joyhpc/misc-tasks/a5ed052a_min_system_pin_assign/sources/official_pinouts/a5ed052a/a5ed052A.xlsx

Sheet: IO Resource Count
Pin Information for Agilex™ 5 A5ED052A Device
TYPE | BANK | B23A Package | B32A Package
Transceiver I/O | 1A | - | 20
Transceiver I/O | 1B | 20 | 20
Transceiver I/O | 1C | 22 | 22
HSIO | 2A_B | - | 48
HSIO | 2A_T | - | 48
HSIO | 2B_B | - | 48
HSIO | 2B_T | - | 48
HPS shared HSIO | 3A_B | 48 | 48
HPS and SDM shared HSIO | 3A_T | 48 | 48
HPS shared HSIO | 3B_B | - | 48
HPS shared HSIO | 3B_T | - | 48
Transceiver I/O | 4A | - | 20
Transceiver I/O | 4B | - | 22
Transceiver I/O | 4C | 22 | 20
HVIO | 5A | 20 | 20
HVIO | 5B | 20 | 20
HVIO | 6A | 20 | 20
HVIO | 6B | 20 | 20
HVIO | 6C | 20 | 20
HVIO | 6D | 20 | 20
HPS I/O | HPS | 48 | 48
SDM I/O | SDM | 33 | 33
i. Total LVDS channels per bank supporting LVDS SERDES Non-DPA and DPA mode is equivalent to (LVDS I/O per bank)/2, inclusive of clock pair. Please refer to Dedicated Tx/Rx Channel column in the pin-out table for the channel availability.
ii. Total LVDS channels supporting LVDS SERDES Soft-CDR mode is 12 pairs per bank. Please refer to Soft CDR column in the pin out table for the channel availability.

Sheet: Pin List B23A
Pin Information for Agilex™ 5 A5ED052A Device Version: 2025-06-06 B23A Status: Final
Bank Number | Index within I/O Bank | Pin Name/Function | Optional Function(s) | Configuration Function | HPS Function | Dedicated Tx/Rx Channel SERDES | Soft CDR Support | B23A | DQS for X4 | DQS for X8/X9 | DQS for X16/X18
SDM |  | TDO |  |  |  |  |  | BN55
SDM |  | TMS |  |  |  |  |  | BJ56
SDM |  | TCK |  |  |  |  |  | BJ58
SDM |  | TDI |  |  |  |  |  | BJ53
SDM |  | OSC_CLK_1 |  |  |  |  |  | BJ48
SDM |  | SDM_IO1 | AVSTx8_DATA2,AS_DATA1 |  |  |  |  | BV29
SDM |  | SDM_IO5 | AS_nCSO0,MSEL0 |  |  |  |  | BJ30
SDM |  | SDM_IO3 | AVSTx8_DATA3,AS_DATA2 |  |  |  |  | BR36
SDM |  | nCONFIG |  |  |  |  |  | BU32
SDM |  | SDM_IO4 | AVSTx8_DATA1,AS_DATA0 |  |  |  |  | BN43
SDM |  | SDM_IO2 | AVSTx8_DATA0,AS_CLK |  |  |  |  | BV26
SDM |  | SDM_IO7 | AS_nCSO2,MSEL1 |  |  |  |  | BN31
SDM |  | SDM_IO11 | AVSTx8_VALID,PWRMGT_SDA |  |  |  |  | BN36
SDM |  | nSTATUS |  |  |  |  |  | BV32
SDM |  | SDM_IO16 | PWRMGT_SDA |  |  |  |  | BN46
SDM |  | SDM_IO0 | PWRMGT_SCL,PWRMGT_ALERT |  |  |  |  | BU34
SDM |  | SDM_IO13 | AVSTx8_DATA5 |  |  |  |  | BJ45
SDM |  | SDM_IO9 | AS_nCSO1,MSEL2,PWRMGT_ALERT |  |  |  |  | BU29
SDM |  | SDM_IO6 | AVSTx8_DATA4,AS_DATA3 |  |  |  |  | BN38
SDM |  | SDM_IO10 | AVSTx8_DATA7 |  |  |  |  | BN28
SDM |  | SDM_IO8 | AVSTx8_READY,AS_nCSO3 |  |  |  |  | BJ39
SDM |  | SDM_IO12 | PWRMGT_SDA,PWRMGT_ALERT |  |  |  |  | BJ33
SDM |  | SDM_IO15 | AVSTx8_DATA6,AS_nRST |  |  |  |  | BJ41
SDM |  | SDM_IO14 | AVSTx8_CLK,PWRMGT_SCL |  |  |  |  | BR28
SDM |  | RREF_SDM |  |  |  |  |  | BV51
SDM |  |  | TEMPDIODE0An |  |  |  |  | BR52
SDM |  |  | TEMPDIODE0Ap |  |  |  |  | BN52
SDM |  |  | VREFP_ADC |  |  |  |  | BU42
SDM |  |  | VREFN_ADC |  |  |  |  | BU44
SDM |  | VSIGP_0 |  |  |  |  |  | BU47
SDM |  | VSIGN_0 |  |  |  |  |  | BV47
SDM |  | VSIGP_1 |  |  |  |  |  | BV42
SDM |  | VSIGN_1 |  |  |  |  |  | BV40
HPS |  | HPS_IOA_1 | GPIO0_IO0,SPIM0_SS1_N,SPIS0_CLK,UART0_CTS_N,NAND_ADQ0,SDMMC_DATA0,USB0_CLK,EMAC0_PPS0,TRACE_D10 |  | HPS_IOA_1 |  |  | B80
HPS |  | HPS_IOA_2 | GPIO0_IO1,SPIM1_SS1_N,SPIS0_MOSI,UART0_RTS_N,NAND_ADQ1,SDMMC_DATA1,USB0_STP,EMAC0_PPSTRIG0,TRACE_D9 |  | HPS_IOA_2 |  |  | C80
HPS |  | HPS_IOA_3 | GPIO0_IO2,SPIS0_SS0_N,UART0_TX,I2C1_SDA,NAND_WE_N,SDMMC_CLK,USB0_DIR,EMAC1_PPS1,TRACE_D8 |  | HPS_IOA_3 |  |  | E81
HPS |  | HPS_IOA_4 | GPIO0_IO3,SPIS0_MISO,UART0_RX,I2C1_SCL,NAND_RE_N,USB0_DATA0,EMAC1_PPSTRIG1,TRACE_D7 |  | HPS_IOA_4 |  |  | V64
HPS |  | HPS_IOA_5 | GPIO0_IO4,SPIM0_CLK,UART1_CTS_N,I2C0_SDA,NAND_WP_N,SDMMC_WRITE_PROTECT,USB0_DATA1,EMAC2_PPS2,TRACE_D6 |  | HPS_IOA_5 |  |  | G81
HPS |  | HPS_IOA_6 | GPIO0_IO5,SPIM0_MOSI,UART1_RTS_N,I2C0_SCL,NAND_ADQ2,SDMMC_DATA2,USB0_NXT,EMAC2_PPSTRIG2,TRACE_D5 |  | HPS_IOA_6 |  |  | P64
HPS |  | HPS_IOA_7 | GPIO0_IO6,SPIM0_MISO,MDIO2_MDIO,UART1_TX,I2C_EMAC2_SDA,NAND_ADQ3,SDMMC_DATA3,USB0_DATA2,TRACE_D4 |  | HPS_IOA_7 |  |  | G80
HPS |  | HPS_IOA_8 | GPIO0_IO7,SPIM0_SS0_N,MDIO2_MDC,UART1_RX,I2C_EMAC2_SCL,NAND_CLE,SDMMC_CMD,USB0_DATA3,TRACE_D15 |  | HPS_IOA_8 |  |  | K74
HPS |  | HPS_IOA_9 | GPIO0_IO8,SPIM1_CLK,SPIS1_CLK,MDIO1_MDIO,I2C_EMAC1_SDA,NAND_ADQ4,SDMMC_DATA4,USB0_DATA4,I3C1_SDA,TRACE_D14 |  | HPS_IOA_9 |  |  | E80
HPS |  | HPS_IOA_10 | GPIO0_IO9,SPIM1_MOSI,SPIS1_MOSI,MDIO1_MDC,I2C_EMAC1_SCL,NAND_ADQ5,SDMMC_DATA5,USB0_DATA5,I3C1_SCL,TRACE_D13 |  | HPS_IOA_10 |  |  | F74
HPS |  | HPS_IOA_11 | GPIO0_IO10,SPIM1_MISO,SPIS1_SS0_N,MDIO0_MDIO,I2C_EMAC0_SDA,NAND_ADQ6,SDMMC_DATA6,USB0_DATA6,I3C0_SDA,TRACE_D12 |  | HPS_IOA_11 |  |  | H78
HPS |  | HPS_IOA_12 | GPIO0_IO11,SPIM1_SS0_N,SPIS1_MISO,MDIO0_MDC,I2C_EMAC0_SCL,NAND_ADQ7,SDMMC_DATA7,USB0_DATA7,I3C0_SCL,TRACE_D11 |  | HPS_IOA_12 |  |  | F78
HPS |  | HPS_IOA_13 | GPIO0_IO12,NAND_ALE,SDMMC_PU_PD_DATA2,USB1_CLK,EMAC0_TX_CLK,TRACE_D10 |  | HPS_IOA_13 |  |  | D74
HPS |  | HPS_IOA_14 | GPIO0_IO13,NAND_RB_N,SDMMC_PWR_ENA,USB1_STP,EMAC0_TX_CTL,TRACE_D9 |  | HPS_IOA_14 |  |  | B78
HPS |  | HPS_IOA_15 | GPIO0_IO14,NAND_CE_N,USB1_DIR,EMAC0_RX_CLK,TRACE_D8 |  | HPS_IOA_15 |  |  | B76
HPS |  | HPS_IOA_16 | GPIO0_IO15,NAND_DQS,SDMMC_DATA_STROBE,USB1_DATA0,EMAC0_RX_CTL,TRACE_D7 |  | HPS_IOA_16 |  |  | K70
HPS |  | HPS_IOA_17 | GPIO0_IO16,I3C1_SDA,NAND_ADQ8,USB1_DATA1,EMAC0_TXD0,TRACE_D6 |  | HPS_IOA_17 |  |  | A76
HPS |  | HPS_IOA_18 | GPIO0_IO17,I3C1_SCL,NAND_ADQ9,USB1_NXT,EMAC0_TXD1,TRACE_D5 |  | HPS_IOA_18 |  |  | H70
HPS |  | HPS_IOA_19 | GPIO0_IO18,I3C0_SDA,NAND_ADQ10,USB1_DATA2,EMAC0_RXD0,TRACE_D4 |  | HPS_IOA_19 |  |  | B73
HPS |  | HPS_IOA_20 | GPIO0_IO19,SPIM1_SS1_N,I3C0_SCL,NAND_ADQ11,USB1_DATA3,EMAC0_RXD1,TRACE_CLK |  | HPS_IOA_20 |  |  | K60
HPS |  | HPS_IOA_21 | GPIO0_IO20,SPIM1_CLK,SPIS0_CLK,UART0_CTS_N,I2C1_SDA,NAND_ADQ12,USB1_DATA4,EMAC0_TXD2,TRACE_D0 |  | HPS_IOA_21 |  |  | A73
HPS |  | HPS_IOA_22 | GPIO0_IO21,SPIM1_MOSI,SPIS0_MOSI,UART0_RTS_N,I2C1_SCL,NAND_ADQ13,USB1_DATA5,EMAC0_TXD3,TRACE_D1 |  | HPS_IOA_22 |  |  | F62
HPS |  | HPS_IOA_23 | GPIO0_IO22,SPIM1_MISO,SPIS0_SS0_N,UART0_TX,I2C0_SDA,NAND_ADQ14,USB1_DATA6,EMAC0_RXD2,TRACE_D2 |  | HPS_IOA_23 |  |  | B71
HPS |  | HPS_IOA_24 | GPIO0_IO23,SPIM1_SS0_N,SPIS0_MISO,UART0_RX,I2C0_SCL,NAND_ADQ15,USB1_DATA7,EMAC0_RXD3,TRACE_D3 |  | HPS_IOA_24 |  |  | A71
HPS |  | HPS_IOB_1 | GPIO1_IO0,SPIM1_CLK,UART0_CTS_N,EMAC0_PPS0,NAND_ADQ0,SDMMC_DATA0,I3C0_SDA_PULLUP_EN,EMAC1_TX_CLK,TRACE_D10 |  | HPS_IOB_1 |  |  | B68
HPS |  | HPS_IOB_2 | GPIO1_IO1,SPIM1_MOSI,UART0_RTS_N,EMAC0_PPSTRIG0,NAND_ADQ1,SDMMC_DATA1,I3C1_SDA_PULLUP_EN,EMAC1_TX_CTL,TRACE_D9 |  | HPS_IOB_2 |  |  | A63
HPS |  | HPS_IOB_3 | GPIO1_IO2,SPIM1_MISO,UART0_TX,I2C0_SDA,NAND_WE_N,SDMMC_CLK,EMAC1_RX_CLK,TRACE_D8 |  | HPS_IOB_3 |  |  | A51
HPS |  | HPS_IOB_4 | GPIO1_IO3,SPIM1_SS0_N,UART0_RX,I2C0_SCL,NAND_RE_N,EMAC1_RX_CTL,TRACE_D7 |  | HPS_IOB_4 |  |  | K67
HPS |  | HPS_IOB_5 | GPIO1_IO4,SPIM1_SS1_N,SPIS1_CLK,UART1_CTS_N,EMAC2_PPS2,NAND_WP_N,SDMMC_WRITE_PROTECT,I3C1_SDA,EMAC1_TXD0,TRACE_D6 |  | HPS_IOB_5 |  |  | B57
HPS |  | HPS_IOB_6 | GPIO1_IO5,SPIS1_MOSI,UART1_RTS_N,EMAC2_PPSTRIG2,NAND_ADQ2,SDMMC_DATA2,I3C1_SCL,EMAC1_TXD1,TRACE_D5 |  | HPS_IOB_6 |  |  | F70
HPS |  | HPS_IOB_7 | GPIO1_IO6,SPIS1_SS0_N,UART1_TX,I2C1_SDA,NAND_ADQ3,SDMMC_DATA3,I3C0_SDA,EMAC1_RXD0,TRACE_D4 |  | HPS_IOB_7 |  |  | B65
HPS |  | HPS_IOB_8 | GPIO1_IO7,SPIS1_MISO,UART1_RX,I2C1_SCL,NAND_CLE,SDMMC_CMD,I3C0_SCL,EMAC1_RXD1,TRACE_D15 |  | HPS_IOB_8 |  |  | K62
HPS |  | HPS_IOB_9 | GPIO1_IO8,JTAG_TCK,SPIS0_CLK,MDIO2_MDIO,I2C_EMAC2_SDA,NAND_ADQ4,SDMMC_DATA4,EMAC1_TXD2,TRACE_D14 |  | HPS_IOB_9 |  |  | A65
HPS |  | HPS_IOB_10 | GPIO1_IO9,JTAG_TMS,SPIS0_MOSI,MDIO2_MDC,I2C_EMAC2_SCL,NAND_ADQ5,SDMMC_DATA5,EMAC1_TXD3,TRACE_D13 |  | HPS_IOB_10 |  |  | H62
HPS |  | HPS_IOB_11 | GPIO1_IO10,JTAG_TDO,SPIS0_SS0_N,MDIO0_MDIO,I2C_EMAC0_SDA,NAND_ADQ6,SDMMC_DATA6,EMAC1_RXD2,TRACE_D12 |  | HPS_IOB_11 |  |  | B61
HPS |  | HPS_IOB_12 | GPIO1_IO11,JTAG_TDI,SPIS0_MISO,MDIO0_MDC,I2C_EMAC0_SCL,NAND_ADQ7,SDMMC_DATA7,EMAC1_RXD3,TRACE_D11 |  | HPS_IOB_12 |  |  | A61
HPS |  | HPS_IOB_13 | GPIO1_IO12,I2C1_SDA,NAND_ALE,SDMMC_PU_PD_DATA2,EMAC2_TX_CLK,TRACE_D10 |  | HPS_IOB_13 |  |  | B59
HPS |  | HPS_IOB_14 | GPIO1_IO13,I2C1_SCL,NAND_RB_N,SDMMC_PWR_ENA,EMAC2_TX_CTL,TRACE_D9 |  | HPS_IOB_14 |  |  | A59
HPS |  | HPS_IOB_15 | GPIO1_IO14,UART1_TX,NAND_CE_N,I3C1_SDA,EMAC2_RX_CLK,TRACE_D8 |  | HPS_IOB_15 |  |  | A54
HPS |  | HPS_IOB_16 | GPIO1_IO15,UART1_RX,NAND_DQS,SDMMC_DATA_STROBE,I3C1_SCL,EMAC2_RX_CTL,TRACE_D7 |  | HPS_IOB_16 |  |  | F60
HPS |  | HPS_IOB_17 | GPIO1_IO16,UART1_CTS_N,NAND_ADQ8,I3C0_SDA,EMAC2_TXD0,TRACE_D6 |  | HPS_IOB_17 |  |  | B54
HPS |  | HPS_IOB_18 | GPIO1_IO17,SPIM0_SS1_N,UART1_RTS_N,NAND_ADQ9,I3C0_SCL,EMAC2_TXD1,TRACE_D5 |  | HPS_IOB_18 |  |  | D60
HPS |  | HPS_IOB_19 | GPIO1_IO18,SPIM0_MISO,MDIO1_MDIO,I2C_EMAC1_SDA,NAND_ADQ10,EMAC2_RXD0,TRACE_D4 |  | HPS_IOB_19 |  |  | A49
HPS |  | HPS_IOB_20 | GPIO1_IO19,SPIM0_SS0_N,MDIO1_MDC,I2C_EMAC1_SCL,NAND_ADQ11,EMAC2_RXD1,TRACE_CLK |  | HPS_IOB_20 |  |  | F67
HPS |  | HPS_IOB_21 | GPIO1_IO20,SPIM0_CLK,SPIS1_CLK,I2C_EMAC2_SDA,NAND_ADQ12,I3C0_SDA_PULLUP_EN,EMAC2_TXD2,TRACE_D0 |  | HPS_IOB_21 |  |  | B49
HPS |  | HPS_IOB_22 | GPIO1_IO21,SPIM0_MOSI,SPIS1_MOSI,I2C_EMAC2_SCL,NAND_ADQ13,I3C1_SDA_PULLUP_EN,EMAC2_TXD3,TRACE_D1 |  | HPS_IOB_22 |  |  | D67
HPS |  | HPS_IOB_23 | GPIO1_IO22,SPIM0_MISO,SPIS1_SS0_N,MDIO0_MDIO,I2C_EMAC0_SDA,NAND_ADQ14,EMAC2_RXD2,TRACE_D2 |  | HPS_IOB_23 |  |  | A47
HPS |  | HPS_IOB_24 | GPIO1_IO23,SPIM0_SS0_N,SPIS1_MISO,MDIO0_MDC,I2C_EMAC0_SCL,NAND_ADQ15,EMAC2_RXD3,TRACE_D3 |  | HPS_IOB_24 |  |  | B47
3A_T | 95 | IO | IOB |  | HPS_DDR | DIFF_IO_3A_T1n | No | W2 | DQ32 | DQ16 | DQ8
3A_T | 94 | IO | IOB |  | HPS_DDR | DIFF_IO_3A_T1p | No | W1 | DQ32 | DQ16 | DQ8
3A_T | 93 | IO | IOB |  | HPS_DDR | DIFF_IO_3A_T2n | No | T2 | DQ32 | DQ16 | DQ8
3A_T | 92 | IO | IOB |  | HPS_DDR | DIFF_IO_3A_T2p | No | N1 | DQ32 | DQ16 | DQ8
3A_T | 91 | IO | IOB |  | HPS_DDR | DIFF_IO_3A_T3n | No | N2 | DQSn32 | DQ16 | DQ8
3A_T | 90 | IO | IOB | AVST_READY | HPS_DDR | DIFF_IO_3A_T3p | No | M1 | DQS32 | DQ16 | DQ8
3A_T | 89 | IO | IOB |  | HPS_DDR | DIFF_IO_3A_T4n | No | J1 | DQSn33 | DQSn16/CQn16 | DQ8
3A_T | 88 | IO | IOB |  | HPS_DDR | DIFF_IO_3A_T4p | No | J2 | DQS33 | DQS16/CQ16 | DQ8
3A_T | 87 | IO | IOB |  | HPS_DDR | DIFF_IO_3A_T5n | Yes | C2 | DQ33 | DQ16 | DQ8
3A_T | 86 | IO | IOB |  | HPS_DDR | DIFF_IO_3A_T5p | Yes | E2 | DQ33 | DQ16 | DQ8
3A_T | 85 | IO | IOB |  | HPS_DDR | DIFF_IO_3A_T6n | No | G1 | DQ33 | DQ16 | DQ8
3A_T | 84 | IO | IOB |  | HPS_DDR | DIFF_IO_3A_T6p | No | G2 | DQ33 | DQ16 | DQ8
3A_T | 83 | IO | IOB | AVST_DATA10 | HPS_DDR | DIFF_IO_3A_T7n | No | B4 | DQ34 | DQ17 | DQ8
3A_T | 82 | IO | IOB | AVST_DATA9 | HPS_DDR | DIFF_IO_3A_T7p | No | B8 | DQ34 | DQ17 | DQ8
3A_T | 81 | IO | IOB | AVST_DATA8 | HPS_DDR | DIFF_IO_3A_T8n | No | A16 | DQ34 | DQ17 | DQ8
3A_T | 80 | IO | IOB | AVST_VALID | HPS_DDR | DIFF_IO_3A_T8p | No | B18 | DQ34 | DQ17 | DQ8
3A_T | 79 | IO | IOB | AVST_DATA7 | HPS_DDR | DIFF_IO_3A_T9n | No | B12 | DQSn34 | DQ17 | DQ8
3A_T | 78 | IO | IOB | AVST_DATA6 | HPS_DDR | DIFF_IO_3A_T9p | No | A12 | DQS34 | DQ17 | DQ8
3A_T | 77 | IO | IOB | AVST_DATA5 | HPS_DDR | DIFF_IO_3A_T10n | No | A18 | DQSn35 | DQSn17/CQn17 | DQSn8/CQn8
3A_T | 76 | IO | IOB | AVST_DATA4 | HPS_DDR | DIFF_IO_3A_T10p | No | B20 | DQS35 | DQS17/CQ17 | DQS8/CQ8
3A_T | 75 | IO | IOB | AVST_DATA3 | HPS_DDR | DIFF_IO_3A_T11n | Yes | A25 | DQ35 | DQ17 | DQ8
3A_T | 74 | IO | IOB | AVST_DATA2 | HPS_DDR | DIFF_IO_3A_T11p | Yes | B25 | DQ35 | DQ17 | DQ8
3A_T | 73 | IO | IOB | AVST_DATA1 | HPS_DDR | DIFF_IO_3A_T12n | No | A23 | DQ35 | DQ17 | DQ8
3A_T | 72 | IO | IOB | AVST_DATA0 | HPS_DDR | DIFF_IO_3A_T12p | No | B23 | DQ35 | DQ17 | DQ8
3A_T | 71 | IO | IOB |  | HPS_DDR | DIFF_IO_3A_T13n | No | F11 | DQ36 | DQ18 | DQ9
3A_T | 70 | IO | IOB |  | HPS_DDR | DIFF_IO_3A_T13p | No | D11 | DQ36 | DQ18 | DQ9
3A_T | 69 | IO | IOB |  | HPS_DDR | DIFF_IO_3A_T14n | No | H15 | DQ36 | DQ18 | DQ9
3A_T | 68 | IO | IOB |  | HPS_DDR | DIFF_IO_3A_T14p | No | F15 | DQ36 | DQ18 | DQ9
3A_T | 67 | IO | IOB |  | HPS_DDR | DIFF_IO_3A_T15n | No | K15 | DQSn36 | DQ18 | DQ9
3A_T | 66 | IO | IOB |  | HPS_DDR | DIFF_IO_3A_T15p | No | K11 | DQS36 | DQ18 | DQ9
3A_T | 65 | IO | IOB,PLL_3A_T_CLKOUT1n |  | HPS_DDR | DIFF_IO_3A_T16n | No | D21 | DQSn37 | DQSn18/CQn18 | DQ9
3A_T | 64 | IO | IOB,PLL_3A_T_CLKOUT1p,PLL_3A_T_CLKOUT1,PLL_3A_T_FB1 |  | HPS_DDR | DIFF_IO_3A_T16p | No | F21 | DQS37 | DQS18/CQ18 | DQ9
3A_T | 63 | IO | IOB |  | HPS_DDR | DIFF_IO_3A_T17n | Yes | H24 | DQ37 | DQ18 | DQ9
3A_T | 62 | IO | IOB,RZQ_T_3A |  | HPS_DDR | DIFF_IO_3A_T17p | Yes | F24 | DQ37 | DQ18 | DQ9
3A_T | 61 | IO | IOB,CLK_T_3A_1n |  | HPS_DDR | DIFF_IO_3A_T18n | No | K24 | DQ37 | DQ18 | DQ9
3A_T | 60 | IO | IOB,CLK_T_3A_1p |  | HPS_DDR | DIFF_IO_3A_T18p | No | K21 | DQ37 | DQ18 | DQ9
3A_T | 59 | IO | IOB,CLK_T_3A_0n |  | HPS_DDR | DIFF_IO_3A_T19n | No | V22 | DQ38 | DQ19 | DQ9
3A_T | 58 | IO | IOB,CLK_T_3A_0p |  | HPS_DDR | DIFF_IO_3A_T19p | No | P22 | DQ38 | DQ19 | DQ9
3A_T | 57 | IO | IOB |  | HPS_DDR | DIFF_IO_3A_T20n | No | P25 | DQ38 | DQ19 | DQ9
3A_T | 56 | IO | IOB |  | HPS_DDR | DIFF_IO_3A_T20p | No | P27 | DQ38 | DQ19 | DQ9
3A_T | 55 | IO | IOB,PLL_3A_T_CLKOUT0n |  | HPS_DDR | DIFF_IO_3A_T21n | No | V27 | DQSn38 | DQ19 | DQ9
3A_T | 54 | IO | IOB,PLL_3A_T_CLKOUT0p,PLL_3A_T_CLKOUT0,PLL_3A_T_FB0 |  | HPS_DDR | DIFF_IO_3A_T21p | No | V30 | DQS38 | DQ19 | DQ9
3A_T | 53 | IO | IOB | AVST_CLK | HPS_DDR | DIFF_IO_3A_T22n | No | V33 | DQSn39 | DQSn19/CQn19 | DQSn9/CQn9
3A_T | 52 | IO | IOB | AVST_DATA15 | HPS_DDR | DIFF_IO_3A_T22p | No | P33 | DQS39 | DQS19/CQ19 | DQS9/CQ9
3A_T | 51 | IO | IOB | AVST_DATA14 | HPS_DDR | DIFF_IO_3A_T23n | Yes | P35 | DQ39 | DQ19 | DQ9
3A_T | 50 | IO | IOB | AVST_DATA13 | HPS_DDR | DIFF_IO_3A_T23p | Yes | V35 | DQ39 | DQ19 | DQ9
3A_T | 49 | IO | IOB | AVST_DATA12 | HPS_DDR | DIFF_IO_3A_T24n | No | P39 | DQ39 | DQ19 | DQ9
3A_T | 48 | IO | IOB | AVST_DATA11 | HPS_DDR | DIFF_IO_3A_T24p | No | V41 | DQ39 | DQ19 | DQ9
3A_B | 47 | IO | IOB |  | HPS_DDR | DIFF_IO_3A_B1n | No | D28 | DQ40 | DQ20 | DQ10
3A_B | 46 | IO | IOB |  | HPS_DDR | DIFF_IO_3A_B1p | No | F28 | DQ40 | DQ20 | DQ10
3A_B | 45 | IO | IOB |  | HPS_DDR | DIFF_IO_3A_B2n | No | F31 | DQ40 | DQ20 | DQ10
3A_B | 44 | IO | IOB |  | HPS_DDR | DIFF_IO_3A_B2p | No | H31 | DQ40 | DQ20 | DQ10
3A_B | 43 | IO | IOB |  | HPS_DDR | DIFF_IO_3A_B3n | No | K28 | DQSn40 | DQ20 | DQ10
3A_B | 42 | IO | IOB |  | HPS_DDR | DIFF_IO_3A_B3p | No | K31 | DQS40 | DQ20 | DQ10
3A_B | 41 | IO | IOB,PLL_3A_B_CLKOUT1n |  | HPS_DDR | DIFF_IO_3A_B4n | No | D36 | DQSn41 | DQSn20/CQn20 | DQ10
3A_B | 40 | IO | IOB,PLL_3A_B_CLKOUT1p,PLL_3A_B_CLKOUT1,PLL_3A_B_FB1 |  | HPS_DDR | DIFF_IO_3A_B4p | No | F36 | DQS41 | DQS20/CQ20 | DQ10
3A_B | 39 | IO | IOB |  | HPS_DDR | DIFF_IO_3A_B5n | Yes | K36 | DQ41 | DQ20 | DQ10
3A_B | 38 | IO | IOB,RZQ_B_3A |  | HPS_DDR | DIFF_IO_3A_B5p | Yes | K38 | DQ41 | DQ20 | DQ10
3A_B | 37 | IO | IOB,CLK_B_3A_1n |  | HPS_DDR | DIFF_IO_3A_B6n | Yes | H38 | DQ41 | DQ20 | DQ10
3A_B | 36 | IO | IOB,CLK_B_3A_1p |  | HPS_DDR | DIFF_IO_3A_B6p | Yes | F38 | DQ41 | DQ20 | DQ10
3A_B | 35 | IO | IOB,CLK_B_3A_0n |  | HPS_DDR | DIFF_IO_3A_B7n | No | B29 | DQ42 | DQ21 | DQ10
3A_B | 34 | IO | IOB,CLK_B_3A_0p |  | HPS_DDR | DIFF_IO_3A_B7p | No | A26 | DQ42 | DQ21 | DQ10
3A_B | 33 | IO | IOB |  | HPS_DDR | DIFF_IO_3A_B8n | No | A29 | DQ42 | DQ21 | DQ10
3A_B | 32 | IO | IOB |  | HPS_DDR | DIFF_IO_3A_B8p | No | B32 | DQ42 | DQ21 | DQ10
3A_B | 31 | IO | IOB,PLL_3A_B_CLKOUT0n |  | HPS_DDR | DIFF_IO_3A_B9n | No | A34 | DQSn42 | DQ21 | DQ10
3A_B | 30 | IO | IOB,PLL_3A_B_CLKOUT0p,PLL_3A_B_CLKOUT0,PLL_3A_B_FB0 |  | HPS_DDR | DIFF_IO_3A_B9p | No | B34 | DQS42 | DQ21 | DQ10
3A_B | 29 | IO | IOB |  | HPS_DDR | DIFF_IO_3A_B10n | No | B37 | DQSn43 | DQSn21/CQn21 | DQSn10/CQn10
3A_B | 28 | IO | IOB |  | HPS_DDR | DIFF_IO_3A_B10p | No | A37 | DQS43 | DQS21/CQ21 | DQS10/CQ10
3A_B | 27 | IO | IOB |  | HPS_DDR | DIFF_IO_3A_B11n | Yes | A42 | DQ43 | DQ21 | DQ10
3A_B | 26 | IO | IOB |  | HPS_DDR | DIFF_IO_3A_B11p | Yes | B44 | DQ43 | DQ21 | DQ10
3A_B | 25 | IO | IOB |  | HPS_DDR | DIFF_IO_3A_B12n | Yes | A40 | DQ43 | DQ21 | DQ10
3A_B | 24 | IO | IOB |  | HPS_DDR | DIFF_IO_3A_B12p | Yes | B42 | DQ43 | DQ21 | DQ10
3A_B | 23 | IO | IOB |  | HPS_DDR | DIFF_IO_3A_B13n | No | D43 | DQ44 | DQ22 | DQ11
3A_B | 22 | IO | IOB |  | HPS_DDR | DIFF_IO_3A_B13p | No | F43 | DQ44 | DQ22 | DQ11
3A_B | 21 | IO | IOB |  | HPS_DDR | DIFF_IO_3A_B14n | No | F46 | DQ44 | DQ22 | DQ11
3A_B | 20 | IO | IOB |  | HPS_DDR | DIFF_IO_3A_B14p | No | H46 | DQ44 | DQ22 | DQ11
3A_B | 19 | IO | IOB |  | HPS_DDR | DIFF_IO_3A_B15n | No | K43 | DQSn44 | DQ22 | DQ11
3A_B | 18 | IO | IOB |  | HPS_DDR | DIFF_IO_3A_B15p | No | K46 | DQS44 | DQ22 | DQ11
3A_B | 17 | IO | IOB |  | HPS_DDR | DIFF_IO_3A_B16n | No | D52 | DQSn45 | DQSn22/CQn22 | DQ11
3A_B | 16 | IO | IOB |  | HPS_DDR | DIFF_IO_3A_B16p | No | F52 | DQS45 | DQS22/CQ22 | DQ11
3A_B | 15 | IO | IOB |  | HPS_DDR | DIFF_IO_3A_B17n | Yes | K52 | DQ45 | DQ22 | DQ11
3A_B | 14 | IO | IOB |  | HPS_DDR | DIFF_IO_3A_B17p | Yes | K55 | DQ45 | DQ22 | DQ11
3A_B | 13 | IO | IOB |  | HPS_DDR | DIFF_IO_3A_B18n | Yes | F55 | DQ45 | DQ22 | DQ11
3A_B | 12 | IO | IOB |  | HPS_DDR | DIFF_IO_3A_B18p | Yes | H55 | DQ45 | DQ22 | DQ11
3A_B | 11 | IO | IOB |  | HPS_DDR | DIFF_IO_3A_B19n | No | V45 | DQ46 | DQ23 | DQ11
3A_B | 10 | IO | IOB |  | HPS_DDR | DIFF_IO_3A_B19p | No | P41 | DQ46 | DQ23 | DQ11
3A_B | 9 | IO | IOB |  | HPS_DDR | DIFF_IO_3A_B20n | No | P48 | DQ46 | DQ23 | DQ11
3A_B | 8 | IO | IOB |  | HPS_DDR | DIFF_IO_3A_B20p | No | V48 | DQ46 | DQ23 | DQ11
3A_B | 7 | IO | IOB |  | HPS_DDR | DIFF_IO_3A_B21n | No | P50 | DQSn46 | DQ23 | DQ11
3A_B | 6 | IO | IOB |  | HPS_DDR | DIFF_IO_3A_B21p | No | V50 | DQS46 | DQ23 | DQ11
3A_B | 5 | IO | IOB |  | HPS_DDR | DIFF_IO_3A_B22n | No | P53 | DQSn47 | DQSn23/CQn23 | DQSn11/CQn11
3A_B | 4 | IO | IOB |  | HPS_DDR | DIFF_IO_3A_B22p | No | P56 | DQS47 | DQS23/CQ23 | DQS11/CQ11
3A_B | 3 | IO | IOB |  | HPS_DDR | DIFF_IO_3A_B23n | Yes | V56 | DQ47 | DQ23 | DQ11
3A_B | 2 | IO | IOB |  | HPS_DDR | DIFF_IO_3A_B23p | Yes | V58 | DQ47 | DQ23 | DQ11
3A_B | 1 | IO | IOB |  | HPS_DDR | DIFF_IO_3A_B24n | Yes | P61 | DQ47 | DQ23 | DQ11
3A_B | 0 | IO | IOB |  | HPS_DDR | DIFF_IO_3A_B24p | Yes | V61 | DQ47 | DQ23 | DQ11
5A |  | IO | HVIO_5A_1,TXCLK1,Data_Ctrl1 |  |  |  |  | BG81
5A |  | IO | HVIO_5A_2,TXCLK2,Data_Ctrl2 |  |  |  |  | BD81
5A |  | IO | HVIO_5A_3,TXCLK3,Data_Ctrl3 |  |  |  |  | BG80
5A |  | IO | HVIO_5A_4,TXCLK4,Data_Ctrl4 |  |  |  |  | BF78
5A |  | IO | HVIO_5A_5,TXCLK5,Data_Ctrl5 |  |  |  |  | BK80
5A |  | IO | HVIO_5A_6,PIN_PERST_N_CVP_L1B_0,TXCLK6,Data_Ctrl6 |  |  |  |  | BK81
5A |  | IO | HVIO_5A_7,PIN_PERST_N_CVP_L1C_0,TXCLK7,Data_Ctrl7 |  |  |  |  | BH74
5A |  | IO | HVIO_5A_8,TXCLK8,Data_Ctrl8 |  |  |  |  | BF74
5A |  | IO | HVIO_5A_9,PLLREFCLK1,TXCLK9,RXCLK1,Data_Ctrl9 |  |  |  |  | BL78
5A |  | IO | HVIO_5A_10,PLLREFCLK2,TXCLK10,RXCLK2,Data_Ctrl10 |  |  |  |  | BM80
5A |  | IO | HVIO_5A_11,SOURCE_SYNC_CLK1,TXCLK11,RXCLK3,Data_Ctrl11 |  |  |  |  | BP81
5A |  | IO | HVIO_5A_12,SOURCE_SYNC_CLK2,TXCLK12,RXCLK4,Data_Ctrl12 |  |  |  |  | BP80
5A |  | IO | HVIO_5A_13,TXCLK13,Data_Ctrl13 |  |  |  |  | BR78
5A |  | IO | HVIO_5A_14,TXCLK14,Data_Ctrl14 |  |  |  |  | BN78
5A |  | IO | HVIO_5A_15,TXCLK15,Data_Ctrl15 |  |  |  |  | BU78
5A |  | IO | HVIO_5A_16,TXCLK16,Data_Ctrl16 |  |  |  |  | BU80
5A |  | IO | HVIO_5A_17,TXCLK17,Data_Ctrl17 |  |  |  |  | BR74
5A |  | IO | HVIO_5A_18,TXCLK18,Data_Ctrl18 |  |  |  |  | BN74
5A |  | IO | HVIO_5A_19,TXCLK19,Data_Ctrl19 |  |  |  |  | BJ69
5A |  | IO | HVIO_5A_20,TXCLK20,Data_Ctrl20 |  |  |  |  | BE69
5B |  | IO | HVIO_5B_1,SYSPLLREFCLK_L1A_0,TXCLK1,Data_Ctrl1 |  |  |  |  | BU57
5B |  | IO | HVIO_5B_2,SYSPLLREFCLK_L1A_1,TXCLK2,Data_Ctrl2 |  |  |  |  | BN62
5B |  | IO | HVIO_5B_3,SYSPLLREFCLK_L1B_0,TXCLK3,Data_Ctrl3 |  |  |  |  | BN60
5B |  | IO | HVIO_5B_4,SYSPLLREFCLK_L1B_1,TXCLK4,Data_Ctrl4 |  |  |  |  | BR60
5B |  | IO | HVIO_5B_5,TXCLK5,Data_Ctrl5 |  |  |  |  | BV59
5B |  | IO | HVIO_5B_6,PIN_PERST_N_CVP_L1B_1,TXCLK6,Data_Ctrl6 |  |  |  |  | BU61
5B |  | IO | HVIO_5B_7,PIN_PERST_N_CVP_L1C_1,TXCLK7,Data_Ctrl7 |  |  |  |  | BU59
5B |  | IO | HVIO_5B_8,TXCLK8,Data_Ctrl8 |  |  |  |  | BV61
5B |  | IO | HVIO_5B_9,PLLREFCLK1,TXCLK9,RXCLK1,Data_Ctrl9 |  |  |  |  | BV63
5B |  | IO | HVIO_5B_10,PLLREFCLK2,TXCLK10,RXCLK2,Data_Ctrl10 |  |  |  |  | BU65
5B |  | IO | HVIO_5B_11,SOURCE_SYNC_CLK1,TXCLK11,RXCLK3,Data_Ctrl11 |  |  |  |  | BN67
5B |  | IO | HVIO_5B_12,SOURCE_SYNC_CLK2,TXCLK12,RXCLK4,Data_Ctrl12 |  |  |  |  | BR67
5B |  | IO | HVIO_5B_13,TXCLK13,Data_Ctrl13 |  |  |  |  | BU68
5B |  | IO | HVIO_5B_14,TXCLK14,Data_Ctrl14 |  |  |  |  | BV65
5B |  | IO | HVIO_5B_15,TXCLK15,Data_Ctrl15 |  |  |  |  | BN70
5B |  | IO | HVIO_5B_16,TXCLK16,Data_Ctrl16 |  |  |  |  | BU71
5B |  | IO | HVIO_5B_17,TXCLK17,Data_Ctrl17 |  |  |  |  | BV71
5B |  | IO | HVIO_5B_18,TXCLK18,Data_Ctrl18 |  |  |  |  | BV73
5B |  | IO | HVIO_5B_19,SYSPLLREFCLK_L1C_0,TXCLK19,Data_Ctrl19 |  |  |  |  | BV76
5B |  | IO | HVIO_5B_20,TXCLK20,Data_Ctrl20 |  |  |  |  | BU73
6A |  | IO | HVIO_6A_1,SYSPLLREFCLK_R4A_0,TXCLK1,Data_Ctrl1 |  |  |  |  | BN24
6A |  | IO | HVIO_6A_2,SYSPLLREFCLK_R4A_1,TXCLK2,Data_Ctrl2 |  |  |  |  | BN21
6A |  | IO | HVIO_6A_3,SYSPLLREFCLK_R4B_0,TXCLK3,Data_Ctrl3 |  |  |  |  | BU25
6A |  | IO | HVIO_6A_4,SYSPLLREFCLK_R4B_1,TXCLK4,Data_Ctrl4 |  |  |  |  | BV25
6A |  | IO | HVIO_6A_5,TXCLK5,Data_Ctrl5 |  |  |  |  | BJ19
6A |  | IO | HVIO_6A_6,TXCLK6,Data_Ctrl6 |  |  |  |  | BN15
6A |  | IO | HVIO_6A_7,PIN_PERST_N_R4C_0,TXCLK7,Data_Ctrl7 |  |  |  |  | BR21
6A |  | IO | HVIO_6A_8,TXCLK8,Data_Ctrl8 |  |  |  |  | BL15
6A |  | IO | HVIO_6A_9,PLLREFCLK1,TXCLK9,RXCLK1,Data_Ctrl9 |  |  |  |  | BH15
6A |  | IO | HVIO_6A_10,PLLREFCLK2,TXCLK10,RXCLK2,Data_Ctrl10 |  |  |  |  | BF11
6A |  | IO | HVIO_6A_11,SOURCE_SYNC_CLK1,TXCLK11,RXCLK3,Data_Ctrl11 |  |  |  |  | BF15
6A |  | IO | HVIO_6A_12,SOURCE_SYNC_CLK2,TXCLK12,RXCLK4,Data_Ctrl12 |  |  |  |  | BH11
6A |  | IO | HVIO_6A_13,TXCLK13,Data_Ctrl13 |  |  |  |  | BN4
6A |  | IO | HVIO_6A_14,TXCLK14,Data_Ctrl14 |  |  |  |  | BN11
6A |  | IO | HVIO_6A_15,TXCLK15,Data_Ctrl15 |  |  |  |  | BR11
6A |  | IO | HVIO_6A_16,TXCLK16,Data_Ctrl16 |  |  |  |  | BL4
6A |  | IO | HVIO_6A_17,TXCLK17,Data_Ctrl17 |  |  |  |  | BH4
6A |  | IO | HVIO_6A_18,TXCLK18,Data_Ctrl18 |  |  |  |  | BF4
6A |  | IO | HVIO_6A_19,SYSPLLREFCLK_R4C_0,TXCLK19,Data_Ctrl19 |  |  |  |  | BC9
6A |  | IO | HVIO_6A_20,TXCLK20,Data_Ctrl20 |  |  |  |  | BC13
6B |  | IO | HVIO_6B_1,TXCLK1,Data_Ctrl1 |  |  |  |  | BK1
6B |  | IO | HVIO_6B_2,TXCLK2,Data_Ctrl2 |  |  |  |  | BG1
6B |  | IO | HVIO_6B_3,TXCLK3,Data_Ctrl3 |  |  |  |  | BK2
6B |  | IO | HVIO_6B_4,TXCLK4,Data_Ctrl4 |  |  |  |  | BM1
6B |  | IO | HVIO_6B_5,TXCLK5,Data_Ctrl5 |  |  |  |  | BP1
6B |  | IO | HVIO_6B_6,TXCLK6,Data_Ctrl6 |  |  |  |  | BM2
6B |  | IO | HVIO_6B_7,PIN_PERST_N_R4C_1,TXCLK7,Data_Ctrl7 |  |  |  |  | BT2
6B |  | IO | HVIO_6B_8,TXCLK8,Data_Ctrl8 |  |  |  |  | BP2
6B |  | IO | HVIO_6B_9,PLLREFCLK1,TXCLK9,RXCLK1,Data_Ctrl9 |  |  |  |  | BU4
6B |  | IO | HVIO_6B_10,PLLREFCLK2,TXCLK10,RXCLK2,Data_Ctrl10 |  |  |  |  | BU2
6B |  | IO | HVIO_6B_11,SOURCE_SYNC_CLK1,TXCLK11,RXCLK3,Data_Ctrl11 |  |  |  |  | BU8
6B |  | IO | HVIO_6B_12,SOURCE_SYNC_CLK2,TXCLK12,RXCLK4,Data_Ctrl12 |  |  |  |  | BV8
6B |  | IO | HVIO_6B_13,TXCLK13,Data_Ctrl13 |  |  |  |  | BV12
6B |  | IO | HVIO_6B_14,TXCLK14,Data_Ctrl14 |  |  |  |  | BU12
6B |  | IO | HVIO_6B_15,TXCLK15,Data_Ctrl15 |  |  |  |  | BV18
6B |  | IO | HVIO_6B_16,TXCLK16,Data_Ctrl16 |  |  |  |  | BV16
6B |  | IO | HVIO_6B_17,TXCLK17,Data_Ctrl17 |  |  |  |  | BV20
6B |  | IO | HVIO_6B_18,TXCLK18,Data_Ctrl18 |  |  |  |  | BU18
6B |  | IO | HVIO_6B_19,TXCLK19,Data_Ctrl19 |  |  |  |  | BU23
6B |  | IO | HVIO_6B_20,TXCLK20,Data_Ctrl20 |  |  |  |  | BU20
6C |  | IO | HVIO_6C_1,TXCLK1,Data_Ctrl1 |  |  |  |  | P19
6C |  | IO | HVIO_6C_2,TXCLK2,Data_Ctrl2 |  |  |  |  | Y22
6C |  | IO | HVIO_6C_3,TXCLK3,Data_Ctrl3 |  |  |  |  | V19
6C |  | IO | HVIO_6C_4,TXCLK4,Data_Ctrl4 |  |  |  |  | AC22
6C |  | IO | HVIO_6C_5,TXCLK5,Data_Ctrl5 |  |  |  |  | AB14
6C |  | IO | HVIO_6C_6,TXCLK6,Data_Ctrl6 |  |  |  |  | AF22
6C |  | IO | HVIO_6C_7,TXCLK7,Data_Ctrl7 |  |  |  |  | AF19
6C |  | IO | HVIO_6C_8,TXCLK8,Data_Ctrl8 |  |  |  |  | AC19
6C |  | IO | HVIO_6C_9,PLLREFCLK1,TXCLK9,RXCLK1,Data_Ctrl9 |  |  |  |  | AE14
6C |  | IO | HVIO_6C_10,PLLREFCLK2,TXCLK10,RXCLK2,Data_Ctrl10 |  |  |  |  | AB7
6C |  | IO | HVIO_6C_11,SOURCE_SYNC_CLK1,TXCLK11,RXCLK3,Data_Ctrl11 |  |  |  |  | AE5
6C |  | IO | HVIO_6C_12,SOURCE_SYNC_CLK2,TXCLK12,RXCLK4,Data_Ctrl12 |  |  |  |  | AE7
6C |  | IO | HVIO_6C_13,TXCLK13,Data_Ctrl13 |  |  |  |  | AK14
6C |  | IO | HVIO_6C_14,TXCLK14,Data_Ctrl14 |  |  |  |  | AB10
6C |  | IO | HVIO_6C_15,TXCLK15,Data_Ctrl15 |  |  |  |  | AK7
6C |  | IO | HVIO_6C_16,TXCLK16,Data_Ctrl16 |  |  |  |  | AM22
6C |  | IO | HVIO_6C_17,TXCLK17,Data_Ctrl17 |  |  |  |  | AJ22
6C |  | IO | HVIO_6C_18,TXCLK18,Data_Ctrl18 |  |  |  |  | AK10
6C |  | IO | HVIO_6C_19,TXCLK19,Data_Ctrl19 |  |  |  |  | AP19
6C |  | IO | HVIO_6C_20,TXCLK20,Data_Ctrl20 |  |  |  |  | AM19
6D |  | IO | HVIO_6D_1,TXCLK1,Data_Ctrl1 |  |  |  |  | AN1
6D |  | IO | HVIO_6D_2,TXCLK2,Data_Ctrl2 |  |  |  |  | AN2
6D |  | IO | HVIO_6D_3,TXCLK3,Data_Ctrl3 |  |  |  |  | AG1
6D |  | IO | HVIO_6D_4,TXCLK4,Data_Ctrl4 |  |  |  |  | AG2
6D |  | IO | HVIO_6D_5,TXCLK5,Data_Ctrl5 |  |  |  |  | AL1
6D |  | IO | HVIO_6D_6,TXCLK6,Data_Ctrl6 |  |  |  |  | AL2
6D |  | IO | HVIO_6D_7,TXCLK7,Data_Ctrl7 |  |  |  |  | AD2
6D |  | IO | HVIO_6D_8,TXCLK8,Data_Ctrl8 |  |  |  |  | AH2
6D |  | IO | HVIO_6D_9,PLLREFCLK1,TXCLK9,RXCLK1,Data_Ctrl9 |  |  |  |  | AA1
6D |  | IO | HVIO_6D_10,PLLREFCLK2,TXCLK10,RXCLK2,Data_Ctrl10 |  |  |  |  | AD1
6D |  | IO | HVIO_6D_11,SOURCE_SYNC_CLK1,TXCLK11,RXCLK3,Data_Ctrl11 |  |  |  |  | AA2
6D |  | IO | HVIO_6D_12,SOURCE_SYNC_CLK2,TXCLK12,RXCLK4,Data_Ctrl12 |  |  |  |  | D4
6D |  | IO | HVIO_6D_13,TXCLK13,Data_Ctrl13 |  |  |  |  | U7
6D |  | IO | HVIO_6D_14,TXCLK14,Data_Ctrl14 |  |  |  |  | U5
6D |  | IO | HVIO_6D_15,TXCLK15,Data_Ctrl15 |  |  |  |  | R7
6D |  | IO | HVIO_6D_16,TXCLK16,Data_Ctrl16 |  |  |  |  | F4
6D |  | IO | HVIO_6D_17,TXCLK17,Data_Ctrl17 |  |  |  |  | R10
6D |  | IO | HVIO_6D_18,TXCLK18,Data_Ctrl18 |  |  |  |  | K4
6D |  | IO | HVIO_6D_19,TXCLK19,Data_Ctrl19 |  |  |  |  | R14
6D |  | IO | HVIO_6D_20,TXCLK20,Data_Ctrl20 |  |  |  |  | U14
1B |  | GTSL1B_RX_CH0p |  |  |  |  |  | BA81
1B |  | GTSL1B_RX_CH0n |  |  |  |  |  | BA79
1B |  | GTSL1B_RX_CH1p |  |  |  |  |  | AW81
1B |  | GTSL1B_RX_CH1n |  |  |  |  |  | AW79
1B |  | GTSL1B_RX_CH2p |  |  |  |  |  | AU81
1B |  | GTSL1B_RX_CH2n |  |  |  |  |  | AU79
1B |  | GTSL1B_RX_CH3p |  |  |  |  |  | AR81
1B |  | GTSL1B_RX_CH3n |  |  |  |  |  | AR79
1B |  | GTSL1B_TX_CH0p |  |  |  |  |  | BB75
1B |  | GTSL1B_TX_CH0n |  |  |  |  |  | BB72
1B |  | GTSL1B_TX_CH1p |  |  |  |  |  | AY75
1B |  | GTSL1B_TX_CH1n |  |  |  |  |  | AY72
1B |  | GTSL1B_TX_CH2p |  |  |  |  |  | AV75
1B |  | GTSL1B_TX_CH2n |  |  |  |  |  | AV72
1B |  | GTSL1B_TX_CH3p |  |  |  |  |  | AT75
1B |  | GTSL1B_TX_CH3n |  |  |  |  |  | AT72
1B |  | REFCLK_GTSL1B_CH1p |  |  |  |  |  | AW69
1B |  | REFCLK_GTSL1B_CH1n |  |  |  |  |  | AW66
1B |  | REFCLK_GTSL1B_RX_P |  |  |  |  |  | BA66
1B |  | REFCLK_GTSL1B_RX_N |  |  |  |  |  | BA69
1C |  | GTSL1C_RX_CH0p |  |  |  |  |  | AM81
1C |  | GTSL1C_RX_CH0n |  |  |  |  |  | AM79
1C |  | GTSL1C_RX_CH1p |  |  |  |  |  | AF81
1C |  | GTSL1C_RX_CH1n |  |  |  |  |  | AF79
1C |  | GTSL1C_RX_CH2p |  |  |  |  |  | Y81
1C |  | GTSL1C_RX_CH2n |  |  |  |  |  | Y79
1C |  | GTSL1C_RX_CH3p |  |  |  |  |  | P81
1C |  | GTSL1C_RX_CH3n |  |  |  |  |  | P79
1C |  | GTSL1C_TX_CH0p |  |  |  |  |  | AP75
1C |  | GTSL1C_TX_CH0n |  |  |  |  |  | AP72
1C |  | GTSL1C_TX_CH1p |  |  |  |  |  | AJ75
1C |  | GTSL1C_TX_CH1n |  |  |  |  |  | AJ72
1C |  | GTSL1C_TX_CH2p |  |  |  |  |  | AC75
1C |  | GTSL1C_TX_CH2n |  |  |  |  |  | AC72
1C |  | GTSL1C_TX_CH3p |  |  |  |  |  | V75
1C |  | GTSL1C_TX_CH3n |  |  |  |  |  | V72
1C |  | REFCLK_GTSL1C_CH1p |  |  |  |  |  | AR69
1C |  | REFCLK_GTSL1C_CH1n |  |  |  |  |  | AR66
1C |  | CDRCLKOUT_GTSL1C_CH2p |  |  |  |  |  | AM66
1C |  | CDRCLKOUT_GTSL1C_CH2n |  |  |  |  |  | AM69
1C |  | REFCLK_GTSL1C_RX_P |  |  |  |  |  | AU69
1C |  | REFCLK_GTSL1C_RX_N |  |  |  |  |  | AU66
4C |  | GTSR4C_RX_CH0p |  |  |  |  |  | BB1
4C |  | GTSR4C_RX_CH0n |  |  |  |  |  | BB3
4C |  | GTSR4C_RX_CH1p |  |  |  |  |  | AY1
4C |  | GTSR4C_RX_CH1n |  |  |  |  |  | AY3
4C |  | GTSR4C_RX_CH2p |  |  |  |  |  | AV1
4C |  | GTSR4C_RX_CH2n |  |  |  |  |  | AV3
4C |  | GTSR4C_RX_CH3p |  |  |  |  |  | AT1
4C |  | GTSR4C_RX_CH3n |  |  |  |  |  | AT3
4C |  | GTSR4C_TX_CH0p |  |  |  |  |  | BA9
4C |  | GTSR4C_TX_CH0n |  |  |  |  |  | BA13
4C |  | GTSR4C_TX_CH1p |  |  |  |  |  | AW9
4C |  | GTSR4C_TX_CH1n |  |  |  |  |  | AW13
4C |  | GTSR4C_TX_CH2p |  |  |  |  |  | AU9
4C |  | GTSR4C_TX_CH2n |  |  |  |  |  | AU13
4C |  | GTSR4C_TX_CH3p |  |  |  |  |  | AR9
4C |  | GTSR4C_TX_CH3n |  |  |  |  |  | AR13
4C |  | REFCLK_GTSR4C_CH1p |  |  |  |  |  | AV19
4C |  | REFCLK_GTSR4C_CH1n |  |  |  |  |  | AV17
4C |  | CDRCLKOUT_GTSR4C_CH2p |  |  |  |  |  | AT19
4C |  | CDRCLKOUT_GTSR4C_CH2n |  |  |  |  |  | AT17
4C |  | REFCLK_GTSR4C_RX_P |  |  |  |  |  | AY17
4C |  | REFCLK_GTSR4C_RX_N |  |  |  |  |  | AY19
 |  | GND |  |  |  |  |  | BV54
 |  | GND |  |  |  |  |  | BV49
 |  | GND |  |  |  |  |  | BU49
 |  | GND |  |  |  |  |  | BC33
 |  | GND |  |  |  |  |  | BE33
 |  | GND |  |  |  |  |  | AJ39
 |  | GND |  |  |  |  |  | Y77
 |  | GND |  |  |  |  |  | Y75
 |  | GND |  |  |  |  |  | Y72
 |  | GND |  |  |  |  |  | Y69
 |  | GND |  |  |  |  |  | Y66
 |  | GND |  |  |  |  |  | Y64
 |  | GND |  |  |  |  |  | Y61
 |  | GND |  |  |  |  |  | Y58
 |  | GND |  |  |  |  |  | Y53
 |  | GND |  |  |  |  |  | Y45
 |  | GND |  |  |  |  |  | Y33
 |  | GND |  |  |  |  |  | Y27
 |  | GND |  |  |  |  |  | Y19
 |  | GND |  |  |  |  |  | V81
 |  | GND |  |  |  |  |  | V79
 |  | GND |  |  |  |  |  | V77
 |  | GND |  |  |  |  |  | V69
 |  | GND |  |  |  |  |  | V53
 |  | GND |  |  |  |  |  | V39
 |  | GND |  |  |  |  |  | V25
 |  | GND |  |  |  |  |  | U10
 |  | GND |  |  |  |  |  | T1
 |  | GND |  |  |  |  |  | R5
 |  | GND |  |  |  |  |  | P77
 |  | GND |  |  |  |  |  | P75
 |  | GND |  |  |  |  |  | P72
 |  | GND |  |  |  |  |  | P69
 |  | GND |  |  |  |  |  | P58
 |  | GND |  |  |  |  |  | P45
 |  | GND |  |  |  |  |  | P30
 |  | GND |  |  |  |  |  | M2
 |  | GND |  |  |  |  |  | L81
 |  | GND |  |  |  |  |  | L79
 |  | GND |  |  |  |  |  | L77
 |  | GND |  |  |  |  |  | H74
 |  | GND |  |  |  |  |  | H67
 |  | GND |  |  |  |  |  | H60
 |  | GND |  |  |  |  |  | H52
 |  | GND |  |  |  |  |  | H43
 |  | GND |  |  |  |  |  | H4
 |  | GND |  |  |  |  |  | H36
 |  | GND |  |  |  |  |  | H28
 |  | GND |  |  |  |  |  | H21
 |  | GND |  |  |  |  |  | H11
 |  | GND |  |  |  |  |  | E1
 |  | GND |  |  |  |  |  | D78
 |  | GND |  |  |  |  |  | D70
 |  | GND |  |  |  |  |  | D62
 |  | GND |  |  |  |  |  | D55
 |  | GND |  |  |  |  |  | D46
 |  | GND |  |  |  |  |  | D38
 |  | GND |  |  |  |  |  | D31
 |  | GND |  |  |  |  |  | D24
 |  | GND |  |  |  |  |  | D15
 |  | GND |  |  |  |  |  | C81
 |  | GND |  |  |  |  |  | C1
 |  | GND |  |  |  |  |  | BV80
 |  | GND |  |  |  |  |  | BV78
 |  | GND |  |  |  |  |  | BV68
 |  | GND |  |  |  |  |  | BV57
 |  | GND |  |  |  |  |  | BV44
 |  | GND |  |  |  |  |  | BV4
 |  | GND |  |  |  |  |  | BV34
 |  | GND |  |  |  |  |  | BV23
 |  | GND |  |  |  |  |  | BV2
 |  | GND |  |  |  |  |  | BU81
 |  | GND |  |  |  |  |  | BU76
 |  | GND |  |  |  |  |  | BU63
 |  | GND |  |  |  |  |  | BU51
 |  | GND |  |  |  |  |  | BU40
 |  | GND |  |  |  |  |  | BU26
 |  | GND |  |  |  |  |  | BU16
 |  | GND |  |  |  |  |  | BU1
 |  | GND |  |  |  |  |  | BT81
 |  | GND |  |  |  |  |  | BT80
 |  | GND |  |  |  |  |  | BT1
 |  | GND |  |  |  |  |  | BR70
 |  | GND |  |  |  |  |  | BR62
 |  | GND |  |  |  |  |  | BR55
 |  | GND |  |  |  |  |  | BR46
 |  | GND |  |  |  |  |  | BR4
 |  | GND |  |  |  |  |  | BR38
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
 |  | VCC |  |  |  |  |  | AW45
 |  | VCC |  |  |  |  |  | AW39
 |  | VCC |  |  |  |  |  | AW35
 |  | VCC |  |  |  |  |  | AW30
 |  | VCC |  |  |  |  |  | AV50
 |  | VCC |  |  |  |  |  | AV48
 |  | VCC |  |  |  |  |  | AV41
 |  | VCC |  |  |  |  |  | AV39
 |  | VCC |  |  |  |  |  | AV33
 |  | VCC |  |  |  |  |  | AV30
 |  | VCC |  |  |  |  |  | AU53
 |  | VCC |  |  |  |  |  | AU50
 |  | VCC |  |  |  |  |  | AU45
 |  | VCC |  |  |  |  |  | AU41
 |  | VCC |  |  |  |  |  | AU35
 |  | VCC |  |  |  |  |  | AU33
 |  | VCC |  |  |  |  |  | AT53
 |  | VCC |  |  |  |  |  | AT48
 |  | VCC |  |  |  |  |  | AT39
 |  | VCC |  |  |  |  |  | AT35
 |  | VCC |  |  |  |  |  | AR50
 |  | VCC |  |  |  |  |  | AR48
 |  | VCC |  |  |  |  |  | AR41
 |  | VCC |  |  |  |  |  | AR39
 |  | VCC |  |  |  |  |  | AR33
 |  | VCC |  |  |  |  |  | AP53
 |  | VCC |  |  |  |  |  | AP50
 |  | VCC |  |  |  |  |  | AP45
 |  | VCC |  |  |  |  |  | AP41
 |  | VCC |  |  |  |  |  | AP35
 |  | VCC |  |  |  |  |  | AP33
 |  | VCC |  |  |  |  |  | AM48
 |  | VCC |  |  |  |  |  | AM45
 |  | VCCPT |  |  |  |  |  | BA50
 |  | VCCPT |  |  |  |  |  | BA48
 |  | VCCPT |  |  |  |  |  | BA41
 |  | VCCPT |  |  |  |  |  | AM35
 |  | VCCPT |  |  |  |  |  | AJ33
 |  | VCCPT_HVIO |  |  |  |  |  | BC61
 |  | VCCPT_HVIO |  |  |  |  |  | BC58
 |  | VCCPT_HVIO |  |  |  |  |  | BC30
 |  | VCCPT_HVIO |  |  |  |  |  | BB30
 |  | VCCPT_HVIO |  |  |  |  |  | AJ25
 |  | VCCPT_HVIO |  |  |  |  |  | AF27
 |  | DNU |  |  |  |  |  | BR43
 |  | DNU |  |  |  |  |  | BU54
 |  | DNU |  |  |  |  |  | BU37
 |  | DNU |  |  |  |  |  | BV37
 |  | DNU |  |  |  |  |  | P66
 |  | DNU |  |  |  |  |  | V66
 |  | DNU |  |  |  |  |  | BB35
 |  | DNU |  |  |  |  |  | BA39
 |  | DNU |  |  |  |  |  | AC39
 |  | DNU |  |  |  |  |  | AM39
 |  | DNU |  |  |  |  |  | BE64
 |  | DNU |  |  |  |  |  | BJ22
 |  | DNU |  |  |  |  |  | AM27
 |  | DNU |  |  |  |  |  | AC61
 |  | DNU |  |  |  |  |  | AU25
 |  | DNU |  |  |  |  |  | BE66
 |  | DNU |  |  |  |  |  | BE19
 |  | DNU |  |  |  |  |  | AP25
 |  | DNU |  |  |  |  |  | BC66
 |  | DNU |  |  |  |  |  | BE22
 |  | DNU |  |  |  |  |  | AP27
 |  | VCCBAT |  |  |  |  |  | BE48
 |  | VCCIO_HPS |  |  |  |  |  | AJ50
 |  | VCCIO_HPS |  |  |  |  |  | AF50
 |  | VCCIO_HVIO_5A |  |  |  |  |  | BJ64
 |  | VCCIO_HVIO_5A |  |  |  |  |  | BJ61
 |  | VCCIO_HVIO_5B |  |  |  |  |  | BE58
 |  | VCCIO_HVIO_5B |  |  |  |  |  | BE56
 |  | VCCIO_HVIO_6A |  |  |  |  |  | BJ27
 |  | VCCIO_HVIO_6A |  |  |  |  |  | BE30
 |  | VCCIO_HVIO_6B |  |  |  |  |  | BE27
 |  | VCCIO_HVIO_6B |  |  |  |  |  | BE25
 |  | VCCIO_HVIO_6C |  |  |  |  |  | Y30
 |  | VCCIO_HVIO_6C |  |  |  |  |  | AC27
 |  | VCCIO_HVIO_6D |  |  |  |  |  | Y25
 |  | VCCIO_HVIO_6D |  |  |  |  |  | AC25
 |  | VCCIO_PIO_3A_B |  |  |  |  |  | Y41
 |  | VCCIO_PIO_3A_B |  |  |  |  |  | Y39
 |  | VCCIO_PIO_3A_T |  |  |  |  |  | Y35
 |  | VCCIO_PIO_3A_T |  |  |  |  |  | AC33
 |  | VCCIO_PIO_SDM |  |  |  |  |  | BB39
 |  | VCCIO_SDM |  |  |  |  |  | BE39
 |  | NC |  |  |  |  |  | AP22
 |  | NC |  |  |  |  |  | AM30
 |  | NC |  |  |  |  |  | AT30
 |  | NC |  |  |  |  |  | AJ30
 |  | NC |  |  |  |  |  | AR30
 |  | VCCRCORE |  |  |  |  |  | AV56
 |  | VCCRCORE |  |  |  |  |  | AT56
 |  | VCCRCORE |  |  |  |  |  | AR56
 |  | VCCADC |  |  |  |  |  | BC53
 |  | VCCEHT_GTSL1B |  |  |  |  |  | AT64
 |  | VCCEHT_GTSL1B |  |  |  |  |  | AR61
 |  | VCCEHT_GTSL1C |  |  |  |  |  | AJ64
 |  | VCCEHT_GTSL1C |  |  |  |  |  | AF61
 |  | VCCEHT_GTSR4C |  |  |  |  |  | AT25
 |  | VCCEHT_GTSR4C |  |  |  |  |  | AT22
 |  | VCCERT_GTSL1B |  |  |  |  |  | AV64
 |  | VCCERT_GTSL1B |  |  |  |  |  | AV61
 |  | VCCERT_GTSL1B |  |  |  |  |  | AU61
 |  | VCCERT_GTSL1C |  |  |  |  |  | AP64
 |  | VCCERT_GTSL1C |  |  |  |  |  | AP61
 |  | VCCERT_GTSL1C |  |  |  |  |  | AM64
 |  | VCCERT_GTSR4C |  |  |  |  |  | AW22
 |  | VCCERT_GTSR4C |  |  |  |  |  | AV22
 |  | VCCERT_GTSR4C |  |  |  |  |  | AU22
 |  | VCCFUSEWR_SDM |  |  |  |  |  | BE50
 |  | VCCH_SDM |  |  |  |  |  | BC56
 |  | VCCLSENSE |  |  |  |  |  | AT45
 |  | VCCL_ADC_SDM |  |  |  |  |  | BC35
 |  | VCCL_HPS |  |  |  |  |  | AJ56
 |  | VCCL_HPS |  |  |  |  |  | AJ53
 |  | VCCL_HPS |  |  |  |  |  | AF53
 |  | VCCL_HPS |  |  |  |  |  | AC53
 |  | VCCL_HPS_CORE0_CORE1 |  |  |  |  |  | AC48
 |  | VCCL_HPS_CORE0_CORE1 |  |  |  |  |  | AC45
 |  | VCCL_HPS_CORE2 |  |  |  |  |  | Y56
 |  | VCCL_HPS_CORE2 |  |  |  |  |  | AC56
 |  | VCCL_HPS_CORE3 |  |  |  |  |  | Y50
 |  | VCCL_HPS_CORE3 |  |  |  |  |  | Y48
 |  | VCCL_SDM |  |  |  |  |  | BC45
 |  | VCCL_SDM |  |  |  |  |  | BC41
 |  | VCCL_SDM |  |  |  |  |  | BB48
 |  | VCCL_SDM |  |  |  |  |  | BB45
 |  | VCCP |  |  |  |  |  | BA33
 |  | VCCP |  |  |  |  |  | BA30
 |  | VCCP |  |  |  |  |  | AF41
 |  | VCCP |  |  |  |  |  | AF35
 |  | VCCP |  |  |  |  |  | AF33
 |  | VCCP |  |  |  |  |  | AC30
 |  | VCCPLL1_HPS |  |  |  |  |  | AJ41
 |  | VCCPLL2_HPS |  |  |  |  |  | AF45
 |  | VCCPLLDIG1_HPS |  |  |  |  |  | AM56
 |  | VCCPLLDIG2_HPS |  |  |  |  |  | AJ48
 |  | VCCPLLDIG_SDM |  |  |  |  |  | BC50
 |  | VCCPLL_SDM |  |  |  |  |  | BB53
 |  | VCC_HSSI_L1 |  |  |  |  |  | AW58
 |  | VCC_HSSI_L1 |  |  |  |  |  | AV58
 |  | VCC_HSSI_L1 |  |  |  |  |  | AU58
 |  | VCC_HSSI_L1 |  |  |  |  |  | AT58
 |  | VCC_HSSI_L1 |  |  |  |  |  | AP58
 |  | VCC_HSSI_L1 |  |  |  |  |  | AM58
 |  | VCC_HSSI_L1 |  |  |  |  |  | AJ58
 |  | VCC_HSSI_L1 |  |  |  |  |  | AF58
 |  | VCC_HSSI_R4 |  |  |  |  |  | AW27
 |  | VCC_HSSI_R4 |  |  |  |  |  | AV27
 |  | VCC_HSSI_R4 |  |  |  |  |  | AU27
 |  | VCC_HSSI_R4 |  |  |  |  |  | AT27
 |  | VCC_IO_SDM |  |  |  |  |  | BE41
 |  | APROBE2_GTSL1C |  |  |  |  |  | AC66
 |  | APROBE2_GTSR4C |  |  |  |  |  | BB22
 |  | APROBE_GTSL1B_CH3 |  |  |  |  |  | AM61
 |  | APROBE_GTSL1C_CH2 |  |  |  |  |  | AF66
 |  | APROBE_GTSL1C_CH3 |  |  |  |  |  | AC64
 |  | APROBE_GTSR4C_CH2 |  |  |  |  |  | BB19
 |  | APROBE_GTSR4C_CH3 |  |  |  |  |  | AY25
 |  | RCOMP_GTSL1C_N |  |  |  |  |  | BA61
 |  | RCOMP_GTSL1C_P |  |  |  |  |  | BA58
 |  | RCOMP_GTSR4C_N |  |  |  |  |  | BB25
 |  | RCOMP_GTSR4C_P |  |  |  |  |  | BA25

Sheet: Pin List B32A
Pin Information for Agilex™ 5 A5ED052A Device Version: 2025-06-06 B32A Status: Final
Bank Number | Index within I/O Bank | Pin Name/Function | Optional Function(s) | Configuration Function | HPS Function | Dedicated Tx/Rx Channel SERDES | Soft CDR Support | B32A | DQS for X4 | DQS for X8/X9 | DQS for X16/X18
SDM |  | TDO |  |  |  |  |  | BW109
SDM |  | TMS |  |  |  |  |  | CA112
SDM |  | TCK |  |  |  |  |  | CA109
SDM |  | TDI |  |  |  |  |  | BW112
SDM |  | OSC_CLK_1 |  |  |  |  |  | BR102
SDM |  | SDM_IO1 | AVSTx8_DATA2,AS_DATA1 |  |  |  |  | BK102
SDM |  | SDM_IO5 | AS_nCSO0,MSEL0 |  |  |  |  | CF112
SDM |  | SDM_IO3 | AVSTx8_DATA3,AS_DATA2 |  |  |  |  | CH99
SDM |  | nCONFIG |  |  |  |  |  | BU99
SDM |  | SDM_IO4 | AVSTx8_DATA1,AS_DATA0 |  |  |  |  | BH99
SDM |  | SDM_IO2 | AVSTx8_DATA0,AS_CLK |  |  |  |  | BK99
SDM |  | SDM_IO7 | AS_nCSO2,MSEL1 |  |  |  |  | BM99
SDM |  | SDM_IO11 | AVSTx8_VALID,PWRMGT_SDA |  |  |  |  | CF99
SDM |  | nSTATUS |  |  |  |  |  | BW99
SDM |  | SDM_IO16 | PWRMGT_SDA |  |  |  |  | BP102
SDM |  | SDM_IO0 | PWRMGT_SCL,PWRMGT_ALERT |  |  |  |  | CA99
SDM |  | SDM_IO13 | AVSTx8_DATA5 |  |  |  |  | BW102
SDM |  | SDM_IO9 | AS_nCSO1,MSEL2,PWRMGT_ALERT |  |  |  |  | BM102
SDM |  | SDM_IO6 | AVSTx8_DATA4,AS_DATA3 |  |  |  |  | CF102
SDM |  | SDM_IO10 | AVSTx8_DATA7 |  |  |  |  | CH109
SDM |  | SDM_IO8 | AVSTx8_READY,AS_nCSO3 |  |  |  |  | CC102
SDM |  | SDM_IO12 | PWRMGT_SDA,PWRMGT_ALERT |  |  |  |  | BR99
SDM |  | SDM_IO15 | AVSTx8_DATA6,AS_nRST |  |  |  |  | CA102
SDM |  | SDM_IO14 | AVSTx8_CLK,PWRMGT_SCL |  |  |  |  | CF109
SDM |  | RREF_SDM |  |  |  |  |  | CL103
SDM |  |  | TEMPDIODE0An |  |  |  |  | BF100
SDM |  |  | TEMPDIODE0Ap |  |  |  |  | BE100
SDM |  |  | VREFP_ADC |  |  |  |  | CL116
SDM |  |  | VREFN_ADC |  |  |  |  | CK116
SDM |  | VSIGP_0 |  |  |  |  |  | CK119
SDM |  | VSIGN_0 |  |  |  |  |  | CL119
SDM |  | VSIGP_1 |  |  |  |  |  | CK113
SDM |  | VSIGN_1 |  |  |  |  |  | CL113
HPS |  | HPS_IOA_1 | GPIO0_IO0,SPIM0_SS1_N,SPIS0_CLK,UART0_CTS_N,NAND_ADQ0,SDMMC_DATA0,USB0_CLK,EMAC0_PPS0,TRACE_D10 |  | HPS_IOA_1 |  |  | W135
HPS |  | HPS_IOA_2 | GPIO0_IO1,SPIM1_SS1_N,SPIS0_MOSI,UART0_RTS_N,NAND_ADQ1,SDMMC_DATA1,USB0_STP,EMAC0_PPSTRIG0,TRACE_D9 |  | HPS_IOA_2 |  |  | U135
HPS |  | HPS_IOA_3 | GPIO0_IO2,SPIS0_SS0_N,UART0_TX,I2C1_SDA,NAND_WE_N,SDMMC_CLK,USB0_DIR,EMAC1_PPS1,TRACE_D8 |  | HPS_IOA_3 |  |  | W134
HPS |  | HPS_IOA_4 | GPIO0_IO3,SPIS0_MISO,UART0_RX,I2C1_SCL,NAND_RE_N,USB0_DATA0,EMAC1_PPSTRIG1,TRACE_D7 |  | HPS_IOA_4 |  |  | AK115
HPS |  | HPS_IOA_5 | GPIO0_IO4,SPIM0_CLK,UART1_CTS_N,I2C0_SDA,NAND_WP_N,SDMMC_WRITE_PROTECT,USB0_DATA1,EMAC2_PPS2,TRACE_D6 |  | HPS_IOA_5 |  |  | U134
HPS |  | HPS_IOA_6 | GPIO0_IO5,SPIM0_MOSI,UART1_RTS_N,I2C0_SCL,NAND_ADQ2,SDMMC_DATA2,USB0_NXT,EMAC2_PPSTRIG2,TRACE_D5 |  | HPS_IOA_6 |  |  | AL120
HPS |  | HPS_IOA_7 | GPIO0_IO6,SPIM0_MISO,MDIO2_MDIO,UART1_TX,I2C_EMAC2_SDA,NAND_ADQ3,SDMMC_DATA3,USB0_DATA2,TRACE_D4 |  | HPS_IOA_7 |  |  | R134
HPS |  | HPS_IOA_8 | GPIO0_IO7,SPIM0_SS0_N,MDIO2_MDC,UART1_RX,I2C_EMAC2_SCL,NAND_CLE,SDMMC_CMD,USB0_DATA3,TRACE_D15 |  | HPS_IOA_8 |  |  | AG115
HPS |  | HPS_IOA_9 | GPIO0_IO8,SPIM1_CLK,SPIS1_CLK,MDIO1_MDIO,I2C_EMAC1_SDA,NAND_ADQ4,SDMMC_DATA4,USB0_DATA4,I3C1_SDA,TRACE_D14 |  | HPS_IOA_9 |  |  | N135
HPS |  | HPS_IOA_10 | GPIO0_IO9,SPIM1_MOSI,SPIS1_MOSI,MDIO1_MDC,I2C_EMAC1_SCL,NAND_ADQ5,SDMMC_DATA5,USB0_DATA5,I3C1_SCL,TRACE_D13 |  | HPS_IOA_10 |  |  | AK120
HPS |  | HPS_IOA_11 | GPIO0_IO10,SPIM1_MISO,SPIS1_SS0_N,MDIO0_MDIO,I2C_EMAC0_SDA,NAND_ADQ6,SDMMC_DATA6,USB0_DATA6,I3C0_SDA,TRACE_D12 |  | HPS_IOA_11 |  |  | N134
HPS |  | HPS_IOA_12 | GPIO0_IO11,SPIM1_SS0_N,SPIS1_MISO,MDIO0_MDC,I2C_EMAC0_SCL,NAND_ADQ7,SDMMC_DATA7,USB0_DATA7,I3C0_SCL,TRACE_D11 |  | HPS_IOA_12 |  |  | T132
HPS |  | HPS_IOA_13 | GPIO0_IO12,NAND_ALE,SDMMC_PU_PD_DATA2,USB1_CLK,EMAC0_TX_CLK,TRACE_D10 |  | HPS_IOA_13 |  |  | P132
HPS |  | HPS_IOA_14 | GPIO0_IO13,NAND_RB_N,SDMMC_PWR_ENA,USB1_STP,EMAC0_TX_CTL,TRACE_D9 |  | HPS_IOA_14 |  |  | L135
HPS |  | HPS_IOA_15 | GPIO0_IO14,NAND_CE_N,USB1_DIR,EMAC0_RX_CLK,TRACE_D8 |  | HPS_IOA_15 |  |  | J135
HPS |  | HPS_IOA_16 | GPIO0_IO15,NAND_DQS,SDMMC_DATA_STROBE,USB1_DATA0,EMAC0_RX_CTL,TRACE_D7 |  | HPS_IOA_16 |  |  | AD135
HPS |  | HPS_IOA_17 | GPIO0_IO16,I3C1_SDA,NAND_ADQ8,USB1_DATA1,EMAC0_TXD0,TRACE_D6 |  | HPS_IOA_17 |  |  | M132
HPS |  | HPS_IOA_18 | GPIO0_IO17,I3C1_SCL,NAND_ADQ9,USB1_NXT,EMAC0_TXD1,TRACE_D5 |  | HPS_IOA_18 |  |  | AD134
HPS |  | HPS_IOA_19 | GPIO0_IO18,I3C0_SDA,NAND_ADQ10,USB1_DATA2,EMAC0_RXD0,TRACE_D4 |  | HPS_IOA_19 |  |  | K132
HPS |  | HPS_IOA_20 | GPIO0_IO19,SPIM1_SS1_N,I3C0_SCL,NAND_ADQ11,USB1_DATA3,EMAC0_RXD1,TRACE_CLK |  | HPS_IOA_20 |  |  | AG129
HPS |  | HPS_IOA_21 | GPIO0_IO20,SPIM1_CLK,SPIS0_CLK,UART0_CTS_N,I2C1_SDA,NAND_ADQ12,USB1_DATA4,EMAC0_TXD2,TRACE_D0 |  | HPS_IOA_21 |  |  | J134
HPS |  | HPS_IOA_22 | GPIO0_IO21,SPIM1_MOSI,SPIS0_MOSI,UART0_RTS_N,I2C1_SCL,NAND_ADQ13,USB1_DATA5,EMAC0_TXD3,TRACE_D1 |  | HPS_IOA_22 |  |  | AG120
HPS |  | HPS_IOA_23 | GPIO0_IO22,SPIM1_MISO,SPIS0_SS0_N,UART0_TX,I2C0_SDA,NAND_ADQ14,USB1_DATA6,EMAC0_RXD2,TRACE_D2 |  | HPS_IOA_23 |  |  | G134
HPS |  | HPS_IOA_24 | GPIO0_IO23,SPIM1_SS0_N,SPIS0_MISO,UART0_RX,I2C0_SCL,NAND_ADQ15,USB1_DATA7,EMAC0_RXD3,TRACE_D3 |  | HPS_IOA_24 |  |  | G135
HPS |  | HPS_IOB_1 | GPIO1_IO0,SPIM1_CLK,UART0_CTS_N,EMAC0_PPS0,NAND_ADQ0,SDMMC_DATA0,I3C0_SDA_PULLUP_EN,EMAC1_TX_CLK,TRACE_D10 |  | HPS_IOB_1 |  |  | E135
HPS |  | HPS_IOB_2 | GPIO1_IO1,SPIM1_MOSI,UART0_RTS_N,EMAC0_PPSTRIG0,NAND_ADQ1,SDMMC_DATA1,I3C1_SDA_PULLUP_EN,EMAC1_TX_CTL,TRACE_D9 |  | HPS_IOB_2 |  |  | F132
HPS |  | HPS_IOB_3 | GPIO1_IO2,SPIM1_MISO,UART0_TX,I2C0_SDA,NAND_WE_N,SDMMC_CLK,EMAC1_RX_CLK,TRACE_D8 |  | HPS_IOB_3 |  |  | D132
HPS |  | HPS_IOB_4 | GPIO1_IO3,SPIM1_SS0_N,UART0_RX,I2C0_SCL,NAND_RE_N,EMAC1_RX_CTL,TRACE_D7 |  | HPS_IOB_4 |  |  | AG123
HPS |  | HPS_IOB_5 | GPIO1_IO4,SPIM1_SS1_N,SPIS1_CLK,UART1_CTS_N,EMAC2_PPS2,NAND_WP_N,SDMMC_WRITE_PROTECT,I3C1_SDA,EMAC1_TXD0,TRACE_D6 |  | HPS_IOB_5 |  |  | B134
HPS |  | HPS_IOB_6 | GPIO1_IO5,SPIS1_MOSI,UART1_RTS_N,EMAC2_PPSTRIG2,NAND_ADQ2,SDMMC_DATA2,I3C1_SCL,EMAC1_TXD1,TRACE_D5 |  | HPS_IOB_6 |  |  | AA135
HPS |  | HPS_IOB_7 | GPIO1_IO6,SPIS1_SS0_N,UART1_TX,I2C1_SDA,NAND_ADQ3,SDMMC_DATA3,I3C0_SDA,EMAC1_RXD0,TRACE_D4 |  | HPS_IOB_7 |  |  | V127
HPS |  | HPS_IOB_8 | GPIO1_IO7,SPIS1_MISO,UART1_RX,I2C1_SCL,NAND_CLE,SDMMC_CMD,I3C0_SCL,EMAC1_RXD1,TRACE_D15 |  | HPS_IOB_8 |  |  | AB132
HPS |  | HPS_IOB_9 | GPIO1_IO8,JTAG_TCK,SPIS0_CLK,MDIO2_MDIO,I2C_EMAC2_SDA,NAND_ADQ4,SDMMC_DATA4,EMAC1_TXD2,TRACE_D14 |  | HPS_IOB_9 |  |  | T127
HPS |  | HPS_IOB_10 | GPIO1_IO9,JTAG_TMS,SPIS0_MOSI,MDIO2_MDC,I2C_EMAC2_SCL,NAND_ADQ5,SDMMC_DATA5,EMAC1_TXD3,TRACE_D13 |  | HPS_IOB_10 |  |  | Y132
HPS |  | HPS_IOB_11 | GPIO1_IO10,JTAG_TDO,SPIS0_SS0_N,MDIO0_MDIO,I2C_EMAC0_SDA,NAND_ADQ6,SDMMC_DATA6,EMAC1_RXD2,TRACE_D12 |  | HPS_IOB_11 |  |  | T124
HPS |  | HPS_IOB_12 | GPIO1_IO11,JTAG_TDI,SPIS0_MISO,MDIO0_MDC,I2C_EMAC0_SCL,NAND_ADQ7,SDMMC_DATA7,EMAC1_RXD3,TRACE_D11 |  | HPS_IOB_12 |  |  | P124
HPS |  | HPS_IOB_13 | GPIO1_IO12,I2C1_SDA,NAND_ALE,SDMMC_PU_PD_DATA2,EMAC2_TX_CLK,TRACE_D10 |  | HPS_IOB_13 |  |  | M127
HPS |  | HPS_IOB_14 | GPIO1_IO13,I2C1_SCL,NAND_RB_N,SDMMC_PWR_ENA,EMAC2_TX_CTL,TRACE_D9 |  | HPS_IOB_14 |  |  | K127
HPS |  | HPS_IOB_15 | GPIO1_IO14,UART1_TX,NAND_CE_N,I3C1_SDA,EMAC2_RX_CLK,TRACE_D8 |  | HPS_IOB_15 |  |  | M124
HPS |  | HPS_IOB_16 | GPIO1_IO15,UART1_RX,NAND_DQS,SDMMC_DATA_STROBE,I3C1_SCL,EMAC2_RX_CTL,TRACE_D7 |  | HPS_IOB_16 |  |  | AB127
HPS |  | HPS_IOB_17 | GPIO1_IO16,UART1_CTS_N,NAND_ADQ8,I3C0_SDA,EMAC2_TXD0,TRACE_D6 |  | HPS_IOB_17 |  |  | K124
HPS |  | HPS_IOB_18 | GPIO1_IO17,SPIM0_SS1_N,UART1_RTS_N,NAND_ADQ9,I3C0_SCL,EMAC2_TXD1,TRACE_D5 |  | HPS_IOB_18 |  |  | Y127
HPS |  | HPS_IOB_19 | GPIO1_IO18,SPIM0_MISO,MDIO1_MDIO,I2C_EMAC1_SDA,NAND_ADQ10,EMAC2_RXD0,TRACE_D4 |  | HPS_IOB_19 |  |  | H127
HPS |  | HPS_IOB_20 | GPIO1_IO19,SPIM0_SS0_N,MDIO1_MDC,I2C_EMAC1_SCL,NAND_ADQ11,EMAC2_RXD1,TRACE_CLK |  | HPS_IOB_20 |  |  | AB124
HPS |  | HPS_IOB_21 | GPIO1_IO20,SPIM0_CLK,SPIS1_CLK,I2C_EMAC2_SDA,NAND_ADQ12,I3C0_SDA_PULLUP_EN,EMAC2_TXD2,TRACE_D0 |  | HPS_IOB_21 |  |  | F127
HPS |  | HPS_IOB_22 | GPIO1_IO21,SPIM0_MOSI,SPIS1_MOSI,I2C_EMAC2_SCL,NAND_ADQ13,I3C1_SDA_PULLUP_EN,EMAC2_TXD3,TRACE_D1 |  | HPS_IOB_22 |  |  | Y124
HPS |  | HPS_IOB_23 | GPIO1_IO22,SPIM0_MISO,SPIS1_SS0_N,MDIO0_MDIO,I2C_EMAC0_SDA,NAND_ADQ14,EMAC2_RXD2,TRACE_D2 |  | HPS_IOB_23 |  |  | F124
HPS |  | HPS_IOB_24 | GPIO1_IO23,SPIM0_SS0_N,SPIS1_MISO,MDIO0_MDC,I2C_EMAC0_SCL,NAND_ADQ15,EMAC2_RXD3,TRACE_D3 |  | HPS_IOB_24 |  |  | D124
2A_T | 95 | IO | IOB |  |  | DIFF_IO_2A_T1n | No | CH59 | DQ0 | DQ0 | DQ0
2A_T | 94 | IO | IOB |  |  | DIFF_IO_2A_T1p | No | CF59 | DQ0 | DQ0 | DQ0
2A_T | 93 | IO | IOB |  |  | DIFF_IO_2A_T2n | No | CH62 | DQ0 | DQ0 | DQ0
2A_T | 92 | IO | IOB |  |  | DIFF_IO_2A_T2p | No | CF62 | DQ0 | DQ0 | DQ0
2A_T | 91 | IO | IOB |  |  | DIFF_IO_2A_T3n | No | CC62 | DQSn0 | DQ0 | DQ0
2A_T | 90 | IO | IOB |  |  | DIFF_IO_2A_T3p | No | CA62 | DQS0 | DQ0 | DQ0
2A_T | 89 | IO | IOB |  |  | DIFF_IO_2A_T4n | No | CF69 | DQSn1 | DQSn0/CQn0 | DQ0
2A_T | 88 | IO | IOB |  |  | DIFF_IO_2A_T4p | No | CH69 | DQS1 | DQS0/CQ0 | DQ0
2A_T | 87 | IO | IOB |  |  | DIFF_IO_2A_T5n | Yes | CA71 | DQ1 | DQ0 | DQ0
2A_T | 86 | IO | IOB |  |  | DIFF_IO_2A_T5p | Yes | CC71 | DQ1 | DQ0 | DQ0
2A_T | 85 | IO | IOB |  |  | DIFF_IO_2A_T6n | No | CH71 | DQ1 | DQ0 | DQ0
2A_T | 84 | IO | IOB |  |  | DIFF_IO_2A_T6p | No | CF71 | DQ1 | DQ0 | DQ0
2A_T | 83 | IO | IOB |  |  | DIFF_IO_2A_T7n | No | CA59 | DQ2 | DQ1 | DQ0
2A_T | 82 | IO | IOB |  |  | DIFF_IO_2A_T7p | No | BW59 | DQ2 | DQ1 | DQ0
2A_T | 81 | IO | IOB |  |  | DIFF_IO_2A_T8n | No | BR59 | DQ2 | DQ1 | DQ0
2A_T | 80 | IO | IOB |  |  | DIFF_IO_2A_T8p | No | BU59 | DQ2 | DQ1 | DQ0
2A_T | 79 | IO | IOB |  |  | DIFF_IO_2A_T9n | No | BR62 | DQSn2 | DQ1 | DQ0
2A_T | 78 | IO | IOB |  |  | DIFF_IO_2A_T9p | No | BU62 | DQS2 | DQ1 | DQ0
2A_T | 77 | IO | IOB |  |  | DIFF_IO_2A_T10n | No | CA69 | DQSn3 | DQSn1/CQn1 | DQSn0/CQn0
2A_T | 76 | IO | IOB |  |  | DIFF_IO_2A_T10p | No | BW69 | DQS3 | DQS1/CQ1 | DQS0/CQ0
2A_T | 75 | IO | IOB |  |  | DIFF_IO_2A_T11n | Yes | BU71 | DQ3 | DQ1 | DQ0
2A_T | 74 | IO | IOB |  |  | DIFF_IO_2A_T11p | Yes | BR71 | DQ3 | DQ1 | DQ0
2A_T | 73 | IO | IOB |  |  | DIFF_IO_2A_T12n | No | BU69 | DQ3 | DQ1 | DQ0
2A_T | 72 | IO | IOB |  |  | DIFF_IO_2A_T12p | No | BR69 | DQ3 | DQ1 | DQ0
2A_T | 71 | IO | IOB |  |  | DIFF_IO_2A_T13n | No | BK59 | DQ4 | DQ2 | DQ1
2A_T | 70 | IO | IOB |  |  | DIFF_IO_2A_T13p | No | BM59 | DQ4 | DQ2 | DQ1
2A_T | 69 | IO | IOB |  |  | DIFF_IO_2A_T14n | No | BH59 | DQ4 | DQ2 | DQ1
2A_T | 68 | IO | IOB |  |  | DIFF_IO_2A_T14p | No | BH62 | DQ4 | DQ2 | DQ1
2A_T | 67 | IO | IOB |  |  | DIFF_IO_2A_T15n | No | BP62 | DQSn4 | DQ2 | DQ1
2A_T | 66 | IO | IOB |  |  | DIFF_IO_2A_T15p | No | BM62 | DQS4 | DQ2 | DQ1
2A_T | 65 | IO | IOB,PLL_2A_T_CLKOUT1n |  |  | DIFF_IO_2A_T16n | No | BK69 | DQSn5 | DQSn2/CQn2 | DQ1
2A_T | 64 | IO | IOB,PLL_2A_T_CLKOUT1p,PLL_2A_T_CLKOUT1,PLL_2A_T_FB1 |  |  | DIFF_IO_2A_T16p | No | BM69 | DQS5 | DQS2/CQ2 | DQ1
2A_T | 63 | IO | IOB |  |  | DIFF_IO_2A_T17n | Yes | BH71 | DQ5 | DQ2 | DQ1
2A_T | 62 | IO | IOB,RZQ_T_2A |  |  | DIFF_IO_2A_T17p | Yes | BH69 | DQ5 | DQ2 | DQ1
2A_T | 61 | IO | IOB,CLK_T_2A_1n |  |  | DIFF_IO_2A_T18n | No | BP71 | DQ5 | DQ2 | DQ1
2A_T | 60 | IO | IOB,CLK_T_2A_1p |  |  | DIFF_IO_2A_T18p | No | BM71 | DQ5 | DQ2 | DQ1
2A_T | 59 | IO | IOB,CLK_T_2A_0n |  |  | DIFF_IO_2A_T19n | No | BF72 | DQ6 | DQ3 | DQ1
2A_T | 58 | IO | IOB,CLK_T_2A_0p |  |  | DIFF_IO_2A_T19p | No | BF75 | DQ6 | DQ3 | DQ1
2A_T | 57 | IO | IOB |  |  | DIFF_IO_2A_T20n | No | BE75 | DQ6 | DQ3 | DQ1
2A_T | 56 | IO | IOB |  |  | DIFF_IO_2A_T20p | No | BE79 | DQ6 | DQ3 | DQ1
2A_T | 55 | IO | IOB,PLL_2A_T_CLKOUT0n |  |  | DIFF_IO_2A_T21n | No | BF83 | DQSn6 | DQ3 | DQ1
2A_T | 54 | IO | IOB,PLL_2A_T_CLKOUT0p,PLL_2A_T_CLKOUT0,PLL_2A_T_FB0 |  |  | DIFF_IO_2A_T21p | No | BE83 | DQS6 | DQ3 | DQ1
2A_T | 53 | IO | IOB |  |  | DIFF_IO_2A_T22n | No | BE86 | DQSn7 | DQSn3/CQn3 | DQSn1/CQn1
2A_T | 52 | IO | IOB |  |  | DIFF_IO_2A_T22p | No | BF86 | DQS7 | DQS3/CQ3 | DQS1/CQ1
2A_T | 51 | IO | IOB |  |  | DIFF_IO_2A_T23n | Yes | BF90 | DQ7 | DQ3 | DQ1
2A_T | 50 | IO | IOB |  |  | DIFF_IO_2A_T23p | Yes | BF93 | DQ7 | DQ3 | DQ1
2A_T | 49 | IO | IOB |  |  | DIFF_IO_2A_T24n | No | BE93 | DQ7 | DQ3 | DQ1
2A_T | 48 | IO | IOB |  |  | DIFF_IO_2A_T24p | No | BE96 | DQ7 | DQ3 | DQ1
2A_B | 47 | IO | IOB |  |  | DIFF_IO_2A_B1n | No | BK78 | DQ8 | DQ4 | DQ2
2A_B | 46 | IO | IOB |  |  | DIFF_IO_2A_B1p | No | BM78 | DQ8 | DQ4 | DQ2
2A_B | 45 | IO | IOB |  |  | DIFF_IO_2A_B2n | No | BH78 | DQ8 | DQ4 | DQ2
2A_B | 44 | IO | IOB |  |  | DIFF_IO_2A_B2p | No | BH81 | DQ8 | DQ4 | DQ2
2A_B | 43 | IO | IOB |  |  | DIFF_IO_2A_B3n | No | BP81 | DQSn8 | DQ4 | DQ2
2A_B | 42 | IO | IOB |  |  | DIFF_IO_2A_B3p | No | BM81 | DQS8 | DQ4 | DQ2
2A_B | 41 | IO | IOB,PLL_2A_B_CLKOUT1n |  |  | DIFF_IO_2A_B4n | No | BM89 | DQSn9 | DQSn4/CQn4 | DQ2
2A_B | 40 | IO | IOB,PLL_2A_B_CLKOUT1p,PLL_2A_B_CLKOUT1,PLL_2A_B_FB1 |  |  | DIFF_IO_2A_B4p | No | BK89 | DQS9 | DQS4/CQ4 | DQ2
2A_B | 39 | IO | IOB |  |  | DIFF_IO_2A_B5n | Yes | BH92 | DQ9 | DQ4 | DQ2
2A_B | 38 | IO | IOB,RZQ_B_2A |  |  | DIFF_IO_2A_B5p | Yes | BH89 | DQ9 | DQ4 | DQ2
2A_B | 37 | IO | IOB,CLK_B_2A_1n |  |  | DIFF_IO_2A_B6n | Yes | BM92 | DQ9 | DQ4 | DQ2
2A_B | 36 | IO | IOB,CLK_B_2A_1p |  |  | DIFF_IO_2A_B6p | Yes | BP92 | DQ9 | DQ4 | DQ2
2A_B | 35 | IO | IOB,CLK_B_2A_0n |  |  | DIFF_IO_2A_B7n | No | CA78 | DQ10 | DQ5 | DQ2
2A_B | 34 | IO | IOB,CLK_B_2A_0p |  |  | DIFF_IO_2A_B7p | No | BW78 | DQ10 | DQ5 | DQ2
2A_B | 33 | IO | IOB |  |  | DIFF_IO_2A_B8n | No | BU78 | DQ10 | DQ5 | DQ2
2A_B | 32 | IO | IOB |  |  | DIFF_IO_2A_B8p | No | BR78 | DQ10 | DQ5 | DQ2
2A_B | 31 | IO | IOB,PLL_2A_B_CLKOUT0n |  |  | DIFF_IO_2A_B9n | No | BU81 | DQSn10 | DQ5 | DQ2
2A_B | 30 | IO | IOB,PLL_2A_B_CLKOUT0p,PLL_2A_B_CLKOUT0,PLL_2A_B_FB0 |  |  | DIFF_IO_2A_B9p | No | BR81 | DQS10 | DQ5 | DQ2
2A_B | 29 | IO | IOB |  |  | DIFF_IO_2A_B10n | No | CA89 | DQSn11 | DQSn5/CQn5 | DQSn2/CQn2
2A_B | 28 | IO | IOB |  |  | DIFF_IO_2A_B10p | No | BW89 | DQS11 | DQS5/CQ5 | DQS2/CQ2
2A_B | 27 | IO | IOB |  |  | DIFF_IO_2A_B11n | Yes | BU92 | DQ11 | DQ5 | DQ2
2A_B | 26 | IO | IOB |  |  | DIFF_IO_2A_B11p | Yes | BR92 | DQ11 | DQ5 | DQ2
2A_B | 25 | IO | IOB |  |  | DIFF_IO_2A_B12n | Yes | BU89 | DQ11 | DQ5 | DQ2
2A_B | 24 | IO | IOB |  |  | DIFF_IO_2A_B12p | Yes | BR89 | DQ11 | DQ5 | DQ2
2A_B | 23 | IO | IOB |  |  | DIFF_IO_2A_B13n | No | CF78 | DQ12 | DQ6 | DQ3
2A_B | 22 | IO | IOB |  |  | DIFF_IO_2A_B13p | No | CH78 | DQ12 | DQ6 | DQ3
2A_B | 21 | IO | IOB |  |  | DIFF_IO_2A_B14n | No | CC81 | DQ12 | DQ6 | DQ3
2A_B | 20 | IO | IOB |  |  | DIFF_IO_2A_B14p | No | CA81 | DQ12 | DQ6 | DQ3
2A_B | 19 | IO | IOB |  |  | DIFF_IO_2A_B15n | No | CH81 | DQSn12 | DQ6 | DQ3
2A_B | 18 | IO | IOB |  |  | DIFF_IO_2A_B15p | No | CF81 | DQS12 | DQ6 | DQ3
2A_B | 17 | IO | IOB |  |  | DIFF_IO_2A_B16n | No | CF89 | DQSn13 | DQSn6/CQn6 | DQ3
2A_B | 16 | IO | IOB |  |  | DIFF_IO_2A_B16p | No | CH89 | DQS13 | DQS6/CQ6 | DQ3
2A_B | 15 | IO | IOB |  |  | DIFF_IO_2A_B17n | Yes | CH92 | DQ13 | DQ6 | DQ3
2A_B | 14 | IO | IOB |  |  | DIFF_IO_2A_B17p | Yes | CF92 | DQ13 | DQ6 | DQ3
2A_B | 13 | IO | IOB |  |  | DIFF_IO_2A_B18n | Yes | CA92 | DQ13 | DQ6 | DQ3
2A_B | 12 | IO | IOB |  |  | DIFF_IO_2A_B18p | Yes | CC92 | DQ13 | DQ6 | DQ3
2A_B | 11 | IO | IOB |  |  | DIFF_IO_2A_B19n | No | CL76 | DQ14 | DQ7 | DQ3
2A_B | 10 | IO | IOB |  |  | DIFF_IO_2A_B19p | No | CK76 | DQ14 | DQ7 | DQ3
2A_B | 9 | IO | IOB |  |  | DIFF_IO_2A_B20n | No | CL82 | DQ14 | DQ7 | DQ3
2A_B | 8 | IO | IOB |  |  | DIFF_IO_2A_B20p | No | CK80 | DQ14 | DQ7 | DQ3
2A_B | 7 | IO | IOB |  |  | DIFF_IO_2A_B21n | No | CL85 | DQSn14 | DQ7 | DQ3
2A_B | 6 | IO | IOB |  |  | DIFF_IO_2A_B21p | No | CK85 | DQS14 | DQ7 | DQ3
2A_B | 5 | IO | IOB |  |  | DIFF_IO_2A_B22n | No | CK88 | DQSn15 | DQSn7/CQn7 | DQSn3/CQn3
2A_B | 4 | IO | IOB |  |  | DIFF_IO_2A_B22p | No | CL88 | DQS15 | DQS7/CQ7 | DQS3/CQ3
2A_B | 3 | IO | IOB |  |  | DIFF_IO_2A_B23n | Yes | CL97 | DQ15 | DQ7 | DQ3
2A_B | 2 | IO | IOB |  |  | DIFF_IO_2A_B23p | Yes | CK97 | DQ15 | DQ7 | DQ3
2A_B | 1 | IO | IOB |  |  | DIFF_IO_2A_B24n | Yes | CK94 | DQ15 | DQ7 | DQ3
2A_B | 0 | IO | IOB |  |  | DIFF_IO_2A_B24p | Yes | CL91 | DQ15 | DQ7 | DQ3
2B_T | 95 | IO | IOB |  |  | DIFF_IO_2B_T1n | No | CC19 | DQ16 | DQ8 | DQ4
2B_T | 94 | IO | IOB |  |  | DIFF_IO_2B_T1p | No | CF19 | DQ16 | DQ8 | DQ4
2B_T | 93 | IO | IOB |  |  | DIFF_IO_2B_T2n | No | CH22 | DQ16 | DQ8 | DQ4
2B_T | 92 | IO | IOB |  |  | DIFF_IO_2B_T2p | No | CF22 | DQ16 | DQ8 | DQ4
2B_T | 91 | IO | IOB |  |  | DIFF_IO_2B_T3n | No | CA22 | DQSn16 | DQ8 | DQ4
2B_T | 90 | IO | IOB |  |  | DIFF_IO_2B_T3p | No | CC22 | DQS16 | DQ8 | DQ4
2B_T | 89 | IO | IOB |  |  | DIFF_IO_2B_T4n | No | CC28 | DQSn17 | DQSn8/CQn8 | DQ4
2B_T | 88 | IO | IOB |  |  | DIFF_IO_2B_T4p | No | CF28 | DQS17 | DQS8/CQ8 | DQ4
2B_T | 87 | IO | IOB |  |  | DIFF_IO_2B_T5n | Yes | CC31 | DQ17 | DQ8 | DQ4
2B_T | 86 | IO | IOB |  |  | DIFF_IO_2B_T5p | Yes | CA31 | DQ17 | DQ8 | DQ4
2B_T | 85 | IO | IOB |  |  | DIFF_IO_2B_T6n | No | CF31 | DQ17 | DQ8 | DQ4
2B_T | 84 | IO | IOB |  |  | DIFF_IO_2B_T6p | No | CH31 | DQ17 | DQ8 | DQ4
2B_T | 83 | IO | IOB |  |  | DIFF_IO_2B_T7n | No | CL6 | DQ18 | DQ9 | DQ4
2B_T | 82 | IO | IOB |  |  | DIFF_IO_2B_T7p | No | CK8 | DQ18 | DQ9 | DQ4
2B_T | 81 | IO | IOB |  |  | DIFF_IO_2B_T8n | No | CL8 | DQ18 | DQ9 | DQ4
2B_T | 80 | IO | IOB |  |  | DIFF_IO_2B_T8p | No | CK11 | DQ18 | DQ9 | DQ4
2B_T | 79 | IO | IOB |  |  | DIFF_IO_2B_T9n | No | CL11 | DQSn18 | DQ9 | DQ4
2B_T | 78 | IO | IOB |  |  | DIFF_IO_2B_T9p | No | CL14 | DQS18 | DQ9 | DQ4
2B_T | 77 | IO | IOB |  |  | DIFF_IO_2B_T10n | No | CL17 | DQSn19 | DQSn9/CQn9 | DQSn4/CQn4
2B_T | 76 | IO | IOB |  |  | DIFF_IO_2B_T10p | No | CK17 | DQS19 | DQS9/CQ9 | DQS4/CQ4
2B_T | 75 | IO | IOB |  |  | DIFF_IO_2B_T11n | Yes | CK20 | DQ19 | DQ9 | DQ4
2B_T | 74 | IO | IOB |  |  | DIFF_IO_2B_T11p | Yes | CL20 | DQ19 | DQ9 | DQ4
2B_T | 73 | IO | IOB |  |  | DIFF_IO_2B_T12n | No | CK26 | DQ19 | DQ9 | DQ4
2B_T | 72 | IO | IOB |  |  | DIFF_IO_2B_T12p | No | CL23 | DQ19 | DQ9 | DQ4
2B_T | 71 | IO | IOB |  |  | DIFF_IO_2B_T13n | No | BF46 | DQ20 | DQ10 | DQ5
2B_T | 70 | IO | IOB |  |  | DIFF_IO_2B_T13p | No | BE46 | DQ20 | DQ10 | DQ5
2B_T | 69 | IO | IOB |  |  | DIFF_IO_2B_T14n | No | BE50 | DQ20 | DQ10 | DQ5
2B_T | 68 | IO | IOB |  |  | DIFF_IO_2B_T14p | No | BF50 | DQ20 | DQ10 | DQ5
2B_T | 67 | IO | IOB |  |  | DIFF_IO_2B_T15n | No | BF53 | DQSn20 | DQ10 | DQ5
2B_T | 66 | IO | IOB |  |  | DIFF_IO_2B_T15p | No | BF57 | DQS20 | DQ10 | DQ5
2B_T | 65 | IO | IOB,PLL_2B_T_CLKOUT1n |  |  | DIFF_IO_2B_T16n | No | BE57 | DQSn21 | DQSn10/CQn10 | DQ5
2B_T | 64 | IO | IOB,PLL_2B_T_CLKOUT1p,PLL_2B_T_CLKOUT1,PLL_2B_T_FB1 |  |  | DIFF_IO_2B_T16p | No | BE61 | DQS21 | DQS10/CQ10 | DQ5
2B_T | 63 | IO | IOB |  |  | DIFF_IO_2B_T17n | Yes | BF64 | DQ21 | DQ10 | DQ5
2B_T | 62 | IO | IOB,RZQ_T_2B |  |  | DIFF_IO_2B_T17p | Yes | BE64 | DQ21 | DQ10 | DQ5
2B_T | 61 | IO | IOB,CLK_T_2B_1n |  |  | DIFF_IO_2B_T18n | No | BE68 | DQ21 | DQ10 | DQ5
2B_T | 60 | IO | IOB,CLK_T_2B_1p |  |  | DIFF_IO_2B_T18p | No | BF68 | DQ21 | DQ10 | DQ5
2B_T | 59 | IO | IOB,CLK_T_2B_0n |  |  | DIFF_IO_2B_T19n | No | BM38 | DQ22 | DQ11 | DQ5
2B_T | 58 | IO | IOB,CLK_T_2B_0p |  |  | DIFF_IO_2B_T19p | No | BK38 | DQ22 | DQ11 | DQ5
2B_T | 57 | IO | IOB |  |  | DIFF_IO_2B_T20n | No | BH41 | DQ22 | DQ11 | DQ5
2B_T | 56 | IO | IOB |  |  | DIFF_IO_2B_T20p | No | BH38 | DQ22 | DQ11 | DQ5
2B_T | 55 | IO | IOB,PLL_2B_T_CLKOUT0n |  |  | DIFF_IO_2B_T21n | No | BM41 | DQSn22 | DQ11 | DQ5
2B_T | 54 | IO | IOB,PLL_2B_T_CLKOUT0p,PLL_2B_T_CLKOUT0,PLL_2B_T_FB0 |  |  | DIFF_IO_2B_T21p | No | BP41 | DQS22 | DQ11 | DQ5
2B_T | 53 | IO | IOB |  |  | DIFF_IO_2B_T22n | No | BM49 | DQSn23 | DQSn11/CQn11 | DQSn5/CQn5
2B_T | 52 | IO | IOB |  |  | DIFF_IO_2B_T22p | No | BK49 | DQS23 | DQS11/CQ11 | DQS5/CQ5
2B_T | 51 | IO | IOB |  |  | DIFF_IO_2B_T23n | Yes | BH52 | DQ23 | DQ11 | DQ5
2B_T | 50 | IO | IOB |  |  | DIFF_IO_2B_T23p | Yes | BH49 | DQ23 | DQ11 | DQ5
2B_T | 49 | IO | IOB |  |  | DIFF_IO_2B_T24n | No | BP52 | DQ23 | DQ11 | DQ5
2B_T | 48 | IO | IOB |  |  | DIFF_IO_2B_T24p | No | BM52 | DQ23 | DQ11 | DQ5
2B_B | 47 | IO | IOB |  |  | DIFF_IO_2B_B1n | No | BW38 | DQ24 | DQ12 | DQ6
2B_B | 46 | IO | IOB |  |  | DIFF_IO_2B_B1p | No | CA38 | DQ24 | DQ12 | DQ6
2B_B | 45 | IO | IOB |  |  | DIFF_IO_2B_B2n | No | BU38 | DQ24 | DQ12 | DQ6
2B_B | 44 | IO | IOB |  |  | DIFF_IO_2B_B2p | No | BR38 | DQ24 | DQ12 | DQ6
2B_B | 43 | IO | IOB |  |  | DIFF_IO_2B_B3n | No | BU41 | DQSn24 | DQ12 | DQ6
2B_B | 42 | IO | IOB |  |  | DIFF_IO_2B_B3p | No | BR41 | DQS24 | DQ12 | DQ6
2B_B | 41 | IO | IOB,PLL_2B_B_CLKOUT1n |  |  | DIFF_IO_2B_B4n | No | CA49 | DQSn25 | DQSn12/CQn12 | DQ6
2B_B | 40 | IO | IOB,PLL_2B_B_CLKOUT1p,PLL_2B_B_CLKOUT1,PLL_2B_B_FB1 |  |  | DIFF_IO_2B_B4p | No | BW49 | DQS25 | DQS12/CQ12 | DQ6
2B_B | 39 | IO | IOB |  |  | DIFF_IO_2B_B5n | Yes | BU52 | DQ25 | DQ12 | DQ6
2B_B | 38 | IO | IOB,RZQ_B_2B |  |  | DIFF_IO_2B_B5p | Yes | BR52 | DQ25 | DQ12 | DQ6
2B_B | 37 | IO | IOB,CLK_B_2B_1n |  |  | DIFF_IO_2B_B6n | Yes | BU49 | DQ25 | DQ12 | DQ6
2B_B | 36 | IO | IOB,CLK_B_2B_1p |  |  | DIFF_IO_2B_B6p | Yes | BR49 | DQ25 | DQ12 | DQ6
2B_B | 35 | IO | IOB,CLK_B_2B_0n |  |  | DIFF_IO_2B_B7n | No | CF38 | DQ26 | DQ13 | DQ6
2B_B | 34 | IO | IOB,CLK_B_2B_0p |  |  | DIFF_IO_2B_B7p | No | CH38 | DQ26 | DQ13 | DQ6
2B_B | 33 | IO | IOB |  |  | DIFF_IO_2B_B8n | No | CA41 | DQ26 | DQ13 | DQ6
2B_B | 32 | IO | IOB |  |  | DIFF_IO_2B_B8p | No | CC41 | DQ26 | DQ13 | DQ6
2B_B | 31 | IO | IOB,PLL_2B_B_CLKOUT0n |  |  | DIFF_IO_2B_B9n | No | CF41 | DQSn26 | DQ13 | DQ6
2B_B | 30 | IO | IOB,PLL_2B_B_CLKOUT0p,PLL_2B_B_CLKOUT0,PLL_2B_B_FB0 |  |  | DIFF_IO_2B_B9p | No | CH41 | DQS26 | DQ13 | DQ6
2B_B | 29 | IO | IOB |  |  | DIFF_IO_2B_B10n | No | CH49 | DQSn27 | DQSn13/CQn13 | DQSn6/CQn6
2B_B | 28 | IO | IOB |  |  | DIFF_IO_2B_B10p | No | CF49 | DQS27 | DQS13/CQ13 | DQS6/CQ6
2B_B | 27 | IO | IOB |  |  | DIFF_IO_2B_B11n | Yes | CA52 | DQ27 | DQ13 | DQ6
2B_B | 26 | IO | IOB |  |  | DIFF_IO_2B_B11p | Yes | CC52 | DQ27 | DQ13 | DQ6
2B_B | 25 | IO | IOB |  |  | DIFF_IO_2B_B12n | Yes | CH52 | DQ27 | DQ13 | DQ6
2B_B | 24 | IO | IOB |  |  | DIFF_IO_2B_B12p | Yes | CF52 | DQ27 | DQ13 | DQ6
2B_B | 23 | IO | IOB |  |  | DIFF_IO_2B_B13n | No | CL26 | DQ28 | DQ14 | DQ7
2B_B | 22 | IO | IOB |  |  | DIFF_IO_2B_B13p | No | CK30 | DQ28 | DQ14 | DQ7
2B_B | 21 | IO | IOB |  |  | DIFF_IO_2B_B14n | No | CL30 | DQ28 | DQ14 | DQ7
2B_B | 20 | IO | IOB |  |  | DIFF_IO_2B_B14p | No | CK33 | DQ28 | DQ14 | DQ7
2B_B | 19 | IO | IOB |  |  | DIFF_IO_2B_B15n | No | CL35 | DQSn28 | DQ14 | DQ7
2B_B | 18 | IO | IOB |  |  | DIFF_IO_2B_B15p | No | CK35 | DQS28 | DQ14 | DQ7
2B_B | 17 | IO | IOB |  |  | DIFF_IO_2B_B16n | No | CL39 | DQSn29 | DQSn14/CQn14 | DQ7
2B_B | 16 | IO | IOB |  |  | DIFF_IO_2B_B16p | No | CK39 | DQS29 | DQS14/CQ14 | DQ7
2B_B | 15 | IO | IOB |  |  | DIFF_IO_2B_B17n | Yes | CL45 | DQ29 | DQ14 | DQ7
2B_B | 14 | IO | IOB |  |  | DIFF_IO_2B_B17p | Yes | CK48 | DQ29 | DQ14 | DQ7
2B_B | 13 | IO | IOB |  |  | DIFF_IO_2B_B18n | Yes | CK45 | DQ29 | DQ14 | DQ7
2B_B | 12 | IO | IOB |  |  | DIFF_IO_2B_B18p | Yes | CL42 | DQ29 | DQ14 | DQ7
2B_B | 11 | IO | IOB |  |  | DIFF_IO_2B_B19n | No | CK54 | DQ30 | DQ15 | DQ7
2B_B | 10 | IO | IOB |  |  | DIFF_IO_2B_B19p | No | CL51 | DQ30 | DQ15 | DQ7
2B_B | 9 | IO | IOB |  |  | DIFF_IO_2B_B20n | No | CL54 | DQ30 | DQ15 | DQ7
2B_B | 8 | IO | IOB |  |  | DIFF_IO_2B_B20p | No | CK56 | DQ30 | DQ15 | DQ7
2B_B | 7 | IO | IOB |  |  | DIFF_IO_2B_B21n | No | CL60 | DQSn30 | DQ15 | DQ7
2B_B | 6 | IO | IOB |  |  | DIFF_IO_2B_B21p | No | CL56 | DQS30 | DQ15 | DQ7
2B_B | 5 | IO | IOB |  |  | DIFF_IO_2B_B22n | No | CL66 | DQSn31 | DQSn15/CQn15 | DQSn7/CQn7
2B_B | 4 | IO | IOB |  |  | DIFF_IO_2B_B22p | No | CK63 | DQS31 | DQS15/CQ15 | DQS7/CQ7
2B_B | 3 | IO | IOB |  |  | DIFF_IO_2B_B23n | Yes | CL73 | DQ31 | DQ15 | DQ7
2B_B | 2 | IO | IOB |  |  | DIFF_IO_2B_B23p | Yes | CK73 | DQ31 | DQ15 | DQ7
2B_B | 1 | IO | IOB |  |  | DIFF_IO_2B_B24n | Yes | CL70 | DQ31 | DQ15 | DQ7
2B_B | 0 | IO | IOB |  |  | DIFF_IO_2B_B24p | Yes | CK66 | DQ31 | DQ15 | DQ7
3A_T | 95 | IO | IOB |  | HPS_DDR | DIFF_IO_3A_T1n | No | A91 | DQ32 | DQ16 | DQ8
3A_T | 94 | IO | IOB |  | HPS_DDR | DIFF_IO_3A_T1p | No | B88 | DQ32 | DQ16 | DQ8
3A_T | 93 | IO | IOB |  | HPS_DDR | DIFF_IO_3A_T2n | No | A94 | DQ32 | DQ16 | DQ8
3A_T | 92 | IO | IOB |  | HPS_DDR | DIFF_IO_3A_T2p | No | B91 | DQ32 | DQ16 | DQ8
3A_T | 91 | IO | IOB |  | HPS_DDR | DIFF_IO_3A_T3n | No | A97 | DQSn32 | DQ16 | DQ8
3A_T | 90 | IO | IOB | AVST_READY | HPS_DDR | DIFF_IO_3A_T3p | No | B97 | DQS32 | DQ16 | DQ8
3A_T | 89 | IO | IOB |  | HPS_DDR | DIFF_IO_3A_T4n | No | B101 | DQSn33 | DQSn16/CQn16 | DQ8
3A_T | 88 | IO | IOB |  | HPS_DDR | DIFF_IO_3A_T4p | No | A101 | DQS33 | DQS16/CQ16 | DQ8
3A_T | 87 | IO | IOB |  | HPS_DDR | DIFF_IO_3A_T5n | Yes | A110 | DQ33 | DQ16 | DQ8
3A_T | 86 | IO | IOB |  | HPS_DDR | DIFF_IO_3A_T5p | Yes | B106 | DQ33 | DQ16 | DQ8
3A_T | 85 | IO | IOB |  | HPS_DDR | DIFF_IO_3A_T6n | No | B103 | DQ33 | DQ16 | DQ8
3A_T | 84 | IO | IOB |  | HPS_DDR | DIFF_IO_3A_T6p | No | A106 | DQ33 | DQ16 | DQ8
3A_T | 83 | IO | IOB | AVST_DATA10 | HPS_DDR | DIFF_IO_3A_T7n | No | D84 | DQ34 | DQ17 | DQ8
3A_T | 82 | IO | IOB | AVST_DATA9 | HPS_DDR | DIFF_IO_3A_T7p | No | F84 | DQ34 | DQ17 | DQ8
3A_T | 81 | IO | IOB | AVST_DATA8 | HPS_DDR | DIFF_IO_3A_T8n | No | M87 | DQ34 | DQ17 | DQ8
3A_T | 80 | IO | IOB | AVST_VALID | HPS_DDR | DIFF_IO_3A_T8p | No | K87 | DQ34 | DQ17 | DQ8
3A_T | 79 | IO | IOB | AVST_DATA7 | HPS_DDR | DIFF_IO_3A_T9n | No | F87 | DQSn34 | DQ17 | DQ8
3A_T | 78 | IO | IOB | AVST_DATA6 | HPS_DDR | DIFF_IO_3A_T9p | No | H87 | DQS34 | DQ17 | DQ8
3A_T | 77 | IO | IOB | AVST_DATA5 | HPS_DDR | DIFF_IO_3A_T10n | No | D95 | DQSn35 | DQSn17/CQn17 | DQSn8/CQn8
3A_T | 76 | IO | IOB | AVST_DATA4 | HPS_DDR | DIFF_IO_3A_T10p | No | F95 | DQS35 | DQS17/CQ17 | DQS8/CQ8
3A_T | 75 | IO | IOB | AVST_DATA3 | HPS_DDR | DIFF_IO_3A_T11n | Yes | K98 | DQ35 | DQ17 | DQ8
3A_T | 74 | IO | IOB | AVST_DATA2 | HPS_DDR | DIFF_IO_3A_T11p | Yes | M98 | DQ35 | DQ17 | DQ8
3A_T | 73 | IO | IOB | AVST_DATA1 | HPS_DDR | DIFF_IO_3A_T12n | No | F98 | DQ35 | DQ17 | DQ8
3A_T | 72 | IO | IOB | AVST_DATA0 | HPS_DDR | DIFF_IO_3A_T12p | No | H98 | DQ35 | DQ17 | DQ8
3A_T | 71 | IO | IOB |  | HPS_DDR | DIFF_IO_3A_T13n | No | P84 | DQ36 | DQ18 | DQ9
3A_T | 70 | IO | IOB |  | HPS_DDR | DIFF_IO_3A_T13p | No | T84 | DQ36 | DQ18 | DQ9
3A_T | 69 | IO | IOB |  | HPS_DDR | DIFF_IO_3A_T14n | No | M84 | DQ36 | DQ18 | DQ9
3A_T | 68 | IO | IOB |  | HPS_DDR | DIFF_IO_3A_T14p | No | K84 | DQ36 | DQ18 | DQ9
3A_T | 67 | IO | IOB |  | HPS_DDR | DIFF_IO_3A_T15n | No | T87 | DQSn36 | DQ18 | DQ9
3A_T | 66 | IO | IOB |  | HPS_DDR | DIFF_IO_3A_T15p | No | V87 | DQS36 | DQ18 | DQ9
3A_T | 65 | IO | IOB,PLL_3A_T_CLKOUT1n |  | HPS_DDR | DIFF_IO_3A_T16n | No | M95 | DQSn37 | DQSn18/CQn18 | DQ9
3A_T | 64 | IO | IOB,PLL_3A_T_CLKOUT1p,PLL_3A_T_CLKOUT1,PLL_3A_T_FB1 |  | HPS_DDR | DIFF_IO_3A_T16p | No | K95 | DQS37 | DQS18/CQ18 | DQ9
3A_T | 63 | IO | IOB |  | HPS_DDR | DIFF_IO_3A_T17n | Yes | T95 | DQ37 | DQ18 | DQ9
3A_T | 62 | IO | IOB,RZQ_T_3A |  | HPS_DDR | DIFF_IO_3A_T17p | Yes | P95 | DQ37 | DQ18 | DQ9
3A_T | 61 | IO | IOB,CLK_T_3A_1n |  | HPS_DDR | DIFF_IO_3A_T18n | No | T98 | DQ37 | DQ18 | DQ9
3A_T | 60 | IO | IOB,CLK_T_3A_1p |  | HPS_DDR | DIFF_IO_3A_T18p | No | V98 | DQ37 | DQ18 | DQ9
3A_T | 59 | IO | IOB,CLK_T_3A_0n |  | HPS_DDR | DIFF_IO_3A_T19n | No | Y84 | DQ38 | DQ19 | DQ9
3A_T | 58 | IO | IOB,CLK_T_3A_0p |  | HPS_DDR | DIFF_IO_3A_T19p | No | Y87 | DQ38 | DQ19 | DQ9
3A_T | 57 | IO | IOB |  | HPS_DDR | DIFF_IO_3A_T20n | No | Y95 | DQ38 | DQ19 | DQ9
3A_T | 56 | IO | IOB |  | HPS_DDR | DIFF_IO_3A_T20p | No | Y98 | DQ38 | DQ19 | DQ9
3A_T | 55 | IO | IOB,PLL_3A_T_CLKOUT0n |  | HPS_DDR | DIFF_IO_3A_T21n | No | AC86 | DQSn38 | DQ19 | DQ9
3A_T | 54 | IO | IOB,PLL_3A_T_CLKOUT0p,PLL_3A_T_CLKOUT0,PLL_3A_T_FB0 |  | HPS_DDR | DIFF_IO_3A_T21p | No | AC90 | DQS38 | DQ19 | DQ9
3A_T | 53 | IO | IOB | AVST_CLK | HPS_DDR | DIFF_IO_3A_T22n | No | AG93 | DQSn39 | DQSn19/CQn19 | DQSn9/CQn9
3A_T | 52 | IO | IOB | AVST_DATA15 | HPS_DDR | DIFF_IO_3A_T22p | No | AG90 | DQS39 | DQS19/CQ19 | DQS9/CQ9
3A_T | 51 | IO | IOB | AVST_DATA14 | HPS_DDR | DIFF_IO_3A_T23n | Yes | AC96 | DQ39 | DQ19 | DQ9
3A_T | 50 | IO | IOB | AVST_DATA13 | HPS_DDR | DIFF_IO_3A_T23p | Yes | AC100 | DQ39 | DQ19 | DQ9
3A_T | 49 | IO | IOB | AVST_DATA12 | HPS_DDR | DIFF_IO_3A_T24n | No | AG104 | DQ39 | DQ19 | DQ9
3A_T | 48 | IO | IOB | AVST_DATA11 | HPS_DDR | DIFF_IO_3A_T24p | No | AG100 | DQ39 | DQ19 | DQ9
3A_B | 47 | IO | IOB |  | HPS_DDR | DIFF_IO_3A_B1n | No | AB105 | DQ40 | DQ20 | DQ10
3A_B | 46 | IO | IOB |  | HPS_DDR | DIFF_IO_3A_B1p | No | Y105 | DQ40 | DQ20 | DQ10
3A_B | 45 | IO | IOB |  | HPS_DDR | DIFF_IO_3A_B2n | No | AB108 | DQ40 | DQ20 | DQ10
3A_B | 44 | IO | IOB |  | HPS_DDR | DIFF_IO_3A_B2p | No | Y108 | DQ40 | DQ20 | DQ10
3A_B | 43 | IO | IOB |  | HPS_DDR | DIFF_IO_3A_B3n | No | AK104 | DQSn40 | DQ20 | DQ10
3A_B | 42 | IO | IOB |  | HPS_DDR | DIFF_IO_3A_B3p | No | AK107 | DQS40 | DQ20 | DQ10
3A_B | 41 | IO | IOB,PLL_3A_B_CLKOUT1n |  | HPS_DDR | DIFF_IO_3A_B4n | No | AB114 | DQSn41 | DQSn20/CQn20 | DQ10
3A_B | 40 | IO | IOB,PLL_3A_B_CLKOUT1p,PLL_3A_B_CLKOUT1,PLL_3A_B_FB1 |  | HPS_DDR | DIFF_IO_3A_B4p | No | Y114 | DQS41 | DQS20/CQ20 | DQ10
3A_B | 39 | IO | IOB |  | HPS_DDR | DIFF_IO_3A_B5n | Yes | AG111 | DQ41 | DQ20 | DQ10
3A_B | 38 | IO | IOB,RZQ_B_3A |  | HPS_DDR | DIFF_IO_3A_B5p | Yes | AK111 | DQ41 | DQ20 | DQ10
3A_B | 37 | IO | IOB,CLK_B_3A_1n |  | HPS_DDR | DIFF_IO_3A_B6n | Yes | Y117 | DQ41 | DQ20 | DQ10
3A_B | 36 | IO | IOB,CLK_B_3A_1p |  | HPS_DDR | DIFF_IO_3A_B6p | Yes | AB117 | DQ41 | DQ20 | DQ10
3A_B | 35 | IO | IOB,CLK_B_3A_0n |  | HPS_DDR | DIFF_IO_3A_B7n | No | K105 | DQ42 | DQ21 | DQ10
3A_B | 34 | IO | IOB,CLK_B_3A_0p |  | HPS_DDR | DIFF_IO_3A_B7p | No | M105 | DQ42 | DQ21 | DQ10
3A_B | 33 | IO | IOB |  | HPS_DDR | DIFF_IO_3A_B8n | No | P105 | DQ42 | DQ21 | DQ10
3A_B | 32 | IO | IOB |  | HPS_DDR | DIFF_IO_3A_B8p | No | T105 | DQ42 | DQ21 | DQ10
3A_B | 31 | IO | IOB,PLL_3A_B_CLKOUT0n |  | HPS_DDR | DIFF_IO_3A_B9n | No | T108 | DQSn42 | DQ21 | DQ10
3A_B | 30 | IO | IOB,PLL_3A_B_CLKOUT0p,PLL_3A_B_CLKOUT0,PLL_3A_B_FB0 |  | HPS_DDR | DIFF_IO_3A_B9p | No | V108 | DQS42 | DQ21 | DQ10
3A_B | 29 | IO | IOB |  | HPS_DDR | DIFF_IO_3A_B10n | No | K114 | DQSn43 | DQSn21/CQn21 | DQSn10/CQn10
3A_B | 28 | IO | IOB |  | HPS_DDR | DIFF_IO_3A_B10p | No | M114 | DQS43 | DQS21/CQ21 | DQS10/CQ10
3A_B | 27 | IO | IOB |  | HPS_DDR | DIFF_IO_3A_B11n | Yes | T117 | DQ43 | DQ21 | DQ10
3A_B | 26 | IO | IOB |  | HPS_DDR | DIFF_IO_3A_B11p | Yes | V117 | DQ43 | DQ21 | DQ10
3A_B | 25 | IO | IOB |  | HPS_DDR | DIFF_IO_3A_B12n | Yes | P114 | DQ43 | DQ21 | DQ10
3A_B | 24 | IO | IOB |  | HPS_DDR | DIFF_IO_3A_B12p | Yes | T114 | DQ43 | DQ21 | DQ10
3A_B | 23 | IO | IOB |  | HPS_DDR | DIFF_IO_3A_B13n | No | K108 | DQ44 | DQ22 | DQ11
3A_B | 22 | IO | IOB |  | HPS_DDR | DIFF_IO_3A_B13p | No | M108 | DQ44 | DQ22 | DQ11
3A_B | 21 | IO | IOB |  | HPS_DDR | DIFF_IO_3A_B14n | No | F108 | DQ44 | DQ22 | DQ11
3A_B | 20 | IO | IOB |  | HPS_DDR | DIFF_IO_3A_B14p | No | H108 | DQ44 | DQ22 | DQ11
3A_B | 19 | IO | IOB |  | HPS_DDR | DIFF_IO_3A_B15n | No | D105 | DQSn44 | DQ22 | DQ11
3A_B | 18 | IO | IOB |  | HPS_DDR | DIFF_IO_3A_B15p | No | F105 | DQS44 | DQ22 | DQ11
3A_B | 17 | IO | IOB |  | HPS_DDR | DIFF_IO_3A_B16n | No | D114 | DQSn45 | DQSn22/CQn22 | DQ11
3A_B | 16 | IO | IOB |  | HPS_DDR | DIFF_IO_3A_B16p | No | F114 | DQS45 | DQS22/CQ22 | DQ11
3A_B | 15 | IO | IOB |  | HPS_DDR | DIFF_IO_3A_B17n | Yes | M117 | DQ45 | DQ22 | DQ11
3A_B | 14 | IO | IOB |  | HPS_DDR | DIFF_IO_3A_B17p | Yes | K117 | DQ45 | DQ22 | DQ11
3A_B | 13 | IO | IOB |  | HPS_DDR | DIFF_IO_3A_B18n | Yes | H117 | DQ45 | DQ22 | DQ11
3A_B | 12 | IO | IOB |  | HPS_DDR | DIFF_IO_3A_B18p | Yes | F117 | DQ45 | DQ22 | DQ11
3A_B | 11 | IO | IOB |  | HPS_DDR | DIFF_IO_3A_B19n | No | A113 | DQ46 | DQ23 | DQ11
3A_B | 10 | IO | IOB |  | HPS_DDR | DIFF_IO_3A_B19p | No | B113 | DQ46 | DQ23 | DQ11
3A_B | 9 | IO | IOB |  | HPS_DDR | DIFF_IO_3A_B20n | No | A116 | DQ46 | DQ23 | DQ11
3A_B | 8 | IO | IOB |  | HPS_DDR | DIFF_IO_3A_B20p | No | B116 | DQ46 | DQ23 | DQ11
3A_B | 7 | IO | IOB |  | HPS_DDR | DIFF_IO_3A_B21n | No | A122 | DQSn46 | DQ23 | DQ11
3A_B | 6 | IO | IOB |  | HPS_DDR | DIFF_IO_3A_B21p | No | B119 | DQS46 | DQ23 | DQ11
3A_B | 5 | IO | IOB |  | HPS_DDR | DIFF_IO_3A_B22n | No | A125 | DQSn47 | DQSn23/CQn23 | DQSn11/CQn11
3A_B | 4 | IO | IOB |  | HPS_DDR | DIFF_IO_3A_B22p | No | B122 | DQS47 | DQS23/CQ23 | DQS11/CQ11
3A_B | 3 | IO | IOB |  | HPS_DDR | DIFF_IO_3A_B23n | Yes | A130 | DQ47 | DQ23 | DQ11
3A_B | 2 | IO | IOB |  | HPS_DDR | DIFF_IO_3A_B23p | Yes | B130 | DQ47 | DQ23 | DQ11
3A_B | 1 | IO | IOB |  | HPS_DDR | DIFF_IO_3A_B24n | Yes | A128 | DQ47 | DQ23 | DQ11
3A_B | 0 | IO | IOB |  | HPS_DDR | DIFF_IO_3A_B24p | Yes | B128 | DQ47 | DQ23 | DQ11
3B_T | 95 | IO | IOB |  | HPS_DDR | DIFF_IO_3B_T1n | No | B42 | DQ48 | DQ24 | DQ12
3B_T | 94 | IO | IOB |  | HPS_DDR | DIFF_IO_3B_T1p | No | A45 | DQ48 | DQ24 | DQ12
3B_T | 93 | IO | IOB |  | HPS_DDR | DIFF_IO_3B_T2n | No | A48 | DQ48 | DQ24 | DQ12
3B_T | 92 | IO | IOB |  | HPS_DDR | DIFF_IO_3B_T2p | No | B45 | DQ48 | DQ24 | DQ12
3B_T | 91 | IO | IOB |  | HPS_DDR | DIFF_IO_3B_T3n | No | A51 | DQSn48 | DQ24 | DQ12
3B_T | 90 | IO | IOB |  | HPS_DDR | DIFF_IO_3B_T3p | No | B51 | DQS48 | DQ24 | DQ12
3B_T | 89 | IO | IOB |  | HPS_DDR | DIFF_IO_3B_T4n | No | B54 | DQSn49 | DQSn24/CQn24 | DQ12
3B_T | 88 | IO | IOB |  | HPS_DDR | DIFF_IO_3B_T4p | No | A54 | DQS49 | DQS24/CQ24 | DQ12
3B_T | 87 | IO | IOB |  | HPS_DDR | DIFF_IO_3B_T5n | Yes | B60 | DQ49 | DQ24 | DQ12
3B_T | 86 | IO | IOB |  | HPS_DDR | DIFF_IO_3B_T5p | Yes | A63 | DQ49 | DQ24 | DQ12
3B_T | 85 | IO | IOB |  | HPS_DDR | DIFF_IO_3B_T6n | No | A60 | DQ49 | DQ24 | DQ12
3B_T | 84 | IO | IOB |  | HPS_DDR | DIFF_IO_3B_T6p | No | B56 | DQ49 | DQ24 | DQ12
3B_T | 83 | IO | IOB |  | HPS_DDR | DIFF_IO_3B_T7n | No | F44 | DQ50 | DQ25 | DQ12
3B_T | 82 | IO | IOB |  | HPS_DDR | DIFF_IO_3B_T7p | No | D44 | DQ50 | DQ25 | DQ12
3B_T | 81 | IO | IOB |  | HPS_DDR | DIFF_IO_3B_T8n | No | H47 | DQ50 | DQ25 | DQ12
3B_T | 80 | IO | IOB |  | HPS_DDR | DIFF_IO_3B_T8p | No | F47 | DQ50 | DQ25 | DQ12
3B_T | 79 | IO | IOB |  | HPS_DDR | DIFF_IO_3B_T9n | No | K47 | DQSn50 | DQ25 | DQ12
3B_T | 78 | IO | IOB |  | HPS_DDR | DIFF_IO_3B_T9p | No | M47 | DQS50 | DQ25 | DQ12
3B_T | 77 | IO | IOB |  | HPS_DDR | DIFF_IO_3B_T10n | No | D55 | DQSn51 | DQSn25/CQn25 | DQSn12/CQn12
3B_T | 76 | IO | IOB |  | HPS_DDR | DIFF_IO_3B_T10p | No | F55 | DQS51 | DQS25/CQ25 | DQS12/CQ12
3B_T | 75 | IO | IOB |  | HPS_DDR | DIFF_IO_3B_T11n | Yes | K58 | DQ51 | DQ25 | DQ12
3B_T | 74 | IO | IOB |  | HPS_DDR | DIFF_IO_3B_T11p | Yes | M58 | DQ51 | DQ25 | DQ12
3B_T | 73 | IO | IOB |  | HPS_DDR | DIFF_IO_3B_T12n | No | F58 | DQ51 | DQ25 | DQ12
3B_T | 72 | IO | IOB |  | HPS_DDR | DIFF_IO_3B_T12p | No | H58 | DQ51 | DQ25 | DQ12
3B_T | 71 | IO | IOB |  | HPS_DDR | DIFF_IO_3B_T13n | No | M44 | DQ52 | DQ26 | DQ13
3B_T | 70 | IO | IOB |  | HPS_DDR | DIFF_IO_3B_T13p | No | K44 | DQ52 | DQ26 | DQ13
3B_T | 69 | IO | IOB |  | HPS_DDR | DIFF_IO_3B_T14n | No | T44 | DQ52 | DQ26 | DQ13
3B_T | 68 | IO | IOB |  | HPS_DDR | DIFF_IO_3B_T14p | No | P44 | DQ52 | DQ26 | DQ13
3B_T | 67 | IO | IOB |  | HPS_DDR | DIFF_IO_3B_T15n | No | T47 | DQSn52 | DQ26 | DQ13
3B_T | 66 | IO | IOB |  | HPS_DDR | DIFF_IO_3B_T15p | No | V47 | DQS52 | DQ26 | DQ13
3B_T | 65 | IO | IOB,PLL_3B_T_CLKOUT1n |  | HPS_DDR | DIFF_IO_3B_T16n | No | M55 | DQSn53 | DQSn26/CQn26 | DQ13
3B_T | 64 | IO | IOB,PLL_3B_T_CLKOUT1p,PLL_3B_T_CLKOUT1,PLL_3B_T_FB1 |  | HPS_DDR | DIFF_IO_3B_T16p | No | K55 | DQS53 | DQS26/CQ26 | DQ13
3B_T | 63 | IO | IOB |  | HPS_DDR | DIFF_IO_3B_T17n | Yes | T58 | DQ53 | DQ26 | DQ13
3B_T | 62 | IO | IOB,RZQ_T_3B |  | HPS_DDR | DIFF_IO_3B_T17p | Yes | V58 | DQ53 | DQ26 | DQ13
3B_T | 61 | IO | IOB,CLK_T_3B_1n |  | HPS_DDR | DIFF_IO_3B_T18n | No | T55 | DQ53 | DQ26 | DQ13
3B_T | 60 | IO | IOB,CLK_T_3B_1p |  | HPS_DDR | DIFF_IO_3B_T18p | No | P55 | DQ53 | DQ26 | DQ13
3B_T | 59 | IO | IOB,CLK_T_3B_0n |  | HPS_DDR | DIFF_IO_3B_T19n | No | Y47 | DQ54 | DQ27 | DQ13
3B_T | 58 | IO | IOB,CLK_T_3B_0p |  | HPS_DDR | DIFF_IO_3B_T19p | No | Y44 | DQ54 | DQ27 | DQ13
3B_T | 57 | IO | IOB |  | HPS_DDR | DIFF_IO_3B_T20n | No | Y55 | DQ54 | DQ27 | DQ13
3B_T | 56 | IO | IOB |  | HPS_DDR | DIFF_IO_3B_T20p | No | Y58 | DQ54 | DQ27 | DQ13
3B_T | 55 | IO | IOB,PLL_3B_T_CLKOUT0n |  | HPS_DDR | DIFF_IO_3B_T21n | No | AC50 | DQSn54 | DQ27 | DQ13
3B_T | 54 | IO | IOB,PLL_3B_T_CLKOUT0p,PLL_3B_T_CLKOUT0,PLL_3B_T_FB0 |  | HPS_DDR | DIFF_IO_3B_T21p | No | AC53 | DQS54 | DQ27 | DQ13
3B_T | 53 | IO | IOB |  | HPS_DDR | DIFF_IO_3B_T22n | No | AG53 | DQSn55 | DQSn27/CQn27 | DQSn13/CQn13
3B_T | 52 | IO | IOB |  | HPS_DDR | DIFF_IO_3B_T22p | No | AG57 | DQS55 | DQS27/CQ27 | DQS13/CQ13
3B_T | 51 | IO | IOB |  | HPS_DDR | DIFF_IO_3B_T23n | Yes | AC61 | DQ55 | DQ27 | DQ13
3B_T | 50 | IO | IOB |  | HPS_DDR | DIFF_IO_3B_T23p | Yes | AG61 | DQ55 | DQ27 | DQ13
3B_T | 49 | IO | IOB |  | HPS_DDR | DIFF_IO_3B_T24n | No | AG64 | DQ55 | DQ27 | DQ13
3B_T | 48 | IO | IOB |  | HPS_DDR | DIFF_IO_3B_T24p | No | AC64 | DQ55 | DQ27 | DQ13
3B_B | 47 | IO | IOB |  | HPS_DDR | DIFF_IO_3B_B1n | No | Y65 | DQ56 | DQ28 | DQ14
3B_B | 46 | IO | IOB |  | HPS_DDR | DIFF_IO_3B_B1p | No | Y67 | DQ56 | DQ28 | DQ14
3B_B | 45 | IO | IOB |  | HPS_DDR | DIFF_IO_3B_B2n | No | Y74 | DQ56 | DQ28 | DQ14
3B_B | 44 | IO | IOB |  | HPS_DDR | DIFF_IO_3B_B2p | No | Y77 | DQ56 | DQ28 | DQ14
3B_B | 43 | IO | IOB |  | HPS_DDR | DIFF_IO_3B_B3n | No | AC83 | DQSn56 | DQ28 | DQ14
3B_B | 42 | IO | IOB |  | HPS_DDR | DIFF_IO_3B_B3p | No | AG83 | DQS56 | DQ28 | DQ14
3B_B | 41 | IO | IOB,PLL_3B_B_CLKOUT1n |  | HPS_DDR | DIFF_IO_3B_B4n | No | AG75 | DQSn57 | DQSn28/CQn28 | DQ14
3B_B | 40 | IO | IOB,PLL_3B_B_CLKOUT1p,PLL_3B_B_CLKOUT1,PLL_3B_B_FB1 |  | HPS_DDR | DIFF_IO_3B_B4p | No | AG72 | DQS57 | DQS28/CQ28 | DQ14
3B_B | 39 | IO | IOB |  | HPS_DDR | DIFF_IO_3B_B5n | Yes | AG79 | DQ57 | DQ28 | DQ14
3B_B | 38 | IO | IOB,RZQ_B_3B |  | HPS_DDR | DIFF_IO_3B_B5p | Yes | AC79 | DQ57 | DQ28 | DQ14
3B_B | 37 | IO | IOB,CLK_B_3B_1n |  | HPS_DDR | DIFF_IO_3B_B6n | Yes | AC72 | DQ57 | DQ28 | DQ14
3B_B | 36 | IO | IOB,CLK_B_3B_1p |  | HPS_DDR | DIFF_IO_3B_B6p | Yes | AC68 | DQ57 | DQ28 | DQ14
3B_B | 35 | IO | IOB,CLK_B_3B_0n |  | HPS_DDR | DIFF_IO_3B_B7n | No | P65 | DQ58 | DQ29 | DQ14
3B_B | 34 | IO | IOB,CLK_B_3B_0p |  | HPS_DDR | DIFF_IO_3B_B7p | No | T65 | DQ58 | DQ29 | DQ14
3B_B | 33 | IO | IOB |  | HPS_DDR | DIFF_IO_3B_B8n | No | K65 | DQ58 | DQ29 | DQ14
3B_B | 32 | IO | IOB |  | HPS_DDR | DIFF_IO_3B_B8p | No | M65 | DQ58 | DQ29 | DQ14
3B_B | 31 | IO | IOB,PLL_3B_B_CLKOUT0n |  | HPS_DDR | DIFF_IO_3B_B9n | No | T67 | DQSn58 | DQ29 | DQ14
3B_B | 30 | IO | IOB,PLL_3B_B_CLKOUT0p,PLL_3B_B_CLKOUT0,PLL_3B_B_FB0 |  | HPS_DDR | DIFF_IO_3B_B9p | No | V67 | DQS58 | DQ29 | DQ14
3B_B | 29 | IO | IOB |  | HPS_DDR | DIFF_IO_3B_B10n | No | K74 | DQSn59 | DQSn29/CQn29 | DQSn14/CQn14
3B_B | 28 | IO | IOB |  | HPS_DDR | DIFF_IO_3B_B10p | No | M74 | DQS59 | DQS29/CQ29 | DQS14/CQ14
3B_B | 27 | IO | IOB |  | HPS_DDR | DIFF_IO_3B_B11n | Yes | T77 | DQ59 | DQ29 | DQ14
3B_B | 26 | IO | IOB |  | HPS_DDR | DIFF_IO_3B_B11p | Yes | V77 | DQ59 | DQ29 | DQ14
3B_B | 25 | IO | IOB |  | HPS_DDR | DIFF_IO_3B_B12n | Yes | T74 | DQ59 | DQ29 | DQ14
3B_B | 24 | IO | IOB |  | HPS_DDR | DIFF_IO_3B_B12p | Yes | P74 | DQ59 | DQ29 | DQ14
3B_B | 23 | IO | IOB |  | HPS_DDR | DIFF_IO_3B_B13n | No | D65 | DQ60 | DQ30 | DQ15
3B_B | 22 | IO | IOB |  | HPS_DDR | DIFF_IO_3B_B13p | No | F65 | DQ60 | DQ30 | DQ15
3B_B | 21 | IO | IOB |  | HPS_DDR | DIFF_IO_3B_B14n | No | F67 | DQ60 | DQ30 | DQ15
3B_B | 20 | IO | IOB |  | HPS_DDR | DIFF_IO_3B_B14p | No | H67 | DQ60 | DQ30 | DQ15
3B_B | 19 | IO | IOB |  | HPS_DDR | DIFF_IO_3B_B15n | No | K67 | DQSn60 | DQ30 | DQ15
3B_B | 18 | IO | IOB |  | HPS_DDR | DIFF_IO_3B_B15p | No | M67 | DQS60 | DQ30 | DQ15
3B_B | 17 | IO | IOB |  | HPS_DDR | DIFF_IO_3B_B16n | No | F74 | DQSn61 | DQSn30/CQn30 | DQ15
3B_B | 16 | IO | IOB |  | HPS_DDR | DIFF_IO_3B_B16p | No | D74 | DQS61 | DQS30/CQ30 | DQ15
3B_B | 15 | IO | IOB |  | HPS_DDR | DIFF_IO_3B_B17n | Yes | H77 | DQ61 | DQ30 | DQ15
3B_B | 14 | IO | IOB |  | HPS_DDR | DIFF_IO_3B_B17p | Yes | F77 | DQ61 | DQ30 | DQ15
3B_B | 13 | IO | IOB |  | HPS_DDR | DIFF_IO_3B_B18n | Yes | M77 | DQ61 | DQ30 | DQ15
3B_B | 12 | IO | IOB |  | HPS_DDR | DIFF_IO_3B_B18p | Yes | K77 | DQ61 | DQ30 | DQ15
3B_B | 11 | IO | IOB |  | HPS_DDR | DIFF_IO_3B_B19n | No | A66 | DQ62 | DQ31 | DQ15
3B_B | 10 | IO | IOB |  | HPS_DDR | DIFF_IO_3B_B19p | No | B66 | DQ62 | DQ31 | DQ15
3B_B | 9 | IO | IOB |  | HPS_DDR | DIFF_IO_3B_B20n | No | A70 | DQ62 | DQ31 | DQ15
3B_B | 8 | IO | IOB |  | HPS_DDR | DIFF_IO_3B_B20p | No | B70 | DQ62 | DQ31 | DQ15
3B_B | 7 | IO | IOB |  | HPS_DDR | DIFF_IO_3B_B21n | No | A76 | DQSn62 | DQ31 | DQ15
3B_B | 6 | IO | IOB |  | HPS_DDR | DIFF_IO_3B_B21p | No | B73 | DQS62 | DQ31 | DQ15
3B_B | 5 | IO | IOB |  | HPS_DDR | DIFF_IO_3B_B22n | No | B76 | DQSn63 | DQSn31/CQn31 | DQSn15/CQn15
3B_B | 4 | IO | IOB |  | HPS_DDR | DIFF_IO_3B_B22p | No | A80 | DQS63 | DQS31/CQ31 | DQS15/CQ15
3B_B | 3 | IO | IOB |  | HPS_DDR | DIFF_IO_3B_B23n | Yes | A85 | DQ63 | DQ31 | DQ15
3B_B | 2 | IO | IOB |  | HPS_DDR | DIFF_IO_3B_B23p | Yes | B85 | DQ63 | DQ31 | DQ15
3B_B | 1 | IO | IOB |  | HPS_DDR | DIFF_IO_3B_B24n | Yes | B82 | DQ63 | DQ31 | DQ15
3B_B | 0 | IO | IOB |  | HPS_DDR | DIFF_IO_3B_B24p | Yes | A82 | DQ63 | DQ31 | DQ15
5A |  | IO | HVIO_5A_1,TXCLK1,Data_Ctrl1 |  |  |  |  | CD134
5A |  | IO | HVIO_5A_2,TXCLK2,Data_Ctrl2 |  |  |  |  | CD135
5A |  | IO | HVIO_5A_3,TXCLK3,Data_Ctrl3 |  |  |  |  | CG134
5A |  | IO | HVIO_5A_4,TXCLK4,Data_Ctrl4 |  |  |  |  | CG135
5A |  | IO | HVIO_5A_5,PIN_PERST_N_CVP_L1A_0,TXCLK5,Data_Ctrl5 |  |  |  |  | CH132
5A |  | IO | HVIO_5A_6,PIN_PERST_N_CVP_L1B_0,TXCLK6,Data_Ctrl6 |  |  |  |  | CF132
5A |  | IO | HVIO_5A_7,PIN_PERST_N_CVP_L1C_0,TXCLK7,Data_Ctrl7 |  |  |  |  | CF128
5A |  | IO | HVIO_5A_8,TXCLK8,Data_Ctrl8 |  |  |  |  | CK134
5A |  | IO | HVIO_5A_9,PLLREFCLK1,TXCLK9,RXCLK1,Data_Ctrl9 |  |  |  |  | CH128
5A |  | IO | HVIO_5A_10,PLLREFCLK2,TXCLK10,RXCLK2,Data_Ctrl10 |  |  |  |  | CL125
5A |  | IO | HVIO_5A_11,SOURCE_SYNC_CLK1,TXCLK11,RXCLK3,Data_Ctrl11 |  |  |  |  | CF121
5A |  | IO | HVIO_5A_12,SOURCE_SYNC_CLK2,TXCLK12,RXCLK4,Data_Ctrl12 |  |  |  |  | CF118
5A |  | IO | HVIO_5A_13,TXCLK13,Data_Ctrl13 |  |  |  |  | BU118
5A |  | IO | HVIO_5A_14,TXCLK14,Data_Ctrl14 |  |  |  |  | BR118
5A |  | IO | HVIO_5A_15,TXCLK15,Data_Ctrl15 |  |  |  |  | CA118
5A |  | IO | HVIO_5A_16,TXCLK16,Data_Ctrl16 |  |  |  |  | BW118
5A |  | IO | HVIO_5A_17,TXCLK17,Data_Ctrl17 |  |  |  |  | CL128
5A |  | IO | HVIO_5A_18,TXCLK18,Data_Ctrl18 |  |  |  |  | CL130
5A |  | IO | HVIO_5A_19,TXCLK19,Data_Ctrl19 |  |  |  |  | CK125
5A |  | IO | HVIO_5A_20,TXCLK20,Data_Ctrl20 |  |  |  |  | CK128
5B |  | IO | HVIO_5B_1,SYSPLLREFCLK_L1A_0,TXCLK1,Data_Ctrl1 |  |  |  |  | BF111
5B |  | IO | HVIO_5B_2,SYSPLLREFCLK_L1A_1,TXCLK2,Data_Ctrl2 |  |  |  |  | BH109
5B |  | IO | HVIO_5B_3,SYSPLLREFCLK_L1B_0,TXCLK3,Data_Ctrl3 |  |  |  |  | BE115
5B |  | IO | HVIO_5B_4,SYSPLLREFCLK_L1B_1,TXCLK4,Data_Ctrl4 |  |  |  |  | BF115
5B |  | IO | HVIO_5B_5,PIN_PERST_N_CVP_L1A_1,TXCLK5,Data_Ctrl5 |  |  |  |  | BF107
5B |  | IO | HVIO_5B_6,PIN_PERST_N_CVP_L1B_1,TXCLK6,Data_Ctrl6 |  |  |  |  | BU109
5B |  | IO | HVIO_5B_7,PIN_PERST_N_CVP_L1C_1,TXCLK7,Data_Ctrl7 |  |  |  |  | BF104
5B |  | IO | HVIO_5B_8,TXCLK8,Data_Ctrl8 |  |  |  |  | BR109
5B |  | IO | HVIO_5B_9,PLLREFCLK1,TXCLK9,RXCLK1,Data_Ctrl9 |  |  |  |  | BE107
5B |  | IO | HVIO_5B_10,PLLREFCLK2,TXCLK10,RXCLK2,Data_Ctrl10 |  |  |  |  | BK109
5B |  | IO | HVIO_5B_11,SOURCE_SYNC_CLK1,TXCLK11,RXCLK3,Data_Ctrl11 |  |  |  |  | BE111
5B |  | IO | HVIO_5B_12,SOURCE_SYNC_CLK2,TXCLK12,RXCLK4,Data_Ctrl12 |  |  |  |  | BM109
5B |  | IO | HVIO_5B_13,TXCLK13,Data_Ctrl13 |  |  |  |  | BR112
5B |  | IO | HVIO_5B_14,TXCLK14,Data_Ctrl14 |  |  |  |  | BK118
5B |  | IO | HVIO_5B_15,TXCLK15,Data_Ctrl15 |  |  |  |  | BM118
5B |  | IO | HVIO_5B_16,TXCLK16,Data_Ctrl16 |  |  |  |  | BP112
5B |  | IO | HVIO_5B_17,TXCLK17,Data_Ctrl17 |  |  |  |  | BM112
5B |  | IO | HVIO_5B_18,TXCLK18,Data_Ctrl18 |  |  |  |  | BK112
5B |  | IO | HVIO_5B_19,SYSPLLREFCLK_L1C_0,TXCLK19,Data_Ctrl19 |  |  |  |  | BH118
5B |  | IO | HVIO_5B_20,TXCLK20,Data_Ctrl20 |  |  |  |  | BF120
6A |  | IO | HVIO_6A_1,SYSPLLREFCLK_R4A_0,TXCLK1,Data_Ctrl1 |  |  |  |  | BU28
6A |  | IO | HVIO_6A_2,SYSPLLREFCLK_R4A_1,TXCLK2,Data_Ctrl2 |  |  |  |  | BP31
6A |  | IO | HVIO_6A_3,SYSPLLREFCLK_R4B_0,TXCLK3,Data_Ctrl3 |  |  |  |  | BR28
6A |  | IO | HVIO_6A_4,SYSPLLREFCLK_R4B_1,TXCLK4,Data_Ctrl4 |  |  |  |  | BR31
6A |  | IO | HVIO_6A_5,PIN_PERST_N_R4A_0,TXCLK5,Data_Ctrl5 |  |  |  |  | BU31
6A |  | IO | HVIO_6A_6,PIN_PERST_N_R4B_0,TXCLK6,Data_Ctrl6 |  |  |  |  | BM28
6A |  | IO | HVIO_6A_7,PIN_PERST_N_R4C_0,TXCLK7,Data_Ctrl7 |  |  |  |  | BW28
6A |  | IO | HVIO_6A_8,TXCLK8,Data_Ctrl8 |  |  |  |  | BM31
6A |  | IO | HVIO_6A_9,PLLREFCLK1,TXCLK9,RXCLK1,Data_Ctrl9 |  |  |  |  | BK31
6A |  | IO | HVIO_6A_10,PLLREFCLK2,TXCLK10,RXCLK2,Data_Ctrl10 |  |  |  |  | BP22
6A |  | IO | HVIO_6A_11,SOURCE_SYNC_CLK1,TXCLK11,RXCLK3,Data_Ctrl11 |  |  |  |  | BK28
6A |  | IO | HVIO_6A_12,SOURCE_SYNC_CLK2,TXCLK12,RXCLK4,Data_Ctrl12 |  |  |  |  | BR22
6A |  | IO | HVIO_6A_13,TXCLK13,Data_Ctrl13 |  |  |  |  | CH12
6A |  | IO | HVIO_6A_14,TXCLK14,Data_Ctrl14 |  |  |  |  | BU22
6A |  | IO | HVIO_6A_15,TXCLK15,Data_Ctrl15 |  |  |  |  | BW19
6A |  | IO | HVIO_6A_16,TXCLK16,Data_Ctrl16 |  |  |  |  | BH28
6A |  | IO | HVIO_6A_17,TXCLK17,Data_Ctrl17 |  |  |  |  | BM22
6A |  | IO | HVIO_6A_18,TXCLK18,Data_Ctrl18 |  |  |  |  | CF12
6A |  | IO | HVIO_6A_19,SYSPLLREFCLK_R4C_0,TXCLK19,Data_Ctrl19 |  |  |  |  | BK19
6A |  | IO | HVIO_6A_20,TXCLK20,Data_Ctrl20 |  |  |  |  | CF9
6B |  | IO | HVIO_6B_1,TXCLK1,Data_Ctrl1 |  |  |  |  | BF21
6B |  | IO | HVIO_6B_2,TXCLK2,Data_Ctrl2 |  |  |  |  | BE21
6B |  | IO | HVIO_6B_3,TXCLK3,Data_Ctrl3 |  |  |  |  | BE43
6B |  | IO | HVIO_6B_4,TXCLK4,Data_Ctrl4 |  |  |  |  | BF40
6B |  | IO | HVIO_6B_5,PIN_PERST_N_R4A_1,TXCLK5,Data_Ctrl5 |  |  |  |  | BE29
6B |  | IO | HVIO_6B_6,PIN_PERST_N_R4B_1,TXCLK6,Data_Ctrl6 |  |  |  |  | BE25
6B |  | IO | HVIO_6B_7,PIN_PERST_N_R4C_1,TXCLK7,Data_Ctrl7 |  |  |  |  | BF32
6B |  | IO | HVIO_6B_8,TXCLK8,Data_Ctrl8 |  |  |  |  | BF36
6B |  | IO | HVIO_6B_9,PLLREFCLK1,TXCLK9,RXCLK1,Data_Ctrl9 |  |  |  |  | BF29
6B |  | IO | HVIO_6B_10,PLLREFCLK2,TXCLK10,RXCLK2,Data_Ctrl10 |  |  |  |  | BF25
6B |  | IO | HVIO_6B_11,SOURCE_SYNC_CLK1,TXCLK11,RXCLK3,Data_Ctrl11 |  |  |  |  | BF16
6B |  | IO | HVIO_6B_12,SOURCE_SYNC_CLK2,TXCLK12,RXCLK4,Data_Ctrl12 |  |  |  |  | BH19
6B |  | IO | HVIO_6B_13,TXCLK13,Data_Ctrl13 |  |  |  |  | BK22
6B |  | IO | HVIO_6B_14,TXCLK14,Data_Ctrl14 |  |  |  |  | BM19
6B |  | IO | HVIO_6B_15,TXCLK15,Data_Ctrl15 |  |  |  |  | BU19
6B |  | IO | HVIO_6B_16,TXCLK16,Data_Ctrl16 |  |  |  |  | BR19
6B |  | IO | HVIO_6B_17,TXCLK17,Data_Ctrl17 |  |  |  |  | CK2
6B |  | IO | HVIO_6B_18,TXCLK18,Data_Ctrl18 |  |  |  |  | CJ2
6B |  | IO | HVIO_6B_19,TXCLK19,Data_Ctrl19 |  |  |  |  | CK4
6B |  | IO | HVIO_6B_20,TXCLK20,Data_Ctrl20 |  |  |  |  | CH4
6C |  | IO | HVIO_6C_1,TXCLK1,Data_Ctrl1 |  |  |  |  | F27
6C |  | IO | HVIO_6C_2,TXCLK2,Data_Ctrl2 |  |  |  |  | F24
6C |  | IO | HVIO_6C_3,TXCLK3,Data_Ctrl3 |  |  |  |  | H27
6C |  | IO | HVIO_6C_4,TXCLK4,Data_Ctrl4 |  |  |  |  | D24
6C |  | IO | HVIO_6C_5,TXCLK5,Data_Ctrl5 |  |  |  |  | H18
6C |  | IO | HVIO_6C_6,TXCLK6,Data_Ctrl6 |  |  |  |  | D15
6C |  | IO | HVIO_6C_7,TXCLK7,Data_Ctrl7 |  |  |  |  | F18
6C |  | IO | HVIO_6C_8,TXCLK8,Data_Ctrl8 |  |  |  |  | F15
6C |  | IO | HVIO_6C_9,PLLREFCLK1,TXCLK9,RXCLK1,Data_Ctrl9 |  |  |  |  | D8
6C |  | IO | HVIO_6C_10,PLLREFCLK2,TXCLK10,RXCLK2,Data_Ctrl10 |  |  |  |  | K8
6C |  | IO | HVIO_6C_11,SOURCE_SYNC_CLK1,TXCLK11,RXCLK3,Data_Ctrl11 |  |  |  |  | F8
6C |  | IO | HVIO_6C_12,SOURCE_SYNC_CLK2,TXCLK12,RXCLK4,Data_Ctrl12 |  |  |  |  | H8
6C |  | IO | HVIO_6C_13,TXCLK13,Data_Ctrl13 |  |  |  |  | C2
6C |  | IO | HVIO_6C_14,TXCLK14,Data_Ctrl14 |  |  |  |  | D4
6C |  | IO | HVIO_6C_15,TXCLK15,Data_Ctrl15 |  |  |  |  | F4
6C |  | IO | HVIO_6C_16,TXCLK16,Data_Ctrl16 |  |  |  |  | K4
6C |  | IO | HVIO_6C_17,TXCLK17,Data_Ctrl17 |  |  |  |  | G2
6C |  | IO | HVIO_6C_18,TXCLK18,Data_Ctrl18 |  |  |  |  | J2
6C |  | IO | HVIO_6C_19,TXCLK19,Data_Ctrl19 |  |  |  |  | J1
6C |  | IO | HVIO_6C_20,TXCLK20,Data_Ctrl20 |  |  |  |  | G1
6D |  | IO | HVIO_6D_1,TXCLK1,Data_Ctrl1 |  |  |  |  | A8
6D |  | IO | HVIO_6D_2,TXCLK2,Data_Ctrl2 |  |  |  |  | B4
6D |  | IO | HVIO_6D_3,TXCLK3,Data_Ctrl3 |  |  |  |  | A11
6D |  | IO | HVIO_6D_4,TXCLK4,Data_Ctrl4 |  |  |  |  | B11
6D |  | IO | HVIO_6D_5,TXCLK5,Data_Ctrl5 |  |  |  |  | B14
6D |  | IO | HVIO_6D_6,TXCLK6,Data_Ctrl6 |  |  |  |  | A14
6D |  | IO | HVIO_6D_7,TXCLK7,Data_Ctrl7 |  |  |  |  | A20
6D |  | IO | HVIO_6D_8,TXCLK8,Data_Ctrl8 |  |  |  |  | A17
6D |  | IO | HVIO_6D_9,PLLREFCLK1,TXCLK9,RXCLK1,Data_Ctrl9 |  |  |  |  | A23
6D |  | IO | HVIO_6D_10,PLLREFCLK2,TXCLK10,RXCLK2,Data_Ctrl10 |  |  |  |  | B20
6D |  | IO | HVIO_6D_11,SOURCE_SYNC_CLK1,TXCLK11,RXCLK3,Data_Ctrl11 |  |  |  |  | B23
6D |  | IO | HVIO_6D_12,SOURCE_SYNC_CLK2,TXCLK12,RXCLK4,Data_Ctrl12 |  |  |  |  | B26
6D |  | IO | HVIO_6D_13,TXCLK13,Data_Ctrl13 |  |  |  |  | B30
6D |  | IO | HVIO_6D_14,TXCLK14,Data_Ctrl14 |  |  |  |  | A30
6D |  | IO | HVIO_6D_15,TXCLK15,Data_Ctrl15 |  |  |  |  | A35
6D |  | IO | HVIO_6D_16,TXCLK16,Data_Ctrl16 |  |  |  |  | A33
6D |  | IO | HVIO_6D_17,TXCLK17,Data_Ctrl17 |  |  |  |  | A39
6D |  | IO | HVIO_6D_18,TXCLK18,Data_Ctrl18 |  |  |  |  | B35
6D |  | IO | HVIO_6D_19,TXCLK19,Data_Ctrl19 |  |  |  |  | D34
6D |  | IO | HVIO_6D_20,TXCLK20,Data_Ctrl20 |  |  |  |  | B39
1A |  | GTSL1A_RX_CH0p |  |  |  |  |  | BV135
1A |  | GTSL1A_RX_CH0n |  |  |  |  |  | BV133
1A |  | GTSL1A_RX_CH1p |  |  |  |  |  | BN135
1A |  | GTSL1A_RX_CH1n |  |  |  |  |  | BN133
1A |  | GTSL1A_RX_CH2p |  |  |  |  |  | BJ135
1A |  | GTSL1A_RX_CH2n |  |  |  |  |  | BJ133
1A |  | GTSL1A_RX_CH3p |  |  |  |  |  | BF135
1A |  | GTSL1A_RX_CH3n |  |  |  |  |  | BF133
1A |  | GTSL1A_TX_CH0p |  |  |  |  |  | BY129
1A |  | GTSL1A_TX_CH0n |  |  |  |  |  | BY126
1A |  | GTSL1A_TX_CH1p |  |  |  |  |  | BT129
1A |  | GTSL1A_TX_CH1n |  |  |  |  |  | BT126
1A |  | GTSL1A_TX_CH2p |  |  |  |  |  | BL129
1A |  | GTSL1A_TX_CH2n |  |  |  |  |  | BL126
1A |  | GTSL1A_TX_CH3p |  |  |  |  |  | BG129
1A |  | GTSL1A_TX_CH3n |  |  |  |  |  | BG126
1A |  | REFCLK_GTSL1A_CH1p |  |  |  |  |  | BB120
1A |  | REFCLK_GTSL1A_CH1n |  |  |  |  |  | BB115
1A |  | REFCLK_GTSL1A_RX_P |  |  |  |  |  | BC111
1A |  | REFCLK_GTSL1A_RX_N |  |  |  |  |  | BC107
1B |  | GTSL1B_RX_CH0p |  |  |  |  |  | BD135
1B |  | GTSL1B_RX_CH0n |  |  |  |  |  | BD133
1B |  | GTSL1B_RX_CH1p |  |  |  |  |  | BB135
1B |  | GTSL1B_RX_CH1n |  |  |  |  |  | BB133
1B |  | GTSL1B_RX_CH2p |  |  |  |  |  | AY135
1B |  | GTSL1B_RX_CH2n |  |  |  |  |  | AY133
1B |  | GTSL1B_RX_CH3p |  |  |  |  |  | AV135
1B |  | GTSL1B_RX_CH3n |  |  |  |  |  | AV133
1B |  | GTSL1B_TX_CH0p |  |  |  |  |  | BE129
1B |  | GTSL1B_TX_CH0n |  |  |  |  |  | BE126
1B |  | GTSL1B_TX_CH1p |  |  |  |  |  | BC129
1B |  | GTSL1B_TX_CH1n |  |  |  |  |  | BC126
1B |  | GTSL1B_TX_CH2p |  |  |  |  |  | BA129
1B |  | GTSL1B_TX_CH2n |  |  |  |  |  | BA126
1B |  | GTSL1B_TX_CH3p |  |  |  |  |  | AW129
1B |  | GTSL1B_TX_CH3n |  |  |  |  |  | AW126
1B |  | REFCLK_GTSL1B_CH1p |  |  |  |  |  | AV120
1B |  | REFCLK_GTSL1B_CH1n |  |  |  |  |  | AV115
1B |  | REFCLK_GTSL1B_RX_P |  |  |  |  |  | AY120
1B |  | REFCLK_GTSL1B_RX_N |  |  |  |  |  | AY115
1C |  | GTSL1C_RX_CH0p |  |  |  |  |  | AT135
1C |  | GTSL1C_RX_CH0n |  |  |  |  |  | AT133
1C |  | GTSL1C_RX_CH1p |  |  |  |  |  | AP135
1C |  | GTSL1C_RX_CH1n |  |  |  |  |  | AP133
1C |  | GTSL1C_RX_CH2p |  |  |  |  |  | AM135
1C |  | GTSL1C_RX_CH2n |  |  |  |  |  | AM133
1C |  | GTSL1C_RX_CH3p |  |  |  |  |  | AK135
1C |  | GTSL1C_RX_CH3n |  |  |  |  |  | AK133
1C |  | GTSL1C_TX_CH0p |  |  |  |  |  | AU129
1C |  | GTSL1C_TX_CH0n |  |  |  |  |  | AU126
1C |  | GTSL1C_TX_CH1p |  |  |  |  |  | AR129
1C |  | GTSL1C_TX_CH1n |  |  |  |  |  | AR126
1C |  | GTSL1C_TX_CH2p |  |  |  |  |  | AN129
1C |  | GTSL1C_TX_CH2n |  |  |  |  |  | AN126
1C |  | GTSL1C_TX_CH3p |  |  |  |  |  | AL129
1C |  | GTSL1C_TX_CH3n |  |  |  |  |  | AL126
1C |  | REFCLK_GTSL1C_CH1p |  |  |  |  |  | AP120
1C |  | REFCLK_GTSL1C_CH1n |  |  |  |  |  | AP115
1C |  | CDRCLKOUT_GTSL1C_CH2p |  |  |  |  |  | AN111
1C |  | CDRCLKOUT_GTSL1C_CH2n |  |  |  |  |  | AN107
1C |  | REFCLK_GTSL1C_RX_P |  |  |  |  |  | AT120
1C |  | REFCLK_GTSL1C_RX_N |  |  |  |  |  | AT115
4A |  | GTSR4A_RX_CH0p |  |  |  |  |  | CB1
4A |  | GTSR4A_RX_CH0n |  |  |  |  |  | CB3
4A |  | GTSR4A_RX_CH1p |  |  |  |  |  | BV1
4A |  | GTSR4A_RX_CH1n |  |  |  |  |  | BV3
4A |  | GTSR4A_RX_CH2p |  |  |  |  |  | BN1
4A |  | GTSR4A_RX_CH2n |  |  |  |  |  | BN3
4A |  | GTSR4A_RX_CH3p |  |  |  |  |  | BJ1
4A |  | GTSR4A_RX_CH3n |  |  |  |  |  | BJ3
4A |  | GTSR4A_TX_CH0p |  |  |  |  |  | BY7
4A |  | GTSR4A_TX_CH0n |  |  |  |  |  | BY10
4A |  | GTSR4A_TX_CH1p |  |  |  |  |  | BT7
4A |  | GTSR4A_TX_CH1n |  |  |  |  |  | BT10
4A |  | GTSR4A_TX_CH2p |  |  |  |  |  | BL7
4A |  | GTSR4A_TX_CH2n |  |  |  |  |  | BL10
4A |  | GTSR4A_TX_CH3p |  |  |  |  |  | BG7
4A |  | GTSR4A_TX_CH3n |  |  |  |  |  | BG10
4A |  | REFCLK_GTSR4A_CH1p |  |  |  |  |  | BB16
4A |  | REFCLK_GTSR4A_CH1n |  |  |  |  |  | BB21
4A |  | REFCLK_GTSR4A_RX_P |  |  |  |  |  | BC29
4A |  | REFCLK_GTSR4A_RX_N |  |  |  |  |  | BC25
4B |  | GTSR4B_RX_CH0p |  |  |  |  |  | BF1
4B |  | GTSR4B_RX_CH0n |  |  |  |  |  | BF3
4B |  | GTSR4B_RX_CH1p |  |  |  |  |  | BD1
4B |  | GTSR4B_RX_CH1n |  |  |  |  |  | BD3
4B |  | GTSR4B_RX_CH2p |  |  |  |  |  | BB1
4B |  | GTSR4B_RX_CH2n |  |  |  |  |  | BB3
4B |  | GTSR4B_RX_CH3p |  |  |  |  |  | AY1
4B |  | GTSR4B_RX_CH3n |  |  |  |  |  | AY3
4B |  | GTSR4B_TX_CH0p |  |  |  |  |  | BE7
4B |  | GTSR4B_TX_CH0n |  |  |  |  |  | BE10
4B |  | GTSR4B_TX_CH1p |  |  |  |  |  | BC7
4B |  | GTSR4B_TX_CH1n |  |  |  |  |  | BC10
4B |  | GTSR4B_TX_CH2p |  |  |  |  |  | BA7
4B |  | GTSR4B_TX_CH2n |  |  |  |  |  | BA10
4B |  | GTSR4B_TX_CH3p |  |  |  |  |  | AW7
4B |  | GTSR4B_TX_CH3n |  |  |  |  |  | AW10
4B |  | REFCLK_GTSR4B_CH1p |  |  |  |  |  | AV16
4B |  | REFCLK_GTSR4B_CH1n |  |  |  |  |  | AV21
4B |  | CDRCLKOUT_GTSR4B_CH2p |  |  |  |  |  | AN25
4B |  | CDRCLKOUT_GTSR4B_CH2n |  |  |  |  |  | AN29
4B |  | REFCLK_GTSR4B_RX_P |  |  |  |  |  | AY16
4B |  | REFCLK_GTSR4B_RX_N |  |  |  |  |  | AY21
4C |  | GTSR4C_RX_CH0p |  |  |  |  |  | AV1
4C |  | GTSR4C_RX_CH0n |  |  |  |  |  | AV3
4C |  | GTSR4C_RX_CH1p |  |  |  |  |  | AT1
4C |  | GTSR4C_RX_CH1n |  |  |  |  |  | AT3
4C |  | GTSR4C_RX_CH2p |  |  |  |  |  | AP1
4C |  | GTSR4C_RX_CH2n |  |  |  |  |  | AP3
4C |  | GTSR4C_RX_CH3p |  |  |  |  |  | AM1
4C |  | GTSR4C_RX_CH3n |  |  |  |  |  | AM3
4C |  | GTSR4C_TX_CH0p |  |  |  |  |  | AU7
4C |  | GTSR4C_TX_CH0n |  |  |  |  |  | AU10
4C |  | GTSR4C_TX_CH1p |  |  |  |  |  | AR7
4C |  | GTSR4C_TX_CH1n |  |  |  |  |  | AR10
4C |  | GTSR4C_TX_CH2p |  |  |  |  |  | AN7
4C |  | GTSR4C_TX_CH2n |  |  |  |  |  | AN10
4C |  | GTSR4C_TX_CH3p |  |  |  |  |  | AL7
4C |  | GTSR4C_TX_CH3n |  |  |  |  |  | AL10
4C |  | REFCLK_GTSR4C_CH1p |  |  |  |  |  | AP16
4C |  | REFCLK_GTSR4C_CH1n |  |  |  |  |  | AP21
4C |  | REFCLK_GTSR4C_RX_P |  |  |  |  |  | AT16
4C |  | REFCLK_GTSR4C_RX_N |  |  |  |  |  | AT21
 |  | GND |  |  |  |  |  | CK110
 |  | GND |  |  |  |  |  | CH121
 |  | GND |  |  |  |  |  | CH118
 |  | GND |  |  |  |  |  | V95
 |  | GND |  |  |  |  |  | V84
 |  | GND |  |  |  |  |  | V74
 |  | GND |  |  |  |  |  | V65
 |  | GND |  |  |  |  |  | V55
 |  | GND |  |  |  |  |  | V44
 |  | GND |  |  |  |  |  | V4
 |  | GND |  |  |  |  |  | V34
 |  | GND |  |  |  |  |  | V24
 |  | GND |  |  |  |  |  | V15
 |  | GND |  |  |  |  |  | V132
 |  | GND |  |  |  |  |  | V124
 |  | GND |  |  |  |  |  | V114
 |  | GND |  |  |  |  |  | V105
 |  | GND |  |  |  |  |  | R135
 |  | GND |  |  |  |  |  | R1
 |  | GND |  |  |  |  |  | P98
 |  | GND |  |  |  |  |  | P87
 |  | GND |  |  |  |  |  | P8
 |  | GND |  |  |  |  |  | P77
 |  | GND |  |  |  |  |  | P67
 |  | GND |  |  |  |  |  | P58
 |  | GND |  |  |  |  |  | P47
 |  | GND |  |  |  |  |  | P37
 |  | GND |  |  |  |  |  | P27
 |  | GND |  |  |  |  |  | P18
 |  | GND |  |  |  |  |  | P127
 |  | GND |  |  |  |  |  | P117
 |  | GND |  |  |  |  |  | P108
 |  | GND |  |  |  |  |  | L2
 |  | GND |  |  |  |  |  | L134
 |  | GND |  |  |  |  |  | H95
 |  | GND |  |  |  |  |  | H84
 |  | GND |  |  |  |  |  | H74
 |  | GND |  |  |  |  |  | H65
 |  | GND |  |  |  |  |  | H55
 |  | GND |  |  |  |  |  | H44
 |  | GND |  |  |  |  |  | H4
 |  | GND |  |  |  |  |  | H34
 |  | GND |  |  |  |  |  | H24
 |  | GND |  |  |  |  |  | H15
 |  | GND |  |  |  |  |  | H132
 |  | GND |  |  |  |  |  | H124
 |  | GND |  |  |  |  |  | H114
 |  | GND |  |  |  |  |  | H105
 |  | GND |  |  |  |  |  | E2
 |  | GND |  |  |  |  |  | E134
 |  | GND |  |  |  |  |  | E1
 |  | GND |  |  |  |  |  | D98
 |  | GND |  |  |  |  |  | D87
 |  | GND |  |  |  |  |  | D77
 |  | GND |  |  |  |  |  | D67
 |  | GND |  |  |  |  |  | D58
 |  | GND |  |  |  |  |  | D47
 |  | GND |  |  |  |  |  | D37
 |  | GND |  |  |  |  |  | D27
 |  | GND |  |  |  |  |  | D18
 |  | GND |  |  |  |  |  | D127
 |  | GND |  |  |  |  |  | D117
 |  | GND |  |  |  |  |  | D108
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
 |  | GND |  |  |  |  |  | A4
 |  | GND |  |  |  |  |  | A26
 |  | GND |  |  |  |  |  | A134
 |  | GND |  |  |  |  |  | A132
 |  | GND |  |  |  |  |  | A119
 |  | GND |  |  |  |  |  | A103
 |  | GNDSENSE |  |  |  |  |  | AU72
 |  | VCC |  |  |  |  |  | BA61
 |  | VCC |  |  |  |  |  | AY75
 |  | VCC |  |  |  |  |  | AY68
 |  | VCC |  |  |  |  |  | AY64
 |  | VCC |  |  |  |  |  | AY57
 |  | VCC |  |  |  |  |  | AY53
 |  | VCC |  |  |  |  |  | AW79
 |  | VCC |  |  |  |  |  | AW72
 |  | VCC |  |  |  |  |  | AW68
 |  | VCC |  |  |  |  |  | AW61
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
