joyhpc/misc-tasks/a5ed052a_min_system_pin_assign/sources/vendor_reference/keim-a5esom_bom_rev1.00.xlsx

KEIm-A5ESoM Revised: Friday, April 19, 2024
KEIM-A5ESOM(ES) Revision: 1.00
Bill Of Materials April 19,2024 13:19:53 | Page1
No. | Part Name | Manufacturer | Manufacturer Part Num | Quantity | Reference | Value | PCB Footprint | Temperature | MSL | No Mount
1 | Connector(BtoB) | Samtec | ADF6-100-03.5-L-4-2-A-TR | 2 | CN1,CN2 | ADF6-100-03.5-L-4-2-A-TR | 400pin | -55to125C | 1
2 | Connector(MicroSD) | GCT | MEM2052-00-195-00-A | 1 | CN3 | MEM2052-00-195-00-A |  | -40to85C | 1
3 | Ceramic Capacitor | Murata | GRM155R61A106M# | 64 | C1,C2,C3,C4,C5,C6,C9,C10,C25,C26,C27,C28,C29,C30,C36,C39,C51,C54,C58,C59,C60,C61,C62,C63,C70,C71,C72,C73,C76,C79,C83,C84,C85,C86,C89,C92,C100,C101,C103,C104,C112,C117,C118,C120,C121,C133,C134,C135,C137,C138,C140,C141,C143,C144,C147,C148,C159,C170,C181,C220,C226,C232,C238,C277 | 10uF/10V | 1005 | -55to85C | 1
4 | Ceramic Capacitor | Murata | GRM188R61E106K# | 8 | C7,C8,C347,C348,C349,C433,C436,C437 | 10uF/25V | 1608 | -55to85C | 1
5 | Ceramic Capacitor | Murata | GRM155R61A475M# | 25 | C11,C34,C35,C37,C38,C49,C50,C52,C53,C74,C75,C77,C78,C87,C88,C90,C91,C130,C131,C132,C319,C331,C333,C335,C455 | 4.7uF/10V | 1005 | -55to85C | 1
6 | Ceramic Capacitor | Murata | GRM155R71H104K# | 47 | C12,C13,C14,C15,C16,C24,C320,C321,C322,C328,C329,C330,C332,C334,C353,C354,C359,C361,C362,C369,C373,C375,C377,C378,C387,C391,C392,C397,C399,C400,C407,C411,C413,C415,C416,C427,C435,C443,C454,C465,C467,C468,C469,C470,C473,C474,C476 | 0.1uF/50V | 1005 | -55to125C | 1
7 | Ceramic Capacitor | Murata | GRM033R61A105M# | 46 | C23,C42,C57,C65,C69,C82,C93,C94,C95,C96,C99,C106,C107,C108,C109,C110,C111,C113,C114,C115,C116,C123,C124,C125,C126,C127,C128,C129,C146,C336,C337,C338,C339,C340,C341,C342,C343,C344,C345,C346,C356,C394,C464,C466,C472,C475 | 1uF/10V | 0603 | -55to85C | 1
8 | Ceramic Capacitor | Murata | GRM188C80G476M# | 27 | C31,C32,C33,C40,C41,C43,C44,C45,C46,C47,C48,C55,C56,C67,C68,C80,C81,C97,C98,C102,C105,C119,C122,C136,C139,C142,C145 | 47uF/4V | 1608 | -55to105C | 1
9 | Ceramic Capacitor | Murata | GRM188R61A226M# | 10 | C64,C66,C430,C431,C440,C441,C442,C446,C447,C448 | 22uF/10V | 1608 | -55to85C | 1
10 | Ceramic Capacitor | Murata | GRM033R61C104K# | 159 | C149,C150,C151,C152,C153,C154,C155,C156,C157,C158,C160,C161,C162,C163,C164,C165,C166,C167,C168,C169,C171,C172,C173,C174,C175,C176,C177,C178,C179,C180,C182,C183,C184,C185,C186,C187,C188,C189,C190,C191,C192,C193,C194,C195,C196,C197,C198,C199,C200,C201,C202,C203,C204,C205,C206,C207,C208,C209,C210,C211,C212,C213,C214,C215,C216,C217,C218,C219,C221,C222,C223,C224,C225,C227,C228,C229,C230,C231,C233,C234,C235,C236,C237,C239,C240,C241,C242,C243,C244,C245,C246,C247,C248,C249,C250,C251,C252,C253,C254,C255,C256,C257,C258,C259,C260,C261,C262,C263,C264,C265,C266,C267,C268,C269,C270,C271,C272,C273,C274,C275,C276,C278,C279,C280,C281,C282,C283,C284,C285,C286,C287,C288,C289,C290,C291,C292,C293,C294,C295,C296,C297,C298,C299,C300,C301,C302,C303,C304,C305,C306,C307,C308,C309,C310,C311,C312,C313,C314,C315 | 0.1uF | 0603 | -55to85C | 1
11 | Ceramic Capacitor | TDK | C3225X7S3D222K250# | 1 | C324 | 2200pF/2kV | 3225 | -55to125C | 1
12 | Ceramic Capacitor | Murata | GRM31CR61C476M# | 12 | C350,C351,C352,C370,C371,C372,C388,C389,C390,C408,C409,C410 | 47uF/16V | 3216 | -55to85C | 1
13 | Ceramic Capacitor | Murata | GRM155R61E105K# | 6 | C355,C393,C434,C444,C453,C460 | 1uF/25V | 1005 | -55to85C | 1
14 | Ceramic Capacitor | Murata | GRM155R61C225K# | 12 | C357,C358,C360,C374,C376,C395,C396,C398,C412,C414,C438,C449 | 2.2uF/16V | 1005 | -55to85C | 1
15 | Ceramic Capacitor | Murata | GRM31CR60J107M# | 12 | C363,C364,C380,C381,C401,C402,C417,C418,C456,C457,C458,C459 | 100uF/6.3V | 3216 | -55to85C | 1
16 | Ceramic Capacitor | Murata | GRM32ER60G337M# | 14 | C365,C366,C367,C382,C383,C384,C403,C404,C405,C406,C419,C420,C421,C422 | 330uF/4V | 3225 | -55to85C | 1
17 | Ceramic Capacitor | TDK | C1005C0G1H101J050# | 1 | C368 | 100pF | 1005 | -55to125C | 1
18 | Ceramic Capacitor | Murata | GRM1555C1E201J# | 1 | C379 | 200pF | 1005 | -55to125C | 1
19 | Ceramic Capacitor | Murata | GRM1555C1H1R0B# | 1 | C385 | 1pF | 1005 | -55to125C | 1
20 | Ceramic Capacitor | Murata | GRM1555C1E750G# | 1 | C386 | 75pF | 1005 | -55to125C | 1
21 | Ceramic Capacitor | Murata | GRM1555C1H241J# | 2 | C423,C424 | 240pF | 1005 | -55to125C | 1
22 | Ceramic Capacitor | Murata | GRM1555C1H1R6C# | 2 | C425,C426 | 1.6pF | 1005 | -55to125C | 1
23 | Ceramic Capacitor | Murata | GRM1555C1H111J# | 2 | C428,C429 | 110pF | 1005 | -55to125C | 1
24 | Ceramic Capacitor | Murata | GRM188R61A226M# | 3 | C432,C439,C445 | 22uF/10V | 1608 | -55to85C | 1 | NoMount
25 | Ceramic Capacitor | Murata | GRM155R71A474M# | 1 | C450 | 0.47uF | 1005 | -55to125C | 1
26 | Ceramic Capacitor | Murata | GRM21BR61C226M# | 2 | C451,C452 | 22uF/16V | 2012 | -55to85C | 1
27 | IC(ESD Diode) | TI | TPD1E10B06DPY# | 1 | D118 | TPD1E10B06DPY# | X1SON | -40to125C | 1
28 | Inductor(Ferrite Bead) | Murata | BLM15PX221SN1# | 6 | FB1,FB9,FB10,FB11,FB12,FB13 | 1.4A/220Ohm | 1005 | -55to125C | 1
29 | Inductor(Ferrite Bead) | Murata | BLM18SN220TN1# | 7 | FB2,FB3,FB4,FB5,FB6,FB7,FB8 | 8A/22Ohm | 1608 | -55to125C | 1
30 | Inductor(Ferrite Bead) | Murata | BLM21SP111SN1# | 2 | FB14,FB20 | 5A/110Ohm | 2012 | -55to125C | 1
31 | Inductor(Ferrite Bead) | Murata | BLM15PX330SN1# | 9 | FB15,FB16,FB17,FB21,FB22,FB23,FB24,FB25,FB26 | 3A/33Ohm | 1005 | -55to125C | 1
32 | Inductor(Ferrite Bead) | Murata | BLM21SP700SN1# | 2 | FB18,FB19 | 6A/70Ohm | 2012 | -55to125C | 1
33 | IC(Agilex 5E SoC FPGA) | Intel | A5ED065BB32AE5SR0 | 1 | IC1 | A5ED065BB32A | BGA1591 | -40to100C | 3
34 | IC(Flash) | Micron | MT25QU02GCBB8E12-0SIT | 1 | IC2 | MT25QU02GCBB8E12-0SIT | TBGA24 | -40to85C | 3
35 | IC(Level Shifter) | On Semi | FXMA2102UMX | 1 | IC3 | FXMA2102UMX | UMLP8 | -40to85C | 1
36 | IC(Buffer) | TI | SN74AUP1G17DCK# | 1 | IC4 | SN74AUP1G17DCK# | SC70 | -40to85C | 1
37 | IC(LPDDR4) | Micron | MT53E1G32D2FW-046WT:B | 3 | IC7,IC8,IC9 | MT53E1G32D2FW-046WT:B | TFBGA200 | -25to85C | 3
38 | IC(CMOS SW) | TI | TMUX1574RSV | 3 | IC11,IC13,IC14 | TMUX1574RSV | UQFN16 | -40to125C | 1
39 | IC(eMMC) | Micron | MTFC32GAZAQHD-IT | 1 | IC15 | MTFC32GAZAQHD-IT | VFBGA153 | -40to95C | 3
40 | IC(Clock Generator) | SKYWORKS | Si5340B-D-GM | 1 | IC16 | Si5340B-D-GM | QFN44 | -40to85C | 2
41 | IC(Power Sequencer) | Analog Devices | ADM1168ASTZ | 1 | IC17 | ADM1168ASTZ | LQFP32 | -40to85C | 3
42 | IC(DCDC) | Analog Devices | LTC7883AY#PBF | 1 | IC18 | LTC7883AY#PBF | BGA99 | -40to125C | 3
43 | IC(Half Bridge Driver) | On Semi | NCP302035MNTWG | 4 | IC19,IC20,IC21,IC22 | NCP302035MNTWG | PQFN31 | -40to125C | 1
44 | IC(DCDC) | Analog Devices | LTC3304ARUCM#TRPBF | 1 | IC23 | LTC3304ARUCM#TRPBF | FCQFN12 | -40to125C | 1
45 | IC(DCDC) | Analog Devices | MAX77540AAFG+T | 1 | IC24 | MAX77540AAFG+T | FC2QFN24 | -40to125C | 1
46 | IC(DCDC) | Analog Devices | MAX16710AWA+T | 1 | IC25 | MAX16710AWA+T | WLP25 | -40to125C | 1
47 | IC(SD Power Selection) | Rohm | BD2204GUL | 1 | IC26 | BD2204GUL | VCSP50L1 | -40to85C | 1
48 | IC(Level shifter) | NXP | NVT4858HKZ | 1 | IC27 | NVT4858HKZ | XQFN16 | -40to85C | 1
49 | IC(Load Switch) | Analog Devices | MAX40200ANS+T | 1 | IC28 | MAX40200ANS+T | 4WLP | -40to125C | 1
50 | LED(Green) | Rohm | SML-P13FTT86R | 2 | LED1,LED2 | SML-P13FTT86R | 1006 | -40to85C | 3
51 | LED(Orenge) | Rohm | SML-P12DTT86R | 1 | LED3 | SML-P12DTT86R | 1006 | -40to85C | 3
52 | Inductor | Bourns | SRP6030CA-R18M | 2 | L1,L2 | 0.18uH | 6664 | -55to155C | 1
53 | Inductor | Bourns | SRP4020FA-R47M | 1 | L3 | 0.47uH | 4141 | -55to155C | 1
54 | Inductor | Bourns | SRP4020FA-R68M | 1 | L4 | 0.68uH | 4141 | -55to155C | 1
55 | Inductor | WE | 744383360033 | 1 | L5 | 0.33uH | 3030 | -40to125C | 1
56 | Inductor | WE | 74438323010 | 1 | L6 | 1uH | 2520 | -40to125C | 1
57 | Inductor | WE | 744383430068 | 1 | L7 | 0.68uH | 2016 | -40to125C | 1
58 | Inductor | TDK | SPM6530T-R47M# | 1 | L8 | 0.47uH | 7165 | -40to125C | 1
59 | Resistor | KOA | RK73H1ETTP1002F | 38 | R1,R2,R3,R6,R7,R8,R23,R24,R25,R29,R40,R43,R44,R54,R55,R129,R208,R215,R216,R217,R218,R219,R220,R221,R222,R241,R242,R252,R253,R256,R267,R268,R277,R278,R322,R323,R332,R336 | 10K | 1005 | -55to155C | 1
60 | Resistor | KOA | RK73H1ETTP1002F | 49 | R4,R5,R67,R68,R69,R70,R73,R74,R75,R76,R78,R79,R80,R81,R84,R85,R86,R87,R89,R90,R92,R93,R95,R96,R98,R99,R101,R102,R104,R105,R144,R145,R146,R207,R209,R223,R237,R238,R239,R240,R274,R276,R308,R309,R328,R330,R361,R362,R410 | 10K | 1005 | -55to155C | 1 | NoMount
61 | Resistor | KOA | RK73H1ETTP1001F | 16 | R9,R26,R27,R28,R132,R133,R134,R135,R136,R137,R147,R148,R149,R371,R416,R426 | 1K | 1005 | -55to155C | 1
62 | Resistor | KOA | RK73Z1ETTP | 140 | R10,R12,R13,R15,R16,R17,R22,R31,R32,R33,R34,R35,R36,R45,R46,R47,R48,R49,R50,R53,R56,R57,R58,R59,R61,R62,R63,R65,R107,R127,R128,R130,R131,R172,R173,R175,R176,R177,R186,R192,R193,R194,R195,R196,R197,R198,R199,R200,R201,R206,R210,R211,R212,R213,R214,R224,R225,R228,R229,R230,R231,R232,R233,R234,R235,R246,R247,R248,R249,R250,R251,R254,R257,R258,R259,R263,R269,R270,R271,R272,R273,R280,R281,R282,R283,R284,R285,R286,R287,R288,R289,R290,R291,R292,R293,R307,R311,R314,R324,R325,R326,R327,R329,R334,R335,R337,R338,R339,R340,R341,R342,R343,R344,R345,R346,R360,R364,R367,R368,R377,R378,R381,R383,R385,R387,R388,R389,R396,R397,R414,R418,R419,R421,R422,R425,R428,R811,R813,R816,R819 | 0 | 1005 | -55to155C | 1
63 | Resistor | KOA | RK73H1ETTP3300F | 2 | R11,R60 | 330 | 1005 | -55to155C | 1
64 | Resistor | KOA | RK73H1ETTP1003F | 2 | R14,R379 | 100K | 1005 | -55to155C | 1
65 | Resistor | KOA | RK73H1ETTP4701F | 15 | R18,R19,R20,R41,R42,R108,R243,R244,R245,R261,R262,R812,R815,R818,R821 | 4.7K | 1005 | -55to155C | 1
66 | Resistor | KOA | RK73H1ETTP4701F | 9 | R21,R38,R39,R51,R52,R66,R317,R318,R427 | 4.7K | 1005 | -55to155C | 1 | NoMount
67 | Resistor | KOA | RK73H1ETTP2001F | 3 | R30,R275,R331 | 2K | 1005 | -55to155C | 1
68 | Resistor | KOA | RK73H1ETTP22R0F | 2 | R37,R236 | 22 | 1005 | -55to155C | 1
69 | Resistor | KOA | RK73Z1ETTP | 12 | R64,R260,R264,R316,R319,R380,R382,R384,R398,R399,R424,R771 | 0 | 1005 | -55to155C | 1 | NoMount
70 | Resistor | KOA | RK73H1ETTP1000F | 19 | R71,R72,R82,R83,R91,R97,R103,R113,R114,R115,R116,R117,R118,R119,R121,R123,R124,R125,R126 | 100 | 1005 | -55to155C | 1 | NoMount
71 | Resistor | KOA | RK73H1ETTP2400F | 10 | R77,R94,R100,R106,R138,R139,R140,R141,R142,R143 | 240 | 1005 | -55to155C | 1
72 | Resistor | KOA | RK73H1ETTP2400F | 1 | R88 | 240 | 1005 | -55to155C | 1 | NoMount
73 | Resistor | Panasonic | ERA2AEB4990X | 2 | R120,R122 | 499/0.1% | 1005 | -55to155C | 1
74 | Resistor | KOA | RK73H1ETTP2201F | 6 | R150,R151,R152,R156,R157,R158 | 2.2K | 1005 | -55to155C | 1
75 | Resistor | KOA | RK73H1ETTP1001F | 8 | R153,R154,R155,R159,R160,R161,R226,R227 | 1K | 1005 | -55to155C | 1 | NoMount
76 | Resistor | Panasonic | ERJP08F1004V | 1 | R174 | 1M/0.66W | 3216 | -55to155C | 1
77 | Resistor | KOA | RK73H1ETTP10R0F | 5 | R255,R306,R315,R359,R374 | 10 | 1005 | -55to155C | 1
78 | Resistor | KOA | RK73H1ETTP2741F | 4 | R265,R266,R320,R321 | 2.74K | 1005 | -55to155C | 1
79 | Resistor | KOA | RK73H1ETTP1131F | 2 | R279,R310 | 1.13K | 1005 | -55to155C | 1
80 | Resistor | KOA | RK73H1ETTP2492F | 10 | R294,R295,R296,R298,R299,R347,R348,R349,R350,R351 | 24.9K | 1005 | -55to155C | 1
81 | Resistor | KOA | RK73H1ETTP2002F | 2 | R297,R352 | 20K | 1005 | -55to155C | 1
82 | Resistor | KOA | RK73H1ETTP4321F | 4 | R300,R301,R303,R354 | 4.32K | 1005 | -55to155C | 1
83 | Resistor | KOA | RK73H1ETTP1132F | 2 | R302,R355 | 11.3K | 1005 | -55to155C | 1
84 | Resistor | KOA | RK73H1ETTP5761F | 2 | R304,R357 | 5.76K | 1005 | -55to155C | 1
85 | Resistor | KOA | RK73H1ETTP1272F | 2 | R305,R358 | 12.7K | 1005 | -55to155C | 1
86 | Resistor | KOA | RK73H1ETTP6651F | 1 | R312 | 6.65K | 1005 | -55to155C | 1
87 | Resistor | KOA | RK73H1ETTP1783F | 1 | R313 | 178K | 1005 | -55to155C | 1
88 | Resistor | KOA | RK73H1ETTP7870F | 1 | R333 | 787 | 1005 | -55to155C | 1
89 | Resistor | KOA | RK73H1ETTP7321F | 1 | R353 | 7.32K | 1005 | -55to155C | 1
90 | Resistor | KOA | RK73H1ETTP9091F | 1 | R356 | 9.09K | 1005 | -55to155C | 1
91 | Resistor | KOA | RK73H1ETTP9310F | 1 | R363 | 931 | 1005 | -55to155C | 1
92 | Resistor | KOA | RK73H1ETTP5491F | 2 | R365,R366 | 5.49K | 1005 | -55to155C | 1
93 | Resistor | KOA | RK73H1ETTP1023F | 2 | R369,R370 | 102K | 1005 | -55to155C | 1
94 | Resistor(Shunt) | KOA | TLR2ATTD10L0F | 2 | R372,R373 | 10m/1W | 2012 | -65to155C | 1
95 | Resistor | KOA | RK73H1ETTP1303F | 2 | R375,R376 | 130K | 1005 | -55to155C | 1
96 | Resistor | KOA | RK73H1ETTP7502F | 1 | R390 | 75K | 1005 | -55to155C | 1
97 | Resistor | KOA | RK73H1ETTP2612F | 1 | R391 | 26.1K | 1005 | -55to155C | 1
98 | Resistor | KOA | RK73H1ETTP4R70F | 4 | R392,R810,R814,R817 | 4.7 | 1005 | -55to155C | 1
99 | Resistor | KOA | RK73H1ETTP3601F | 1 | R393 | 3.6K | 1005 | -55to155C | 1
100 | Resistor | KOA | RK73H1ETTP3001F | 1 | R394 | 3K | 1005 | -55to155C | 1
101 | Resistor | KOA | RK73H1ETTP1871F | 1 | R395 | 1.87K | 1005 | -55to155C | 1
102 | Resistor | KOA | RK73H1ETTP33R0F | 12 | R759,R760,R761,R762,R763,R764,R765,R766,R767,R768,R769,R770 | 33 | 1005 | -55to155C | 1
103 | Resistor | KOA | RK73H1ETTP1R00F | 1 | R773 | 1 | 1005 | -55to155C | 1
104 | SW(DIP) | CTS | 218-4LPSF | 1 | SW1 | 218-4LPSF | SOP8 | -55to85C | 1
105 | Test Pad |  | Test_Pad | 77 | TP1,TP2,TP3,TP4,TP5,TP6,TP7,TP8,TP9,TP10,TP11,TP12,TP13,TP14,TP15,TP16,TP17,TP18,TP19,TP20,TP21,TP22,TP23,TP24,TP25,TP26,TP27,TP28,TP29,TP30,TP31,TP32,TP33,TP34,TP35,TP36,TP37,TP38,TP39,TP40,TP41,TP42,TP43,TP44,TP45,TP46,TP47,TP48,TP49,TP50,TP51,TP52,TP53,TP54,TP55,TP56,TP57,TP58,TP59,TP60,TP61,TP62,TP63,TP64,TP65,TP66,TP67,TP68,TP69,TP70,TP71,TP72,TP73,TP74,TP75,TP76,TP77 | TP | TP |  |  | NoMount
106 | Transister(FET) | Rohm | RUM001L02T2CL | 6 | TR1,TR2,TR32,TR34,TR36,TR38 | RUM001L02T2CL | SOT723 | -55to150C | 1
107 | Transister(FET) | Diode | DMN2058UW-7 | 4 | TR31,TR33,TR35,TR37 | DMN2058UW-7 | SOT323 | -55to150C | 1
108 | OSC | ECS | ECS-2520MV-1000-BN-TR | 1 | X1 | ECS-2520MV-1000-BN-TR | 2520 | -40to85C | 1
109 | Xtal | ECS | ECS-480-8-33B-CWN | 1 | Y1 | ECS-480-8-33B-CWN | 3225 | -40to85C | 1
