joyhpc/misc-tasks/a5ed052a_min_system_pin_assign/deliverables/a5ed052a_b32a_min_system_pin_assign_draft_v2.xlsx

Sheet: Min_System_Pin_Assign
Group | FPGA Ball | FPGA Pin Name | Alt/Config Function | Recommended Net Name | Direction/Use | Schematic Connection | Status | Source IDs | Notes
JTAG | CA109 | TCK |  | A5E_JTAG_TCK | Input to FPGA | JTAG header TCK; 1 k pull-down to GND unless security provisioning requires pull-up case. | DRAFT | S2,S4,S6 | Ref schematic same net name.
JTAG | BW112 | TDI |  | A5E_JTAG_TDI | Input to FPGA | JTAG header TDI; 1 k to 10 k pull-up to VCCIO_SDM. | DRAFT | S2,S4,S6 | Ref schematic same net name.
JTAG | CA112 | TMS |  | A5E_JTAG_TMS | Input to FPGA | JTAG header TMS; 1 k to 10 k pull-up to VCCIO_SDM. | DRAFT | S2,S4,S6 | Ref schematic same net name.
JTAG | BW109 | TDO |  | A5E_JTAG_TDO | Output from FPGA | JTAG header TDO. | DRAFT | S2,S4,S6 | Ref schematic same net name.
Config control | BU99 | nCONFIG |  | A5E_NCONFIG | Input to FPGA | Pull up 10 k to VCCIO_SDM; optionally drive from supervisor/debug header to force reconfiguration. | DRAFT | S2,S3,S4,S6 | Ref net: A5E_NCONFIG_C2M_1V8.
Config status | BW99 | nSTATUS |  | A5E_NSTATUS | Output from FPGA | Pull up 10 k to VCCIO_SDM; monitor by supervisor/test point. | DRAFT | S2,S3,S4,S6 | Ref net: A5E_NSTATUS_M2C_1V8. Do not tie to CONF_DONE/INIT_DONE.
Config done | BP102 | SDM_IO16 | PWRMGT_SDA or CONF_DONE | A5E_CONF_DONE | Output from FPGA | Recommended optional CONF_DONE monitor; enable in Quartus. | DRAFT | S2,S3,S4,S6 | Ref net: A5E_CONF_DONE_M2C_1V8.
Init done | CA99 | SDM_IO0 | PWRMGT_SCL,PWRMGT_ALERT or INIT_DONE | A5E_INIT_DONE | Output from FPGA | Recommended optional INIT_DONE monitor; enable in Quartus. | DRAFT | S2,S3,S4,S6 | Ref net: A5E_INIT_DONE_M2C_1V8.
Config clock | BR102 | OSC_CLK_1 |  | A5E_OSC_CLK_1 | Input to FPGA | 25/100/125 MHz 1.8 V free-running oscillator; enable OSC_CLK_1 in Quartus if used. | DRAFT | S2,S3,S4,S6 | Ref net: CLK_SDM_REFCLK_125M.
Reference | CL103 | RREF_SDM |  | A5E_RREF_SDM | Analog reference | 2.00 k 1% resistor to GND, placed close to FPGA. | DRAFT | S2,S4,S6 | Ref schematic uses 2 k resistor R116.
AS x4 boot | BK99 | SDM_IO2 | AS_CLK | A5E_AS_CLK | Output from FPGA | QSPI flash CLK; optional 0 ohm/series placement as in reference schematic. | DRAFT | S2,S4,S6 | Ref net: A5E_AS_SCLK / A5E_AS_SCLK_R.
AS x4 boot | BH99 | SDM_IO4 | AS_DATA0 | A5E_AS_DATA0 | Bidirectional | QSPI flash IO0/DQ0. | DRAFT | S2,S4,S6 | Ref net same.
AS x4 boot | BK102 | SDM_IO1 | AS_DATA1 | A5E_AS_DATA1 | Bidirectional | QSPI flash IO1/DQ1. | DRAFT | S2,S4,S6 | Ref net same.
AS x4 boot | CH99 | SDM_IO3 | AS_DATA2 | A5E_AS_DATA2 | Bidirectional | QSPI flash IO2/DQ2. | DRAFT | S2,S4,S6 | Ref net same.
AS x4 boot | CF102 | SDM_IO6 | AS_DATA3 | A5E_AS_DATA3 | Bidirectional | QSPI flash IO3/DQ3. | DRAFT | S2,S4,S6 | Ref net same.
AS x4 boot | CF112 | SDM_IO5 | AS_nCSO0,MSEL0 | A5E_AS_NCSO0_MSEL0 | Output after MSEL sample | QSPI flash CS#; 4.7 k pull-up to VCCIO_SDM for AS Normal MSEL0=1. | DRAFT | S2,S3,S4,S6 | Ref net: A5E_AS_NCSO_MSEL0_C2M_1V8.
AS x4 boot | CA102 | SDM_IO15 | AS_nRST | A5E_AS_NRST | Output from FPGA | QSPI flash RESET#; SDM must control flash reset. | DRAFT | S2,S3,S4,S6 | Ref net: A5E_AS_RESET_N.
MSEL strap | BM99 | SDM_IO7 | AS_nCSO2,MSEL1 | A5E_MSEL1_AS_NCSO2 | Input during POR | 4.7 k pull-up to VCCIO_SDM for AS Normal MSEL1=1; no flash connection for single-flash design. | DRAFT | S2,S3,S4,S6 | Ref net: A5E_MSEL1_SW. If cascaded flash is used, also becomes CS2.
MSEL strap | BM102 | SDM_IO9 | AS_nCSO1,MSEL2,PWRMGT_ALERT | A5E_MSEL2_AS_NCSO1 | Input during POR | 4.7 k pull-down to GND for AS Normal MSEL2=0; no flash connection for single-flash design. | DRAFT | S2,S3,S4,S6 | Ref net: A5E_MSEL2_SW. Avoid PWRMGT_ALERT here unless topology requires it.
AS optional CS | CC102 | SDM_IO8 | AS_nCSO3 | A5E_AS_NCSO3_SPARE | Output from FPGA | DNP/TP or pull-up 1 k to VCCIO_SDM if unused per guideline; connect only for cascaded flash. | TBD-source | S2,S4,S6 | Ref net: TP_SDM_IO8. Needs final flash topology.
SmartVID/PMBus option | CF109 | SDM_IO14 | AVSTx8_CLK,PWRMGT_SCL | A5E_PWRMGT_SCL | PMBus clock | PMBus SCL to VCC regulator; 5.1 k to 10 k pull-up to 1.8 V VCCIO_SDM or level-shift as required. | TBD-source | S2,S4,S6 | Ref net: PMBUS_SCL_C2M_1V8. Populate if SmartVID/PMBus required.
SmartVID/PMBus option | CF99 | SDM_IO11 | AVSTx8_VALID,PWRMGT_SDA | A5E_PWRMGT_SDA | PMBus data | PMBus SDA to VCC regulator; 5.1 k to 10 k pull-up to 1.8 V VCCIO_SDM or level-shift as required. | TBD-source | S2,S4,S6 | Ref net: PMBUS_SDA_C2M_1V8. This replaces earlier BR99 SDA draft.
Optional monitor | BR99 | SDM_IO12 | PWRMGT_SDA,PWRMGT_ALERT | A5E_CAT_TRIP_N_OR_PWRMGT_ALERT | Optional status | Use only after deciding over-temperature / PMBus ALERT / optional configuration signal strategy. | TBD-source | S2,S4,S6 | Ref net: CAT_TRIP_N_1V8.
Optional monitor | BW102 | SDM_IO13 | AVSTx8_DATA5 | A5E_SEU_ERROR | Optional status | Optional SEU_ERROR monitor if enabled in Quartus; otherwise leave per unused-pin rule. | TBD-source | S2,S4,S6 | Ref net: SEU_ERROR_M2C_1V8.
HPS option | CH109 | SDM_IO10 | AVSTx8_DATA7 | A5E_HPS_COLD_NRESET | Optional HPS reset | Use only if HPS boot/reset architecture requires HPS_COLD_nRESET. | TBD-source | S2,S4,S6 | Ref net: A5E_HPS_COLD_NRESET_1V8.
AVST alternative only | BW102 | SDM_IO13 | AVSTx8_DATA5 | A5E_SDM_IO13_AVST_ALT | TBD | Do not use concurrently with SEU_ERROR unless Quartus assignment selects it. | TBD-source | S2,S4 | Not used by AS x4 baseline.

Sheet: Sources
Source ID | Source | Reference Detail | Path/URL
S1 | Altera official pinout index | Pin-Out Files for Altera FPGAs; Agilex 5 E-Series A5ED052A/A5ED065B links | https://www.altera.com/design/devices/resources/pinouts
S2 | Altera official A5ED052A pinout | Doc 830449, Pin Information for Agilex 5 A5ED052A Device, version 2025-06-06; local a5ed052A.xlsx, sheet Pin List B32A | https://docs.altera.com/v/u/resources/830449/pin-information-for-the-agilextm-5-a5ed052a-device-xlsx-format-alt.-format-pdf
S3 | Altera configuration user guide | Doc 813773 current/26.1, Device Configuration User Guide: Agilex 5 FPGAs and SoCs | https://docs.altera.com/r/docs/813773/current
S4 | Altera pin connection guidelines | Doc 813266 current, Pin Connection Guidelines: Agilex 5 FPGAs and SoCs | https://docs.altera.com/r/docs/813266/current/pin-connection-guidelines-agilextm-5-fpgas-and-socs
S5 | Local DF108 design evidence | Target part and project open issues. Local evidence only, lower priority than official Altera sources. | /home/ubuntu/hardware-projects/prj/DF108/revisions/rev-20260506-df108-ku040-to-a5ed052ab32ae2v/02_design_evidence/
S6 | Altera official A5ED065B B32A reference schematic | Agilex 5 FPGA E-Series 065B Modular Development Kit SOM schematic, version 2025-07-23; board device A5ED065BB32AE6SR0 | https://docs.altera.com/v/u/docs/836174/agilextm-5-fpga-e-series-065b-modular-fpga-development-kit-board-som-board-schematic
S7 | Altera official A5ED065B pinout | Doc 827729, Pin Information for Agilex 5 A5ED065B Device, version 2025-11-20; local A5ED065B.xlsx, sheet Pin List B32A | https://docs.altera.com/v/u/resources/827729/pin-information-for-the-agilextm-5-a5ed065b-device-xlsx-format-alt.-format-pdf

Sheet: Assumptions
ID | Item | Decision/Assumption | Source IDs | Status
A1 | Device/package | A5ED052A, B32A package; full order code assumed A5ED052AB32AE2V from local DF108 evidence; official order-code suffix still needs procurement confirmation. | S2,S5 | VERIFY
A2 | Reference schematic applicability | The official reference schematic uses A5ED065B B32A, not A5ED052A. For the SDM/JTAG/config pins in this workbook, A5ED052A B32A and A5ED065B B32A official pinout rows match exactly. | S2,S6,S7 | VERIFIED
A3 | Baseline config scheme | Use AS x4 Normal mode for standalone boot. MSEL[2:0]=011, so MSEL2=0, MSEL1=1, MSEL0=1. JTAG remains connected for bring-up/debug. | S3,S4 | DRAFT
A4 | Why not AS fast by default | AS Fast uses MSEL[2:0]=001 but has tighter power ramp requirements; keep AS Normal until the power tree is frozen. | S3 | DRAFT
A5 | OSC_CLK_1 | Populate a 25 MHz, 100 MHz, or 125 MHz free-running 1.8 V clock source. The official 065B reference schematic uses CLK_SDM_REFCLK_125M. | S3,S4,S6 | DRAFT
A6 | SmartVID/PMBus | For a PMBus/SmartVID implementation while keeping CONF_DONE/INIT_DONE, follow the official reference split: CF109=PWRMGT_SCL, CF99=PWRMGT_SDA. | S2,S4,S6 | DRAFT
A7 | HPS | A5ED is an HPS-capable class. HPS boot pins, HPS reset strategy, and HPS peripheral pin mux are not frozen in this minimum FPGA configuration table. | S1,S2,S5 | TBD-source

Sheet: Source_Gap_Review
Gap ID | Missing Decision/Source | What Is Needed | Impact
G1 | Configuration flash part and topology | Need supported QSPI/xSPI flash part, density, one-device vs cascaded flash, RSU requirement. | Blocks final AS_nCSO[3:1] treatment and flash schematic.
G2 | Power tree and SmartVID mode | Need regulator model, PMBus master/slave topology, level translation, rail sequencing. | Blocks final PMBus electrical details and power rail page.
G3 | Quartus device/pin options | Need project .qsf / generated SDM_IO pin report / .pin fitter report. | Required before schematic release.
G4 | HPS usage decision | Need HPS boot order and boot medium: unused, FPGA-first, HPS-first, SDMMC/eMMC/QSPI/NAND. | Blocks HPS minimum system pins.
G5 | OrCAD FPGA symbol order | Need actual schematic symbol pin order if the requested output must be sorted exactly top-to-bottom by symbol side. | This workbook is grouped by function, not symbol-order.

Sheet: Reference_Schematic_Check
Function | A5ED052A Ball | Draft Net | Reference Schematic Ball | Reference Schematic Net | Result | Source IDs
TCK | CA109 | A5E_JTAG_TCK | CA109 | A5E_JTAG_TCK | MATCH | S2,S6,S7
TDI | BW112 | A5E_JTAG_TDI | BW112 | A5E_JTAG_TDI | MATCH | S2,S6,S7
TMS | CA112 | A5E_JTAG_TMS | CA112 | A5E_JTAG_TMS | MATCH | S2,S6,S7
TDO | BW109 | A5E_JTAG_TDO | BW109 | A5E_JTAG_TDO | MATCH | S2,S6,S7
nCONFIG | BU99 | A5E_NCONFIG | BU99 | A5E_NCONFIG_C2M_1V8 | MATCH | S2,S6,S7
nSTATUS | BW99 | A5E_NSTATUS | BW99 | A5E_NSTATUS_M2C_1V8 | MATCH | S2,S6,S7
CONF_DONE/SDM_IO16 | BP102 | A5E_CONF_DONE | BP102 | A5E_CONF_DONE_M2C_1V8 | MATCH | S2,S6,S7
INIT_DONE/SDM_IO0 | CA99 | A5E_INIT_DONE | CA99 | A5E_INIT_DONE_M2C_1V8 | MATCH | S2,S6,S7
OSC_CLK_1 | BR102 | A5E_OSC_CLK_1 | BR102 | CLK_SDM_REFCLK_125M | MATCH | S2,S6,S7
RREF_SDM | CL103 | A5E_RREF_SDM | CL103 | RREF_SDM with 2k resistor | MATCH | S2,S4,S6,S7
AS_CLK/SDM_IO2 | BK99 | A5E_AS_CLK | BK99 | A5E_AS_SCLK | MATCH | S2,S6,S7
AS_DATA0/SDM_IO4 | BH99 | A5E_AS_DATA0 | BH99 | A5E_AS_DATA0 | MATCH | S2,S6,S7
AS_DATA1/SDM_IO1 | BK102 | A5E_AS_DATA1 | BK102 | A5E_AS_DATA1 | MATCH | S2,S6,S7
AS_DATA2/SDM_IO3 | CH99 | A5E_AS_DATA2 | CH99 | A5E_AS_DATA2 | MATCH | S2,S6,S7
AS_DATA3/SDM_IO6 | CF102 | A5E_AS_DATA3 | CF102 | A5E_AS_DATA3 | MATCH | S2,S6,S7
AS_nCSO0/MSEL0/SDM_IO5 | CF112 | A5E_AS_NCSO0_MSEL0 | CF112 | A5E_AS_NCSO_MSEL0_C2M_1V8 | MATCH | S2,S6,S7
AS_nRST/SDM_IO15 | CA102 | A5E_AS_NRST | CA102 | A5E_AS_RESET_N | MATCH | S2,S6,S7
MSEL1/SDM_IO7 | BM99 | A5E_MSEL1_AS_NCSO2 | BM99 | A5E_MSEL1_SW | MATCH | S2,S6,S7
MSEL2/SDM_IO9 | BM102 | A5E_MSEL2_AS_NCSO1 | BM102 | A5E_MSEL2_SW | MATCH | S2,S6,S7
PWRMGT_SCL/SDM_IO14 | CF109 | A5E_PWRMGT_SCL | CF109 | PMBUS_SCL_C2M_1V8 | MATCH | S2,S6,S7
PWRMGT_SDA/SDM_IO11 | CF99 | A5E_PWRMGT_SDA | CF99 | PMBUS_SDA_C2M_1V8 | MATCH | S2,S6,S7

Sheet: 052A_vs_065B_SDM_P2P
SDM Pin Name | 052A Optional Function | 052A B32A Ball | 065B Optional Function | 065B B32A Ball | Result
TDO |  | BW109 |  | BW109 | MATCH
TMS |  | CA112 |  | CA112 | MATCH
TCK |  | CA109 |  | CA109 | MATCH
TDI |  | BW112 |  | BW112 | MATCH
OSC_CLK_1 |  | BR102 |  | BR102 | MATCH
SDM_IO1 | AVSTx8_DATA2,AS_DATA1 | BK102 | AVSTx8_DATA2,AS_DATA1 | BK102 | MATCH
SDM_IO5 | AS_nCSO0,MSEL0 | CF112 | AS_nCSO0,MSEL0 | CF112 | MATCH
SDM_IO3 | AVSTx8_DATA3,AS_DATA2 | CH99 | AVSTx8_DATA3,AS_DATA2 | CH99 | MATCH
nCONFIG |  | BU99 |  | BU99 | MATCH
SDM_IO4 | AVSTx8_DATA1,AS_DATA0 | BH99 | AVSTx8_DATA1,AS_DATA0 | BH99 | MATCH
SDM_IO2 | AVSTx8_DATA0,AS_CLK | BK99 | AVSTx8_DATA0,AS_CLK | BK99 | MATCH
SDM_IO7 | AS_nCSO2,MSEL1 | BM99 | AS_nCSO2,MSEL1 | BM99 | MATCH
SDM_IO11 | AVSTx8_VALID,PWRMGT_SDA | CF99 | AVSTx8_VALID,PWRMGT_SDA | CF99 | MATCH
nSTATUS |  | BW99 |  | BW99 | MATCH
SDM_IO16 | PWRMGT_SDA | BP102 | PWRMGT_SDA | BP102 | MATCH
SDM_IO0 | PWRMGT_SCL,PWRMGT_ALERT | CA99 | PWRMGT_SCL,PWRMGT_ALERT | CA99 | MATCH
SDM_IO13 | AVSTx8_DATA5 | BW102 | AVSTx8_DATA5 | BW102 | MATCH
SDM_IO9 | AS_nCSO1,MSEL2,PWRMGT_ALERT | BM102 | AS_nCSO1,MSEL2,PWRMGT_ALERT | BM102 | MATCH
SDM_IO6 | AVSTx8_DATA4,AS_DATA3 | CF102 | AVSTx8_DATA4,AS_DATA3 | CF102 | MATCH
SDM_IO10 | AVSTx8_DATA7 | CH109 | AVSTx8_DATA7 | CH109 | MATCH
SDM_IO8 | AVSTx8_READY,AS_nCSO3 | CC102 | AVSTx8_READY,AS_nCSO3 | CC102 | MATCH
SDM_IO12 | PWRMGT_SDA,PWRMGT_ALERT | BR99 | PWRMGT_SDA,PWRMGT_ALERT | BR99 | MATCH
SDM_IO15 | AVSTx8_DATA6,AS_nRST | CA102 | AVSTx8_DATA6,AS_nRST | CA102 | MATCH
SDM_IO14 | AVSTx8_CLK,PWRMGT_SCL | CF109 | AVSTx8_CLK,PWRMGT_SCL | CF109 | MATCH
RREF_SDM |  | CL103 |  | CL103 | MATCH
VSIGP_0 |  | CK119 |  | CK119 | MATCH
VSIGN_0 |  | CL119 |  | CL119 | MATCH
VSIGP_1 |  | CK113 |  | CK113 | MATCH
VSIGN_1 |  | CL113 |  | CL113 | MATCH

Sheet: Raw_SDM_From_S2
Bank | Index within I/O Bank | Pin Name/Function | Optional Function(s) | Configuration Function | HPS Function | Dedicated Tx/Rx Channel SERDES | Soft CDR Support | B32A Ball
SDM |  | TDO |  |  |  |  |  | BW109
SDM |  | TMS |  |  |  |  |  | CA112
SDM |  | TCK |  |  |  |  |  | CA109
SDM |  | TDI |  |  |  |  |  | BW112
SDM |  | OSC_CLK_1 |  |  |  |  |  | BR102
SDM |  | SDM_IO1 | AVSTx8_DATA2,AS_DATA1 |  |  |  |  | BK102
SDM |  | SDM_IO5 | AS_nCSO0,MSEL0 |  |  |  |  | CF112
SDM |  | SDM_IO3 | AVSTx8_DATA3,AS_DATA2 |  |  |  |  | CH99
SDM |  | nCONFIG |  |  |  |  |  | BU99
SDM |  | SDM_IO4 | AVSTx8_DATA1,AS_DATA0 |  |  |  |  | BH99
SDM |  | SDM_IO2 | AVSTx8_DATA0,AS_CLK |  |  |  |  | BK99
SDM |  | SDM_IO7 | AS_nCSO2,MSEL1 |  |  |  |  | BM99
SDM |  | SDM_IO11 | AVSTx8_VALID,PWRMGT_SDA |  |  |  |  | CF99
SDM |  | nSTATUS |  |  |  |  |  | BW99
SDM |  | SDM_IO16 | PWRMGT_SDA |  |  |  |  | BP102
SDM |  | SDM_IO0 | PWRMGT_SCL,PWRMGT_ALERT |  |  |  |  | CA99
SDM |  | SDM_IO13 | AVSTx8_DATA5 |  |  |  |  | BW102
SDM |  | SDM_IO9 | AS_nCSO1,MSEL2,PWRMGT_ALERT |  |  |  |  | BM102
SDM |  | SDM_IO6 | AVSTx8_DATA4,AS_DATA3 |  |  |  |  | CF102
SDM |  | SDM_IO10 | AVSTx8_DATA7 |  |  |  |  | CH109
SDM |  | SDM_IO8 | AVSTx8_READY,AS_nCSO3 |  |  |  |  | CC102
SDM |  | SDM_IO12 | PWRMGT_SDA,PWRMGT_ALERT |  |  |  |  | BR99
SDM |  | SDM_IO15 | AVSTx8_DATA6,AS_nRST |  |  |  |  | CA102
SDM |  | SDM_IO14 | AVSTx8_CLK,PWRMGT_SCL |  |  |  |  | CF109
SDM |  | RREF_SDM |  |  |  |  |  | CL103
SDM |  |  | TEMPDIODE0An |  |  |  |  | BF100
SDM |  |  | TEMPDIODE0Ap |  |  |  |  | BE100
SDM |  |  | VREFP_ADC |  |  |  |  | CL116
SDM |  |  | VREFN_ADC |  |  |  |  | CK116
SDM |  | VSIGP_0 |  |  |  |  |  | CK119
SDM |  | VSIGN_0 |  |  |  |  |  | CL119
SDM |  | VSIGP_1 |  |  |  |  |  | CK113
SDM |  | VSIGN_1 |  |  |  |  |  | CL113

Sheet: Power_Pin_Groups_From_S2
Pin Name / Rail | Ball Count | B32A Balls
GND | 571 | CK110, CH121, CH118, V95, V84, V74, V65, V55, V44, V4, V34, V24, V15, V132, V124, V114, V105, R135, R1, P98, P87, P8, P77, P67, P58, P47, P37, P27, P18, P127, P117, P108, L2, L134, H95, H84, H74, H65, H55, H44, H4, H34, H24, H15, H132, H124, H114, H105, E2, E134, E1, D98, D87, D77, D67, D58, D47, D37, D27, D18, D127, D117, D108, CL94, CL80, CL63, CL48, CL4, CL33, CL2, CL134, CL132, CL122, CL110, CK91, CK82, CK70, CK60, CK6, CK51, CK42, CK23, CK14, CK135, CK132, CK130, CK122, CK106, CK1, CJ135, CJ134, CJ1, CH9, CH28, CH19, CH112, CH102, CE5, CE3, CE1, CC99, CC89, CC78, CC69, CC59, CC49, CC38, CC118, CC112, CC109, CB7, CB5, CB131, CB13, CB129, CB126, CB123, CB10, CA28, CA19, C135, C134, C1, BY5, BY3, BY135, BY133, BY131, BY13, BY123, BY1, BW92, BW81, BW71, BW62, BW52, BW41, BW31, BW22, BV7, BV5, BV131, BV13, BV129, BV126, BV123, BV10, BU112, BU102, BT5, BT3, BT135, BT133, BT131, BT13, BT123, BT1, BP99, BP89, BP78, BP69, BP59, BP49, BP38, BP28, BP19, BP118, BP109, BN7, BN5, BN131, BN13, BN129, BN126, BN123, BN10, BL5, BL3, BL135, BL133, BL131, BL13, BL123, BL1, BK92, BK81, BK71, BK62, BK52, BK41, BJ7, BJ5, BJ131, BJ13, BJ129, BJ126, BJ123, BJ10, BH31, BH22, BH112, BH102, BG5, BG3, BG135, BG133, BG131, BG13, BG123, BG1, BF96, BF79, BF7, BF61, BF5, BF43, BF131, BF13, BF129, BF126, BF123, BF10, BE90, BE72, BE53, BE5, BE40, BE36, BE32, BE3, BE16, BE135, BE133, BE131, BE13, BE123, BE120, BE104, BE1, BD93, BD79, BD7, BD68, BD57, BD5, BD46, BD40, BD32, BD29, BD25, BD21, BD131, BD13, 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
GNDSENSE | 1 | AU72
RREF_SDM | 1 | CL103
VCC | 41 | BA61, AY75, AY68, AY64, AY57, AY53, AW79, AW72, AW68, AW61, AW57, AV86, AV83, AV75, AV64, AV61, AV53, AU79, AU75, AU68, AU64, AU57, AU53, AT79, AT72, AT68, AT61, AT57, AR83, AR75, AR72, AR64, AR61, AR53, AP86, AP79, AP75, AP68, AP64, AN79, AN72
VCCADC | 1 | BD83
VCCBAT | 1 | BD86
VCCEHT_GTSL1A | 2 | AY111, AY107
VCCEHT_GTSL1B | 2 | AU111, AT111
VCCEHT_GTSL1C | 2 | AP111, AP107
VCCEHT_GTSR4A | 2 | AY29, AY25
VCCEHT_GTSR4B | 2 | AU25, AT25
VCCEHT_GTSR4C | 2 | AP29, AP25
VCCERT_GTSL1A | 3 | AY96, AY100, AW100
VCCERT_GTSL1B | 3 | AV100, AU96, AU100
VCCERT_GTSL1C | 3 | AR100, AP96, AP100
VCCERT_GTSR4A | 3 | AY40, AY36, AW36
VCCERT_GTSR4B | 3 | AV36, AU40, AU36
VCCERT_GTSR4C | 3 | AR36, AP40, AP36
VCCFUSEWR_SDM | 1 | BC86
VCCH_SDM | 1 | BA86
VCCIO_HPS | 2 | AL90, AK90
VCCIO_HVIO_5A | 2 | BD96, BC96
VCCIO_HVIO_5B | 2 | BB96, BB93
VCCIO_HVIO_6A | 2 | BB43, BB40
VCCIO_HVIO_6B | 2 | BD43, BC43
VCCIO_HVIO_6C | 2 | AL40, AK40
VCCIO_HVIO_6D | 2 | AG46, AG43
VCCIO_PIO_2A_B | 2 | BD72, BC68
VCCIO_PIO_2A_T | 2 | BD61, BC64
VCCIO_PIO_2B_B | 2 | BC57, BC53
VCCIO_PIO_2B_T | 2 | BD50, BC46
VCCIO_PIO_3A_B | 2 | AL75, AK72
VCCIO_PIO_3A_T | 2 | AL64, AK68
VCCIO_PIO_3B_B | 2 | AK61, AK57
VCCIO_PIO_3B_T | 2 | AL53, AK50
VCCIO_PIO_SDM | 1 | AW83
VCCIO_SDM | 1 | BD75
VCCLSENSE | 1 | AV72
VCCL_ADC_SDM | 1 | AY86
VCCL_HPS | 4 | AN83, AM83, AL86, AK83
VCCL_HPS_CORE0_CORE1 | 2 | AL79, AK79
VCCL_HPS_CORE2 | 2 | AL96, AK93
VCCL_HPS_CORE3 | 2 | AM100, AL100
VCCL_SDM | 4 | BB83, BB79, BA83, AY79
VCCP | 14 | BB72, BB68, BB61, BB57, BB50, BA64, BA53, AN68, AN57, AM75, AM72, AM64, AM61, AM53
VCCPLL1_HPS | 1 | AM93
VCCPLL2_HPS | 1 | AN90
VCCPLLDIG1_HPS | 1 | AM96
VCCPLLDIG2_HPS | 1 | AM86
VCCPLLDIG_SDM | 1 | BC75
VCCPLL_SDM | 1 | BC79
VCCPT | 4 | BA75, BA72, AP57, AN61
VCCPT_HVIO | 6 | BC90, BB90, BB46, BA50, AL46, AK46
VCCRCORE | 3 | AU86, AT83, AR86
VCC_HSSI_L1 | 11 | AY93, AY90, AW93, AV93, AV90, AU93, AT93, AT90, AR93, AP93, AP90
VCC_HSSI_R4 | 11 | AY46, AY43, AW43, AV46, AV43, AU43, AT46, AT43, AR43, AP46, AP43
VCC_IO_SDM | 1 | BD90

Sheet: Mechanical_Checks
Check | Sheet | Row | Column | Value | Finding
tbd_source_review | Min_System_Pin_Assign | 21 | Status | TBD-source | Ref net: TP_SDM_IO8. Needs final flash topology.
tbd_source_review | Min_System_Pin_Assign | 22 | Status | TBD-source | Ref net: PMBUS_SCL_C2M_1V8. Populate if SmartVID/PMBus required.
tbd_source_review | Min_System_Pin_Assign | 23 | Status | TBD-source | Ref net: PMBUS_SDA_C2M_1V8. This replaces earlier BR99 SDA draft.
tbd_source_review | Min_System_Pin_Assign | 24 | Status | TBD-source | Ref net: CAT_TRIP_N_1V8.
tbd_source_review | Min_System_Pin_Assign | 25 | Status | TBD-source | Ref net: SEU_ERROR_M2C_1V8.
tbd_source_review | Min_System_Pin_Assign | 26 | Status | TBD-source | Ref net: A5E_HPS_COLD_NRESET_1V8.
tbd_source_review | Min_System_Pin_Assign | 27 | Status | TBD-source | Not used by AS x4 baseline.
