joyhpc/misc-tasks/a5ed065b_b32a_lpddr5/sourcing/lpddr5_reply_drafts.md

# LPDDR5 邮件回复草稿

## 发给采购 Alina 的内部处理意见

Alina，

我看了这几封供应商回复，结论如下：

1. 南亚目前没有 LPDDR5，可以关闭这条路线。
2. 三星目前没有匹配我们需求的可推荐产品。对方提到的 `K3KL8L80DM-TGCT` 是 LPDDR5X 32Gb / x32 / 245FBGA，消费类，样品预计 5 月底或 6 月中，生命周期通常 2-3 年，不满足我们要求的 5-8 年。
3. 美光是目前唯一有明确可推进料号的路线，但不是 2GB，而是 4GB 起步。推荐料号是 `MT62F1G32D2DS-020 WT:D`，LPDDR5X，4GB / 32Gb，x32，9600 Mb/s，可考虑按主控 3733 MT/s 降频使用。
4. 美光旧的 2GB x32 相关料号存在 EOL/停产风险，不适合作为长期供货方案。

建议采购继续向美光代理确认以下信息：

- `MT62F1G32D2DS-020 WT:D` 是否可以按商业级供货，温度等级如何定义；
- 当前 sample / 小批量 / 量产 lead time；
- 价格阶梯；
- 官方生命周期承诺，是否能覆盖未来 5-8 年；
- 如果我们必须坚持 2GB / 16Gb x32，是否还有非 EOL、可长期供货的替代料号；
- 是否有推荐的 5500/6400 MT/s 长生命周期料号，而不是只能上 9600 MT/s 料号降频。

硬件侧我建议同步评估：是否接受单颗容量从 2GB 上浮到 4GB；如果接受，则先用美光 `MT62F1G32D2DS-020 WT:D` 做封装、pinout、供电和 Agilex 5 EMIF/Quartus 可行性验证。

## 回复美光/WT Microelectronics 的信息收集模板

Hi Kun / Brandon，

感谢推荐。我们这边初步可以评估 `MT62F1G32D2DS-020 WT:D`，但需要先确认几个问题：

1. 该料号是否为长期主推料号？是否可以支持未来 5-8 年供货周期？
2. `WT:D` 对应的温度等级和供货等级请帮忙确认一下。
3. 当前样品、小批量和量产 lead time 分别是多少？
4. 请提供价格阶梯和 MOQ / MPQ。
5. 如果我们原需求坚持 2GB / 16Gb、x32、LPDDR5/LPDDR5X、商业级、5-8 年无 EOL，是否还有其他可推荐料号？
6. 该 9600 MT/s 料号是否适合在 3733 MT/s 主控下长期降频使用？是否有需要注意的初始化、ODT、training 或 SI 要点？

项目信息如下，供原厂评估：

- 终端客户：待确认
- 项目名称：A38 / DF108 Agilex 5
- 应用：工业相机 / FPGA 图像处理板卡
- 试产时间：待确认
- 量产时间：待确认
- 主芯片：Intel Agilex 5，当前按 A5ED052A B32A 方向评估
- 年用量：待采购/项目确认
- 每片用量：暂按 2 颗 x32 LPDDR5/LPDDR5X 规划，最终以原理图和 Quartus EMIF 验证为准

谢谢。

## 回复三星渠道的建议

Hi Link，

收到，谢谢确认。由于我们这个项目要求未来 5-8 年生命周期，目前消费类 2-3 年生命周期的 LP5X 245ball 产品暂时不适合作为主推方案。

这边先不按该料号推进。如果后续三星有 x32、长期供货、商业级或工业级、生命周期可覆盖 5-8 年的 LPDDR5/LPDDR5X 料号，请再帮忙推荐。

谢谢。

## 催 Henry 的简短版本

Hi Henry，

麻烦帮忙确认一下是否有符合以下条件的 LPDDR5/LPDDR5X 颗粒：

- 单颗 2GB / 16Gb
- x32
- Standard BGA
- 商业级即可
- 主控最高 3733 MT/s，可接受 5500/6400/更高速率料号降频使用
- 要求未来 5-8 年无 EOL 风险

如果 2GB x32 已经无长期供货方案，也请直接帮忙反馈可替代的 x32 4GB 长生命周期料号。

谢谢。
