joyhpc/misc-tasks/a5ed065b_b32a_lpddr5/pin_assign/pin_characteristics_summary.xlsx

Sheet: README
field | value
Workbook purpose | LPDDR5 pin characteristics, net matching, and expandable review fields
Output | pin_characteristics_summary.xlsx
FPGA input | fpga_side/fpga_pin_assign_orcad_format_hsio2b_3a_lpddr5.xlsx
Memory U0 input | memory_side/lpddr5_315_DR_DS_U0_Bank2B_pin_net.tsv
Memory U1 input | memory_side/lpddr5_315_DR_DS_U1_Bank3A_pin_net.tsv
Important rule | Compare unique FPGA-connected nets, not memory-side physical pin rows
Why memory rows are larger | LPDDR5 CA/CK/WCK/CS shared x32 nets appear on both channel A and channel B balls
FPGA-only expected nets | FPGA_RZQ, REFCLK_N, REFCLK_P
Memory-local expected net | ZQ_A_240R_TO_VDDQ, local 240 ohm to VDDQ

Sheet: overview
unit | fpga_bank | memory_physical_pin_rows | memory_unique_all_nets | memory_unique_fpga_connected_nets | fpga_net_entries | fpga_unique_nets | missing_in_fpga_count | missing_in_fpga | fpga_only_count | fpga_only_expected | match_status
U0 | Bank2B | 76 | 61 | 60 | 63 | 63 | 0 |  | 3 | LP5_U0_FPGA_RZQ, LP5_U0_REFCLK_N, LP5_U0_REFCLK_P | PASS
U1 | Bank3A | 76 | 61 | 60 | 63 | 63 | 0 |  | 3 | LP5_U1_FPGA_RZQ, LP5_U1_REFCLK_N, LP5_U1_REFCLK_P | PASS

Sheet: net_summary
unit | net_name | signal_class | signal_index | diff_role | byte_lane_or_group | route_class | memory_channel_scope | shared_on_memory_side | memory_pin_count | memory_balls | memory_pins | fpga_pin_count | fpga_pins | fpga_pin_indices | fpga_signals | expected_memory_pin_count | net_match_status | count_status | impedance_rule | length_match_group | layout_status | review_owner | review_status
U0 | LP5_U0_CA0 | CA | 0 |  |  | command_address_control | A/B | yes | 2 | G4, R12 | CA0_A, CA0_B | 1 | CF52 | 24 | CA0 | 2 | MATCH | OK
U0 | LP5_U0_CA1 | CA | 1 |  |  | command_address_control | A/B | yes | 2 | H5, P11 | CA1_A, CA1_B | 1 | CH52 | 25 | CA1 | 2 | MATCH | OK
U0 | LP5_U0_CA2 | CA | 2 |  |  | command_address_control | A/B | yes | 2 | G8, R8 | CA2_A, CA2_B | 1 | CC52 | 26 | CA2 | 2 | MATCH | OK
U0 | LP5_U0_CA3 | CA | 3 |  |  | command_address_control | A/B | yes | 2 | H11, P5 | CA3_A, CA3_B | 1 | CA52 | 27 | CA3 | 2 | MATCH | OK
U0 | LP5_U0_CA4 | CA | 4 |  |  | command_address_control | A/B | yes | 2 | G10, R6 | CA4_A, CA4_B | 1 | CC41 | 32 | CA4 | 2 | MATCH | OK
U0 | LP5_U0_CA5 | CA | 5 |  |  | command_address_control | A/B | yes | 2 | H13, P3 | CA5_A, CA5_B | 1 | CA41 | 33 | CA5 | 2 | MATCH | OK
U0 | LP5_U0_CA6 | CA | 6 |  |  | command_address_control | A/B | yes | 2 | G12, R4 | CA6_A, CA6_B | 1 | BW49 | 40 | CA6 | 2 | MATCH | OK
U0 | LP5_U0_CK_C | CK |  | C |  | differential_clock | A/B | yes | 2 | J9, N7 | CK_c_A, CK_c_B | 1 | BU41 | 43 | CK_C | 2 | MATCH | OK
U0 | LP5_U0_CK_T | CK |  | T |  | differential_clock | A/B | yes | 2 | H9, P7 | CK_t_A, CK_t_B | 1 | BR41 | 42 | CK_T | 2 | MATCH | OK
U0 | LP5_U0_CS0 | CS | 0 |  |  | command_address_control | A/B | yes | 2 | H7, P9 | CS0_A, CS0_B | 1 | CA49 | 41 | CS0 | 2 | MATCH | OK
U0 | LP5_U0_CS1 | CS | 1 |  |  | command_address_control | A/B | yes | 2 | G6, R10 | CS1_A, CS1_B | 1 | BR38 | 44 | CS1 | 2 | MATCH | OK
U0 | LP5_U0_DMI0 | DMI | 0 |  | byte0 | byte_lane_data | A | no | 1 | A4 | DMI0_A | 1 | CL56 | 6 | DMI0 | 1 | MATCH | OK
U0 | LP5_U0_DMI1 | DMI | 1 |  | byte1 | byte_lane_data | A | no | 1 | A12 | DMI1_A | 1 | CK35 | 18 | DMI1 | 1 | MATCH | OK
U0 | LP5_U0_DMI2 | DMI | 2 |  | byte2 | byte_lane_data | B | no | 1 | AA12 | DMI0_B | 1 | CL14 | 78 | DMI2 | 1 | MATCH | OK
U0 | LP5_U0_DMI3 | DMI | 3 |  | byte3 | byte_lane_data | B | no | 1 | AA4 | DMI1_B | 1 | CC22 | 90 | DMI3 | 1 | MATCH | OK
U0 | LP5_U0_DQ0 | DQ | 0 |  | byte0 | byte_lane_data | A | no | 1 | D1 | DQ0_A | 1 | CK66 | 0 | DQ0 | 1 | MATCH | OK
U0 | LP5_U0_DQ1 | DQ | 1 |  | byte0 | byte_lane_data | A | no | 1 | C2 | DQ1_A | 1 | CL70 | 1 | DQ1 | 1 | MATCH | OK
U0 | LP5_U0_DQ10 | DQ | 10 |  | byte1 | byte_lane_data | A | no | 1 | E14 | DQ10_A | 1 | CK48 | 14 | DQ10 | 1 | MATCH | OK
U0 | LP5_U0_DQ11 | DQ | 11 |  | byte1 | byte_lane_data | A | no | 1 | D13 | DQ11_A | 1 | CL45 | 15 | DQ11 | 1 | MATCH | OK
U0 | LP5_U0_DQ12 | DQ | 12 |  | byte1 | byte_lane_data | A | no | 1 | B11 | DQ12_A | 1 | CK33 | 20 | DQ12 | 1 | MATCH | OK
U0 | LP5_U0_DQ13 | DQ | 13 |  | byte1 | byte_lane_data | A | no | 1 | C10 | DQ13_A | 1 | CL30 | 21 | DQ13 | 1 | MATCH | OK
U0 | LP5_U0_DQ14 | DQ | 14 |  | byte1 | byte_lane_data | A | no | 1 | E10 | DQ14_A | 1 | CK30 | 22 | DQ14 | 1 | MATCH | OK
U0 | LP5_U0_DQ15 | DQ | 15 |  | byte1 | byte_lane_data | A | no | 1 | F11 | DQ15_A | 1 | CL26 | 23 | DQ15 | 1 | MATCH | OK
U0 | LP5_U0_DQ16 | DQ | 16 |  | byte2 | byte_lane_data | B | no | 1 | V15 | DQ0_B | 1 | CL23 | 72 | DQ16 | 1 | MATCH | OK
U0 | LP5_U0_DQ17 | DQ | 17 |  | byte2 | byte_lane_data | B | no | 1 | W14 | DQ1_B | 1 | CK26 | 73 | DQ17 | 1 | MATCH | OK
U0 | LP5_U0_DQ18 | DQ | 18 |  | byte2 | byte_lane_data | B | no | 1 | U14 | DQ2_B | 1 | CL20 | 74 | DQ18 | 1 | MATCH | OK
U0 | LP5_U0_DQ19 | DQ | 19 |  | byte2 | byte_lane_data | B | no | 1 | V13 | DQ3_B | 1 | CK20 | 75 | DQ19 | 1 | MATCH | OK
U0 | LP5_U0_DQ2 | DQ | 2 |  | byte0 | byte_lane_data | A | no | 1 | E2 | DQ2_A | 1 | CK73 | 2 | DQ2 | 1 | MATCH | OK
U0 | LP5_U0_DQ20 | DQ | 20 |  | byte2 | byte_lane_data | B | no | 1 | Y11 | DQ4_B | 1 | CK11 | 80 | DQ20 | 1 | MATCH | OK
U0 | LP5_U0_DQ21 | DQ | 21 |  | byte2 | byte_lane_data | B | no | 1 | W10 | DQ5_B | 1 | CL8 | 81 | DQ21 | 1 | MATCH | OK
U0 | LP5_U0_DQ22 | DQ | 22 |  | byte2 | byte_lane_data | B | no | 1 | U10 | DQ6_B | 1 | CK8 | 82 | DQ22 | 1 | MATCH | OK
U0 | LP5_U0_DQ23 | DQ | 23 |  | byte2 | byte_lane_data | B | no | 1 | T11 | DQ7_B | 1 | CL6 | 83 | DQ23 | 1 | MATCH | OK
U0 | LP5_U0_DQ24 | DQ | 24 |  | byte3 | byte_lane_data | B | no | 1 | V1 | DQ8_B | 1 | CH31 | 84 | DQ24 | 1 | MATCH | OK
U0 | LP5_U0_DQ25 | DQ | 25 |  | byte3 | byte_lane_data | B | no | 1 | W2 | DQ9_B | 1 | CF31 | 85 | DQ25 | 1 | MATCH | OK
U0 | LP5_U0_DQ26 | DQ | 26 |  | byte3 | byte_lane_data | B | no | 1 | U2 | DQ10_B | 1 | CA31 | 86 | DQ26 | 1 | MATCH | OK
U0 | LP5_U0_DQ27 | DQ | 27 |  | byte3 | byte_lane_data | B | no | 1 | V3 | DQ11_B | 1 | CC31 | 87 | DQ27 | 1 | MATCH | OK
U0 | LP5_U0_DQ28 | DQ | 28 |  | byte3 | byte_lane_data | B | no | 1 | Y5 | DQ12_B | 1 | CF22 | 92 | DQ28 | 1 | MATCH | OK
U0 | LP5_U0_DQ29 | DQ | 29 |  | byte3 | byte_lane_data | B | no | 1 | W6 | DQ13_B | 1 | CH22 | 93 | DQ29 | 1 | MATCH | OK
U0 | LP5_U0_DQ3 | DQ | 3 |  | byte0 | byte_lane_data | A | no | 1 | D3 | DQ3_A | 1 | CL73 | 3 | DQ3 | 1 | MATCH | OK
U0 | LP5_U0_DQ30 | DQ | 30 |  | byte3 | byte_lane_data | B | no | 1 | U6 | DQ14_B | 1 | CF19 | 94 | DQ30 | 1 | MATCH | OK
U0 | LP5_U0_DQ31 | DQ | 31 |  | byte3 | byte_lane_data | B | no | 1 | T5 | DQ15_B | 1 | CC19 | 95 | DQ31 | 1 | MATCH | OK
U0 | LP5_U0_DQ4 | DQ | 4 |  | byte0 | byte_lane_data | A | no | 1 | B5 | DQ4_A | 1 | CK56 | 8 | DQ4 | 1 | MATCH | OK
U0 | LP5_U0_DQ5 | DQ | 5 |  | byte0 | byte_lane_data | A | no | 1 | C6 | DQ5_A | 1 | CL54 | 9 | DQ5 | 1 | MATCH | OK
U0 | LP5_U0_DQ6 | DQ | 6 |  | byte0 | byte_lane_data | A | no | 1 | E6 | DQ6_A | 1 | CL51 | 10 | DQ6 | 1 | MATCH | OK
U0 | LP5_U0_DQ7 | DQ | 7 |  | byte0 | byte_lane_data | A | no | 1 | F5 | DQ7_A | 1 | CK54 | 11 | DQ7 | 1 | MATCH | OK
U0 | LP5_U0_DQ8 | DQ | 8 |  | byte1 | byte_lane_data | A | no | 1 | D15 | DQ8_A | 1 | CL42 | 12 | DQ8 | 1 | MATCH | OK
U0 | LP5_U0_DQ9 | DQ | 9 |  | byte1 | byte_lane_data | A | no | 1 | C14 | DQ9_A | 1 | CK45 | 13 | DQ9 | 1 | MATCH | OK
U0 | LP5_U0_FPGA_RZQ | FPGA_RZQ |  |  |  | reference_resistor |  | no | 0 |  |  | 1 | BR52 | 38 | FPGA_RZQ | 0 | FPGA_ONLY_EXPECTED | OK_FPGA_ONLY
U0 | LP5_U0_RDQS0_C | RDQS | 0 | C | byte0 | byte_lane_data | A | no | 1 | C4 | RDQS0_c_A | 1 | CL66 | 5 | RDQS0_C | 1 | MATCH | OK
U0 | LP5_U0_RDQS0_T | RDQS | 0 | T | byte0 | byte_lane_data | A | no | 1 | B3 | RDQS0_t_A | 1 | CK63 | 4 | RDQS0_T | 1 | MATCH | OK
U0 | LP5_U0_RDQS1_C | RDQS | 1 | C | byte1 | byte_lane_data | A | no | 1 | C12 | RDQS1_c_A | 1 | CL39 | 17 | RDQS1_C | 1 | MATCH | OK
U0 | LP5_U0_RDQS1_T | RDQS | 1 | T | byte1 | byte_lane_data | A | no | 1 | B13 | RDQS1_t_A | 1 | CK39 | 16 | RDQS1_T | 1 | MATCH | OK
U0 | LP5_U0_RDQS2_C | RDQS | 2 | C | byte2 | byte_lane_data | B | no | 1 | W12 | RDQS0_c_B | 1 | CL17 | 77 | RDQS2_C | 1 | MATCH | OK
U0 | LP5_U0_RDQS2_T | RDQS | 2 | T | byte2 | byte_lane_data | B | no | 1 | Y13 | RDQS0_t_B | 1 | CK17 | 76 | RDQS2_T | 1 | MATCH | OK
U0 | LP5_U0_RDQS3_C | RDQS | 3 | C | byte3 | byte_lane_data | B | no | 1 | W4 | RDQS1_c_B | 1 | CC28 | 89 | RDQS3_C | 1 | MATCH | OK
U0 | LP5_U0_RDQS3_T | RDQS | 3 | T | byte3 | byte_lane_data | B | no | 1 | Y3 | RDQS1_t_B | 1 | CF28 | 88 | RDQS3_T | 1 | MATCH | OK
U0 | LP5_U0_REFCLK_N | REFCLK |  | N |  | fpga_reference_clock |  | no | 0 |  |  | 1 | CF38 | 35 | REFCLK_N | 0 | FPGA_ONLY_EXPECTED | OK_FPGA_ONLY
U0 | LP5_U0_REFCLK_P | REFCLK |  | P |  | fpga_reference_clock |  | no | 0 |  |  | 1 | CH38 | 34 | REFCLK_P | 0 | FPGA_ONLY_EXPECTED | OK_FPGA_ONLY
U0 | LP5_U0_RESET_N | RESET_N |  | N |  | command_address_control | common | no | 1 | H1 | RESET_N | 1 | BU52 | 39 | RESET_N | 1 | MATCH | OK
U0 | LP5_U0_WCK0_C | WCK | 0 | C | wck0 | differential_clock | A/B | yes | 2 | D5, V11 | WCK0_c_A, WCK0_c_B | 1 | CH49 | 29 | WCK0_C | 2 | MATCH | OK
U0 | LP5_U0_WCK0_T | WCK | 0 | T | wck0 | differential_clock | A/B | yes | 2 | E4, U12 | WCK0_t_A, WCK0_t_B | 1 | CF49 | 28 | WCK0_T | 2 | MATCH | OK
U0 | LP5_U0_WCK1_C | WCK | 1 | C | wck1 | differential_clock | A/B | yes | 2 | D11, V5 | WCK1_c_A, WCK1_c_B | 1 | CF41 | 31 | WCK1_C | 2 | MATCH | OK
U0 | LP5_U0_WCK1_T | WCK | 1 | T | wck1 | differential_clock | A/B | yes | 2 | E12, U4 | WCK1_t_A, WCK1_t_B | 1 | CH41 | 30 | WCK1_T | 2 | MATCH | OK
U0 | LP5_U0_ZQ_A_240R_TO_VDDQ | MEMORY_LOCAL_ZQ |  |  |  | reference_resistor | A | no | 1 | H15 | ZQ_A | 0 |  |  |  | 1 | MEMORY_LOCAL | OK
U1 | LP5_U1_CA0 | CA | 0 |  |  | command_address_control | A/B | yes | 2 | G4, R12 | CA0_A, CA0_B | 1 | T114 | 24 | CA0 | 2 | MATCH | OK
U1 | LP5_U1_CA1 | CA | 1 |  |  | command_address_control | A/B | yes | 2 | H5, P11 | CA1_A, CA1_B | 1 | P114 | 25 | CA1 | 2 | MATCH | OK
U1 | LP5_U1_CA2 | CA | 2 |  |  | command_address_control | A/B | yes | 2 | G8, R8 | CA2_A, CA2_B | 1 | V117 | 26 | CA2 | 2 | MATCH | OK
U1 | LP5_U1_CA3 | CA | 3 |  |  | command_address_control | A/B | yes | 2 | H11, P5 | CA3_A, CA3_B | 1 | T117 | 27 | CA3 | 2 | MATCH | OK
U1 | LP5_U1_CA4 | CA | 4 |  |  | command_address_control | A/B | yes | 2 | G10, R6 | CA4_A, CA4_B | 1 | T105 | 32 | CA4 | 2 | MATCH | OK
U1 | LP5_U1_CA5 | CA | 5 |  |  | command_address_control | A/B | yes | 2 | H13, P3 | CA5_A, CA5_B | 1 | P105 | 33 | CA5 | 2 | MATCH | OK
U1 | LP5_U1_CA6 | CA | 6 |  |  | command_address_control | A/B | yes | 2 | G12, R4 | CA6_A, CA6_B | 1 | Y114 | 40 | CA6 | 2 | MATCH | OK
U1 | LP5_U1_CK_C | CK |  | C |  | differential_clock | A/B | yes | 2 | J9, N7 | CK_c_A, CK_c_B | 1 | AK104 | 43 | CK_C | 2 | MATCH | OK
U1 | LP5_U1_CK_T | CK |  | T |  | differential_clock | A/B | yes | 2 | H9, P7 | CK_t_A, CK_t_B | 1 | AK107 | 42 | CK_T | 2 | MATCH | OK
U1 | LP5_U1_CS0 | CS | 0 |  |  | command_address_control | A/B | yes | 2 | H7, P9 | CS0_A, CS0_B | 1 | AB114 | 41 | CS0 | 2 | MATCH | OK
U1 | LP5_U1_CS1 | CS | 1 |  |  | command_address_control | A/B | yes | 2 | G6, R10 | CS1_A, CS1_B | 1 | Y108 | 44 | CS1 | 2 | MATCH | OK
U1 | LP5_U1_DMI0 | DMI | 0 |  | byte0 | byte_lane_data | A | no | 1 | A4 | DMI0_A | 1 | B119 | 6 | DMI0 | 1 | MATCH | OK
U1 | LP5_U1_DMI1 | DMI | 1 |  | byte1 | byte_lane_data | A | no | 1 | A12 | DMI1_A | 1 | F105 | 18 | DMI1 | 1 | MATCH | OK
U1 | LP5_U1_DMI2 | DMI | 2 |  | byte2 | byte_lane_data | B | no | 1 | AA12 | DMI0_B | 1 | H87 | 78 | DMI2 | 1 | MATCH | OK
U1 | LP5_U1_DMI3 | DMI | 3 |  | byte3 | byte_lane_data | B | no | 1 | AA4 | DMI1_B | 1 | B97 | 90 | DMI3 | 1 | MATCH | OK
U1 | LP5_U1_DQ0 | DQ | 0 |  | byte0 | byte_lane_data | A | no | 1 | D1 | DQ0_A | 1 | B128 | 0 | DQ0 | 1 | MATCH | OK
U1 | LP5_U1_DQ1 | DQ | 1 |  | byte0 | byte_lane_data | A | no | 1 | C2 | DQ1_A | 1 | A128 | 1 | DQ1 | 1 | MATCH | OK
U1 | LP5_U1_DQ10 | DQ | 10 |  | byte1 | byte_lane_data | A | no | 1 | E14 | DQ10_A | 1 | K117 | 14 | DQ10 | 1 | MATCH | OK
U1 | LP5_U1_DQ11 | DQ | 11 |  | byte1 | byte_lane_data | A | no | 1 | D13 | DQ11_A | 1 | M117 | 15 | DQ11 | 1 | MATCH | OK
U1 | LP5_U1_DQ12 | DQ | 12 |  | byte1 | byte_lane_data | A | no | 1 | B11 | DQ12_A | 1 | H108 | 20 | DQ12 | 1 | MATCH | OK
U1 | LP5_U1_DQ13 | DQ | 13 |  | byte1 | byte_lane_data | A | no | 1 | C10 | DQ13_A | 1 | F108 | 21 | DQ13 | 1 | MATCH | OK
U1 | LP5_U1_DQ14 | DQ | 14 |  | byte1 | byte_lane_data | A | no | 1 | E10 | DQ14_A | 1 | M108 | 22 | DQ14 | 1 | MATCH | OK
U1 | LP5_U1_DQ15 | DQ | 15 |  | byte1 | byte_lane_data | A | no | 1 | F11 | DQ15_A | 1 | K108 | 23 | DQ15 | 1 | MATCH | OK
U1 | LP5_U1_DQ16 | DQ | 16 |  | byte2 | byte_lane_data | B | no | 1 | V15 | DQ0_B | 1 | H98 | 72 | DQ16 | 1 | MATCH | OK
U1 | LP5_U1_DQ17 | DQ | 17 |  | byte2 | byte_lane_data | B | no | 1 | W14 | DQ1_B | 1 | F98 | 73 | DQ17 | 1 | MATCH | OK
U1 | LP5_U1_DQ18 | DQ | 18 |  | byte2 | byte_lane_data | B | no | 1 | U14 | DQ2_B | 1 | M98 | 74 | DQ18 | 1 | MATCH | OK
U1 | LP5_U1_DQ19 | DQ | 19 |  | byte2 | byte_lane_data | B | no | 1 | V13 | DQ3_B | 1 | K98 | 75 | DQ19 | 1 | MATCH | OK
U1 | LP5_U1_DQ2 | DQ | 2 |  | byte0 | byte_lane_data | A | no | 1 | E2 | DQ2_A | 1 | B130 | 2 | DQ2 | 1 | MATCH | OK
U1 | LP5_U1_DQ20 | DQ | 20 |  | byte2 | byte_lane_data | B | no | 1 | Y11 | DQ4_B | 1 | K87 | 80 | DQ20 | 1 | MATCH | OK
U1 | LP5_U1_DQ21 | DQ | 21 |  | byte2 | byte_lane_data | B | no | 1 | W10 | DQ5_B | 1 | M87 | 81 | DQ21 | 1 | MATCH | OK
U1 | LP5_U1_DQ22 | DQ | 22 |  | byte2 | byte_lane_data | B | no | 1 | U10 | DQ6_B | 1 | F84 | 82 | DQ22 | 1 | MATCH | OK
U1 | LP5_U1_DQ23 | DQ | 23 |  | byte2 | byte_lane_data | B | no | 1 | T11 | DQ7_B | 1 | D84 | 83 | DQ23 | 1 | MATCH | OK
U1 | LP5_U1_DQ24 | DQ | 24 |  | byte3 | byte_lane_data | B | no | 1 | V1 | DQ8_B | 1 | A106 | 84 | DQ24 | 1 | MATCH | OK
U1 | LP5_U1_DQ25 | DQ | 25 |  | byte3 | byte_lane_data | B | no | 1 | W2 | DQ9_B | 1 | B103 | 85 | DQ25 | 1 | MATCH | OK
U1 | LP5_U1_DQ26 | DQ | 26 |  | byte3 | byte_lane_data | B | no | 1 | U2 | DQ10_B | 1 | B106 | 86 | DQ26 | 1 | MATCH | OK
U1 | LP5_U1_DQ27 | DQ | 27 |  | byte3 | byte_lane_data | B | no | 1 | V3 | DQ11_B | 1 | A110 | 87 | DQ27 | 1 | MATCH | OK
U1 | LP5_U1_DQ28 | DQ | 28 |  | byte3 | byte_lane_data | B | no | 1 | Y5 | DQ12_B | 1 | B91 | 92 | DQ28 | 1 | MATCH | OK
U1 | LP5_U1_DQ29 | DQ | 29 |  | byte3 | byte_lane_data | B | no | 1 | W6 | DQ13_B | 1 | A94 | 93 | DQ29 | 1 | MATCH | OK
U1 | LP5_U1_DQ3 | DQ | 3 |  | byte0 | byte_lane_data | A | no | 1 | D3 | DQ3_A | 1 | A130 | 3 | DQ3 | 1 | MATCH | OK
U1 | LP5_U1_DQ30 | DQ | 30 |  | byte3 | byte_lane_data | B | no | 1 | U6 | DQ14_B | 1 | B88 | 94 | DQ30 | 1 | MATCH | OK
U1 | LP5_U1_DQ31 | DQ | 31 |  | byte3 | byte_lane_data | B | no | 1 | T5 | DQ15_B | 1 | A91 | 95 | DQ31 | 1 | MATCH | OK
U1 | LP5_U1_DQ4 | DQ | 4 |  | byte0 | byte_lane_data | A | no | 1 | B5 | DQ4_A | 1 | B116 | 8 | DQ4 | 1 | MATCH | OK
U1 | LP5_U1_DQ5 | DQ | 5 |  | byte0 | byte_lane_data | A | no | 1 | C6 | DQ5_A | 1 | A116 | 9 | DQ5 | 1 | MATCH | OK
U1 | LP5_U1_DQ6 | DQ | 6 |  | byte0 | byte_lane_data | A | no | 1 | E6 | DQ6_A | 1 | B113 | 10 | DQ6 | 1 | MATCH | OK
U1 | LP5_U1_DQ7 | DQ | 7 |  | byte0 | byte_lane_data | A | no | 1 | F5 | DQ7_A | 1 | A113 | 11 | DQ7 | 1 | MATCH | OK
U1 | LP5_U1_DQ8 | DQ | 8 |  | byte1 | byte_lane_data | A | no | 1 | D15 | DQ8_A | 1 | F117 | 12 | DQ8 | 1 | MATCH | OK
U1 | LP5_U1_DQ9 | DQ | 9 |  | byte1 | byte_lane_data | A | no | 1 | C14 | DQ9_A | 1 | H117 | 13 | DQ9 | 1 | MATCH | OK
U1 | LP5_U1_FPGA_RZQ | FPGA_RZQ |  |  |  | reference_resistor |  | no | 0 |  |  | 1 | AK111 | 38 | FPGA_RZQ | 0 | FPGA_ONLY_EXPECTED | OK_FPGA_ONLY
U1 | LP5_U1_RDQS0_C | RDQS | 0 | C | byte0 | byte_lane_data | A | no | 1 | C4 | RDQS0_c_A | 1 | A125 | 5 | RDQS0_C | 1 | MATCH | OK
U1 | LP5_U1_RDQS0_T | RDQS | 0 | T | byte0 | byte_lane_data | A | no | 1 | B3 | RDQS0_t_A | 1 | B122 | 4 | RDQS0_T | 1 | MATCH | OK
U1 | LP5_U1_RDQS1_C | RDQS | 1 | C | byte1 | byte_lane_data | A | no | 1 | C12 | RDQS1_c_A | 1 | D114 | 17 | RDQS1_C | 1 | MATCH | OK
U1 | LP5_U1_RDQS1_T | RDQS | 1 | T | byte1 | byte_lane_data | A | no | 1 | B13 | RDQS1_t_A | 1 | F114 | 16 | RDQS1_T | 1 | MATCH | OK
U1 | LP5_U1_RDQS2_C | RDQS | 2 | C | byte2 | byte_lane_data | B | no | 1 | W12 | RDQS0_c_B | 1 | D95 | 77 | RDQS2_C | 1 | MATCH | OK
U1 | LP5_U1_RDQS2_T | RDQS | 2 | T | byte2 | byte_lane_data | B | no | 1 | Y13 | RDQS0_t_B | 1 | F95 | 76 | RDQS2_T | 1 | MATCH | OK
U1 | LP5_U1_RDQS3_C | RDQS | 3 | C | byte3 | byte_lane_data | B | no | 1 | W4 | RDQS1_c_B | 1 | B101 | 89 | RDQS3_C | 1 | MATCH | OK
U1 | LP5_U1_RDQS3_T | RDQS | 3 | T | byte3 | byte_lane_data | B | no | 1 | Y3 | RDQS1_t_B | 1 | A101 | 88 | RDQS3_T | 1 | MATCH | OK
U1 | LP5_U1_REFCLK_N | REFCLK |  | N |  | fpga_reference_clock |  | no | 0 |  |  | 1 | K105 | 35 | REFCLK_N | 0 | FPGA_ONLY_EXPECTED | OK_FPGA_ONLY
U1 | LP5_U1_REFCLK_P | REFCLK |  | P |  | fpga_reference_clock |  | no | 0 |  |  | 1 | M105 | 34 | REFCLK_P | 0 | FPGA_ONLY_EXPECTED | OK_FPGA_ONLY
U1 | LP5_U1_RESET_N | RESET_N |  | N |  | command_address_control | common | no | 1 | H1 | RESET_N | 1 | AG111 | 39 | RESET_N | 1 | MATCH | OK
U1 | LP5_U1_WCK0_C | WCK | 0 | C | wck0 | differential_clock | A/B | yes | 2 | D5, V11 | WCK0_c_A, WCK0_c_B | 1 | K114 | 29 | WCK0_C | 2 | MATCH | OK
U1 | LP5_U1_WCK0_T | WCK | 0 | T | wck0 | differential_clock | A/B | yes | 2 | E4, U12 | WCK0_t_A, WCK0_t_B | 1 | M114 | 28 | WCK0_T | 2 | MATCH | OK
U1 | LP5_U1_WCK1_C | WCK | 1 | C | wck1 | differential_clock | A/B | yes | 2 | D11, V5 | WCK1_c_A, WCK1_c_B | 1 | T108 | 31 | WCK1_C | 2 | MATCH | OK
U1 | LP5_U1_WCK1_T | WCK | 1 | T | wck1 | differential_clock | A/B | yes | 2 | E12, U4 | WCK1_t_A, WCK1_t_B | 1 | V108 | 30 | WCK1_T | 2 | MATCH | OK
U1 | LP5_U1_ZQ_A_240R_TO_VDDQ | MEMORY_LOCAL_ZQ |  |  |  | reference_resistor | A | no | 1 | H15 | ZQ_A | 0 |  |  |  | 1 | MEMORY_LOCAL | OK

Sheet: memory_pin_features
unit | fpga_bank | memory_group | memory_ball | memory_pin | net_name | signal_class | signal_index | diff_role | memory_channel | byte_lane_or_group | route_class | connects_to_fpga | shared_on_memory_side | source_note | package_family | layout_note | review_status
U0 | Bank2B | DQ Byte0 / CH-A lower | D1 | DQ0_A | LP5_U0_DQ0 | DQ | 0 |  | A | byte0 | byte_lane_data | yes | no | offpage
U0 | Bank2B | DQ Byte0 / CH-A lower | C2 | DQ1_A | LP5_U0_DQ1 | DQ | 1 |  | A | byte0 | byte_lane_data | yes | no | offpage
U0 | Bank2B | DQ Byte0 / CH-A lower | E2 | DQ2_A | LP5_U0_DQ2 | DQ | 2 |  | A | byte0 | byte_lane_data | yes | no | offpage
U0 | Bank2B | DQ Byte0 / CH-A lower | D3 | DQ3_A | LP5_U0_DQ3 | DQ | 3 |  | A | byte0 | byte_lane_data | yes | no | offpage
U0 | Bank2B | DQ Byte0 / CH-A lower | B5 | DQ4_A | LP5_U0_DQ4 | DQ | 4 |  | A | byte0 | byte_lane_data | yes | no | offpage
U0 | Bank2B | DQ Byte0 / CH-A lower | C6 | DQ5_A | LP5_U0_DQ5 | DQ | 5 |  | A | byte0 | byte_lane_data | yes | no | offpage
U0 | Bank2B | DQ Byte0 / CH-A lower | E6 | DQ6_A | LP5_U0_DQ6 | DQ | 6 |  | A | byte0 | byte_lane_data | yes | no | offpage
U0 | Bank2B | DQ Byte0 / CH-A lower | F5 | DQ7_A | LP5_U0_DQ7 | DQ | 7 |  | A | byte0 | byte_lane_data | yes | no | offpage
U0 | Bank2B | DQ Byte0 / CH-A lower | A4 | DMI0_A | LP5_U0_DMI0 | DMI | 0 |  | A | byte0 | byte_lane_data | yes | no | offpage
U0 | Bank2B | DQ Byte0 / CH-A lower | B3 | RDQS0_t_A | LP5_U0_RDQS0_T | RDQS | 0 | T | A | byte0 | byte_lane_data | yes | no | offpage
U0 | Bank2B | DQ Byte0 / CH-A lower | C4 | RDQS0_c_A | LP5_U0_RDQS0_C | RDQS | 0 | C | A | byte0 | byte_lane_data | yes | no | offpage
U0 | Bank2B | DQ Byte1 / CH-A upper | D15 | DQ8_A | LP5_U0_DQ8 | DQ | 8 |  | A | byte1 | byte_lane_data | yes | no | offpage
U0 | Bank2B | DQ Byte1 / CH-A upper | C14 | DQ9_A | LP5_U0_DQ9 | DQ | 9 |  | A | byte1 | byte_lane_data | yes | no | offpage
U0 | Bank2B | DQ Byte1 / CH-A upper | E14 | DQ10_A | LP5_U0_DQ10 | DQ | 10 |  | A | byte1 | byte_lane_data | yes | no | offpage
U0 | Bank2B | DQ Byte1 / CH-A upper | D13 | DQ11_A | LP5_U0_DQ11 | DQ | 11 |  | A | byte1 | byte_lane_data | yes | no | offpage
U0 | Bank2B | DQ Byte1 / CH-A upper | B11 | DQ12_A | LP5_U0_DQ12 | DQ | 12 |  | A | byte1 | byte_lane_data | yes | no | offpage
U0 | Bank2B | DQ Byte1 / CH-A upper | C10 | DQ13_A | LP5_U0_DQ13 | DQ | 13 |  | A | byte1 | byte_lane_data | yes | no | offpage
U0 | Bank2B | DQ Byte1 / CH-A upper | E10 | DQ14_A | LP5_U0_DQ14 | DQ | 14 |  | A | byte1 | byte_lane_data | yes | no | offpage
U0 | Bank2B | DQ Byte1 / CH-A upper | F11 | DQ15_A | LP5_U0_DQ15 | DQ | 15 |  | A | byte1 | byte_lane_data | yes | no | offpage
U0 | Bank2B | DQ Byte1 / CH-A upper | A12 | DMI1_A | LP5_U0_DMI1 | DMI | 1 |  | A | byte1 | byte_lane_data | yes | no | offpage
U0 | Bank2B | DQ Byte1 / CH-A upper | B13 | RDQS1_t_A | LP5_U0_RDQS1_T | RDQS | 1 | T | A | byte1 | byte_lane_data | yes | no | offpage
U0 | Bank2B | DQ Byte1 / CH-A upper | C12 | RDQS1_c_A | LP5_U0_RDQS1_C | RDQS | 1 | C | A | byte1 | byte_lane_data | yes | no | offpage
U0 | Bank2B | DQ Byte2 / CH-B lower | V15 | DQ0_B | LP5_U0_DQ16 | DQ | 16 |  | B | byte2 | byte_lane_data | yes | no | offpage
U0 | Bank2B | DQ Byte2 / CH-B lower | W14 | DQ1_B | LP5_U0_DQ17 | DQ | 17 |  | B | byte2 | byte_lane_data | yes | no | offpage
U0 | Bank2B | DQ Byte2 / CH-B lower | U14 | DQ2_B | LP5_U0_DQ18 | DQ | 18 |  | B | byte2 | byte_lane_data | yes | no | offpage
U0 | Bank2B | DQ Byte2 / CH-B lower | V13 | DQ3_B | LP5_U0_DQ19 | DQ | 19 |  | B | byte2 | byte_lane_data | yes | no | offpage
U0 | Bank2B | DQ Byte2 / CH-B lower | Y11 | DQ4_B | LP5_U0_DQ20 | DQ | 20 |  | B | byte2 | byte_lane_data | yes | no | offpage
U0 | Bank2B | DQ Byte2 / CH-B lower | W10 | DQ5_B | LP5_U0_DQ21 | DQ | 21 |  | B | byte2 | byte_lane_data | yes | no | offpage
U0 | Bank2B | DQ Byte2 / CH-B lower | U10 | DQ6_B | LP5_U0_DQ22 | DQ | 22 |  | B | byte2 | byte_lane_data | yes | no | offpage
U0 | Bank2B | DQ Byte2 / CH-B lower | T11 | DQ7_B | LP5_U0_DQ23 | DQ | 23 |  | B | byte2 | byte_lane_data | yes | no | offpage
U0 | Bank2B | DQ Byte2 / CH-B lower | AA12 | DMI0_B | LP5_U0_DMI2 | DMI | 2 |  | B | byte2 | byte_lane_data | yes | no | offpage
U0 | Bank2B | DQ Byte2 / CH-B lower | Y13 | RDQS0_t_B | LP5_U0_RDQS2_T | RDQS | 2 | T | B | byte2 | byte_lane_data | yes | no | offpage
U0 | Bank2B | DQ Byte2 / CH-B lower | W12 | RDQS0_c_B | LP5_U0_RDQS2_C | RDQS | 2 | C | B | byte2 | byte_lane_data | yes | no | offpage
U0 | Bank2B | DQ Byte3 / CH-B upper | V1 | DQ8_B | LP5_U0_DQ24 | DQ | 24 |  | B | byte3 | byte_lane_data | yes | no | offpage
U0 | Bank2B | DQ Byte3 / CH-B upper | W2 | DQ9_B | LP5_U0_DQ25 | DQ | 25 |  | B | byte3 | byte_lane_data | yes | no | offpage
U0 | Bank2B | DQ Byte3 / CH-B upper | U2 | DQ10_B | LP5_U0_DQ26 | DQ | 26 |  | B | byte3 | byte_lane_data | yes | no | offpage
U0 | Bank2B | DQ Byte3 / CH-B upper | V3 | DQ11_B | LP5_U0_DQ27 | DQ | 27 |  | B | byte3 | byte_lane_data | yes | no | offpage
U0 | Bank2B | DQ Byte3 / CH-B upper | Y5 | DQ12_B | LP5_U0_DQ28 | DQ | 28 |  | B | byte3 | byte_lane_data | yes | no | offpage
U0 | Bank2B | DQ Byte3 / CH-B upper | W6 | DQ13_B | LP5_U0_DQ29 | DQ | 29 |  | B | byte3 | byte_lane_data | yes | no | offpage
U0 | Bank2B | DQ Byte3 / CH-B upper | U6 | DQ14_B | LP5_U0_DQ30 | DQ | 30 |  | B | byte3 | byte_lane_data | yes | no | offpage
U0 | Bank2B | DQ Byte3 / CH-B upper | T5 | DQ15_B | LP5_U0_DQ31 | DQ | 31 |  | B | byte3 | byte_lane_data | yes | no | offpage
U0 | Bank2B | DQ Byte3 / CH-B upper | AA4 | DMI1_B | LP5_U0_DMI3 | DMI | 3 |  | B | byte3 | byte_lane_data | yes | no | offpage
U0 | Bank2B | DQ Byte3 / CH-B upper | Y3 | RDQS1_t_B | LP5_U0_RDQS3_T | RDQS | 3 | T | B | byte3 | byte_lane_data | yes | no | offpage
U0 | Bank2B | DQ Byte3 / CH-B upper | W4 | RDQS1_c_B | LP5_U0_RDQS3_C | RDQS | 3 | C | B | byte3 | byte_lane_data | yes | no | offpage
U0 | Bank2B | CA/CK/WCK/CS/RESET shared x32 | G4 | CA0_A | LP5_U0_CA0 | CA | 0 |  | A | channel_A | command_address_control | yes | yes | offpage shared A/B
U0 | Bank2B | CA/CK/WCK/CS/RESET shared x32 | R12 | CA0_B | LP5_U0_CA0 | CA | 0 |  | B | channel_B | command_address_control | yes | yes | offpage shared A/B
U0 | Bank2B | CA/CK/WCK/CS/RESET shared x32 | H5 | CA1_A | LP5_U0_CA1 | CA | 1 |  | A | channel_A | command_address_control | yes | yes | offpage shared A/B
U0 | Bank2B | CA/CK/WCK/CS/RESET shared x32 | P11 | CA1_B | LP5_U0_CA1 | CA | 1 |  | B | channel_B | command_address_control | yes | yes | offpage shared A/B
U0 | Bank2B | CA/CK/WCK/CS/RESET shared x32 | G8 | CA2_A | LP5_U0_CA2 | CA | 2 |  | A | channel_A | command_address_control | yes | yes | offpage shared A/B
U0 | Bank2B | CA/CK/WCK/CS/RESET shared x32 | R8 | CA2_B | LP5_U0_CA2 | CA | 2 |  | B | channel_B | command_address_control | yes | yes | offpage shared A/B
U0 | Bank2B | CA/CK/WCK/CS/RESET shared x32 | H11 | CA3_A | LP5_U0_CA3 | CA | 3 |  | A | channel_A | command_address_control | yes | yes | offpage shared A/B
U0 | Bank2B | CA/CK/WCK/CS/RESET shared x32 | P5 | CA3_B | LP5_U0_CA3 | CA | 3 |  | B | channel_B | command_address_control | yes | yes | offpage shared A/B
U0 | Bank2B | CA/CK/WCK/CS/RESET shared x32 | G10 | CA4_A | LP5_U0_CA4 | CA | 4 |  | A | channel_A | command_address_control | yes | yes | offpage shared A/B
U0 | Bank2B | CA/CK/WCK/CS/RESET shared x32 | R6 | CA4_B | LP5_U0_CA4 | CA | 4 |  | B | channel_B | command_address_control | yes | yes | offpage shared A/B
U0 | Bank2B | CA/CK/WCK/CS/RESET shared x32 | H13 | CA5_A | LP5_U0_CA5 | CA | 5 |  | A | channel_A | command_address_control | yes | yes | offpage shared A/B
U0 | Bank2B | CA/CK/WCK/CS/RESET shared x32 | P3 | CA5_B | LP5_U0_CA5 | CA | 5 |  | B | channel_B | command_address_control | yes | yes | offpage shared A/B
U0 | Bank2B | CA/CK/WCK/CS/RESET shared x32 | G12 | CA6_A | LP5_U0_CA6 | CA | 6 |  | A | channel_A | command_address_control | yes | yes | offpage shared A/B
U0 | Bank2B | CA/CK/WCK/CS/RESET shared x32 | R4 | CA6_B | LP5_U0_CA6 | CA | 6 |  | B | channel_B | command_address_control | yes | yes | offpage shared A/B
U0 | Bank2B | CA/CK/WCK/CS/RESET shared x32 | H9 | CK_t_A | LP5_U0_CK_T | CK |  | T | A | channel_A | differential_clock | yes | yes | offpage shared A/B
U0 | Bank2B | CA/CK/WCK/CS/RESET shared x32 | P7 | CK_t_B | LP5_U0_CK_T | CK |  | T | B | channel_B | differential_clock | yes | yes | offpage shared A/B
U0 | Bank2B | CA/CK/WCK/CS/RESET shared x32 | J9 | CK_c_A | LP5_U0_CK_C | CK |  | C | A | channel_A | differential_clock | yes | yes | offpage shared A/B
U0 | Bank2B | CA/CK/WCK/CS/RESET shared x32 | N7 | CK_c_B | LP5_U0_CK_C | CK |  | C | B | channel_B | differential_clock | yes | yes | offpage shared A/B
U0 | Bank2B | CA/CK/WCK/CS/RESET shared x32 | E4 | WCK0_t_A | LP5_U0_WCK0_T | WCK | 0 | T | A | wck0 | differential_clock | yes | yes | offpage shared A/B
U0 | Bank2B | CA/CK/WCK/CS/RESET shared x32 | U12 | WCK0_t_B | LP5_U0_WCK0_T | WCK | 0 | T | B | wck0 | differential_clock | yes | yes | offpage shared A/B
U0 | Bank2B | CA/CK/WCK/CS/RESET shared x32 | D5 | WCK0_c_A | LP5_U0_WCK0_C | WCK | 0 | C | A | wck0 | differential_clock | yes | yes | offpage shared A/B
U0 | Bank2B | CA/CK/WCK/CS/RESET shared x32 | V11 | WCK0_c_B | LP5_U0_WCK0_C | WCK | 0 | C | B | wck0 | differential_clock | yes | yes | offpage shared A/B
U0 | Bank2B | CA/CK/WCK/CS/RESET shared x32 | E12 | WCK1_t_A | LP5_U0_WCK1_T | WCK | 1 | T | A | wck1 | differential_clock | yes | yes | offpage shared A/B
U0 | Bank2B | CA/CK/WCK/CS/RESET shared x32 | U4 | WCK1_t_B | LP5_U0_WCK1_T | WCK | 1 | T | B | wck1 | differential_clock | yes | yes | offpage shared A/B
U0 | Bank2B | CA/CK/WCK/CS/RESET shared x32 | D11 | WCK1_c_A | LP5_U0_WCK1_C | WCK | 1 | C | A | wck1 | differential_clock | yes | yes | offpage shared A/B
U0 | Bank2B | CA/CK/WCK/CS/RESET shared x32 | V5 | WCK1_c_B | LP5_U0_WCK1_C | WCK | 1 | C | B | wck1 | differential_clock | yes | yes | offpage shared A/B
U0 | Bank2B | CA/CK/WCK/CS/RESET shared x32 | H7 | CS0_A | LP5_U0_CS0 | CS | 0 |  | A | channel_A | command_address_control | yes | yes | offpage shared A/B
U0 | Bank2B | CA/CK/WCK/CS/RESET shared x32 | P9 | CS0_B | LP5_U0_CS0 | CS | 0 |  | B | channel_B | command_address_control | yes | yes | offpage shared A/B
U0 | Bank2B | CA/CK/WCK/CS/RESET shared x32 | G6 | CS1_A | LP5_U0_CS1 | CS | 1 |  | A | channel_A | command_address_control | yes | yes | offpage shared A/B
U0 | Bank2B | CA/CK/WCK/CS/RESET shared x32 | R10 | CS1_B | LP5_U0_CS1 | CS | 1 |  | B | channel_B | command_address_control | yes | yes | offpage shared A/B
U0 | Bank2B | CA/CK/WCK/CS/RESET shared x32 | H1 | RESET_N | LP5_U0_RESET_N | RESET_N |  | N | common |  | command_address_control | yes | no | offpage
U0 | Bank2B | ZQ local resistor | H15 | ZQ_A | LP5_U0_ZQ_A_240R_TO_VDDQ | MEMORY_LOCAL_ZQ |  |  | A | channel_A | reference_resistor | no | no | local, not FPGA offpage
U1 | Bank3A | DQ Byte0 / CH-A lower | D1 | DQ0_A | LP5_U1_DQ0 | DQ | 0 |  | A | byte0 | byte_lane_data | yes | no | offpage
U1 | Bank3A | DQ Byte0 / CH-A lower | C2 | DQ1_A | LP5_U1_DQ1 | DQ | 1 |  | A | byte0 | byte_lane_data | yes | no | offpage
U1 | Bank3A | DQ Byte0 / CH-A lower | E2 | DQ2_A | LP5_U1_DQ2 | DQ | 2 |  | A | byte0 | byte_lane_data | yes | no | offpage
U1 | Bank3A | DQ Byte0 / CH-A lower | D3 | DQ3_A | LP5_U1_DQ3 | DQ | 3 |  | A | byte0 | byte_lane_data | yes | no | offpage
U1 | Bank3A | DQ Byte0 / CH-A lower | B5 | DQ4_A | LP5_U1_DQ4 | DQ | 4 |  | A | byte0 | byte_lane_data | yes | no | offpage
U1 | Bank3A | DQ Byte0 / CH-A lower | C6 | DQ5_A | LP5_U1_DQ5 | DQ | 5 |  | A | byte0 | byte_lane_data | yes | no | offpage
U1 | Bank3A | DQ Byte0 / CH-A lower | E6 | DQ6_A | LP5_U1_DQ6 | DQ | 6 |  | A | byte0 | byte_lane_data | yes | no | offpage
U1 | Bank3A | DQ Byte0 / CH-A lower | F5 | DQ7_A | LP5_U1_DQ7 | DQ | 7 |  | A | byte0 | byte_lane_data | yes | no | offpage
U1 | Bank3A | DQ Byte0 / CH-A lower | A4 | DMI0_A | LP5_U1_DMI0 | DMI | 0 |  | A | byte0 | byte_lane_data | yes | no | offpage
U1 | Bank3A | DQ Byte0 / CH-A lower | B3 | RDQS0_t_A | LP5_U1_RDQS0_T | RDQS | 0 | T | A | byte0 | byte_lane_data | yes | no | offpage
U1 | Bank3A | DQ Byte0 / CH-A lower | C4 | RDQS0_c_A | LP5_U1_RDQS0_C | RDQS | 0 | C | A | byte0 | byte_lane_data | yes | no | offpage
U1 | Bank3A | DQ Byte1 / CH-A upper | D15 | DQ8_A | LP5_U1_DQ8 | DQ | 8 |  | A | byte1 | byte_lane_data | yes | no | offpage
U1 | Bank3A | DQ Byte1 / CH-A upper | C14 | DQ9_A | LP5_U1_DQ9 | DQ | 9 |  | A | byte1 | byte_lane_data | yes | no | offpage
U1 | Bank3A | DQ Byte1 / CH-A upper | E14 | DQ10_A | LP5_U1_DQ10 | DQ | 10 |  | A | byte1 | byte_lane_data | yes | no | offpage
U1 | Bank3A | DQ Byte1 / CH-A upper | D13 | DQ11_A | LP5_U1_DQ11 | DQ | 11 |  | A | byte1 | byte_lane_data | yes | no | offpage
U1 | Bank3A | DQ Byte1 / CH-A upper | B11 | DQ12_A | LP5_U1_DQ12 | DQ | 12 |  | A | byte1 | byte_lane_data | yes | no | offpage
U1 | Bank3A | DQ Byte1 / CH-A upper | C10 | DQ13_A | LP5_U1_DQ13 | DQ | 13 |  | A | byte1 | byte_lane_data | yes | no | offpage
U1 | Bank3A | DQ Byte1 / CH-A upper | E10 | DQ14_A | LP5_U1_DQ14 | DQ | 14 |  | A | byte1 | byte_lane_data | yes | no | offpage
U1 | Bank3A | DQ Byte1 / CH-A upper | F11 | DQ15_A | LP5_U1_DQ15 | DQ | 15 |  | A | byte1 | byte_lane_data | yes | no | offpage
U1 | Bank3A | DQ Byte1 / CH-A upper | A12 | DMI1_A | LP5_U1_DMI1 | DMI | 1 |  | A | byte1 | byte_lane_data | yes | no | offpage
U1 | Bank3A | DQ Byte1 / CH-A upper | B13 | RDQS1_t_A | LP5_U1_RDQS1_T | RDQS | 1 | T | A | byte1 | byte_lane_data | yes | no | offpage
U1 | Bank3A | DQ Byte1 / CH-A upper | C12 | RDQS1_c_A | LP5_U1_RDQS1_C | RDQS | 1 | C | A | byte1 | byte_lane_data | yes | no | offpage
U1 | Bank3A | DQ Byte2 / CH-B lower | V15 | DQ0_B | LP5_U1_DQ16 | DQ | 16 |  | B | byte2 | byte_lane_data | yes | no | offpage
U1 | Bank3A | DQ Byte2 / CH-B lower | W14 | DQ1_B | LP5_U1_DQ17 | DQ | 17 |  | B | byte2 | byte_lane_data | yes | no | offpage
U1 | Bank3A | DQ Byte2 / CH-B lower | U14 | DQ2_B | LP5_U1_DQ18 | DQ | 18 |  | B | byte2 | byte_lane_data | yes | no | offpage
U1 | Bank3A | DQ Byte2 / CH-B lower | V13 | DQ3_B | LP5_U1_DQ19 | DQ | 19 |  | B | byte2 | byte_lane_data | yes | no | offpage
U1 | Bank3A | DQ Byte2 / CH-B lower | Y11 | DQ4_B | LP5_U1_DQ20 | DQ | 20 |  | B | byte2 | byte_lane_data | yes | no | offpage
U1 | Bank3A | DQ Byte2 / CH-B lower | W10 | DQ5_B | LP5_U1_DQ21 | DQ | 21 |  | B | byte2 | byte_lane_data | yes | no | offpage
U1 | Bank3A | DQ Byte2 / CH-B lower | U10 | DQ6_B | LP5_U1_DQ22 | DQ | 22 |  | B | byte2 | byte_lane_data | yes | no | offpage
U1 | Bank3A | DQ Byte2 / CH-B lower | T11 | DQ7_B | LP5_U1_DQ23 | DQ | 23 |  | B | byte2 | byte_lane_data | yes | no | offpage
U1 | Bank3A | DQ Byte2 / CH-B lower | AA12 | DMI0_B | LP5_U1_DMI2 | DMI | 2 |  | B | byte2 | byte_lane_data | yes | no | offpage
U1 | Bank3A | DQ Byte2 / CH-B lower | Y13 | RDQS0_t_B | LP5_U1_RDQS2_T | RDQS | 2 | T | B | byte2 | byte_lane_data | yes | no | offpage
U1 | Bank3A | DQ Byte2 / CH-B lower | W12 | RDQS0_c_B | LP5_U1_RDQS2_C | RDQS | 2 | C | B | byte2 | byte_lane_data | yes | no | offpage
U1 | Bank3A | DQ Byte3 / CH-B upper | V1 | DQ8_B | LP5_U1_DQ24 | DQ | 24 |  | B | byte3 | byte_lane_data | yes | no | offpage
U1 | Bank3A | DQ Byte3 / CH-B upper | W2 | DQ9_B | LP5_U1_DQ25 | DQ | 25 |  | B | byte3 | byte_lane_data | yes | no | offpage
U1 | Bank3A | DQ Byte3 / CH-B upper | U2 | DQ10_B | LP5_U1_DQ26 | DQ | 26 |  | B | byte3 | byte_lane_data | yes | no | offpage
U1 | Bank3A | DQ Byte3 / CH-B upper | V3 | DQ11_B | LP5_U1_DQ27 | DQ | 27 |  | B | byte3 | byte_lane_data | yes | no | offpage
U1 | Bank3A | DQ Byte3 / CH-B upper | Y5 | DQ12_B | LP5_U1_DQ28 | DQ | 28 |  | B | byte3 | byte_lane_data | yes | no | offpage
U1 | Bank3A | DQ Byte3 / CH-B upper | W6 | DQ13_B | LP5_U1_DQ29 | DQ | 29 |  | B | byte3 | byte_lane_data | yes | no | offpage
U1 | Bank3A | DQ Byte3 / CH-B upper | U6 | DQ14_B | LP5_U1_DQ30 | DQ | 30 |  | B | byte3 | byte_lane_data | yes | no | offpage
U1 | Bank3A | DQ Byte3 / CH-B upper | T5 | DQ15_B | LP5_U1_DQ31 | DQ | 31 |  | B | byte3 | byte_lane_data | yes | no | offpage
U1 | Bank3A | DQ Byte3 / CH-B upper | AA4 | DMI1_B | LP5_U1_DMI3 | DMI | 3 |  | B | byte3 | byte_lane_data | yes | no | offpage
U1 | Bank3A | DQ Byte3 / CH-B upper | Y3 | RDQS1_t_B | LP5_U1_RDQS3_T | RDQS | 3 | T | B | byte3 | byte_lane_data | yes | no | offpage
U1 | Bank3A | DQ Byte3 / CH-B upper | W4 | RDQS1_c_B | LP5_U1_RDQS3_C | RDQS | 3 | C | B | byte3 | byte_lane_data | yes | no | offpage
U1 | Bank3A | CA/CK/WCK/CS/RESET shared x32 | G4 | CA0_A | LP5_U1_CA0 | CA | 0 |  | A | channel_A | command_address_control | yes | yes | offpage shared A/B
U1 | Bank3A | CA/CK/WCK/CS/RESET shared x32 | R12 | CA0_B | LP5_U1_CA0 | CA | 0 |  | B | channel_B | command_address_control | yes | yes | offpage shared A/B
U1 | Bank3A | CA/CK/WCK/CS/RESET shared x32 | H5 | CA1_A | LP5_U1_CA1 | CA | 1 |  | A | channel_A | command_address_control | yes | yes | offpage shared A/B
U1 | Bank3A | CA/CK/WCK/CS/RESET shared x32 | P11 | CA1_B | LP5_U1_CA1 | CA | 1 |  | B | channel_B | command_address_control | yes | yes | offpage shared A/B
U1 | Bank3A | CA/CK/WCK/CS/RESET shared x32 | G8 | CA2_A | LP5_U1_CA2 | CA | 2 |  | A | channel_A | command_address_control | yes | yes | offpage shared A/B
U1 | Bank3A | CA/CK/WCK/CS/RESET shared x32 | R8 | CA2_B | LP5_U1_CA2 | CA | 2 |  | B | channel_B | command_address_control | yes | yes | offpage shared A/B
U1 | Bank3A | CA/CK/WCK/CS/RESET shared x32 | H11 | CA3_A | LP5_U1_CA3 | CA | 3 |  | A | channel_A | command_address_control | yes | yes | offpage shared A/B
U1 | Bank3A | CA/CK/WCK/CS/RESET shared x32 | P5 | CA3_B | LP5_U1_CA3 | CA | 3 |  | B | channel_B | command_address_control | yes | yes | offpage shared A/B
U1 | Bank3A | CA/CK/WCK/CS/RESET shared x32 | G10 | CA4_A | LP5_U1_CA4 | CA | 4 |  | A | channel_A | command_address_control | yes | yes | offpage shared A/B
U1 | Bank3A | CA/CK/WCK/CS/RESET shared x32 | R6 | CA4_B | LP5_U1_CA4 | CA | 4 |  | B | channel_B | command_address_control | yes | yes | offpage shared A/B
U1 | Bank3A | CA/CK/WCK/CS/RESET shared x32 | H13 | CA5_A | LP5_U1_CA5 | CA | 5 |  | A | channel_A | command_address_control | yes | yes | offpage shared A/B
U1 | Bank3A | CA/CK/WCK/CS/RESET shared x32 | P3 | CA5_B | LP5_U1_CA5 | CA | 5 |  | B | channel_B | command_address_control | yes | yes | offpage shared A/B
U1 | Bank3A | CA/CK/WCK/CS/RESET shared x32 | G12 | CA6_A | LP5_U1_CA6 | CA | 6 |  | A | channel_A | command_address_control | yes | yes | offpage shared A/B
U1 | Bank3A | CA/CK/WCK/CS/RESET shared x32 | R4 | CA6_B | LP5_U1_CA6 | CA | 6 |  | B | channel_B | command_address_control | yes | yes | offpage shared A/B
U1 | Bank3A | CA/CK/WCK/CS/RESET shared x32 | H9 | CK_t_A | LP5_U1_CK_T | CK |  | T | A | channel_A | differential_clock | yes | yes | offpage shared A/B
U1 | Bank3A | CA/CK/WCK/CS/RESET shared x32 | P7 | CK_t_B | LP5_U1_CK_T | CK |  | T | B | channel_B | differential_clock | yes | yes | offpage shared A/B
U1 | Bank3A | CA/CK/WCK/CS/RESET shared x32 | J9 | CK_c_A | LP5_U1_CK_C | CK |  | C | A | channel_A | differential_clock | yes | yes | offpage shared A/B
U1 | Bank3A | CA/CK/WCK/CS/RESET shared x32 | N7 | CK_c_B | LP5_U1_CK_C | CK |  | C | B | channel_B | differential_clock | yes | yes | offpage shared A/B
U1 | Bank3A | CA/CK/WCK/CS/RESET shared x32 | E4 | WCK0_t_A | LP5_U1_WCK0_T | WCK | 0 | T | A | wck0 | differential_clock | yes | yes | offpage shared A/B
U1 | Bank3A | CA/CK/WCK/CS/RESET shared x32 | U12 | WCK0_t_B | LP5_U1_WCK0_T | WCK | 0 | T | B | wck0 | differential_clock | yes | yes | offpage shared A/B
U1 | Bank3A | CA/CK/WCK/CS/RESET shared x32 | D5 | WCK0_c_A | LP5_U1_WCK0_C | WCK | 0 | C | A | wck0 | differential_clock | yes | yes | offpage shared A/B
U1 | Bank3A | CA/CK/WCK/CS/RESET shared x32 | V11 | WCK0_c_B | LP5_U1_WCK0_C | WCK | 0 | C | B | wck0 | differential_clock | yes | yes | offpage shared A/B
U1 | Bank3A | CA/CK/WCK/CS/RESET shared x32 | E12 | WCK1_t_A | LP5_U1_WCK1_T | WCK | 1 | T | A | wck1 | differential_clock | yes | yes | offpage shared A/B
U1 | Bank3A | CA/CK/WCK/CS/RESET shared x32 | U4 | WCK1_t_B | LP5_U1_WCK1_T | WCK | 1 | T | B | wck1 | differential_clock | yes | yes | offpage shared A/B
U1 | Bank3A | CA/CK/WCK/CS/RESET shared x32 | D11 | WCK1_c_A | LP5_U1_WCK1_C | WCK | 1 | C | A | wck1 | differential_clock | yes | yes | offpage shared A/B
U1 | Bank3A | CA/CK/WCK/CS/RESET shared x32 | V5 | WCK1_c_B | LP5_U1_WCK1_C | WCK | 1 | C | B | wck1 | differential_clock | yes | yes | offpage shared A/B
U1 | Bank3A | CA/CK/WCK/CS/RESET shared x32 | H7 | CS0_A | LP5_U1_CS0 | CS | 0 |  | A | channel_A | command_address_control | yes | yes | offpage shared A/B
U1 | Bank3A | CA/CK/WCK/CS/RESET shared x32 | P9 | CS0_B | LP5_U1_CS0 | CS | 0 |  | B | channel_B | command_address_control | yes | yes | offpage shared A/B
U1 | Bank3A | CA/CK/WCK/CS/RESET shared x32 | G6 | CS1_A | LP5_U1_CS1 | CS | 1 |  | A | channel_A | command_address_control | yes | yes | offpage shared A/B
U1 | Bank3A | CA/CK/WCK/CS/RESET shared x32 | R10 | CS1_B | LP5_U1_CS1 | CS | 1 |  | B | channel_B | command_address_control | yes | yes | offpage shared A/B
U1 | Bank3A | CA/CK/WCK/CS/RESET shared x32 | H1 | RESET_N | LP5_U1_RESET_N | RESET_N |  | N | common |  | command_address_control | yes | no | offpage
U1 | Bank3A | ZQ local resistor | H15 | ZQ_A | LP5_U1_ZQ_A_240R_TO_VDDQ | MEMORY_LOCAL_ZQ |  |  | A | channel_A | reference_resistor | no | no | local, not FPGA offpage

Sheet: fpga_pin_features
unit | bank | side | orcad_row | fpga_pin | pin_index | fpga_signal | net_name | signal_class | signal_index | diff_role | byte_lane_or_group | route_class | assigned_lpddr5_net | has_memory_side_pin | fpga_only_expected | bank_io_rule | layout_note | review_status
U0 | 2B | left | 1 | CC19 | 95 | DQ31 | LP5_U0_DQ31 | DQ | 31 |  | byte3 | byte_lane_data | yes | yes | no
U0 | 2B | right | 1 | BW38 | 47 |  |  | UNASSIGNED |  |  |  | unused_or_non_lpddr5 | no | no | no
U1 | 3A | left | 1 | A91 | 95 | DQ31 | LP5_U1_DQ31 | DQ | 31 |  | byte3 | byte_lane_data | yes | yes | no
U1 | 3A | right | 1 | AB105 | 47 |  |  | UNASSIGNED |  |  |  | unused_or_non_lpddr5 | no | no | no
U0 | 2B | left | 2 | CF19 | 94 | DQ30 | LP5_U0_DQ30 | DQ | 30 |  | byte3 | byte_lane_data | yes | yes | no
U0 | 2B | right | 2 | CA38 | 46 |  |  | UNASSIGNED |  |  |  | unused_or_non_lpddr5 | no | no | no
U1 | 3A | left | 2 | B88 | 94 | DQ30 | LP5_U1_DQ30 | DQ | 30 |  | byte3 | byte_lane_data | yes | yes | no
U1 | 3A | right | 2 | Y105 | 46 |  |  | UNASSIGNED |  |  |  | unused_or_non_lpddr5 | no | no | no
U0 | 2B | left | 3 | CH22 | 93 | DQ29 | LP5_U0_DQ29 | DQ | 29 |  | byte3 | byte_lane_data | yes | yes | no
U0 | 2B | right | 3 | BU38 | 45 |  |  | UNASSIGNED |  |  |  | unused_or_non_lpddr5 | no | no | no
U1 | 3A | left | 3 | A94 | 93 | DQ29 | LP5_U1_DQ29 | DQ | 29 |  | byte3 | byte_lane_data | yes | yes | no
U1 | 3A | right | 3 | AB108 | 45 |  |  | UNASSIGNED |  |  |  | unused_or_non_lpddr5 | no | no | no
U0 | 2B | left | 4 | CF22 | 92 | DQ28 | LP5_U0_DQ28 | DQ | 28 |  | byte3 | byte_lane_data | yes | yes | no
U0 | 2B | right | 4 | BR38 | 44 | CS1 | LP5_U0_CS1 | CS | 1 |  |  | command_address_control | yes | yes | no
U1 | 3A | left | 4 | B91 | 92 | DQ28 | LP5_U1_DQ28 | DQ | 28 |  | byte3 | byte_lane_data | yes | yes | no
U1 | 3A | right | 4 | Y108 | 44 | CS1 | LP5_U1_CS1 | CS | 1 |  |  | command_address_control | yes | yes | no
U0 | 2B | left | 5 | CA22 | 91 |  |  | UNASSIGNED |  |  |  | unused_or_non_lpddr5 | no | no | no
U0 | 2B | right | 5 | BU41 | 43 | CK_C | LP5_U0_CK_C | CK |  | C |  | differential_clock | yes | yes | no
U1 | 3A | left | 5 | A97 | 91 |  |  | UNASSIGNED |  |  |  | unused_or_non_lpddr5 | no | no | no
U1 | 3A | right | 5 | AK104 | 43 | CK_C | LP5_U1_CK_C | CK |  | C |  | differential_clock | yes | yes | no
U0 | 2B | left | 6 | CC22 | 90 | DMI3 | LP5_U0_DMI3 | DMI | 3 |  | byte3 | byte_lane_data | yes | yes | no
U0 | 2B | right | 6 | BR41 | 42 | CK_T | LP5_U0_CK_T | CK |  | T |  | differential_clock | yes | yes | no
U1 | 3A | left | 6 | B97 | 90 | DMI3 | LP5_U1_DMI3 | DMI | 3 |  | byte3 | byte_lane_data | yes | yes | no
U1 | 3A | right | 6 | AK107 | 42 | CK_T | LP5_U1_CK_T | CK |  | T |  | differential_clock | yes | yes | no
U0 | 2B | left | 7 | CC28 | 89 | RDQS3_C | LP5_U0_RDQS3_C | RDQS | 3 | C | byte3 | byte_lane_data | yes | yes | no
U0 | 2B | right | 7 | CA49 | 41 | CS0 | LP5_U0_CS0 | CS | 0 |  |  | command_address_control | yes | yes | no
U1 | 3A | left | 7 | B101 | 89 | RDQS3_C | LP5_U1_RDQS3_C | RDQS | 3 | C | byte3 | byte_lane_data | yes | yes | no
U1 | 3A | right | 7 | AB114 | 41 | CS0 | LP5_U1_CS0 | CS | 0 |  |  | command_address_control | yes | yes | no
U0 | 2B | left | 8 | CF28 | 88 | RDQS3_T | LP5_U0_RDQS3_T | RDQS | 3 | T | byte3 | byte_lane_data | yes | yes | no
U0 | 2B | right | 8 | BW49 | 40 | CA6 | LP5_U0_CA6 | CA | 6 |  |  | command_address_control | yes | yes | no
U1 | 3A | left | 8 | A101 | 88 | RDQS3_T | LP5_U1_RDQS3_T | RDQS | 3 | T | byte3 | byte_lane_data | yes | yes | no
U1 | 3A | right | 8 | Y114 | 40 | CA6 | LP5_U1_CA6 | CA | 6 |  |  | command_address_control | yes | yes | no
U0 | 2B | left | 9 | CC31 | 87 | DQ27 | LP5_U0_DQ27 | DQ | 27 |  | byte3 | byte_lane_data | yes | yes | no
U0 | 2B | right | 9 | BU52 | 39 | RESET_N | LP5_U0_RESET_N | RESET_N |  | N |  | command_address_control | yes | yes | no
U1 | 3A | left | 9 | A110 | 87 | DQ27 | LP5_U1_DQ27 | DQ | 27 |  | byte3 | byte_lane_data | yes | yes | no
U1 | 3A | right | 9 | AG111 | 39 | RESET_N | LP5_U1_RESET_N | RESET_N |  | N |  | command_address_control | yes | yes | no
U0 | 2B | left | 10 | CA31 | 86 | DQ26 | LP5_U0_DQ26 | DQ | 26 |  | byte3 | byte_lane_data | yes | yes | no
U0 | 2B | right | 10 | BR52 | 38 | FPGA_RZQ | LP5_U0_FPGA_RZQ | FPGA_RZQ |  |  |  | reference_resistor | yes | no | yes
U1 | 3A | left | 10 | B106 | 86 | DQ26 | LP5_U1_DQ26 | DQ | 26 |  | byte3 | byte_lane_data | yes | yes | no
U1 | 3A | right | 10 | AK111 | 38 | FPGA_RZQ | LP5_U1_FPGA_RZQ | FPGA_RZQ |  |  |  | reference_resistor | yes | no | yes
U0 | 2B | left | 11 | CF31 | 85 | DQ25 | LP5_U0_DQ25 | DQ | 25 |  | byte3 | byte_lane_data | yes | yes | no
U0 | 2B | right | 11 | BU49 | 37 |  |  | UNASSIGNED |  |  |  | unused_or_non_lpddr5 | no | no | no
U1 | 3A | left | 11 | B103 | 85 | DQ25 | LP5_U1_DQ25 | DQ | 25 |  | byte3 | byte_lane_data | yes | yes | no
U1 | 3A | right | 11 | Y117 | 37 |  |  | UNASSIGNED |  |  |  | unused_or_non_lpddr5 | no | no | no
U0 | 2B | left | 12 | CH31 | 84 | DQ24 | LP5_U0_DQ24 | DQ | 24 |  | byte3 | byte_lane_data | yes | yes | no
U0 | 2B | right | 12 | BR49 | 36 |  |  | UNASSIGNED |  |  |  | unused_or_non_lpddr5 | no | no | no
U1 | 3A | left | 12 | A106 | 84 | DQ24 | LP5_U1_DQ24 | DQ | 24 |  | byte3 | byte_lane_data | yes | yes | no
U1 | 3A | right | 12 | AB117 | 36 |  |  | UNASSIGNED |  |  |  | unused_or_non_lpddr5 | no | no | no
U0 | 2B | left | 13 | CL6 | 83 | DQ23 | LP5_U0_DQ23 | DQ | 23 |  | byte2 | byte_lane_data | yes | yes | no
U0 | 2B | right | 13 | CF38 | 35 | REFCLK_N | LP5_U0_REFCLK_N | REFCLK |  | N |  | fpga_reference_clock | yes | no | yes
U1 | 3A | left | 13 | D84 | 83 | DQ23 | LP5_U1_DQ23 | DQ | 23 |  | byte2 | byte_lane_data | yes | yes | no
U1 | 3A | right | 13 | K105 | 35 | REFCLK_N | LP5_U1_REFCLK_N | REFCLK |  | N |  | fpga_reference_clock | yes | no | yes
U0 | 2B | left | 14 | CK8 | 82 | DQ22 | LP5_U0_DQ22 | DQ | 22 |  | byte2 | byte_lane_data | yes | yes | no
U0 | 2B | right | 14 | CH38 | 34 | REFCLK_P | LP5_U0_REFCLK_P | REFCLK |  | P |  | fpga_reference_clock | yes | no | yes
U1 | 3A | left | 14 | F84 | 82 | DQ22 | LP5_U1_DQ22 | DQ | 22 |  | byte2 | byte_lane_data | yes | yes | no
U1 | 3A | right | 14 | M105 | 34 | REFCLK_P | LP5_U1_REFCLK_P | REFCLK |  | P |  | fpga_reference_clock | yes | no | yes
U0 | 2B | left | 15 | CL8 | 81 | DQ21 | LP5_U0_DQ21 | DQ | 21 |  | byte2 | byte_lane_data | yes | yes | no
U0 | 2B | right | 15 | CA41 | 33 | CA5 | LP5_U0_CA5 | CA | 5 |  |  | command_address_control | yes | yes | no
U1 | 3A | left | 15 | M87 | 81 | DQ21 | LP5_U1_DQ21 | DQ | 21 |  | byte2 | byte_lane_data | yes | yes | no
U1 | 3A | right | 15 | P105 | 33 | CA5 | LP5_U1_CA5 | CA | 5 |  |  | command_address_control | yes | yes | no
U0 | 2B | left | 16 | CK11 | 80 | DQ20 | LP5_U0_DQ20 | DQ | 20 |  | byte2 | byte_lane_data | yes | yes | no
U0 | 2B | right | 16 | CC41 | 32 | CA4 | LP5_U0_CA4 | CA | 4 |  |  | command_address_control | yes | yes | no
U1 | 3A | left | 16 | K87 | 80 | DQ20 | LP5_U1_DQ20 | DQ | 20 |  | byte2 | byte_lane_data | yes | yes | no
U1 | 3A | right | 16 | T105 | 32 | CA4 | LP5_U1_CA4 | CA | 4 |  |  | command_address_control | yes | yes | no
U0 | 2B | left | 17 | CL11 | 79 |  |  | UNASSIGNED |  |  |  | unused_or_non_lpddr5 | no | no | no
U0 | 2B | right | 17 | CF41 | 31 | WCK1_C | LP5_U0_WCK1_C | WCK | 1 | C | wck1 | differential_clock | yes | yes | no
U1 | 3A | left | 17 | F87 | 79 |  |  | UNASSIGNED |  |  |  | unused_or_non_lpddr5 | no | no | no
U1 | 3A | right | 17 | T108 | 31 | WCK1_C | LP5_U1_WCK1_C | WCK | 1 | C | wck1 | differential_clock | yes | yes | no
U0 | 2B | left | 18 | CL14 | 78 | DMI2 | LP5_U0_DMI2 | DMI | 2 |  | byte2 | byte_lane_data | yes | yes | no
U0 | 2B | right | 18 | CH41 | 30 | WCK1_T | LP5_U0_WCK1_T | WCK | 1 | T | wck1 | differential_clock | yes | yes | no
U1 | 3A | left | 18 | H87 | 78 | DMI2 | LP5_U1_DMI2 | DMI | 2 |  | byte2 | byte_lane_data | yes | yes | no
U1 | 3A | right | 18 | V108 | 30 | WCK1_T | LP5_U1_WCK1_T | WCK | 1 | T | wck1 | differential_clock | yes | yes | no
U0 | 2B | left | 19 | CL17 | 77 | RDQS2_C | LP5_U0_RDQS2_C | RDQS | 2 | C | byte2 | byte_lane_data | yes | yes | no
U0 | 2B | right | 19 | CH49 | 29 | WCK0_C | LP5_U0_WCK0_C | WCK | 0 | C | wck0 | differential_clock | yes | yes | no
U1 | 3A | left | 19 | D95 | 77 | RDQS2_C | LP5_U1_RDQS2_C | RDQS | 2 | C | byte2 | byte_lane_data | yes | yes | no
U1 | 3A | right | 19 | K114 | 29 | WCK0_C | LP5_U1_WCK0_C | WCK | 0 | C | wck0 | differential_clock | yes | yes | no
U0 | 2B | left | 20 | CK17 | 76 | RDQS2_T | LP5_U0_RDQS2_T | RDQS | 2 | T | byte2 | byte_lane_data | yes | yes | no
U0 | 2B | right | 20 | CF49 | 28 | WCK0_T | LP5_U0_WCK0_T | WCK | 0 | T | wck0 | differential_clock | yes | yes | no
U1 | 3A | left | 20 | F95 | 76 | RDQS2_T | LP5_U1_RDQS2_T | RDQS | 2 | T | byte2 | byte_lane_data | yes | yes | no
U1 | 3A | right | 20 | M114 | 28 | WCK0_T | LP5_U1_WCK0_T | WCK | 0 | T | wck0 | differential_clock | yes | yes | no
U0 | 2B | left | 21 | CK20 | 75 | DQ19 | LP5_U0_DQ19 | DQ | 19 |  | byte2 | byte_lane_data | yes | yes | no
U0 | 2B | right | 21 | CA52 | 27 | CA3 | LP5_U0_CA3 | CA | 3 |  |  | command_address_control | yes | yes | no
U1 | 3A | left | 21 | K98 | 75 | DQ19 | LP5_U1_DQ19 | DQ | 19 |  | byte2 | byte_lane_data | yes | yes | no
U1 | 3A | right | 21 | T117 | 27 | CA3 | LP5_U1_CA3 | CA | 3 |  |  | command_address_control | yes | yes | no
U0 | 2B | left | 22 | CL20 | 74 | DQ18 | LP5_U0_DQ18 | DQ | 18 |  | byte2 | byte_lane_data | yes | yes | no
U0 | 2B | right | 22 | CC52 | 26 | CA2 | LP5_U0_CA2 | CA | 2 |  |  | command_address_control | yes | yes | no
U1 | 3A | left | 22 | M98 | 74 | DQ18 | LP5_U1_DQ18 | DQ | 18 |  | byte2 | byte_lane_data | yes | yes | no
U1 | 3A | right | 22 | V117 | 26 | CA2 | LP5_U1_CA2 | CA | 2 |  |  | command_address_control | yes | yes | no
U0 | 2B | left | 23 | CK26 | 73 | DQ17 | LP5_U0_DQ17 | DQ | 17 |  | byte2 | byte_lane_data | yes | yes | no
U0 | 2B | right | 23 | CH52 | 25 | CA1 | LP5_U0_CA1 | CA | 1 |  |  | command_address_control | yes | yes | no
U1 | 3A | left | 23 | F98 | 73 | DQ17 | LP5_U1_DQ17 | DQ | 17 |  | byte2 | byte_lane_data | yes | yes | no
U1 | 3A | right | 23 | P114 | 25 | CA1 | LP5_U1_CA1 | CA | 1 |  |  | command_address_control | yes | yes | no
U0 | 2B | left | 24 | CL23 | 72 | DQ16 | LP5_U0_DQ16 | DQ | 16 |  | byte2 | byte_lane_data | yes | yes | no
U0 | 2B | right | 24 | CF52 | 24 | CA0 | LP5_U0_CA0 | CA | 0 |  |  | command_address_control | yes | yes | no
U1 | 3A | left | 24 | H98 | 72 | DQ16 | LP5_U1_DQ16 | DQ | 16 |  | byte2 | byte_lane_data | yes | yes | no
U1 | 3A | right | 24 | T114 | 24 | CA0 | LP5_U1_CA0 | CA | 0 |  |  | command_address_control | yes | yes | no
U0 | 2B | left | 25 | BF46 | 71 |  |  | UNASSIGNED |  |  |  | unused_or_non_lpddr5 | no | no | no
U0 | 2B | right | 25 | CL26 | 23 | DQ15 | LP5_U0_DQ15 | DQ | 15 |  | byte1 | byte_lane_data | yes | yes | no
U1 | 3A | left | 25 | P84 | 71 |  |  | UNASSIGNED |  |  |  | unused_or_non_lpddr5 | no | no | no
U1 | 3A | right | 25 | K108 | 23 | DQ15 | LP5_U1_DQ15 | DQ | 15 |  | byte1 | byte_lane_data | yes | yes | no
U0 | 2B | left | 26 | BE46 | 70 |  |  | UNASSIGNED |  |  |  | unused_or_non_lpddr5 | no | no | no
U0 | 2B | right | 26 | CK30 | 22 | DQ14 | LP5_U0_DQ14 | DQ | 14 |  | byte1 | byte_lane_data | yes | yes | no
U1 | 3A | left | 26 | T84 | 70 |  |  | UNASSIGNED |  |  |  | unused_or_non_lpddr5 | no | no | no
U1 | 3A | right | 26 | M108 | 22 | DQ14 | LP5_U1_DQ14 | DQ | 14 |  | byte1 | byte_lane_data | yes | yes | no
U0 | 2B | left | 27 | BE50 | 69 |  |  | UNASSIGNED |  |  |  | unused_or_non_lpddr5 | no | no | no
U0 | 2B | right | 27 | CL30 | 21 | DQ13 | LP5_U0_DQ13 | DQ | 13 |  | byte1 | byte_lane_data | yes | yes | no
U1 | 3A | left | 27 | M84 | 69 |  |  | UNASSIGNED |  |  |  | unused_or_non_lpddr5 | no | no | no
U1 | 3A | right | 27 | F108 | 21 | DQ13 | LP5_U1_DQ13 | DQ | 13 |  | byte1 | byte_lane_data | yes | yes | no
U0 | 2B | left | 28 | BF50 | 68 |  |  | UNASSIGNED |  |  |  | unused_or_non_lpddr5 | no | no | no
U0 | 2B | right | 28 | CK33 | 20 | DQ12 | LP5_U0_DQ12 | DQ | 12 |  | byte1 | byte_lane_data | yes | yes | no
U1 | 3A | left | 28 | K84 | 68 |  |  | UNASSIGNED |  |  |  | unused_or_non_lpddr5 | no | no | no
U1 | 3A | right | 28 | H108 | 20 | DQ12 | LP5_U1_DQ12 | DQ | 12 |  | byte1 | byte_lane_data | yes | yes | no
U0 | 2B | left | 29 | BF53 | 67 |  |  | UNASSIGNED |  |  |  | unused_or_non_lpddr5 | no | no | no
U0 | 2B | right | 29 | CL35 | 19 |  |  | UNASSIGNED |  |  |  | unused_or_non_lpddr5 | no | no | no
U1 | 3A | left | 29 | T87 | 67 |  |  | UNASSIGNED |  |  |  | unused_or_non_lpddr5 | no | no | no
U1 | 3A | right | 29 | D105 | 19 |  |  | UNASSIGNED |  |  |  | unused_or_non_lpddr5 | no | no | no
U0 | 2B | left | 30 | BF57 | 66 |  |  | UNASSIGNED |  |  |  | unused_or_non_lpddr5 | no | no | no
U0 | 2B | right | 30 | CK35 | 18 | DMI1 | LP5_U0_DMI1 | DMI | 1 |  | byte1 | byte_lane_data | yes | yes | no
U1 | 3A | left | 30 | V87 | 66 |  |  | UNASSIGNED |  |  |  | unused_or_non_lpddr5 | no | no | no
U1 | 3A | right | 30 | F105 | 18 | DMI1 | LP5_U1_DMI1 | DMI | 1 |  | byte1 | byte_lane_data | yes | yes | no
U0 | 2B | left | 31 | BE57 | 65 |  |  | UNASSIGNED |  |  |  | unused_or_non_lpddr5 | no | no | no
U0 | 2B | right | 31 | CL39 | 17 | RDQS1_C | LP5_U0_RDQS1_C | RDQS | 1 | C | byte1 | byte_lane_data | yes | yes | no
U1 | 3A | left | 31 | M95 | 65 |  |  | UNASSIGNED |  |  |  | unused_or_non_lpddr5 | no | no | no
U1 | 3A | right | 31 | D114 | 17 | RDQS1_C | LP5_U1_RDQS1_C | RDQS | 1 | C | byte1 | byte_lane_data | yes | yes | no
U0 | 2B | left | 32 | BE61 | 64 |  |  | UNASSIGNED |  |  |  | unused_or_non_lpddr5 | no | no | no
U0 | 2B | right | 32 | CK39 | 16 | RDQS1_T | LP5_U0_RDQS1_T | RDQS | 1 | T | byte1 | byte_lane_data | yes | yes | no
U1 | 3A | left | 32 | K95 | 64 |  |  | UNASSIGNED |  |  |  | unused_or_non_lpddr5 | no | no | no
U1 | 3A | right | 32 | F114 | 16 | RDQS1_T | LP5_U1_RDQS1_T | RDQS | 1 | T | byte1 | byte_lane_data | yes | yes | no
U0 | 2B | left | 33 | BF64 | 63 |  |  | UNASSIGNED |  |  |  | unused_or_non_lpddr5 | no | no | no
U0 | 2B | right | 33 | CL45 | 15 | DQ11 | LP5_U0_DQ11 | DQ | 11 |  | byte1 | byte_lane_data | yes | yes | no
U1 | 3A | left | 33 | T95 | 63 |  |  | UNASSIGNED |  |  |  | unused_or_non_lpddr5 | no | no | no
U1 | 3A | right | 33 | M117 | 15 | DQ11 | LP5_U1_DQ11 | DQ | 11 |  | byte1 | byte_lane_data | yes | yes | no
U0 | 2B | left | 34 | BE64 | 62 |  |  | UNASSIGNED |  |  |  | unused_or_non_lpddr5 | no | no | no
U0 | 2B | right | 34 | CK48 | 14 | DQ10 | LP5_U0_DQ10 | DQ | 10 |  | byte1 | byte_lane_data | yes | yes | no
U1 | 3A | left | 34 | P95 | 62 |  |  | UNASSIGNED |  |  |  | unused_or_non_lpddr5 | no | no | no
U1 | 3A | right | 34 | K117 | 14 | DQ10 | LP5_U1_DQ10 | DQ | 10 |  | byte1 | byte_lane_data | yes | yes | no
U0 | 2B | left | 35 | BE68 | 61 |  |  | UNASSIGNED |  |  |  | unused_or_non_lpddr5 | no | no | no
U0 | 2B | right | 35 | CK45 | 13 | DQ9 | LP5_U0_DQ9 | DQ | 9 |  | byte1 | byte_lane_data | yes | yes | no
U1 | 3A | left | 35 | T98 | 61 |  |  | UNASSIGNED |  |  |  | unused_or_non_lpddr5 | no | no | no
U1 | 3A | right | 35 | H117 | 13 | DQ9 | LP5_U1_DQ9 | DQ | 9 |  | byte1 | byte_lane_data | yes | yes | no
U0 | 2B | left | 36 | BF68 | 60 |  |  | UNASSIGNED |  |  |  | unused_or_non_lpddr5 | no | no | no
U0 | 2B | right | 36 | CL42 | 12 | DQ8 | LP5_U0_DQ8 | DQ | 8 |  | byte1 | byte_lane_data | yes | yes | no
U1 | 3A | left | 36 | V98 | 60 |  |  | UNASSIGNED |  |  |  | unused_or_non_lpddr5 | no | no | no
U1 | 3A | right | 36 | F117 | 12 | DQ8 | LP5_U1_DQ8 | DQ | 8 |  | byte1 | byte_lane_data | yes | yes | no
U0 | 2B | left | 37 | BM38 | 59 |  |  | UNASSIGNED |  |  |  | unused_or_non_lpddr5 | no | no | no
U0 | 2B | right | 37 | CK54 | 11 | DQ7 | LP5_U0_DQ7 | DQ | 7 |  | byte0 | byte_lane_data | yes | yes | no
U1 | 3A | left | 37 | Y84 | 59 |  |  | UNASSIGNED |  |  |  | unused_or_non_lpddr5 | no | no | no
U1 | 3A | right | 37 | A113 | 11 | DQ7 | LP5_U1_DQ7 | DQ | 7 |  | byte0 | byte_lane_data | yes | yes | no
U0 | 2B | left | 38 | BK38 | 58 |  |  | UNASSIGNED |  |  |  | unused_or_non_lpddr5 | no | no | no
U0 | 2B | right | 38 | CL51 | 10 | DQ6 | LP5_U0_DQ6 | DQ | 6 |  | byte0 | byte_lane_data | yes | yes | no
U1 | 3A | left | 38 | Y87 | 58 |  |  | UNASSIGNED |  |  |  | unused_or_non_lpddr5 | no | no | no
U1 | 3A | right | 38 | B113 | 10 | DQ6 | LP5_U1_DQ6 | DQ | 6 |  | byte0 | byte_lane_data | yes | yes | no
U0 | 2B | left | 39 | BH41 | 57 |  |  | UNASSIGNED |  |  |  | unused_or_non_lpddr5 | no | no | no
U0 | 2B | right | 39 | CL54 | 9 | DQ5 | LP5_U0_DQ5 | DQ | 5 |  | byte0 | byte_lane_data | yes | yes | no
U1 | 3A | left | 39 | Y95 | 57 |  |  | UNASSIGNED |  |  |  | unused_or_non_lpddr5 | no | no | no
U1 | 3A | right | 39 | A116 | 9 | DQ5 | LP5_U1_DQ5 | DQ | 5 |  | byte0 | byte_lane_data | yes | yes | no
U0 | 2B | left | 40 | BH38 | 56 |  |  | UNASSIGNED |  |  |  | unused_or_non_lpddr5 | no | no | no
U0 | 2B | right | 40 | CK56 | 8 | DQ4 | LP5_U0_DQ4 | DQ | 4 |  | byte0 | byte_lane_data | yes | yes | no
U1 | 3A | left | 40 | Y98 | 56 |  |  | UNASSIGNED |  |  |  | unused_or_non_lpddr5 | no | no | no
U1 | 3A | right | 40 | B116 | 8 | DQ4 | LP5_U1_DQ4 | DQ | 4 |  | byte0 | byte_lane_data | yes | yes | no
U0 | 2B | left | 41 | BM41 | 55 |  |  | UNASSIGNED |  |  |  | unused_or_non_lpddr5 | no | no | no
U0 | 2B | right | 41 | CL60 | 7 |  |  | UNASSIGNED |  |  |  | unused_or_non_lpddr5 | no | no | no
U1 | 3A | left | 41 | AC86 | 55 |  |  | UNASSIGNED |  |  |  | unused_or_non_lpddr5 | no | no | no
U1 | 3A | right | 41 | A122 | 7 |  |  | UNASSIGNED |  |  |  | unused_or_non_lpddr5 | no | no | no
U0 | 2B | left | 42 | BP41 | 54 |  |  | UNASSIGNED |  |  |  | unused_or_non_lpddr5 | no | no | no
U0 | 2B | right | 42 | CL56 | 6 | DMI0 | LP5_U0_DMI0 | DMI | 0 |  | byte0 | byte_lane_data | yes | yes | no
U1 | 3A | left | 42 | AC90 | 54 |  |  | UNASSIGNED |  |  |  | unused_or_non_lpddr5 | no | no | no
U1 | 3A | right | 42 | B119 | 6 | DMI0 | LP5_U1_DMI0 | DMI | 0 |  | byte0 | byte_lane_data | yes | yes | no
U0 | 2B | left | 43 | BM49 | 53 |  |  | UNASSIGNED |  |  |  | unused_or_non_lpddr5 | no | no | no
U0 | 2B | right | 43 | CL66 | 5 | RDQS0_C | LP5_U0_RDQS0_C | RDQS | 0 | C | byte0 | byte_lane_data | yes | yes | no
U1 | 3A | left | 43 | AG93 | 53 |  |  | UNASSIGNED |  |  |  | unused_or_non_lpddr5 | no | no | no
U1 | 3A | right | 43 | A125 | 5 | RDQS0_C | LP5_U1_RDQS0_C | RDQS | 0 | C | byte0 | byte_lane_data | yes | yes | no
U0 | 2B | left | 44 | BK49 | 52 |  |  | UNASSIGNED |  |  |  | unused_or_non_lpddr5 | no | no | no
U0 | 2B | right | 44 | CK63 | 4 | RDQS0_T | LP5_U0_RDQS0_T | RDQS | 0 | T | byte0 | byte_lane_data | yes | yes | no
U1 | 3A | left | 44 | AG90 | 52 |  |  | UNASSIGNED |  |  |  | unused_or_non_lpddr5 | no | no | no
U1 | 3A | right | 44 | B122 | 4 | RDQS0_T | LP5_U1_RDQS0_T | RDQS | 0 | T | byte0 | byte_lane_data | yes | yes | no
U0 | 2B | left | 45 | BH52 | 51 |  |  | UNASSIGNED |  |  |  | unused_or_non_lpddr5 | no | no | no
U0 | 2B | right | 45 | CL73 | 3 | DQ3 | LP5_U0_DQ3 | DQ | 3 |  | byte0 | byte_lane_data | yes | yes | no
U1 | 3A | left | 45 | AC96 | 51 |  |  | UNASSIGNED |  |  |  | unused_or_non_lpddr5 | no | no | no
U1 | 3A | right | 45 | A130 | 3 | DQ3 | LP5_U1_DQ3 | DQ | 3 |  | byte0 | byte_lane_data | yes | yes | no
U0 | 2B | left | 46 | BH49 | 50 |  |  | UNASSIGNED |  |  |  | unused_or_non_lpddr5 | no | no | no
U0 | 2B | right | 46 | CK73 | 2 | DQ2 | LP5_U0_DQ2 | DQ | 2 |  | byte0 | byte_lane_data | yes | yes | no
U1 | 3A | left | 46 | AC100 | 50 |  |  | UNASSIGNED |  |  |  | unused_or_non_lpddr5 | no | no | no
U1 | 3A | right | 46 | B130 | 2 | DQ2 | LP5_U1_DQ2 | DQ | 2 |  | byte0 | byte_lane_data | yes | yes | no
U0 | 2B | left | 47 | BP52 | 49 |  |  | UNASSIGNED |  |  |  | unused_or_non_lpddr5 | no | no | no
U0 | 2B | right | 47 | CL70 | 1 | DQ1 | LP5_U0_DQ1 | DQ | 1 |  | byte0 | byte_lane_data | yes | yes | no
U1 | 3A | left | 47 | AG104 | 49 |  |  | UNASSIGNED |  |  |  | unused_or_non_lpddr5 | no | no | no
U1 | 3A | right | 47 | A128 | 1 | DQ1 | LP5_U1_DQ1 | DQ | 1 |  | byte0 | byte_lane_data | yes | yes | no
U0 | 2B | left | 48 | BM52 | 48 |  |  | UNASSIGNED |  |  |  | unused_or_non_lpddr5 | no | no | no
U0 | 2B | right | 48 | CK66 | 0 | DQ0 | LP5_U0_DQ0 | DQ | 0 |  | byte0 | byte_lane_data | yes | yes | no
U1 | 3A | left | 48 | AG100 | 48 |  |  | UNASSIGNED |  |  |  | unused_or_non_lpddr5 | no | no | no
U1 | 3A | right | 48 | B128 | 0 | DQ0 | LP5_U1_DQ0 | DQ | 0 |  | byte0 | byte_lane_data | yes | yes | no

Sheet: count_by_class
unit | signal_class | memory_physical_pin_rows | memory_unique_nets | fpga_unique_nets | missing_in_fpga | fpga_only
U0 | CA | 14 | 7 | 7
U0 | CK | 4 | 2 | 2
U0 | CS | 4 | 2 | 2
U0 | DMI | 4 | 4 | 4
U0 | DQ | 32 | 32 | 32
U0 | FPGA_RZQ | 0 | 0 | 1 |  | LP5_U0_FPGA_RZQ
U0 | MEMORY_LOCAL_ZQ | 1 | 1 | 0 | LP5_U0_ZQ_A_240R_TO_VDDQ
U0 | RDQS | 8 | 8 | 8
U0 | REFCLK | 0 | 0 | 2 |  | LP5_U0_REFCLK_N, LP5_U0_REFCLK_P
U0 | RESET_N | 1 | 1 | 1
U0 | WCK | 8 | 4 | 4
U1 | CA | 14 | 7 | 7
U1 | CK | 4 | 2 | 2
U1 | CS | 4 | 2 | 2
U1 | DMI | 4 | 4 | 4
U1 | DQ | 32 | 32 | 32
U1 | FPGA_RZQ | 0 | 0 | 1 |  | LP5_U1_FPGA_RZQ
U1 | MEMORY_LOCAL_ZQ | 1 | 1 | 0 | LP5_U1_ZQ_A_240R_TO_VDDQ
U1 | RDQS | 8 | 8 | 8
U1 | REFCLK | 0 | 0 | 2 |  | LP5_U1_REFCLK_N, LP5_U1_REFCLK_P
U1 | RESET_N | 1 | 1 | 1
U1 | WCK | 8 | 4 | 4

Sheet: shared_net_detail
unit | net_name | signal_class | memory_pin_count | memory_balls | memory_pins | reason
U0 | LP5_U0_CA0 | CA | 2 | G4, R12 | CA0_A, CA0_B | A/B shared x32 net
U0 | LP5_U0_CA1 | CA | 2 | H5, P11 | CA1_A, CA1_B | A/B shared x32 net
U0 | LP5_U0_CA2 | CA | 2 | G8, R8 | CA2_A, CA2_B | A/B shared x32 net
U0 | LP5_U0_CA3 | CA | 2 | H11, P5 | CA3_A, CA3_B | A/B shared x32 net
U0 | LP5_U0_CA4 | CA | 2 | G10, R6 | CA4_A, CA4_B | A/B shared x32 net
U0 | LP5_U0_CA5 | CA | 2 | H13, P3 | CA5_A, CA5_B | A/B shared x32 net
U0 | LP5_U0_CA6 | CA | 2 | G12, R4 | CA6_A, CA6_B | A/B shared x32 net
U0 | LP5_U0_CK_C | CK | 2 | J9, N7 | CK_c_A, CK_c_B | A/B shared x32 net
U0 | LP5_U0_CK_T | CK | 2 | H9, P7 | CK_t_A, CK_t_B | A/B shared x32 net
U0 | LP5_U0_CS0 | CS | 2 | H7, P9 | CS0_A, CS0_B | A/B shared x32 net
U0 | LP5_U0_CS1 | CS | 2 | G6, R10 | CS1_A, CS1_B | A/B shared x32 net
U0 | LP5_U0_WCK0_C | WCK | 2 | D5, V11 | WCK0_c_A, WCK0_c_B | A/B shared x32 net
U0 | LP5_U0_WCK0_T | WCK | 2 | E4, U12 | WCK0_t_A, WCK0_t_B | A/B shared x32 net
U0 | LP5_U0_WCK1_C | WCK | 2 | D11, V5 | WCK1_c_A, WCK1_c_B | A/B shared x32 net
U0 | LP5_U0_WCK1_T | WCK | 2 | E12, U4 | WCK1_t_A, WCK1_t_B | A/B shared x32 net
U1 | LP5_U1_CA0 | CA | 2 | G4, R12 | CA0_A, CA0_B | A/B shared x32 net
U1 | LP5_U1_CA1 | CA | 2 | H5, P11 | CA1_A, CA1_B | A/B shared x32 net
U1 | LP5_U1_CA2 | CA | 2 | G8, R8 | CA2_A, CA2_B | A/B shared x32 net
U1 | LP5_U1_CA3 | CA | 2 | H11, P5 | CA3_A, CA3_B | A/B shared x32 net
U1 | LP5_U1_CA4 | CA | 2 | G10, R6 | CA4_A, CA4_B | A/B shared x32 net
U1 | LP5_U1_CA5 | CA | 2 | H13, P3 | CA5_A, CA5_B | A/B shared x32 net
U1 | LP5_U1_CA6 | CA | 2 | G12, R4 | CA6_A, CA6_B | A/B shared x32 net
U1 | LP5_U1_CK_C | CK | 2 | J9, N7 | CK_c_A, CK_c_B | A/B shared x32 net
U1 | LP5_U1_CK_T | CK | 2 | H9, P7 | CK_t_A, CK_t_B | A/B shared x32 net
U1 | LP5_U1_CS0 | CS | 2 | H7, P9 | CS0_A, CS0_B | A/B shared x32 net
U1 | LP5_U1_CS1 | CS | 2 | G6, R10 | CS1_A, CS1_B | A/B shared x32 net
U1 | LP5_U1_WCK0_C | WCK | 2 | D5, V11 | WCK0_c_A, WCK0_c_B | A/B shared x32 net
U1 | LP5_U1_WCK0_T | WCK | 2 | E4, U12 | WCK0_t_A, WCK0_t_B | A/B shared x32 net
U1 | LP5_U1_WCK1_C | WCK | 2 | D11, V5 | WCK1_c_A, WCK1_c_B | A/B shared x32 net
U1 | LP5_U1_WCK1_T | WCK | 2 | E12, U4 | WCK1_t_A, WCK1_t_B | A/B shared x32 net

Sheet: validation_rules
rule | meaning | action
memory rows != fpga nets | Memory-side TSV has physical balls. Shared CA/CK/WCK/CS nets appear on channel A and B balls. | Compare unique FPGA-connected net names, not TSV line count.
FPGA-only nets | FPGA_RZQ and REFCLK_P/N are valid FPGA-side nets with no LPDDR5 component pin. | Keep them in fpga_side; do not add fake memory pins.
Memory-local ZQ | LPDDR5 ZQ_A uses local 240 ohm to VDDQ and does not connect to FPGA_RZQ. | Keep it on memory-side only.
Extensible review columns | net_summary includes blank columns for impedance, length group, layout and review ownership. | Fill those during schematic/layout review; rerun script if source pin tables change.
