joyhpc/misc-tasks/a5ed065b_b32a_lpddr5/sourcing/lpddr5_lpddr5x_ecosystem.png

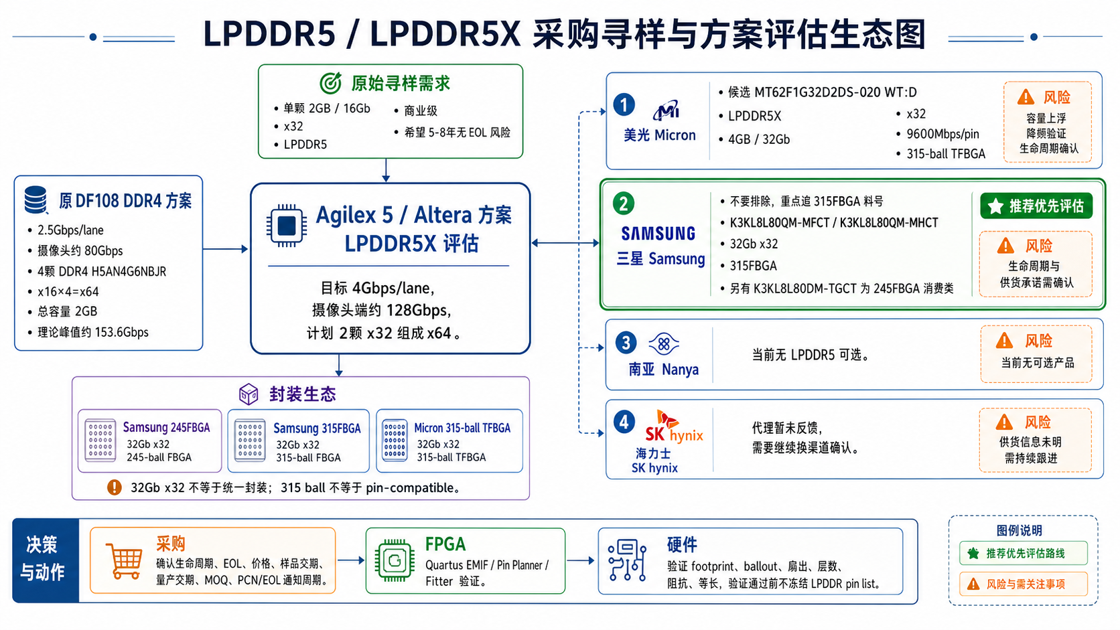
a5ed065b_b32a_lpddr5/sourcing/lpddr5_lpddr5x_ecosystem.png
