joyhpc/misc-tasks/a5ed065b_b32a_lpddr5/reference_designs/antmicro_lpddr5_testbed/README.md

# LPDDR5 Testbed

Copyright (c) 2023-2025 [Antmicro](https://www.antmicro.com)



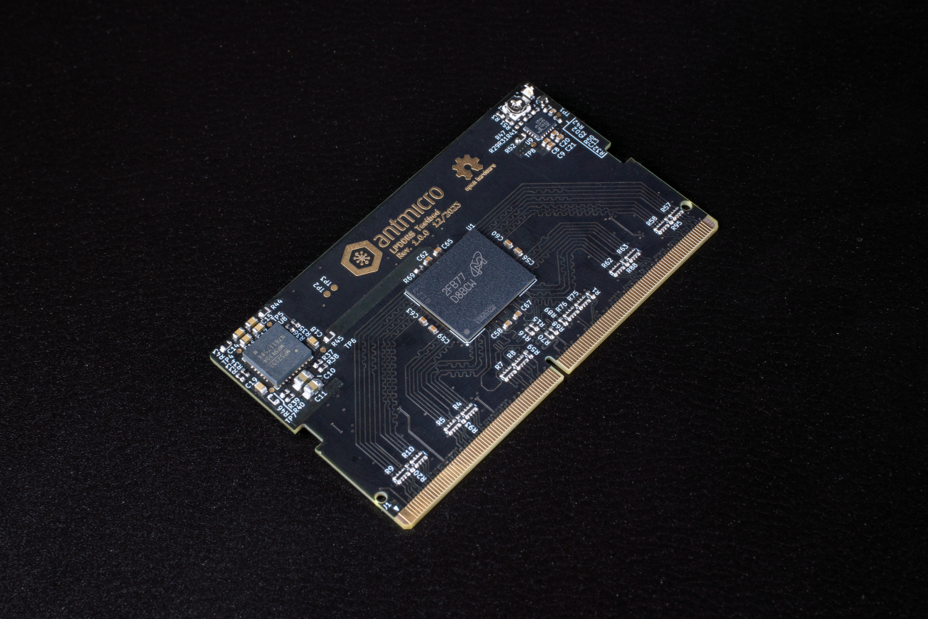
[picture p2: a5ed065b_b32a_lpddr5/reference_designs/antmicro_lpddr5_testbed/img/lpddr5-testbed-rev.1.0.0-photo.jpg]


## Overview

This project contains open hardware design files for an experimental test module in a mechanical form of SO-DIMM DDR5. 

The module includes a standard 315-ball WFBGA (12.4mm × 15.0mm × 0.8mm, Ø0.42 SMD) LPDDR5 RAM footprint break-routed in the SO-DIMM edge connector. 
The design files were prepared in KiCad 9.x. 

Please note that this board is not electrically compatible with off-the-shelf hot platforms accepting SO-DIMM DDR5 memory modules. 
It is compatible with [this](https://github.com/antmicro/sodimm-ddr5-tester) test platform.

## Project structure

The main project directory contains KiCad PCB project files, a LICENSE and README. 
The remaining files are stored in the following directories:

* `img` - contains graphics for this README
* `doc` - contains PDF schematic

## Licensing

This project is published under the [Apache-2.0](LICENSE) license.
