joyhpc/misc-tasks/a5ed065b_b32a_lpddr5/reference_designs/antmicro_lpddr5_testbed/lpddr5-testbed.kicad_pcb

## KiCad design a5ed065b_b32a_lpddr5/reference_designs/antmicro_lpddr5_testbed/lpddr5-testbed.kicad_pcb (2026-05-11)

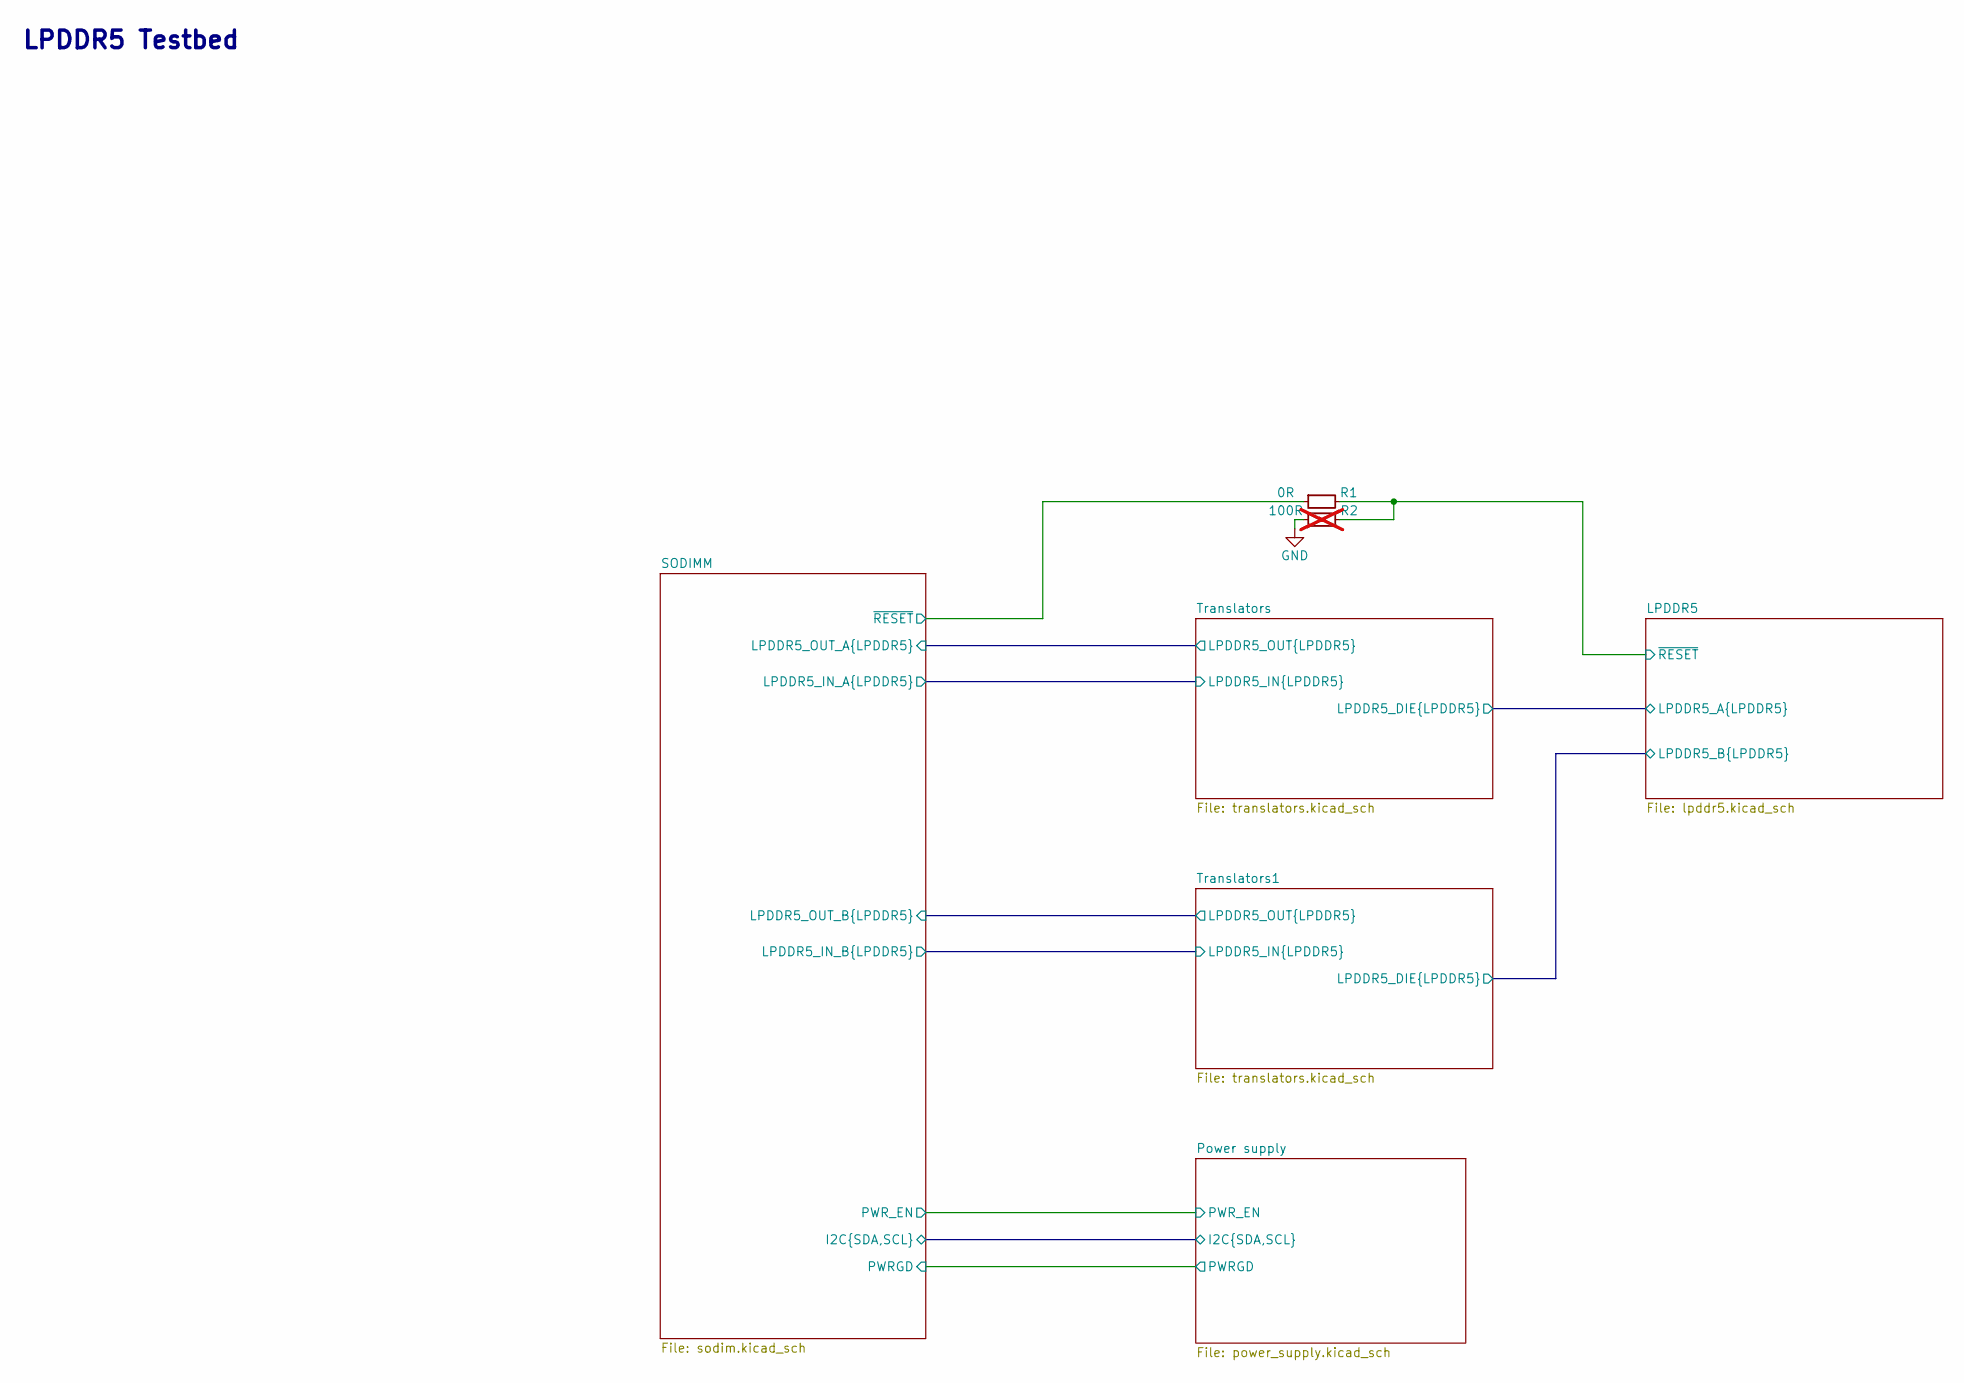
[picture p3: schematic lpddr5-testbed.kicad_sch, LPDDR5 Testbed]

Parts:
R1: R_0R_0402; R_0402_1005Metric; MPN ERJ2GE0R00X
R2: R_100R_0402; R_0402_1005Metric; Tolerance 1%; MPN CR0402-FX-1000GLF; not fitted

Connections:
/LPDDR5/~RESET: R1.2, R2.2; also elsewhere on the board
/SODIMM/~RESET: R1.1; also elsewhere on the board
GND: R2.1; also elsewhere on the board

Notes on the sheet:
LPDDR5 Testbed

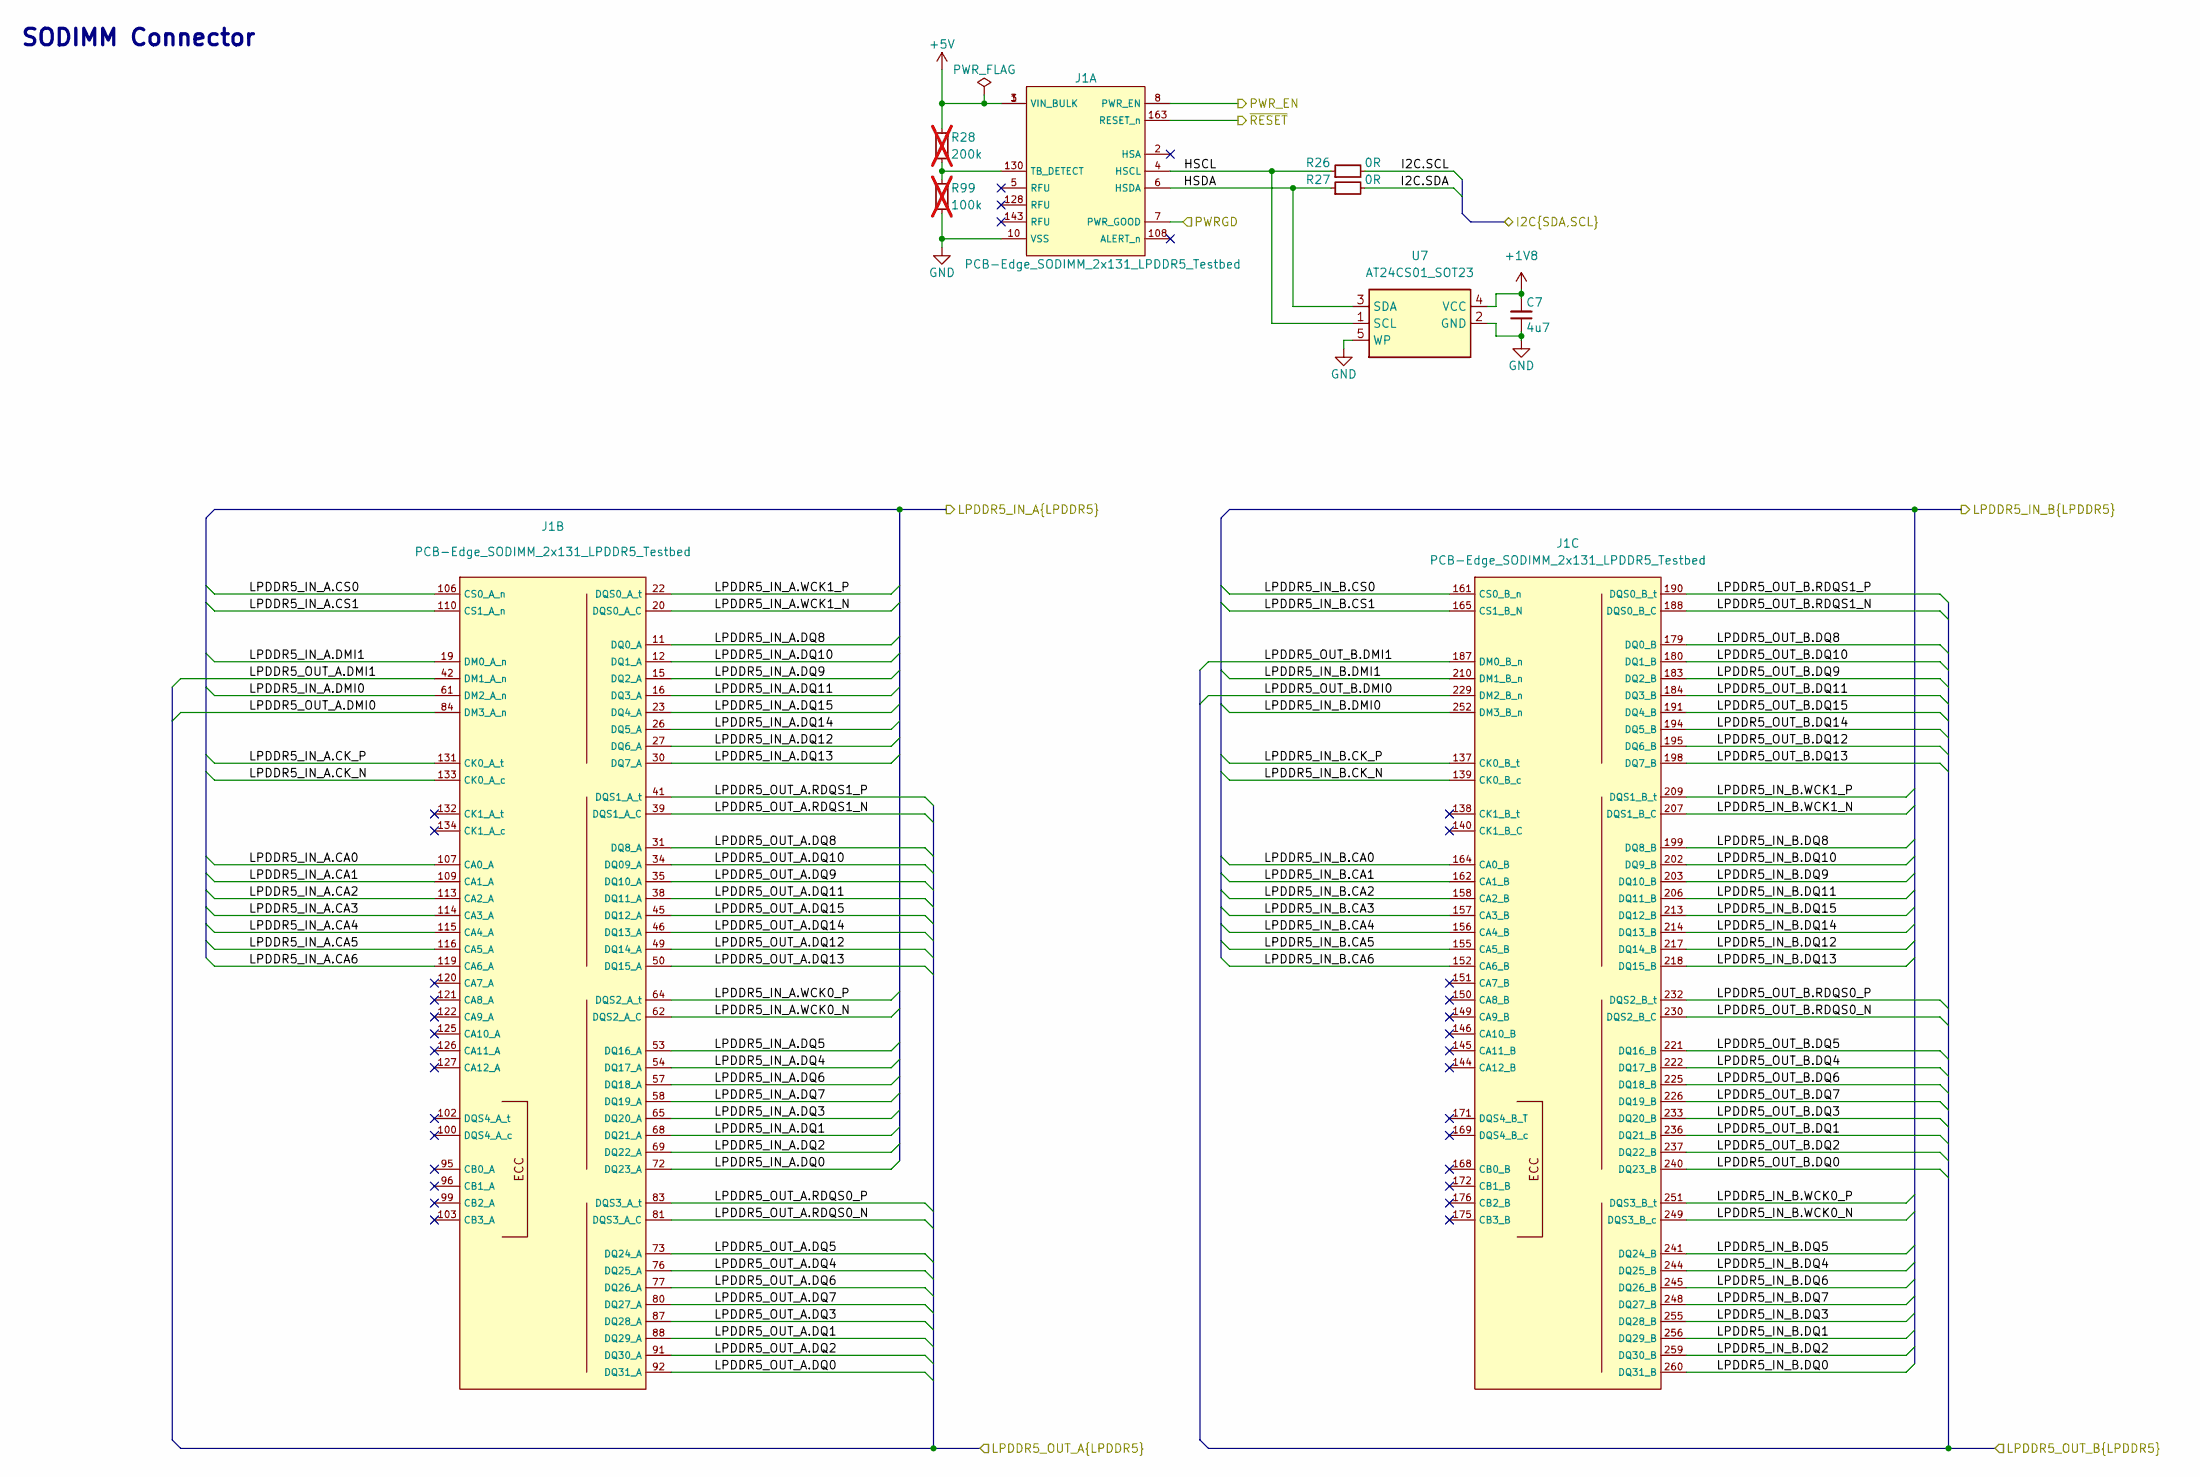
[picture p4: schematic sodim.kicad_sch, LPDDR5 Testbed]

Parts:
C7: C_4u7_0402; C_0402_1005Metric; MPN GRM155R61A475MEAAD
J1: PCB-Edge_SODIMM_2x131_LPDDR5_Testbed; Edge_Conn_Bus_DDR5_SODIMM
R26, R27: R_0R_0402; R_0402_1005Metric; MPN ERJ2GE0R00X
R28: R_200k_0402; R_0402_1005Metric; Tolerance 1%; MPN CR0402-FX-2003GLF; not fitted
R99: R_100k_0402; R_0402_1005Metric; Tolerance 1%; MPN CR0402-FX-1003GLF; not fitted
U7: AT24CS01_SOT23; SOT-23-5; MPN AT24CS01-ST

Connections:
+1V8: C7.2, U7.4 (VCC); also elsewhere on the board
+5V: J1.1 (VIN_BULK), J1.3 (VIN_BULK), R28.1; also elsewhere on the board
/LPDDR5/LPDDR5_A.DMI0: J1.84 (DM3_A_n); also elsewhere on the board
/LPDDR5/LPDDR5_A.DMI1: J1.42 (DM1_A_n); also elsewhere on the board
/LPDDR5/LPDDR5_A.DQ0: J1.92 (DQ31_A); also elsewhere on the board
/LPDDR5/LPDDR5_A.DQ1: J1.88 (DQ29_A); also elsewhere on the board
/LPDDR5/LPDDR5_A.DQ2: J1.91 (DQ30_A); also elsewhere on the board
/LPDDR5/LPDDR5_A.DQ3: J1.87 (DQ28_A); also elsewhere on the board
/LPDDR5/LPDDR5_A.DQ4: J1.76 (DQ25_A); also elsewhere on the board
/LPDDR5/LPDDR5_A.DQ5: J1.73 (DQ24_A); also elsewhere on the board
/LPDDR5/LPDDR5_A.DQ6: J1.77 (DQ26_A); also elsewhere on the board
/LPDDR5/LPDDR5_A.DQ7: J1.80 (DQ27_A); also elsewhere on the board
/LPDDR5/LPDDR5_A.DQ8: J1.31 (DQ8_A); also elsewhere on the board
/LPDDR5/LPDDR5_A.DQ9: J1.35 (DQ10_A); also elsewhere on the board
/LPDDR5/LPDDR5_A.DQ10: J1.34 (DQ09_A); also elsewhere on the board
/LPDDR5/LPDDR5_A.DQ11: J1.38 (DQ11_A); also elsewhere on the board
/LPDDR5/LPDDR5_A.DQ12: J1.49 (DQ14_A); also elsewhere on the board
/LPDDR5/LPDDR5_A.DQ13: J1.50 (DQ15_A); also elsewhere on the board
/LPDDR5/LPDDR5_A.DQ14: J1.46 (DQ13_A); also elsewhere on the board
/LPDDR5/LPDDR5_A.DQ15: J1.45 (DQ12_A); also elsewhere on the board
/LPDDR5/LPDDR5_A.RDQS0_N: J1.81 (DQS3_A_C); also elsewhere on the board
/LPDDR5/LPDDR5_A.RDQS0_P: J1.83 (DQS3_A_t); also elsewhere on the board
/LPDDR5/LPDDR5_A.RDQS1_N: J1.39 (DQS1_A_C); also elsewhere on the board
/LPDDR5/LPDDR5_A.RDQS1_P: J1.41 (DQS1_A_t); also elsewhere on the board
/LPDDR5/LPDDR5_B.DMI0: J1.229 (DM2_B_n); also elsewhere on the board
/LPDDR5/LPDDR5_B.DMI1: J1.187 (DM0_B_n); also elsewhere on the board
/LPDDR5/LPDDR5_B.DQ0: J1.240 (DQ23_B); also elsewhere on the board
/LPDDR5/LPDDR5_B.DQ1: J1.236 (DQ21_B); also elsewhere on the board
/LPDDR5/LPDDR5_B.DQ2: J1.237 (DQ22_B); also elsewhere on the board
/LPDDR5/LPDDR5_B.DQ3: J1.233 (DQ20_B); also elsewhere on the board
/LPDDR5/LPDDR5_B.DQ4: J1.222 (DQ17_B); also elsewhere on the board
/LPDDR5/LPDDR5_B.DQ5: J1.221 (DQ16_B); also elsewhere on the board
/LPDDR5/LPDDR5_B.DQ6: J1.225 (DQ18_B); also elsewhere on the board
/LPDDR5/LPDDR5_B.DQ7: J1.226 (DQ19_B); also elsewhere on the board
/LPDDR5/LPDDR5_B.DQ8: J1.179 (DQ0_B); also elsewhere on the board
/LPDDR5/LPDDR5_B.DQ9: J1.183 (DQ2_B); also elsewhere on the board
/LPDDR5/LPDDR5_B.DQ10: J1.180 (DQ1_B); also elsewhere on the board
/LPDDR5/LPDDR5_B.DQ11: J1.184 (DQ3_B); also elsewhere on the board
/LPDDR5/LPDDR5_B.DQ12: J1.195 (DQ6_B); also elsewhere on the board
/LPDDR5/LPDDR5_B.DQ13: J1.198 (DQ7_B); also elsewhere on the board
/LPDDR5/LPDDR5_B.DQ14: J1.194 (DQ5_B); also elsewhere on the board
/LPDDR5/LPDDR5_B.DQ15: J1.191 (DQ4_B); also elsewhere on the board
/LPDDR5/LPDDR5_B.RDQS0_N: J1.230 (DQS2_B_C); also elsewhere on the board
/LPDDR5/LPDDR5_B.RDQS0_P: J1.232 (DQS2_B_t); also elsewhere on the board
/LPDDR5/LPDDR5_B.RDQS1_N: J1.188 (DQS0_B_C); also elsewhere on the board
/LPDDR5/LPDDR5_B.RDQS1_P: J1.190 (DQS0_B_t); also elsewhere on the board
/Power supply/I2C.SCL: R26.2; also elsewhere on the board
/Power supply/I2C.SDA: R27.2; also elsewhere on the board
/Power supply/PWRGD: J1.7 (PWR_GOOD); also elsewhere on the board
/Power supply/PWR_EN: J1.8 (PWR_EN); also elsewhere on the board
/SODIMM/HSCL: J1.4 (HSCL), R26.1, U7.1 (SCL)
/SODIMM/HSDA: J1.6 (HSDA), R27.1, U7.3 (SDA)
/SODIMM/LPDDR5_IN_A.CA0: J1.107 (CA0_A); also elsewhere on the board
/SODIMM/LPDDR5_IN_A.CA1: J1.109 (CA1_A); also elsewhere on the board
/SODIMM/LPDDR5_IN_A.CA2: J1.113 (CA2_A); also elsewhere on the board
/SODIMM/LPDDR5_IN_A.CA3: J1.114 (CA3_A); also elsewhere on the board
/SODIMM/LPDDR5_IN_A.CA4: J1.115 (CA4_A); also elsewhere on the board
/SODIMM/LPDDR5_IN_A.CA5: J1.116 (CA5_A); also elsewhere on the board
/SODIMM/LPDDR5_IN_A.CA6: J1.119 (CA6_A); also elsewhere on the board
/SODIMM/LPDDR5_IN_A.CK_N: J1.133 (CK0_A_c); also elsewhere on the board
/SODIMM/LPDDR5_IN_A.CK_P: J1.131 (CK0_A_t); also elsewhere on the board
/SODIMM/LPDDR5_IN_A.CS0: J1.106 (CS0_A_n); also elsewhere on the board
/SODIMM/LPDDR5_IN_A.CS1: J1.110 (CS1_A_n); also elsewhere on the board
/SODIMM/LPDDR5_IN_A.DMI0: J1.61 (DM2_A_n); also elsewhere on the board
/SODIMM/LPDDR5_IN_A.DMI1: J1.19 (DM0_A_n); also elsewhere on the board
/SODIMM/LPDDR5_IN_A.DQ0: J1.72 (DQ23_A); also elsewhere on the board
/SODIMM/LPDDR5_IN_A.DQ1: J1.68 (DQ21_A); also elsewhere on the board
/SODIMM/LPDDR5_IN_A.DQ2: J1.69 (DQ22_A); also elsewhere on the board
/SODIMM/LPDDR5_IN_A.DQ3: J1.65 (DQ20_A); also elsewhere on the board
/SODIMM/LPDDR5_IN_A.DQ4: J1.54 (DQ17_A); also elsewhere on the board
/SODIMM/LPDDR5_IN_A.DQ5: J1.53 (DQ16_A); also elsewhere on the board
/SODIMM/LPDDR5_IN_A.DQ6: J1.57 (DQ18_A); also elsewhere on the board
/SODIMM/LPDDR5_IN_A.DQ7: J1.58 (DQ19_A); also elsewhere on the board
/SODIMM/LPDDR5_IN_A.DQ8: J1.11 (DQ0_A); also elsewhere on the board
/SODIMM/LPDDR5_IN_A.DQ9: J1.15 (DQ2_A); also elsewhere on the board
/SODIMM/LPDDR5_IN_A.DQ10: J1.12 (DQ1_A); also elsewhere on the board
/SODIMM/LPDDR5_IN_A.DQ11: J1.16 (DQ3_A); also elsewhere on the board
/SODIMM/LPDDR5_IN_A.DQ12: J1.27 (DQ6_A); also elsewhere on the board
/SODIMM/LPDDR5_IN_A.DQ13: J1.30 (DQ7_A); also elsewhere on the board
/SODIMM/LPDDR5_IN_A.DQ14: J1.26 (DQ5_A); also elsewhere on the board
/SODIMM/LPDDR5_IN_A.DQ15: J1.23 (DQ4_A); also elsewhere on the board
/SODIMM/LPDDR5_IN_A.WCK0_N: J1.62 (DQS2_A_C); also elsewhere on the board
/SODIMM/LPDDR5_IN_A.WCK0_P: J1.64 (DQS2_A_t); also elsewhere on the board
/SODIMM/LPDDR5_IN_A.WCK1_N: J1.20 (DQS0_A_C); also elsewhere on the board
/SODIMM/LPDDR5_IN_A.WCK1_P: J1.22 (DQS0_A_t); also elsewhere on the board
/SODIMM/LPDDR5_IN_B.CA0: J1.164 (CA0_B); also elsewhere on the board
/SODIMM/LPDDR5_IN_B.CA1: J1.162 (CA1_B); also elsewhere on the board
/SODIMM/LPDDR5_IN_B.CA2: J1.158 (CA2_B); also elsewhere on the board
/SODIMM/LPDDR5_IN_B.CA3: J1.157 (CA3_B); also elsewhere on the board
/SODIMM/LPDDR5_IN_B.CA4: J1.156 (CA4_B); also elsewhere on the board
/SODIMM/LPDDR5_IN_B.CA5: J1.155 (CA5_B); also elsewhere on the board
/SODIMM/LPDDR5_IN_B.CA6: J1.152 (CA6_B); also elsewhere on the board
/SODIMM/LPDDR5_IN_B.CK_N: J1.139 (CK0_B_c); also elsewhere on the board
/SODIMM/LPDDR5_IN_B.CK_P: J1.137 (CK0_B_t); also elsewhere on the board
/SODIMM/LPDDR5_IN_B.CS0: J1.161 (CS0_B_n); also elsewhere on the board
/SODIMM/LPDDR5_IN_B.CS1: J1.165 (CS1_B_N); also elsewhere on the board
/SODIMM/LPDDR5_IN_B.DMI0: J1.252 (DM3_B_n); also elsewhere on the board
/SODIMM/LPDDR5_IN_B.DMI1: J1.210 (DM1_B_n); also elsewhere on the board
/SODIMM/LPDDR5_IN_B.DQ0: J1.260 (DQ31_B); also elsewhere on the board
/SODIMM/LPDDR5_IN_B.DQ1: J1.256 (DQ29_B); also elsewhere on the board
/SODIMM/LPDDR5_IN_B.DQ2: J1.259 (DQ30_B); also elsewhere on the board
/SODIMM/LPDDR5_IN_B.DQ3: J1.255 (DQ28_B); also elsewhere on the board
/SODIMM/LPDDR5_IN_B.DQ4: J1.244 (DQ25_B); also elsewhere on the board
/SODIMM/LPDDR5_IN_B.DQ5: J1.241 (DQ24_B); also elsewhere on the board
/SODIMM/LPDDR5_IN_B.DQ6: J1.245 (DQ26_B); also elsewhere on the board
/SODIMM/LPDDR5_IN_B.DQ7: J1.248 (DQ27_B); also elsewhere on the board
/SODIMM/LPDDR5_IN_B.DQ8: J1.199 (DQ8_B); also elsewhere on the board
/SODIMM/LPDDR5_IN_B.DQ9: J1.203 (DQ10_B); also elsewhere on the board
/SODIMM/LPDDR5_IN_B.DQ10: J1.202 (DQ9_B); also elsewhere on the board
/SODIMM/LPDDR5_IN_B.DQ11: J1.206 (DQ11_B); also elsewhere on the board
/SODIMM/LPDDR5_IN_B.DQ12: J1.217 (DQ14_B); also elsewhere on the board
/SODIMM/LPDDR5_IN_B.DQ13: J1.218 (DQ15_B); also elsewhere on the board
/SODIMM/LPDDR5_IN_B.DQ14: J1.214 (DQ13_B); also elsewhere on the board
/SODIMM/LPDDR5_IN_B.DQ15: J1.213 (DQ12_B); also elsewhere on the board
/SODIMM/LPDDR5_IN_B.WCK0_N: J1.249 (DQS3_B_c); also elsewhere on the board
/SODIMM/LPDDR5_IN_B.WCK0_P: J1.251 (DQS3_B_t); also elsewhere on the board
/SODIMM/LPDDR5_IN_B.WCK1_N: J1.207 (DQS1_B_C); also elsewhere on the board
/SODIMM/LPDDR5_IN_B.WCK1_P: J1.209 (DQS1_B_t); also elsewhere on the board
/SODIMM/~RESET: J1.163 (RESET_n); also elsewhere on the board
GND: C7.1, J1.9 (VSS), J1.10 (VSS), J1.13 (VSS), J1.14 (VSS), J1.17 (VSS), J1.18 (VSS), J1.21 (VSS), J1.24 (VSS), J1.25 (VSS), J1.28 (VSS), J1.29 (VSS), J1.32 (VSS), J1.33 (VSS), J1.36 (VSS), J1.37 (VSS), J1.40 (VSS), J1.43 (VSS), J1.44 (VSS), J1.47 (VSS), J1.48 (VSS), J1.51 (VSS), J1.52 (VSS), J1.55 (VSS), J1.56 (VSS), J1.59 (VSS), J1.60 (VSS), J1.63 (VSS), J1.66 (VSS), J1.67 (VSS), J1.70 (VSS), J1.71 (VSS), J1.74 (VSS), J1.75 (VSS), J1.78 (VSS), J1.79 (VSS), J1.82 (VSS), J1.85 (VSS), J1.86 (VSS), J1.89 (VSS), J1.90 (VSS), J1.93 (VSS), J1.94 (VSS), J1.97 (VSS), J1.98 (VSS), J1.101 (VSS), J1.104 (VSS), J1.105 (VSS), J1.111 (VSS), J1.112 (VSS), J1.117 (VSS), J1.118 (VSS), J1.123 (VSS), J1.124 (VSS), J1.129 (VSS), J1.135 (VSS), J1.136 (VSS), J1.141 (VSS), J1.142 (VSS), J1.147 (VSS), J1.148 (VSS), J1.153 (VSS), J1.154 (VSS), J1.159 (VSS), J1.160 (VSS), J1.166 (VSS), J1.167 (VSS), J1.170 (VSS), J1.173 (VSS), J1.174 (VSS), J1.177 (VSS), J1.178 (VSS), J1.181 (VSS), J1.182 (VSS), J1.185 (VSS), J1.186 (VSS), J1.189 (VSS), J1.192 (VSS), J1.193 (VSS), J1.196 (VSS), J1.197 (VSS), J1.200 (VSS), J1.201 (VSS), J1.204 (VSS), J1.205 (VSS), J1.208 (VSS), J1.211 (VSS), J1.212 (VSS), J1.215 (VSS), J1.216 (VSS), J1.219 (VSS), J1.220 (VSS), J1.223 (VSS), J1.224 (VSS), J1.227 (VSS), J1.228 (VSS), J1.231 (VSS), J1.234 (VSS), J1.235 (VSS), J1.238 (VSS), J1.239 (VSS), J1.242 (VSS), J1.243 (VSS), J1.246 (VSS), J1.247 (VSS), J1.250 (VSS), J1.253 (VSS), J1.254 (VSS), J1.257 (VSS), J1.258 (VSS), J1.261 (VSS), J1.262 (VSS), R99.2, U7.2 (GND), U7.5 (WP); also elsewhere on the board
unnamed: J1.130 (TB_DETECT), R28.2, R99.1

Notes on the sheet:
SODIMM Connector

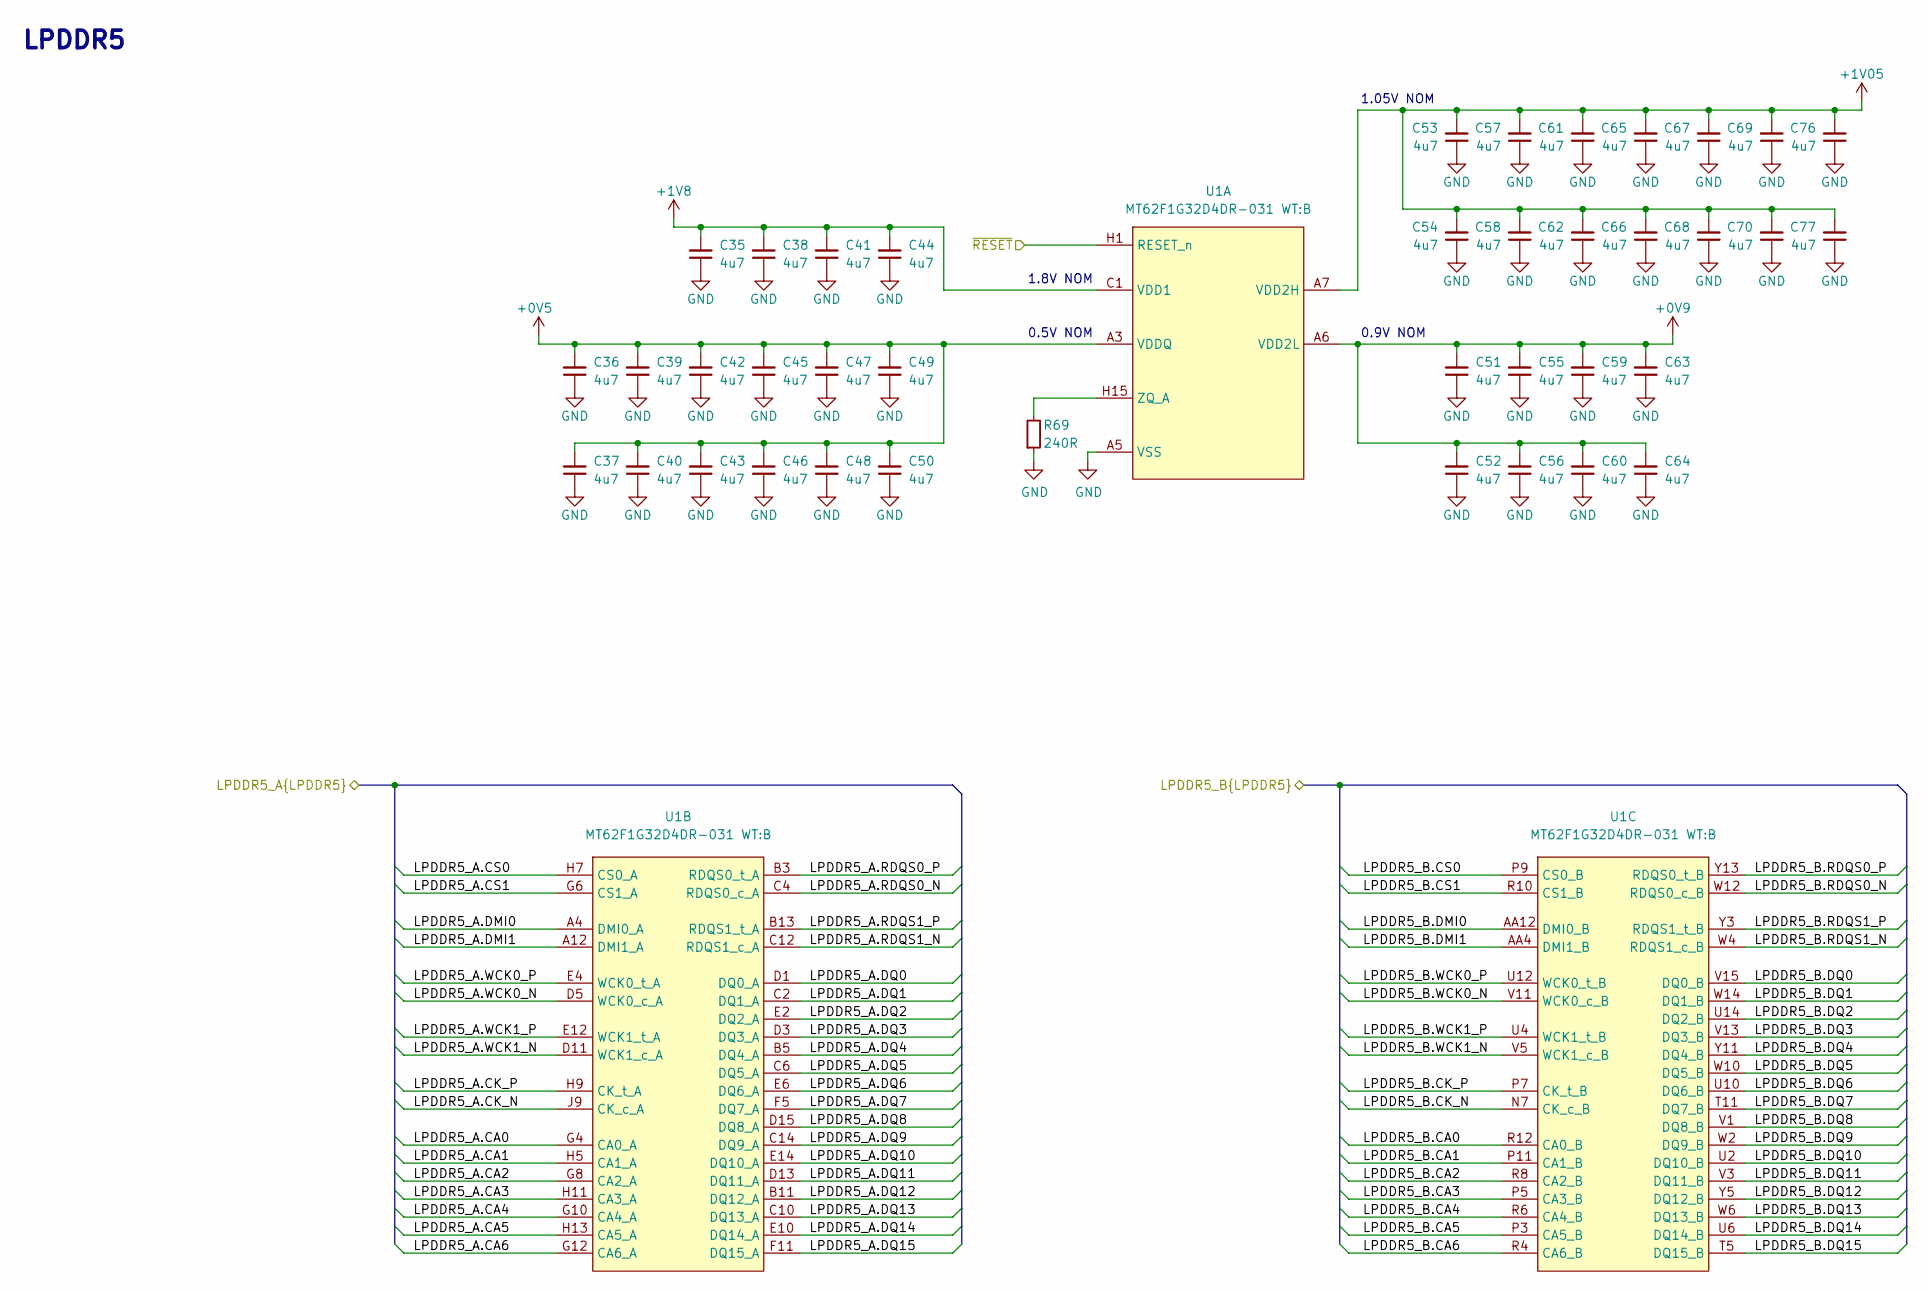
[picture p5: schematic lpddr5.kicad_sch, LPDDR5 Testbed]

Parts:
C35, C36, C37, C38, C39, C40, C41, C42, C43, C44, C45, C46, C47, C48, C49, C50, C51, C52, C53, C54, C55, C56, C57, C58, C59, C60, C61, C62, C63, C64, C65, C66, C67, C68, C69, C70, C76, C77: C_4u7_0402; C_0402_1005Metric; MPN GRM155R61A475MEAAD
R69: R_240R_0402; R_0402_1005Metric; Tolerance 1%; MPN CR0402-FX-2400GLF
U1: MT62F1G32D4DR-031; BGA-315_12.4x15mm_Layout15x21_P0.8x0.7mm; MPN MT62F1G32D4DR-031 WT:B

Connections:
+0V5: C36.2, C37.2, C39.2, C40.2, C42.2, C43.2, C45.2, C46.2, C47.2, C48.2, C49.2, C50.2, U1.A3 (VDDQ), U1.A13 (VDDQ), U1.AA3 (VDDQ), U1.AA13 (VDDQ), U1.B2 (VDDQ), U1.B14 (VDDQ), U1.C3 (VDDQ), U1.C13 (VDDQ), U1.D4 (VDDQ), U1.D12 (VDDQ), U1.E5 (VDDQ), U1.E11 (VDDQ), U1.F1 (VDDQ), U1.F3 (VDDQ), U1.F4 (VDDQ), U1.F12 (VDDQ), U1.F13 (VDDQ), U1.F15 (VDDQ), U1.G1 (VDDQ), U1.G2 (VDDQ), U1.G14 (VDDQ), U1.G15 (VDDQ), U1.R1 (VDDQ), U1.R2 (VDDQ), U1.R14 (VDDQ), U1.R15 (VDDQ), U1.T1 (VDDQ), U1.T3 (VDDQ), U1.T4 (VDDQ), U1.T12 (VDDQ), U1.T13 (VDDQ), U1.T15 (VDDQ), U1.U5 (VDDQ), U1.U11 (VDDQ), U1.V4 (VDDQ), U1.V12 (VDDQ), U1.W3 (VDDQ), U1.W13 (VDDQ), U1.Y2 (VDDQ), U1.Y14 (VDDQ); also elsewhere on the board
+0V9: C51.2, C52.2, C55.2, C56.2, C59.2, C60.2, C63.2, C64.2, U1.A6 (VDD2L), U1.A10 (VDD2L), U1.AA6 (VDD2L), U1.AA10 (VDD2L), U1.B6 (VDD2L), U1.B10 (VDD2L), U1.H2 (VDD2L), U1.H14 (VDD2L), U1.J2 (VDD2L), U1.J14 (VDD2L), U1.N2 (VDD2L), U1.N14 (VDD2L), U1.P2 (VDD2L), U1.P14 (VDD2L), U1.Y6 (VDD2L), U1.Y10 (VDD2L); also elsewhere on the board
+1V05: C53.2, C54.2, C57.2, C58.2, C61.2, C62.2, C65.2, C66.2, C67.2, C68.2, C69.2, C70.2, C76.2, C77.2, U1.A7 (VDD2H), U1.A8 (VDD2H), U1.A9 (VDD2H), U1.AA7 (VDD2H), U1.AA8 (VDD2H), U1.AA9 (VDD2H), U1.B7 (VDD2H), U1.B9 (VDD2H), U1.C7 (VDD2H), U1.C9 (VDD2H), U1.D8 (VDD2H), U1.E7 (VDD2H), U1.E9 (VDD2H), U1.F6 (VDD2H), U1.F7 (VDD2H), U1.F9 (VDD2H), U1.F10 (VDD2H), U1.J5 (VDD2H), U1.J11 (VDD2H), U1.K1 (VDD2H), U1.K2 (VDD2H), U1.K3 (VDD2H), U1.K4 (VDD2H), U1.K5 (VDD2H), U1.K6 (VDD2H), U1.K10 (VDD2H), U1.K11 (VDD2H), U1.K12 (VDD2H), U1.K13 (VDD2H), U1.K14 (VDD2H), U1.K15 (VDD2H), U1.L6 (VDD2H), U1.L7 (VDD2H), U1.L8 (VDD2H), U1.L9 (VDD2H), U1.L10 (VDD2H), U1.M1 (VDD2H), U1.M2 (VDD2H), U1.M3 (VDD2H), U1.M4 (VDD2H), U1.M5 (VDD2H), U1.M6 (VDD2H), U1.M10 (VDD2H), U1.M11 (VDD2H), U1.M12 (VDD2H), U1.M13 (VDD2H), U1.M14 (VDD2H), U1.M15 (VDD2H), U1.N5 (VDD2H), U1.N11 (VDD2H), U1.T6 (VDD2H), U1.T7 (VDD2H), U1.T9 (VDD2H), U1.T10 (VDD2H), U1.U7 (VDD2H), U1.U9 (VDD2H), U1.V8 (VDD2H), U1.W7 (VDD2H), U1.W9 (VDD2H), U1.Y7 (VDD2H), U1.Y9 (VDD2H); also elsewhere on the board
+1V8: C35.2, C38.2, C41.2, C44.2, U1.C1 (VDD1), U1.C15 (VDD1), U1.W1 (VDD1), U1.W15 (VDD1); also elsewhere on the board
/LPDDR5/LPDDR5_A.CA0: U1.G4 (CA0_A); also elsewhere on the board
/LPDDR5/LPDDR5_A.CA1: U1.H5 (CA1_A); also elsewhere on the board
/LPDDR5/LPDDR5_A.CA2: U1.G8 (CA2_A); also elsewhere on the board
/LPDDR5/LPDDR5_A.CA3: U1.H11 (CA3_A); also elsewhere on the board
/LPDDR5/LPDDR5_A.CA4: U1.G10 (CA4_A); also elsewhere on the board
/LPDDR5/LPDDR5_A.CA5: U1.H13 (CA5_A); also elsewhere on the board
/LPDDR5/LPDDR5_A.CA6: U1.G12 (CA6_A); also elsewhere on the board
/LPDDR5/LPDDR5_A.CK_N: U1.J9 (CK_c_A); also elsewhere on the board
/LPDDR5/LPDDR5_A.CK_P: U1.H9 (CK_t_A); also elsewhere on the board
/LPDDR5/LPDDR5_A.CS0: U1.H7 (CS0_A); also elsewhere on the board
/LPDDR5/LPDDR5_A.CS1: U1.G6 (CS1_A); also elsewhere on the board
/LPDDR5/LPDDR5_A.DMI0: U1.A4 (DMI0_A); also elsewhere on the board
/LPDDR5/LPDDR5_A.DMI1: U1.A12 (DMI1_A); also elsewhere on the board
/LPDDR5/LPDDR5_A.DQ0: U1.D1 (DQ0_A); also elsewhere on the board
/LPDDR5/LPDDR5_A.DQ1: U1.C2 (DQ1_A); also elsewhere on the board
/LPDDR5/LPDDR5_A.DQ2: U1.E2 (DQ2_A); also elsewhere on the board
/LPDDR5/LPDDR5_A.DQ3: U1.D3 (DQ3_A); also elsewhere on the board
/LPDDR5/LPDDR5_A.DQ4: U1.B5 (DQ4_A); also elsewhere on the board
/LPDDR5/LPDDR5_A.DQ5: U1.C6 (DQ5_A); also elsewhere on the board
/LPDDR5/LPDDR5_A.DQ6: U1.E6 (DQ6_A); also elsewhere on the board
/LPDDR5/LPDDR5_A.DQ7: U1.F5 (DQ7_A); also elsewhere on the board
/LPDDR5/LPDDR5_A.DQ8: U1.D15 (DQ8_A); also elsewhere on the board
/LPDDR5/LPDDR5_A.DQ9: U1.C14 (DQ9_A); also elsewhere on the board
/LPDDR5/LPDDR5_A.DQ10: U1.E14 (DQ10_A); also elsewhere on the board
/LPDDR5/LPDDR5_A.DQ11: U1.D13 (DQ11_A); also elsewhere on the board
/LPDDR5/LPDDR5_A.DQ12: U1.B11 (DQ12_A); also elsewhere on the board
/LPDDR5/LPDDR5_A.DQ13: U1.C10 (DQ13_A); also elsewhere on the board
/LPDDR5/LPDDR5_A.DQ14: U1.E10 (DQ14_A); also elsewhere on the board
/LPDDR5/LPDDR5_A.DQ15: U1.F11 (DQ15_A); also elsewhere on the board
/LPDDR5/LPDDR5_A.RDQS0_N: U1.C4 (RDQS0_c_A); also elsewhere on the board
/LPDDR5/LPDDR5_A.RDQS0_P: U1.B3 (RDQS0_t_A); also elsewhere on the board
/LPDDR5/LPDDR5_A.RDQS1_N: U1.C12 (RDQS1_c_A); also elsewhere on the board
/LPDDR5/LPDDR5_A.RDQS1_P: U1.B13 (RDQS1_t_A); also elsewhere on the board
/LPDDR5/LPDDR5_A.WCK0_N: U1.D5 (WCK0_c_A); also elsewhere on the board
/LPDDR5/LPDDR5_A.WCK0_P: U1.E4 (WCK0_t_A); also elsewhere on the board
/LPDDR5/LPDDR5_A.WCK1_N: U1.D11 (WCK1_c_A); also elsewhere on the board
/LPDDR5/LPDDR5_A.WCK1_P: U1.E12 (WCK1_t_A); also elsewhere on the board
/LPDDR5/LPDDR5_B.CA0: U1.R12 (CA0_B); also elsewhere on the board
/LPDDR5/LPDDR5_B.CA1: U1.P11 (CA1_B); also elsewhere on the board
/LPDDR5/LPDDR5_B.CA2: U1.R8 (CA2_B); also elsewhere on the board
/LPDDR5/LPDDR5_B.CA3: U1.P5 (CA3_B); also elsewhere on the board
/LPDDR5/LPDDR5_B.CA4: U1.R6 (CA4_B); also elsewhere on the board
/LPDDR5/LPDDR5_B.CA5: U1.P3 (CA5_B); also elsewhere on the board
/LPDDR5/LPDDR5_B.CA6: U1.R4 (CA6_B); also elsewhere on the board
/LPDDR5/LPDDR5_B.CK_N: U1.N7 (CK_c_B); also elsewhere on the board
/LPDDR5/LPDDR5_B.CK_P: U1.P7 (CK_t_B); also elsewhere on the board
/LPDDR5/LPDDR5_B.CS0: U1.P9 (CS0_B); also elsewhere on the board
/LPDDR5/LPDDR5_B.CS1: U1.R10 (CS1_B); also elsewhere on the board
/LPDDR5/LPDDR5_B.DMI0: U1.AA12 (DMI0_B); also elsewhere on the board
/LPDDR5/LPDDR5_B.DMI1: U1.AA4 (DMI1_B); also elsewhere on the board
/LPDDR5/LPDDR5_B.DQ0: U1.V15 (DQ0_B); also elsewhere on the board
/LPDDR5/LPDDR5_B.DQ1: U1.W14 (DQ1_B); also elsewhere on the board
/LPDDR5/LPDDR5_B.DQ2: U1.U14 (DQ2_B); also elsewhere on the board
/LPDDR5/LPDDR5_B.DQ3: U1.V13 (DQ3_B); also elsewhere on the board
/LPDDR5/LPDDR5_B.DQ4: U1.Y11 (DQ4_B); also elsewhere on the board
/LPDDR5/LPDDR5_B.DQ5: U1.W10 (DQ5_B); also elsewhere on the board
/LPDDR5/LPDDR5_B.DQ6: U1.U10 (DQ6_B); also elsewhere on the board
/LPDDR5/LPDDR5_B.DQ7: U1.T11 (DQ7_B); also elsewhere on the board
/LPDDR5/LPDDR5_B.DQ8: U1.V1 (DQ8_B); also elsewhere on the board
/LPDDR5/LPDDR5_B.DQ9: U1.W2 (DQ9_B); also elsewhere on the board
/LPDDR5/LPDDR5_B.DQ10: U1.U2 (DQ10_B); also elsewhere on the board
/LPDDR5/LPDDR5_B.DQ11: U1.V3 (DQ11_B); also elsewhere on the board
/LPDDR5/LPDDR5_B.DQ12: U1.Y5 (DQ12_B); also elsewhere on the board
/LPDDR5/LPDDR5_B.DQ13: U1.W6 (DQ13_B); also elsewhere on the board
/LPDDR5/LPDDR5_B.DQ14: U1.U6 (DQ14_B); also elsewhere on the board
/LPDDR5/LPDDR5_B.DQ15: U1.T5 (DQ15_B); also elsewhere on the board
/LPDDR5/LPDDR5_B.RDQS0_N: U1.W12 (RDQS0_c_B); also elsewhere on the board
/LPDDR5/LPDDR5_B.RDQS0_P: U1.Y13 (RDQS0_t_B); also elsewhere on the board
/LPDDR5/LPDDR5_B.RDQS1_N: U1.W4 (RDQS1_c_B); also elsewhere on the board
/LPDDR5/LPDDR5_B.RDQS1_P: U1.Y3 (RDQS1_t_B); also elsewhere on the board
/LPDDR5/LPDDR5_B.WCK0_N: U1.V11 (WCK0_c_B); also elsewhere on the board
/LPDDR5/LPDDR5_B.WCK0_P: U1.U12 (WCK0_t_B); also elsewhere on the board
/LPDDR5/LPDDR5_B.WCK1_N: U1.V5 (WCK1_c_B); also elsewhere on the board
/LPDDR5/LPDDR5_B.WCK1_P: U1.U4 (WCK1_t_B); also elsewhere on the board
/LPDDR5/~RESET: U1.H1 (RESET_n); also elsewhere on the board
GND: C35.1, C36.1, C37.1, C38.1, C39.1, C40.1, C41.1, C42.1, C43.1, C44.1, C45.1, C46.1, C47.1, C48.1, C49.1, C50.1, C51.1, C52.1, C53.1, C54.1, C55.1, C56.1, C57.1, C58.1, C59.1, C60.1, C61.1, C62.1, C63.1, C64.1, C65.1, C66.1, C67.1, C68.1, C69.1, C70.1, C76.1, C77.1, R69.1, U1.A5 (VSS), U1.A11 (VSS), U1.AA5 (VSS), U1.AA11 (VSS), U1.B4 (VSS), U1.B8 (VSS), U1.B12 (VSS), U1.C5 (VSS), U1.C8 (VSS), U1.C11 (VSS), U1.D2 (VSS), U1.D6 (VSS), U1.D7 (VSS), U1.D9 (VSS), U1.D10 (VSS), U1.D14 (VSS), U1.E1 (VSS), U1.E3 (VSS), U1.E8 (VSS), U1.E13 (VSS), U1.E15 (VSS), U1.F2 (VSS), U1.F8 (VSS), U1.F14 (VSS), U1.G3 (VSS), U1.G5 (VSS), U1.G7 (VSS), U1.G9 (VSS), U1.G11 (VSS), U1.G13 (VSS), U1.H3 (VSS), U1.H4 (VSS), U1.H6 (VSS), U1.H8 (VSS), U1.H10 (VSS), U1.H12 (VSS), U1.J1 (VSS), U1.J3 (VSS), U1.J7 (VSS), U1.J8 (VSS), U1.J10 (VSS), U1.J12 (VSS), U1.J13 (VSS), U1.J15 (VSS), U1.K7 (VSS), U1.K8 (VSS), U1.K9 (VSS), U1.L1 (VSS), U1.L2 (VSS), U1.L3 (VSS), U1.L4 (VSS), U1.L5 (VSS), U1.L11 (VSS), U1.L12 (VSS), U1.L13 (VSS), U1.L14 (VSS), U1.L15 (VSS), U1.M7 (VSS), U1.M8 (VSS), U1.M9 (VSS), U1.N1 (VSS), U1.N3 (VSS), U1.N4 (VSS), U1.N6 (VSS), U1.N8 (VSS), U1.N9 (VSS), U1.N10 (VSS), U1.N12 (VSS), U1.N13 (VSS), U1.N15 (VSS), U1.P4 (VSS), U1.P6 (VSS), U1.P8 (VSS), U1.P10 (VSS), U1.P12 (VSS), U1.P13 (VSS), U1.R3 (VSS), U1.R5 (VSS), U1.R7 (VSS), U1.R9 (VSS), U1.R11 (VSS), U1.R13 (VSS), U1.T2 (VSS), U1.T8 (VSS), U1.T14 (VSS), U1.U1 (VSS), U1.U3 (VSS), U1.U8 (VSS), U1.U13 (VSS), U1.U15 (VSS), U1.V2 (VSS), U1.V6 (VSS), U1.V7 (VSS), U1.V9 (VSS), U1.V10 (VSS), U1.V14 (VSS), U1.W5 (VSS), U1.W8 (VSS), U1.W11 (VSS), U1.Y4 (VSS), U1.Y8 (VSS), U1.Y12 (VSS); also elsewhere on the board
unnamed: R69.2, U1.H15 (ZQ_A)

Notes on the sheet:
0.5V NOM
0.9V NOM
1.05V NOM
LPDDR5
1.8V NOM
