joyhpc/misc-tasks/a5ed065b_b32a_lpddr5/reference_designs/antmicro_lpddr5_testbed/lpddr5-testbed.kicad_pcb

## KiCad design a5ed065b_b32a_lpddr5/reference_designs/antmicro_lpddr5_testbed/lpddr5-testbed.kicad_pcb (continued)

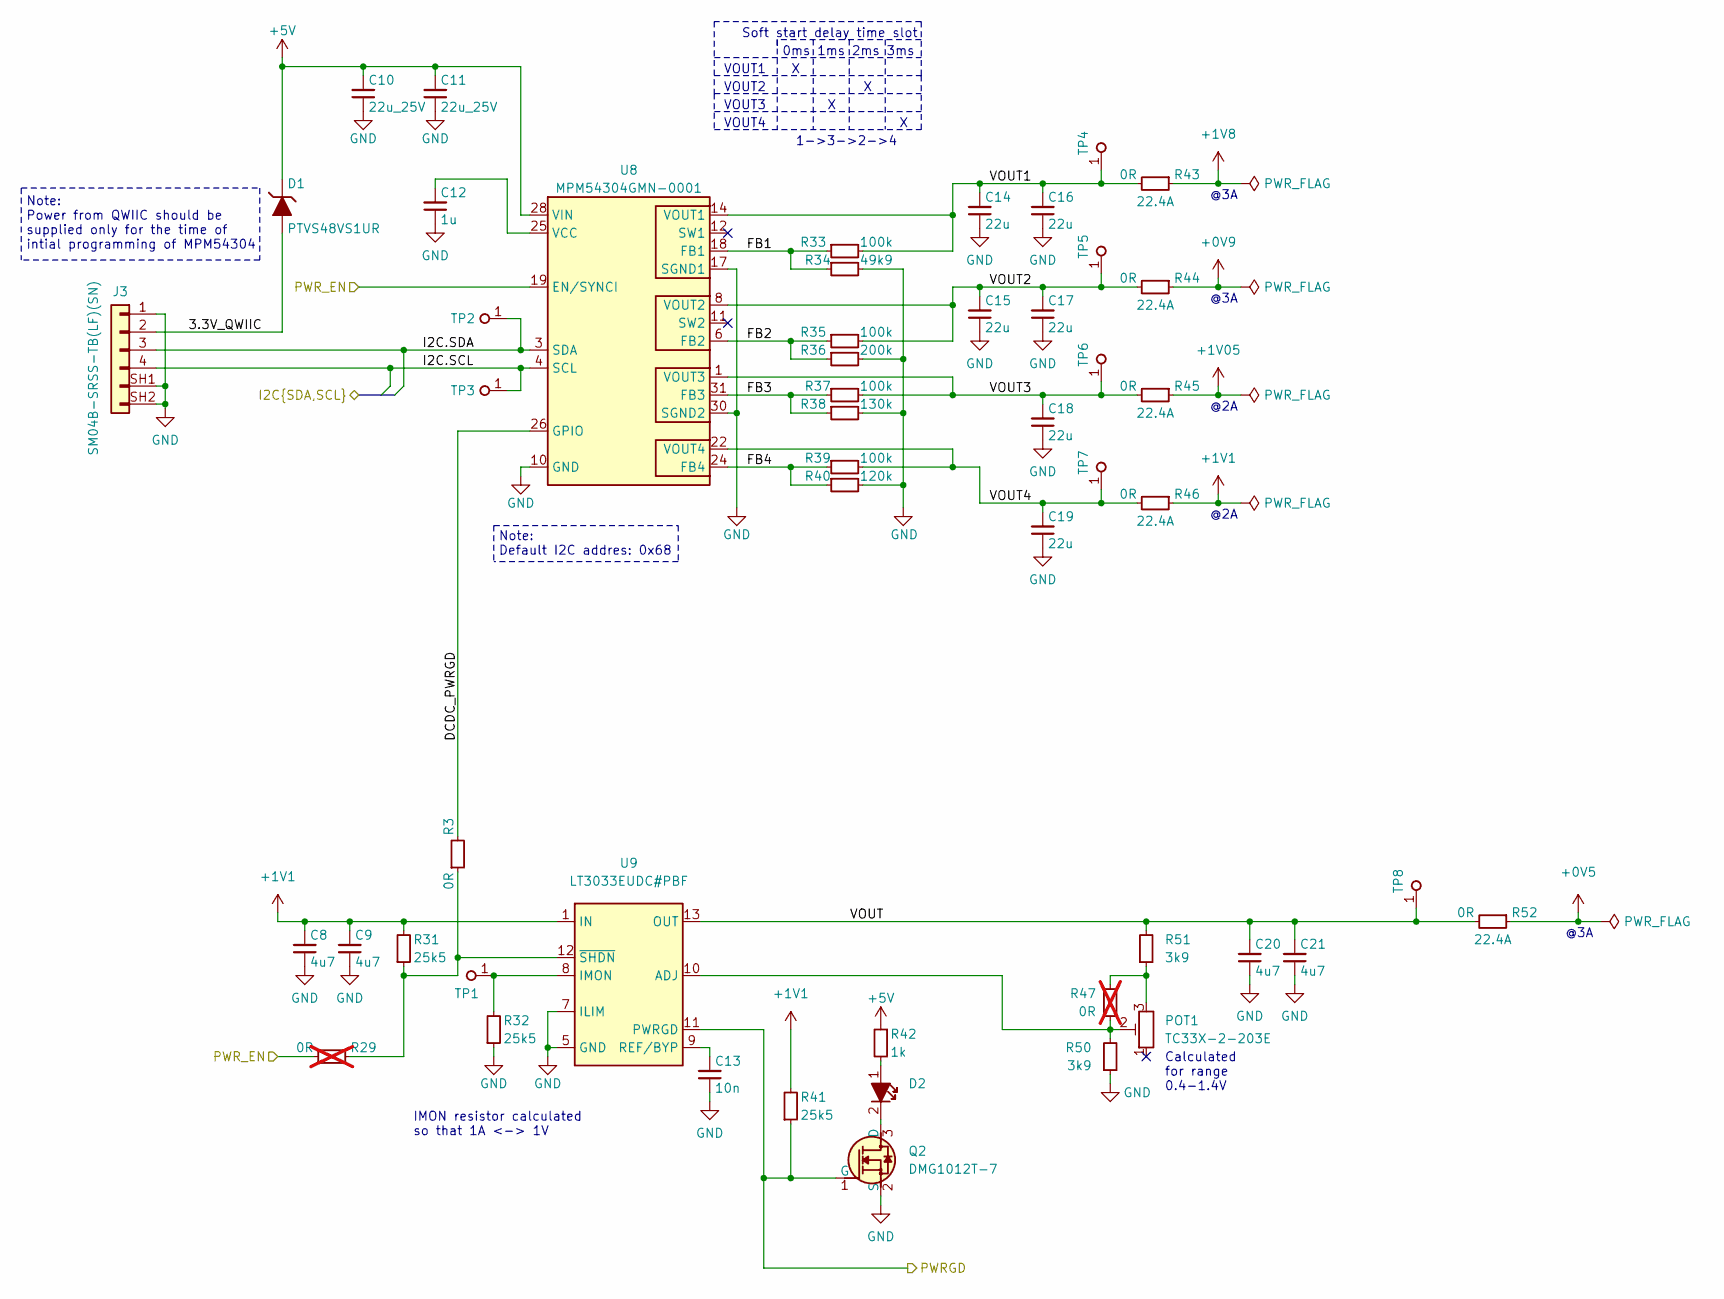
[picture p6: schematic power_supply.kicad_sch, LPDDR5 Testbed]

Parts:
C8, C9, C20, C21: C_4u7_0402; C_0402_1005Metric; MPN GRM155R61A475MEAAD
C10, C11: C_22u_25V_0805; C_0805_2012Metric; MPN CL21A226MAYNNNE
C12: C_1u_0402; C_0402_1005Metric; MPN C1005X6S1A105K050BC
C13: C_10n_0402; C_0402_1005Metric; Voltage 50V; MPN GRM155R71H103KA88D
C14, C15, C16, C17, C18, C19: C_22u_0603; C_0603_1608Metric; MPN GRM188R60J226MEA0D
D1: PTVS48VS1UR; D_SOD-123F; MPN PTVS48VS1UR,115
D2: LED_G_0603_KP-1608CGCK; LED_0603_1608Metric_G; MPN KP-1608CGCK
J3: JST_SH_1x4_SM04B-SRSS-TB-LF-SN; Conn_JST_SH_1x4_SM04B-SRSS-TB-LF-SN; MPN SM04B-SRSS-TB(LF)(SN)
POT1: TC33X-2-203E; Trimpot_3.8mmx3.6mm_TC33X-2-103E; MPN TC33X-2-203E
Q2: DMG1012T-7; SOT-523; MPN DMG1012T-7
R3: R_0R_0402; R_0402_1005Metric; MPN ERJ2GE0R00X
R29, R47: R_0R_0402; R_0402_1005Metric; MPN ERJ2GE0R00X; not fitted
R31, R32, R41: R_25k5_0402; R_0402_1005Metric; Tolerance 1%; MPN CR0402-FX-2552GLF
R33, R35, R37, R39: R_100k_0402; R_0402_1005Metric; Tolerance 1%; MPN CR0402-FX-1003GLF
R34: R_49k9_0402; R_0402_1005Metric; Tolerance 1%; MPN CR0402-FX-4992GLF
R36: R_200k_0402; R_0402_1005Metric; Tolerance 1%; MPN CR0402-FX-2003GLF
R38: R_130k_0402; R_0402_1005Metric; Tolerance 1%; MPN CR0402-FX-1303GLF
R40: R_120k_0402; R_0402_1005Metric; Tolerance 1%; MPN CR0402-FX-1203GLF
R42: R_1k_0402; R_0402_1005Metric; Tolerance 1%; MPN CR0402-FX-1001GLF
R43, R44, R45, R46, R52: R_0R_22.4A_0603; R_0603_1608Metric; Tolerance template_tolerance; MPN PMR03EZPJ000
R50, R51: R_3k9_0402; R_0402_1005Metric; Tolerance 1%; MPN CR0402-FX-3901GLF
TP1, TP4, TP5, TP6, TP7, TP8: TP_0.75mm_SMD; TP_SMD_0.75mm
TP2, TP3: TP_1mm_SMD; TP_SMD_1mm
U8: MPM54304GMN-0001; LGA-33_7x7mm_P0.65mm; MPN MPM54304GMN-0001
U9: LT3033EUDC_QFN; QFN-20-4EP_3x4x0.75mm_P0.5mm_Layout4x6_LT3033; MPN LT3033EUDC#PBF

Connections:
+0V5: R52.1; also elsewhere on the board
+0V9: R44.1; also elsewhere on the board
+1V1: C8.2, C9.2, R31.2, R41.2, R46.1, U9.1 (IN), U9.2 (IN), U9.15 (IN), U9.16 (IN), U9.21 (IN), U9.22 (IN)
+1V05: R45.1; also elsewhere on the board
+1V8: R43.1; also elsewhere on the board
+5V: C10.2, C11.2, D1.K (C), R42.1, U8.28 (VIN), U8.29 (VIN); also elsewhere on the board
/Power supply/3.3V_QWIIC: D1.A, J3.2
/Power supply/DCDC_PWRGD: R3.2, U8.26 (GPIO)
/Power supply/FB1: R33.1, R34.1, U8.18 (FB1)
/Power supply/FB2: R35.1, R36.1, U8.6 (FB2)
/Power supply/FB3: R37.1, R38.1, U8.31 (FB3)
/Power supply/FB4: R39.1, R40.1, U8.24 (FB4)
/Power supply/I2C.SCL: J3.4, TP3.1, U8.4 (SCL); also elsewhere on the board
/Power supply/I2C.SDA: J3.3, TP2.1, U8.3 (SDA); also elsewhere on the board
/Power supply/PWRGD: Q2.1 (G), R41.1, U9.11 (PWRGD); also elsewhere on the board
/Power supply/PWR_EN: R29.1, U8.19 (EN/SYNCI); also elsewhere on the board
/Power supply/VOUT: C20.2, C21.2, R51.2, R52.2, TP8.1, U9.3 (OUT), U9.4 (OUT), U9.13 (OUT), U9.14 (OUT), U9.17 (OUT), U9.18 (OUT), U9.19 (OUT), U9.20 (OUT), U9.23 (OUT), U9.24 (OUT)
/Power supply/VOUT1: C14.2, C16.2, R33.2, R43.2, TP4.1, U8.14 (VOUT1), U8.15 (VOUT1)
/Power supply/VOUT2: C15.2, C17.2, R35.2, R44.2, TP5.1, U8.8 (VOUT2), U8.9 (VOUT2)
/Power supply/VOUT3: C18.2, R37.2, R45.2, TP6.1, U8.1 (VOUT3), U8.32 (VOUT3)
/Power supply/VOUT4: C19.2, R39.2, R46.2, TP7.1, U8.22 (VOUT4), U8.23 (VOUT4)
GND: C8.1, C9.1, C10.1, C11.1, C12.1, C13.1, C14.1, C15.1, C16.1, C17.1, C18.1, C19.1, C20.1, C21.1, J3.1, J3.SH1, J3.SH2, Q2.2 (S), R32.1, R34.2, R36.2, R38.2, R40.2, R50.1, U8.2 (GND), U8.5 (GND), U8.7 (GND), U8.10 (GND), U8.13 (GND), U8.16 (GND), U8.17 (SGND1), U8.20 (GND), U8.21 (GND), U8.27 (GND), U8.30 (SGND2), U8.33 (GND), U9.5 (GND), U9.6 (GND), U9.7 (ILIM); also elsewhere on the board
unnamed: C12.2, U8.25 (VCC)
unnamed: C13.2, U9.9 (REF/BYP)
unnamed: D2.1, R42.2
unnamed: D2.2, Q2.3 (D)
unnamed: POT1.2, R47.1, R50.2, U9.10 (ADJ)
unnamed: POT1.3, R47.2, R51.1
unnamed: R3.1, R29.2, R31.1, U9.12 (~SHDN)
unnamed: R32.2, TP1.1, U9.8 (IMON)

Notes on the sheet:
@2A
Soft start delay time slot
VOUT4
VOUT1
@3A
Note: Default I2C addres: 0x68
Note: Power from QWIIC should be supplied only for the time of intial programming of MPM54304
Calculated for range 0.4-1.4V
1->3->2->4
VOUT3
VOUT2
0ms 1ms 2ms 3ms
IMON resistor calculated so that 1A <-> 1V

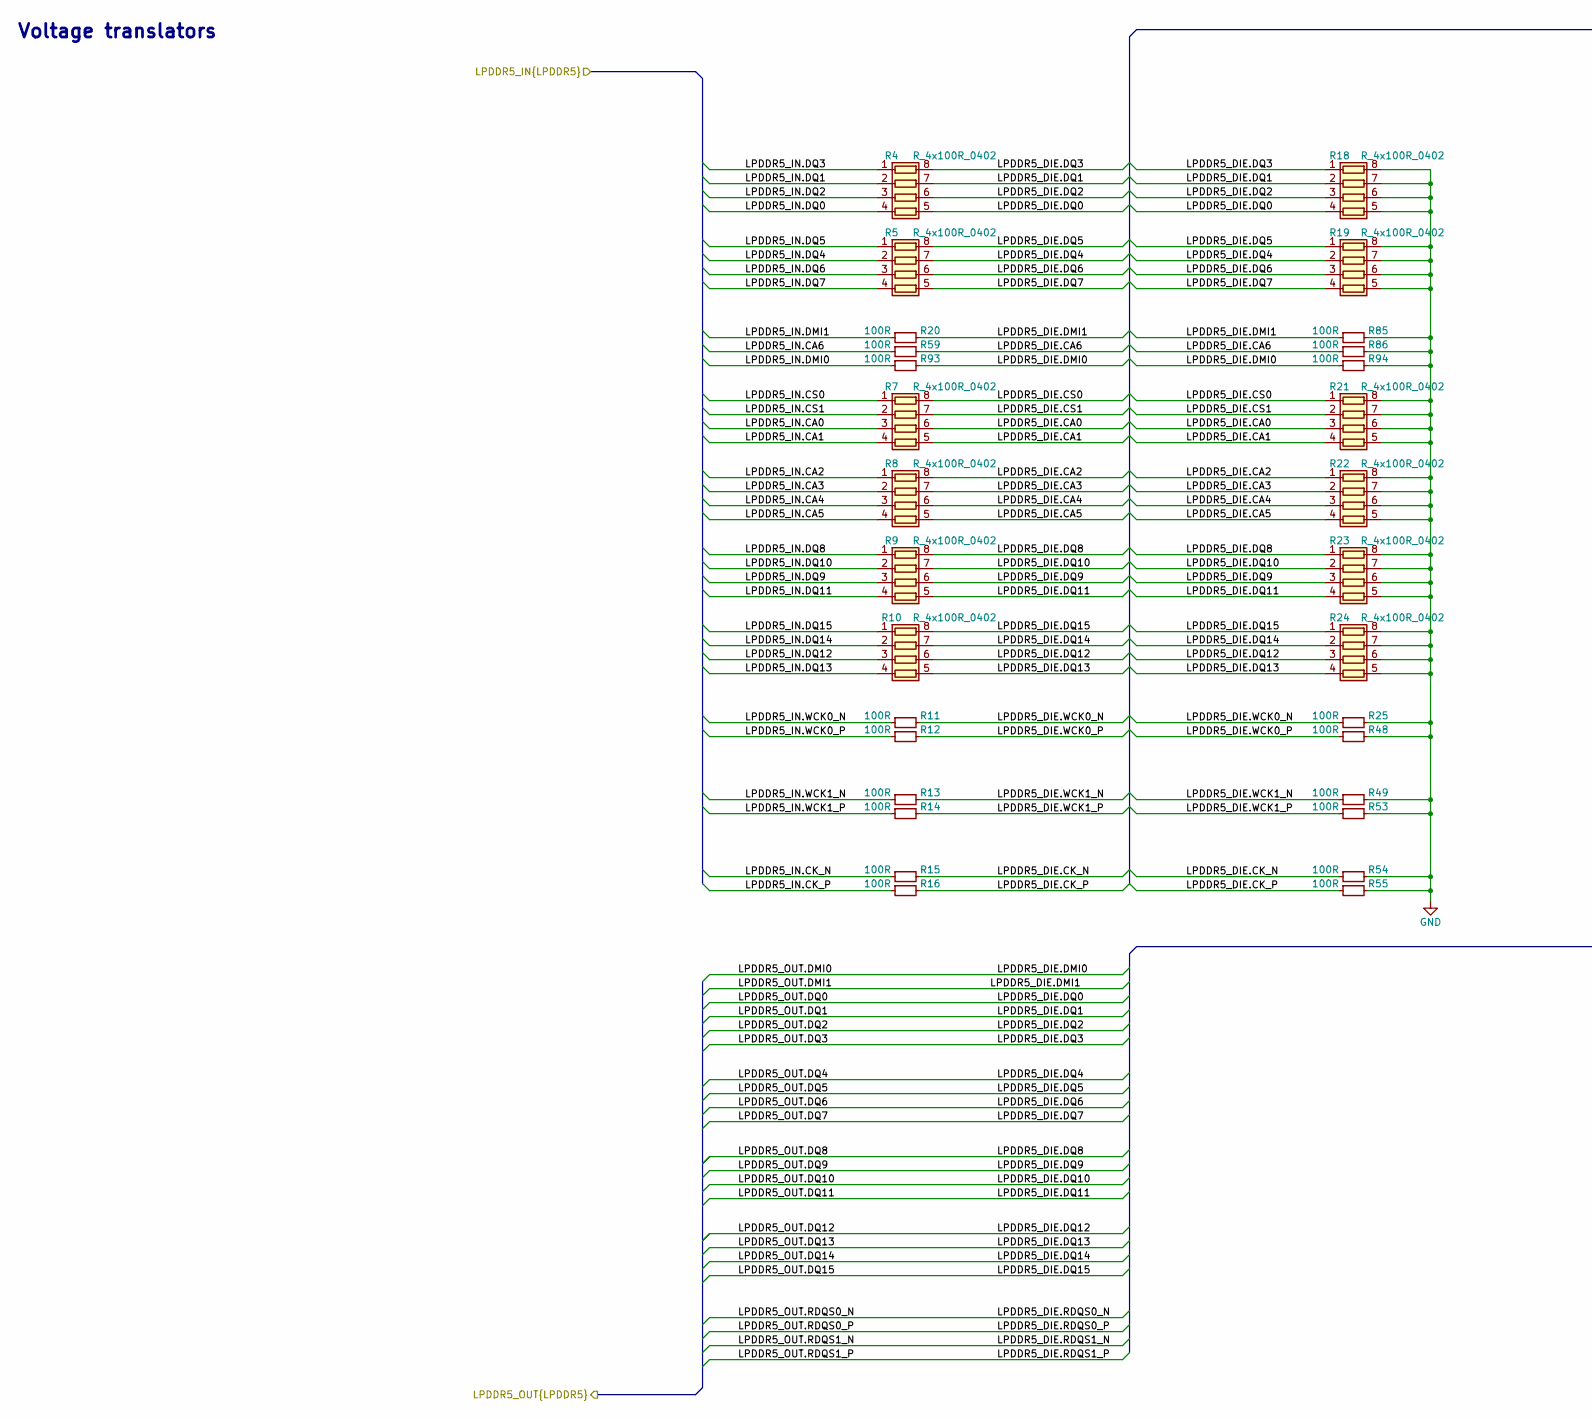
[picture p7: schematic translators.kicad_sch, LPDDR5 Testbed, part in row 1, column 1]

Parts:
R4, R5, R7, R8, R9, R10, R18, R19, R21, R22, R23, R24: R_4x100R_0402_array; R_Array_4x0402_Panasonic_EXB28V; MPN EXB-28V101JX
R11, R12, R13, R14, R15, R16, R20, R25, R48, R49, R53, R54, R55, R59, R85, R86, R93, R94: R_100R_0402; R_0402_1005Metric; Tolerance 1%; MPN CR0402-FX-1000GLF

Connections:
/LPDDR5/LPDDR5_A.CA0: R7.6 (R3.2), R21.3 (R3.1); also elsewhere on the board
/LPDDR5/LPDDR5_A.CA1: R7.5 (R4.2), R21.4 (R4.1); also elsewhere on the board
/LPDDR5/LPDDR5_A.CA2: R8.8 (R1.2), R22.1 (R1.1); also elsewhere on the board
/LPDDR5/LPDDR5_A.CA3: R8.7 (R2.2), R22.2 (R2.1); also elsewhere on the board
/LPDDR5/LPDDR5_A.CA4: R8.6 (R3.2), R22.3 (R3.1); also elsewhere on the board
/LPDDR5/LPDDR5_A.CA5: R8.5 (R4.2), R22.4 (R4.1); also elsewhere on the board
/LPDDR5/LPDDR5_A.CA6: R59.2, R86.1; also elsewhere on the board
/LPDDR5/LPDDR5_A.CK_N: R15.2, R54.1; also elsewhere on the board
/LPDDR5/LPDDR5_A.CK_P: R16.2, R55.1; also elsewhere on the board
/LPDDR5/LPDDR5_A.CS0: R7.8 (R1.2), R21.1 (R1.1); also elsewhere on the board
/LPDDR5/LPDDR5_A.CS1: R7.7 (R2.2), R21.2 (R2.1); also elsewhere on the board
/LPDDR5/LPDDR5_A.DMI0: R93.2, R94.1; also elsewhere on the board
/LPDDR5/LPDDR5_A.DMI1: R20.2, R85.1; also elsewhere on the board
/LPDDR5/LPDDR5_A.DQ0: R4.5 (R4.2), R18.4 (R4.1); also elsewhere on the board
/LPDDR5/LPDDR5_A.DQ1: R4.7 (R2.2), R18.2 (R2.1); also elsewhere on the board
/LPDDR5/LPDDR5_A.DQ2: R4.6 (R3.2), R18.3 (R3.1); also elsewhere on the board
/LPDDR5/LPDDR5_A.DQ3: R4.8 (R1.2), R18.1 (R1.1); also elsewhere on the board
/LPDDR5/LPDDR5_A.DQ4: R5.7 (R2.2), R19.2 (R2.1); also elsewhere on the board
/LPDDR5/LPDDR5_A.DQ5: R5.8 (R1.2), R19.1 (R1.1); also elsewhere on the board
/LPDDR5/LPDDR5_A.DQ6: R5.6 (R3.2), R19.3 (R3.1); also elsewhere on the board
/LPDDR5/LPDDR5_A.DQ7: R5.5 (R4.2), R19.4 (R4.1); also elsewhere on the board
/LPDDR5/LPDDR5_A.DQ8: R9.8 (R1.2), R23.1 (R1.1); also elsewhere on the board
/LPDDR5/LPDDR5_A.DQ9: R9.6 (R3.2), R23.3 (R3.1); also elsewhere on the board
/LPDDR5/LPDDR5_A.DQ10: R9.7 (R2.2), R23.2 (R2.1); also elsewhere on the board
/LPDDR5/LPDDR5_A.DQ11: R9.5 (R4.2), R23.4 (R4.1); also elsewhere on the board
/LPDDR5/LPDDR5_A.DQ12: R10.6 (R3.2), R24.3 (R3.1); also elsewhere on the board
/LPDDR5/LPDDR5_A.DQ13: R10.5 (R4.2), R24.4 (R4.1); also elsewhere on the board
/LPDDR5/LPDDR5_A.DQ14: R10.7 (R2.2), R24.2 (R2.1); also elsewhere on the board
/LPDDR5/LPDDR5_A.DQ15: R10.8 (R1.2), R24.1 (R1.1); also elsewhere on the board
/LPDDR5/LPDDR5_A.WCK0_N: R11.2, R25.1; also elsewhere on the board
/LPDDR5/LPDDR5_A.WCK0_P: R12.2, R48.1; also elsewhere on the board
/LPDDR5/LPDDR5_A.WCK1_N: R13.2, R49.1; also elsewhere on the board
/LPDDR5/LPDDR5_A.WCK1_P: R14.2, R53.1; also elsewhere on the board
/SODIMM/LPDDR5_IN_A.CA0: R7.3 (R3.1); also elsewhere on the board
/SODIMM/LPDDR5_IN_A.CA1: R7.4 (R4.1); also elsewhere on the board
/SODIMM/LPDDR5_IN_A.CA2: R8.1 (R1.1); also elsewhere on the board
/SODIMM/LPDDR5_IN_A.CA3: R8.2 (R2.1); also elsewhere on the board
/SODIMM/LPDDR5_IN_A.CA4: R8.3 (R3.1); also elsewhere on the board
/SODIMM/LPDDR5_IN_A.CA5: R8.4 (R4.1); also elsewhere on the board
/SODIMM/LPDDR5_IN_A.CA6: R59.1; also elsewhere on the board
/SODIMM/LPDDR5_IN_A.CK_N: R15.1; also elsewhere on the board
/SODIMM/LPDDR5_IN_A.CK_P: R16.1; also elsewhere on the board
/SODIMM/LPDDR5_IN_A.CS0: R7.1 (R1.1); also elsewhere on the board
/SODIMM/LPDDR5_IN_A.CS1: R7.2 (R2.1); also elsewhere on the board
/SODIMM/LPDDR5_IN_A.DMI0: R93.1; also elsewhere on the board
/SODIMM/LPDDR5_IN_A.DMI1: R20.1; also elsewhere on the board
/SODIMM/LPDDR5_IN_A.DQ0: R4.4 (R4.1); also elsewhere on the board
/SODIMM/LPDDR5_IN_A.DQ1: R4.2 (R2.1); also elsewhere on the board
/SODIMM/LPDDR5_IN_A.DQ2: R4.3 (R3.1); also elsewhere on the board
/SODIMM/LPDDR5_IN_A.DQ3: R4.1 (R1.1); also elsewhere on the board
/SODIMM/LPDDR5_IN_A.DQ4: R5.2 (R2.1); also elsewhere on the board
/SODIMM/LPDDR5_IN_A.DQ5: R5.1 (R1.1); also elsewhere on the board
/SODIMM/LPDDR5_IN_A.DQ6: R5.3 (R3.1); also elsewhere on the board
/SODIMM/LPDDR5_IN_A.DQ7: R5.4 (R4.1); also elsewhere on the board
/SODIMM/LPDDR5_IN_A.DQ8: R9.1 (R1.1); also elsewhere on the board
/SODIMM/LPDDR5_IN_A.DQ9: R9.3 (R3.1); also elsewhere on the board
/SODIMM/LPDDR5_IN_A.DQ10: R9.2 (R2.1); also elsewhere on the board
/SODIMM/LPDDR5_IN_A.DQ11: R9.4 (R4.1); also elsewhere on the board
/SODIMM/LPDDR5_IN_A.DQ12: R10.3 (R3.1); also elsewhere on the board
/SODIMM/LPDDR5_IN_A.DQ13: R10.4 (R4.1); also elsewhere on the board
/SODIMM/LPDDR5_IN_A.DQ14: R10.2 (R2.1); also elsewhere on the board
/SODIMM/LPDDR5_IN_A.DQ15: R10.1 (R1.1); also elsewhere on the board
/SODIMM/LPDDR5_IN_A.WCK0_N: R11.1; also elsewhere on the board
/SODIMM/LPDDR5_IN_A.WCK0_P: R12.1; also elsewhere on the board
/SODIMM/LPDDR5_IN_A.WCK1_N: R13.1; also elsewhere on the board
/SODIMM/LPDDR5_IN_A.WCK1_P: R14.1; also elsewhere on the board
GND: R18.5 (R4.2), R18.6 (R3.2), R18.7 (R2.2), R18.8 (R1.2), R19.5 (R4.2), R19.6 (R3.2), R19.7 (R2.2), R19.8 (R1.2), R21.5 (R4.2), R21.6 (R3.2), R21.7 (R2.2), R21.8 (R1.2), R22.5 (R4.2), R22.6 (R3.2), R22.7 (R2.2), R22.8 (R1.2), R23.5 (R4.2), R23.6 (R3.2), R23.7 (R2.2), R23.8 (R1.2), R24.5 (R4.2), R24.6 (R3.2), R24.7 (R2.2), R24.8 (R1.2), R25.2, R48.2, R49.2, R53.2, R54.2, R55.2, R85.2, R86.2, R94.2; also elsewhere on the board

Parts of its further copies:
R57, R58, R60, R61, R62, R63, R72, R73, R75, R76, R77, R78: R_4x100R_0402_array; R_Array_4x0402_Panasonic_EXB28V; MPN EXB-28V101JX
R64, R65, R66, R67, R68, R70, R79, R80, R81, R82, R83, R84, R88, R89, R91, R92, R95, R96: R_100R_0402; R_0402_1005Metric; Tolerance 1%; MPN CR0402-FX-1000GLF

Connections of its further copies:
/LPDDR5/LPDDR5_B.CA0: R60.6 (R3.2), R75.3 (R3.1); also elsewhere on the board
/LPDDR5/LPDDR5_B.CA1: R60.5 (R4.2), R75.4 (R4.1); also elsewhere on the board
/LPDDR5/LPDDR5_B.CA2: R61.8 (R1.2), R76.1 (R1.1); also elsewhere on the board
/LPDDR5/LPDDR5_B.CA3: R61.7 (R2.2), R76.2 (R2.1); also elsewhere on the board
/LPDDR5/LPDDR5_B.CA4: R61.6 (R3.2), R76.3 (R3.1); also elsewhere on the board
/LPDDR5/LPDDR5_B.CA5: R61.5 (R4.2), R76.4 (R4.1); also elsewhere on the board
/LPDDR5/LPDDR5_B.CA6: R89.2, R92.1; also elsewhere on the board
/LPDDR5/LPDDR5_B.CK_N: R68.2, R83.1; also elsewhere on the board
/LPDDR5/LPDDR5_B.CK_P: R70.2, R84.1; also elsewhere on the board
/LPDDR5/LPDDR5_B.CS0: R60.8 (R1.2), R75.1 (R1.1); also elsewhere on the board
/LPDDR5/LPDDR5_B.CS1: R60.7 (R2.2), R75.2 (R2.1); also elsewhere on the board
/LPDDR5/LPDDR5_B.DMI0: R95.2, R96.1; also elsewhere on the board
/LPDDR5/LPDDR5_B.DMI1: R88.2, R91.1; also elsewhere on the board
/LPDDR5/LPDDR5_B.DQ0: R57.5 (R4.2), R72.4 (R4.1); also elsewhere on the board
/LPDDR5/LPDDR5_B.DQ1: R57.7 (R2.2), R72.2 (R2.1); also elsewhere on the board
/LPDDR5/LPDDR5_B.DQ2: R57.6 (R3.2), R72.3 (R3.1); also elsewhere on the board
/LPDDR5/LPDDR5_B.DQ3: R57.8 (R1.2), R72.1 (R1.1); also elsewhere on the board
/LPDDR5/LPDDR5_B.DQ4: R58.7 (R2.2), R73.2 (R2.1); also elsewhere on the board
/LPDDR5/LPDDR5_B.DQ5: R58.8 (R1.2), R73.1 (R1.1); also elsewhere on the board
/LPDDR5/LPDDR5_B.DQ6: R58.6 (R3.2), R73.3 (R3.1); also elsewhere on the board
/LPDDR5/LPDDR5_B.DQ7: R58.5 (R4.2), R73.4 (R4.1); also elsewhere on the board
/LPDDR5/LPDDR5_B.DQ8: R62.8 (R1.2), R77.1 (R1.1); also elsewhere on the board
/LPDDR5/LPDDR5_B.DQ9: R62.6 (R3.2), R77.3 (R3.1); also elsewhere on the board
/LPDDR5/LPDDR5_B.DQ10: R62.7 (R2.2), R77.2 (R2.1); also elsewhere on the board
/LPDDR5/LPDDR5_B.DQ11: R62.5 (R4.2), R77.4 (R4.1); also elsewhere on the board
/LPDDR5/LPDDR5_B.DQ12: R63.6 (R3.2), R78.3 (R3.1); also elsewhere on the board
/LPDDR5/LPDDR5_B.DQ13: R63.5 (R4.2), R78.4 (R4.1); also elsewhere on the board
/LPDDR5/LPDDR5_B.DQ14: R63.7 (R2.2), R78.2 (R2.1); also elsewhere on the board
/LPDDR5/LPDDR5_B.DQ15: R63.8 (R1.2), R78.1 (R1.1); also elsewhere on the board
/LPDDR5/LPDDR5_B.WCK0_N: R64.2, R79.1; also elsewhere on the board
/LPDDR5/LPDDR5_B.WCK0_P: R65.2, R80.1; also elsewhere on the board
/LPDDR5/LPDDR5_B.WCK1_N: R66.2, R81.1; also elsewhere on the board
/LPDDR5/LPDDR5_B.WCK1_P: R67.2, R82.1; also elsewhere on the board
/SODIMM/LPDDR5_IN_B.CA0: R60.3 (R3.1); also elsewhere on the board
/SODIMM/LPDDR5_IN_B.CA1: R60.4 (R4.1); also elsewhere on the board
/SODIMM/LPDDR5_IN_B.CA2: R61.1 (R1.1); also elsewhere on the board
/SODIMM/LPDDR5_IN_B.CA3: R61.2 (R2.1); also elsewhere on the board
/SODIMM/LPDDR5_IN_B.CA4: R61.3 (R3.1); also elsewhere on the board
/SODIMM/LPDDR5_IN_B.CA5: R61.4 (R4.1); also elsewhere on the board
/SODIMM/LPDDR5_IN_B.CA6: R89.1; also elsewhere on the board
/SODIMM/LPDDR5_IN_B.CK_N: R68.1; also elsewhere on the board
/SODIMM/LPDDR5_IN_B.CK_P: R70.1; also elsewhere on the board
/SODIMM/LPDDR5_IN_B.CS0: R60.1 (R1.1); also elsewhere on the board
/SODIMM/LPDDR5_IN_B.CS1: R60.2 (R2.1); also elsewhere on the board
/SODIMM/LPDDR5_IN_B.DMI0: R95.1; also elsewhere on the board
/SODIMM/LPDDR5_IN_B.DMI1: R88.1; also elsewhere on the board
/SODIMM/LPDDR5_IN_B.DQ0: R57.4 (R4.1); also elsewhere on the board
/SODIMM/LPDDR5_IN_B.DQ1: R57.2 (R2.1); also elsewhere on the board
/SODIMM/LPDDR5_IN_B.DQ2: R57.3 (R3.1); also elsewhere on the board
/SODIMM/LPDDR5_IN_B.DQ3: R57.1 (R1.1); also elsewhere on the board
/SODIMM/LPDDR5_IN_B.DQ4: R58.2 (R2.1); also elsewhere on the board
/SODIMM/LPDDR5_IN_B.DQ5: R58.1 (R1.1); also elsewhere on the board
/SODIMM/LPDDR5_IN_B.DQ6: R58.3 (R3.1); also elsewhere on the board
/SODIMM/LPDDR5_IN_B.DQ7: R58.4 (R4.1); also elsewhere on the board
/SODIMM/LPDDR5_IN_B.DQ8: R62.1 (R1.1); also elsewhere on the board
/SODIMM/LPDDR5_IN_B.DQ9: R62.3 (R3.1); also elsewhere on the board
/SODIMM/LPDDR5_IN_B.DQ10: R62.2 (R2.1); also elsewhere on the board
/SODIMM/LPDDR5_IN_B.DQ11: R62.4 (R4.1); also elsewhere on the board
/SODIMM/LPDDR5_IN_B.DQ12: R63.3 (R3.1); also elsewhere on the board
/SODIMM/LPDDR5_IN_B.DQ13: R63.4 (R4.1); also elsewhere on the board
/SODIMM/LPDDR5_IN_B.DQ14: R63.2 (R2.1); also elsewhere on the board
/SODIMM/LPDDR5_IN_B.DQ15: R63.1 (R1.1); also elsewhere on the board
/SODIMM/LPDDR5_IN_B.WCK0_N: R64.1; also elsewhere on the board
/SODIMM/LPDDR5_IN_B.WCK0_P: R65.1; also elsewhere on the board
/SODIMM/LPDDR5_IN_B.WCK1_N: R66.1; also elsewhere on the board
/SODIMM/LPDDR5_IN_B.WCK1_P: R67.1; also elsewhere on the board
GND: R72.5 (R4.2), R72.6 (R3.2), R72.7 (R2.2), R72.8 (R1.2), R73.5 (R4.2), R73.6 (R3.2), R73.7 (R2.2), R73.8 (R1.2), R75.5 (R4.2), R75.6 (R3.2), R75.7 (R2.2), R75.8 (R1.2), R76.5 (R4.2), R76.6 (R3.2), R76.7 (R2.2), R76.8 (R1.2), R77.5 (R4.2), R77.6 (R3.2), R77.7 (R2.2), R77.8 (R1.2), R78.5 (R4.2), R78.6 (R3.2), R78.7 (R2.2), R78.8 (R1.2), R79.2, R80.2, R81.2, R82.2, R83.2, R84.2, R91.2, R92.2, R96.2; also elsewhere on the board

Notes on the sheet:
Voltage translators

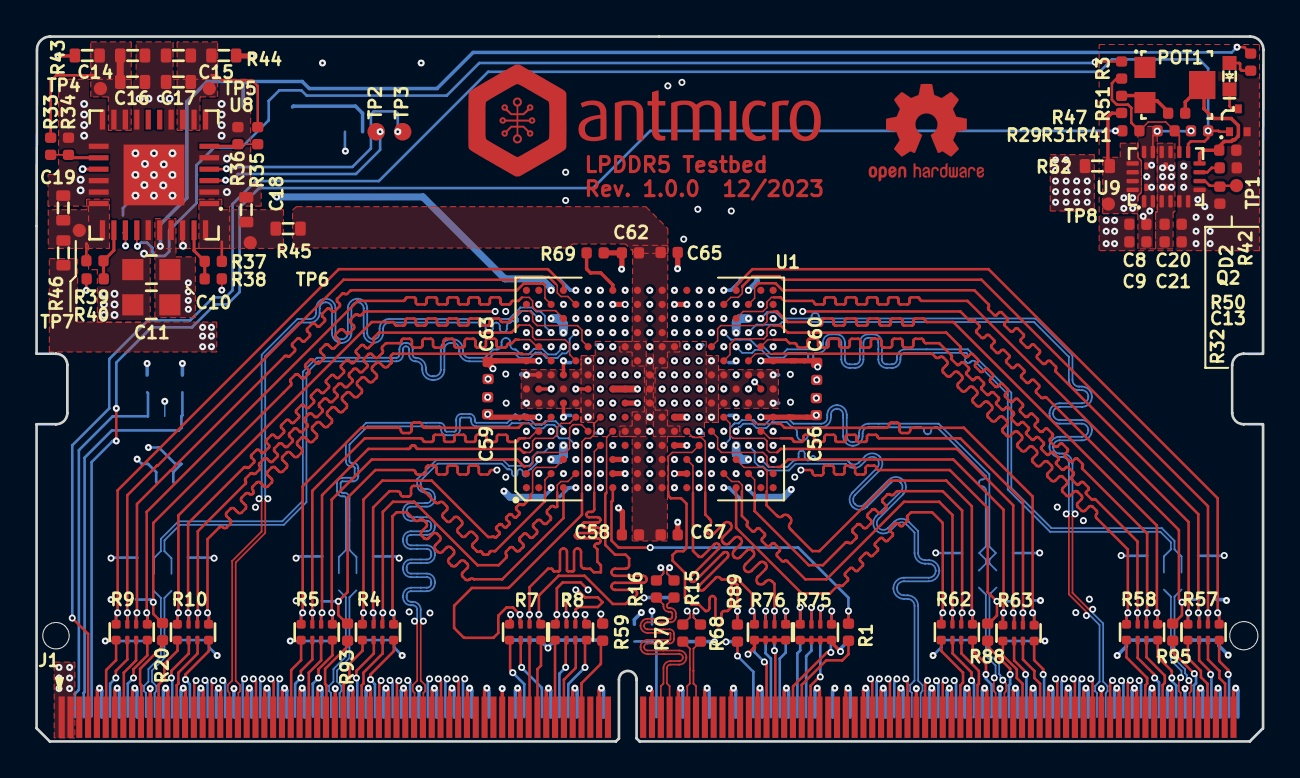
[picture p8: board lpddr5-testbed.kicad_pcb from above]

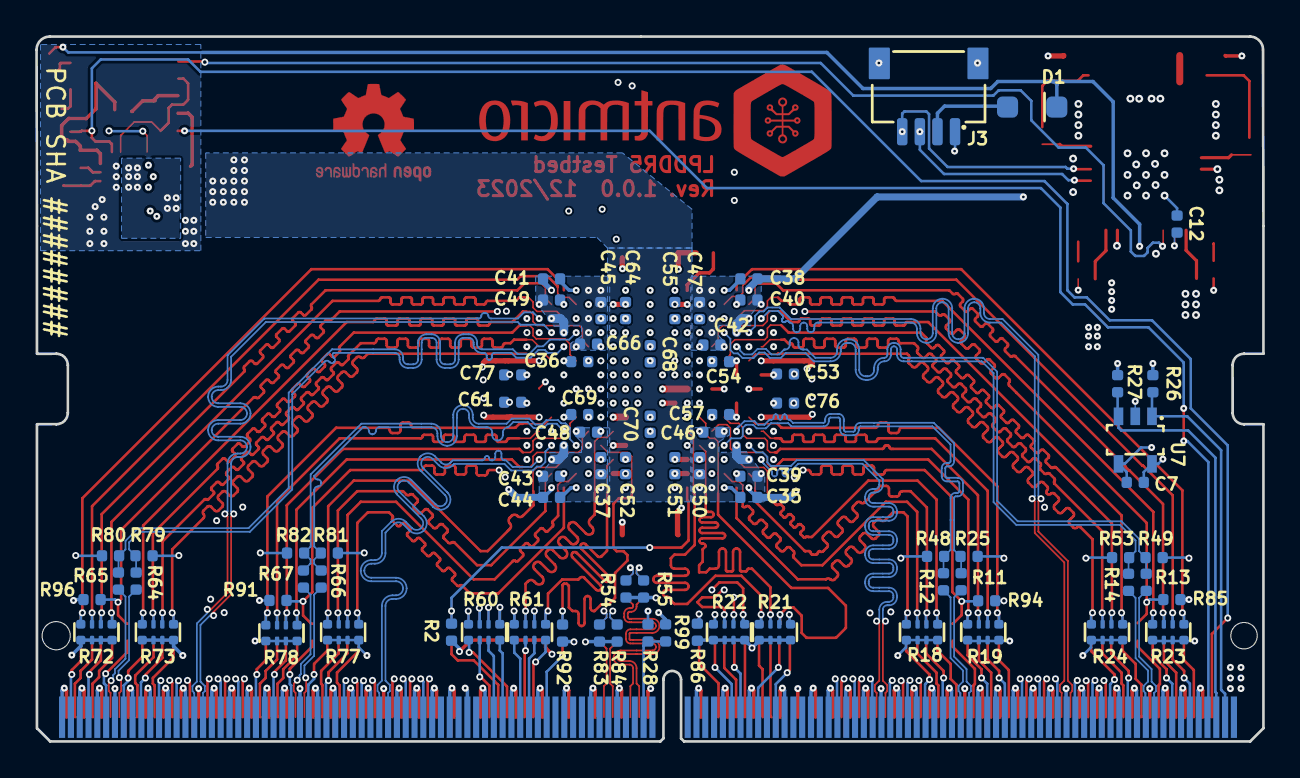
[picture p9: board lpddr5-testbed.kicad_pcb from below]

Board: 6 copper layers, 69.6 x 40.0 mm, 160 parts (78 on the bottom side), 176 nets.
