joyhpc/misc-tasks/(commit log)

2026-05-11 Initial misc tasks archive
    [A5ED065B.xlsx, a5ed052A.xlsx, a5ed052a_b32a_min_system_pin_assign_draft_v1.xlsx, a5ed052a_b32a_min_system_pin_assign_draft_v2.xlsx, fpga pin assign.xlsx, fpga_pin_assign_filled_hsio2b_3a_lpddr5.xlsx, fpga_pin_assign_orcad_format_hsio2b_3a_lpddr5.xlsx, keim-a5esom_bom_rev1.00.xlsx]
2026-05-11 Add LPDDR5 reference materials
    [lpddr5-testbed.kicad_pcb, lpddr5-testbed.kicad_sch, lpddr5.kicad_sch, pin_characteristics_summary.xlsx, power_supply.kicad_sch, sodim.kicad_sch, translators.kicad_sch]
2026-05-11 Add OrCAD LPDDR5 ECAD sources
    [lpddr5_315_tfbga_symbol_pinlist_for_orcad.csv]
2026-05-12 docs: add DDR memory supplier inquiry table
    [ddr_memory_supplier_inquiry_table.tsv]
2026-05-12 docs: add DDR memory supplier inquiry workbook
    [ddr_memory_supplier_inquiry_template.xlsx]
2026-05-12 docs: add supplier-facing DDR inquiry workbook
    [ddr_memory_supplier_inquiry_supplier.xlsx]
